PippoGot/FGVCO/Elaborato Scritto/main.tex

\documentclass[twoside, 12pt]{report}

% --- PACCHETTI ---

% unità di misura e matematica
\usepackage{siunitx, amsmath}

% titolo capitoli e sezioni personalizzato
\usepackage{titlesec}

\titleformat{\chapter}
{\normalfont\LARGE\bfseries}{\thechapter.}{10pt}{\LARGE}
\titlespacing*{\chapter}{0pt}{0pt}{20pt}

\titleformat{\section}
{\normalfont\large\bfseries}{\thesection}{10pt}{\large}
\titlespacing*{\section}{0pt}{0pt}{10pt}

% include pdfs
\usepackage{pdfpages}

% grafiche e tabelle
\usepackage{graphicx, calc}

\graphicspath{{images/}}

\usepackage{tikz, pgfplots, pgfplotstable}

\pgfplotsset{compat = newest}
\usepgfplotslibrary{units}

\usepackage{array, csvsimple}

\newcolumntype{C}{>{\centering}m{1.8cm}}
\newcolumntype{L}{>{\centering\arraybackslash}m{1.8cm}}
\newcolumntype{I}{>{\centering}m{2.5cm}}
\newcolumntype{U}{>{\centering\arraybackslash}m{2.5cm}}

\usepackage{float}

% colori personalizzati
\usepackage{colortbl, xcolor}

% normali
\definecolor{myBlue}{RGB}{1, 187, 235}
\definecolor{myRed}{RGB}{255, 43, 43}
\definecolor{myYellow}{RGB}{255, 221, 86}
\definecolor{myBlack}{RGB}{28, 28, 28}
\definecolor{myGrey}{RGB}{134, 134, 134}
% chiari
\definecolor{myLightBlue}{RGB}{177, 239, 255}
\definecolor{myLightRed}{RGB}{255, 177, 177}
\definecolor{myLightYellow}{RGB}{255, 240, 180}
\definecolor{myLightGrey}{RGB}{218, 218, 218}

\pgfplotscreateplotcyclelist{modular}{
        {myBlue},
        {myRed},
        {myBlack},
        {myGrey},
        {myYellow},
      }

\usepackage{subcaption, caption}

% numerazione capitoli in italiano
\usepackage[italian]{babel}

% spaziatura
\usepackage{parskip}

% impaginazione
\usepackage{setspace} % For doublespacing

\doublespacing

\usepackage{geometry}

\geometry{a4paper, top = 2cm, bottom = 2cm, outer = 2cm, inner = 3cm, heightrounded}

% font
\usepackage{times}

% bibliografia
\usepackage{csquotes, biblatex}
\addbibresource{bibliography.bib}

\usepackage{xurl, url} % evita che la bibliografia esca dal margine

\urlstyle{same}
\appto{\bibsetup}{\raggedright}

% salta pagine bianche
\usepackage{afterpage}

\newcommand\emptypage{
    \newpage
    \thispagestyle{empty}
    \mbox{}
    \newpage
}

% interlinea
\linespread{1.5}

% comandi per aggiungere chapter, section e subsection non numerate al toc
\newcommand\unchapter[1]{
    \chapter*{#1}
    \addcontentsline{toc}{chapter}{#1}}

\newcommand\unsection[1]{
    \section*{#1}
    \addcontentsline{toc}{section}{#1}}

\newcommand\unsubsection[1]{
        \subsection*{#1}
        \addcontentsline{toc}{subsection}{#1}}

% --- DOCUMENTO PRINCIPALE ---

% inizio del documento
\begin{document}

% --- FRONTESPIZIO ---
% DA MODIFICARE DATA DI LAUREA !!!
\includepdf{pdfs/frontespizio/frontespizio_tesi.pdf}
\emptypage

% --- INDICE ---

\tableofcontents
\emptypage

% --- CAPITOLI ---

\include{chapters/ch00-introduzione.tex}
\include{chapters/ch01-segnali_principali.tex}
\include{chapters/ch02-vfc.tex}
\include{chapters/ch03-interfaccia_ingresso.tex}
\include{chapters/ch04-selezione_modalità.tex}
\include{chapters/ch05-segnali_secondari.tex}
\include{chapters/ch06-interfaccia_uscita.tex}
%\include{chapters/ch07-protezione_circuito.tex}
\include{chapters/ch08-conclusioni.tex}

% appendice schemi elettrici
\include{chapters/appendix.tex}

% bibliografia
\printbibliography
\addcontentsline{toc}{chapter}{Bibliografia}

% fine del documento
\end{document}
