PippoGot/FGVCO/Elaborato Scritto/chapters/appendix.tex

% schemi elettrici
\appendix
\chapter{Schemi Elettrici delle Schede}\label{circuit_diagrams}

Si riportano gli schemi elettrici disegnati su CAD per il progetto delle schede stampate.

\includepdf[
    width = \textwidth,
    pagecommand = {\thispagestyle{plain}},
    pages = -,
    nup = 1x2,
    offset = 5mm 0mm
]{
    pdfs/schematics/FG-VCO-(complete).pdf
}
