PippoGot/FGVCO/Elaborato Scritto/chapters/ch07-efuse.tex

\chapter{Protezione del Circuito}

\lipsum[2-4]
