PippoGot/FGVCO/Elaborato Scritto/main.pdf

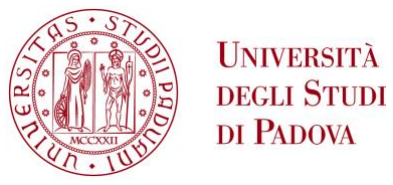
[picture p28: figure]

## UNIVERSITÀ DEGLI STUDI DI PADOVA

DIPARTIMENTO DI INGEGNERIA DELL’INFORMAZIONE CORSO DI LAUREA IN INGEGNERIA ELETTRONICA

## PROGETTO DI UN SINTETIZZATORE MUSICALE CONTROLLATO IN TENSIONE

### Relatore: Prof. Matteo Meneghini

### Laureando: Filippo Gottardo Matricola: 1220991

ANNO ACCADEMICO 2021/2022 | 21 Settembre 2022

DIPARTIMENTO
DI INGEGNERIA
DELL’INFORMAZIONE

# Indice

Introduzione e Specifiche di Progetto | 5
1 Generazione dei Segnali Principali | 8
2 Convertitore Tensione-Frequenza | 16
3 Condizionamento dell’Ingresso | 21
3.2 Somma di piu Ingressi | ` | 28
4 Modalita di Funzionamento | 32 `
5 Generazione dei Segnali Secondari | 33
6 Stadi di Uscita | 38
Considerazioni Finali e Conclusioni | 42
A Schemi Elettrici delle Schede | 43
Bibliografia | 62

# Introduzione e Specifiche di Progetto

In questa tesi viene discussa la progettazione di un sintetizzatore musicale compatibile con lo

standard modulare piu diffuso al giorno d’oggi, ovvero Eurorack [1]. Pi ` | u precisamente si vuole `

realizzare un generatore di segnali che offra la possibilita di essere controllato in tensione (Vol- `

tage Controlled Oscillator, o VCO in breve). In questo modo, applicando dei segnali variabili

nel tempo in ingresso al modulo, si e in grado di variare dinamicamente la frequenza dei segnali `

in uscita.

Il range scelto per tale variazione comprende la fascia di frequenze dello spettro audio, quindi

da poche decine di Hz a circa 7 kHz. Si desidera inoltre la possibilita di convertire a piacere il `

funzionamento del modulo in oscillatore a bassa frequenza (Low Frequency Oscillator, o LFO),

spostando quindi il range di frequenze disponibili da frazioni di Hz a qualche decina di Hz.

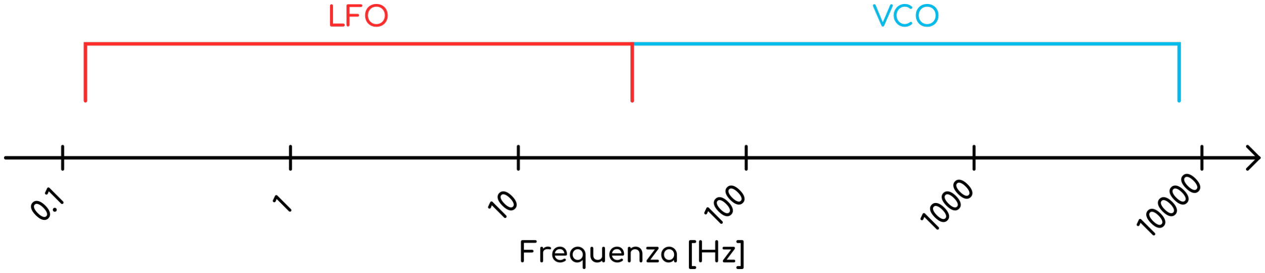
[picture p29: figure]

Figura 1: Range di funzionamento approssimato, in scala logaritmica

In modalita VCO quindi, il modulo produrr ` | a dei segnali che attraverso un adeguato sistema po- `
tranno riprodurre un suono, mentre in modalita LFO il circuito produrr ` | a dei segnali lentamente `

variabili nel tempo, utili per la modulazione e il controllo di diversi parametri in altri moduli

eventualmente presenti nel sistema.

Le forme d’onda desiderate sono quelle base, ovvero:

- Sinusoide;
- Onda Quadra;
- Triangolo;
- Rampa;

- Dente di sega (sebbene nel range VCO non risulti particolarmente differente dalla rampa

in termini di suono, per quanto riguarda il funzionamento LFO la differenza e radicale, `

poiche il segnale viene solitamente utilizzato come modulante); `

inoltre, come verra illustrato pi ` | u avanti, risulta piuttosto semplice anche estrarre un segnale a `

impulso, ancora una volta utile per il controllo di altri moduli o parametri.

Per quanto riguarda le specifiche sui livelli di tensione, si vogliono imporre i seguenti intervalli

di valori:

- Segnali audio (le 5 forme d’onda elencate poco sopra): ±5 V ;
- Segnali logici (impulso): (0 V ÷ +5 V );
- Segnali di controllo (ingresso): (0 V ÷ +8 V ) in modalita` 1 V/Octave, ovvero facendo

in modo che ad un incremento di 1 V in ingresso corrisponda un raddoppio di frequenza

in uscita, cioe un’ottava; `

- Alimentazioni: ±12 V e +5 V ;

come suggerito dallo standard scelto.

Si desidera inoltre aggiungere delle manopole per il controllo del ”volume” dei segnali in in-

gresso e uscita (ad eccezione dell’impulso), e delle manopole per il controllo manuale della

frequenza.

Mettendo assieme tutti questi dettagli possiamo dunque abbozzare una interfaccia utente (ripor-

tata in figura 2), in modo da rendere piu chiaro al lettore il risultato finale voluto. `

Si decide di realizzare l’intero circuito senza l’utilizzo di microcontrollori o sistemi program-

mabili, scelta che viene presa per mettere alla prova il maggior numero di competenze tra quelle

acquisite durante gli anni di studio. Una soluzione piu rapida e semplice consisterebbe infatti `

nell’impiegare un microcontrollore con dei campioni digitali molto densi delle forme d’onda

desiderate.

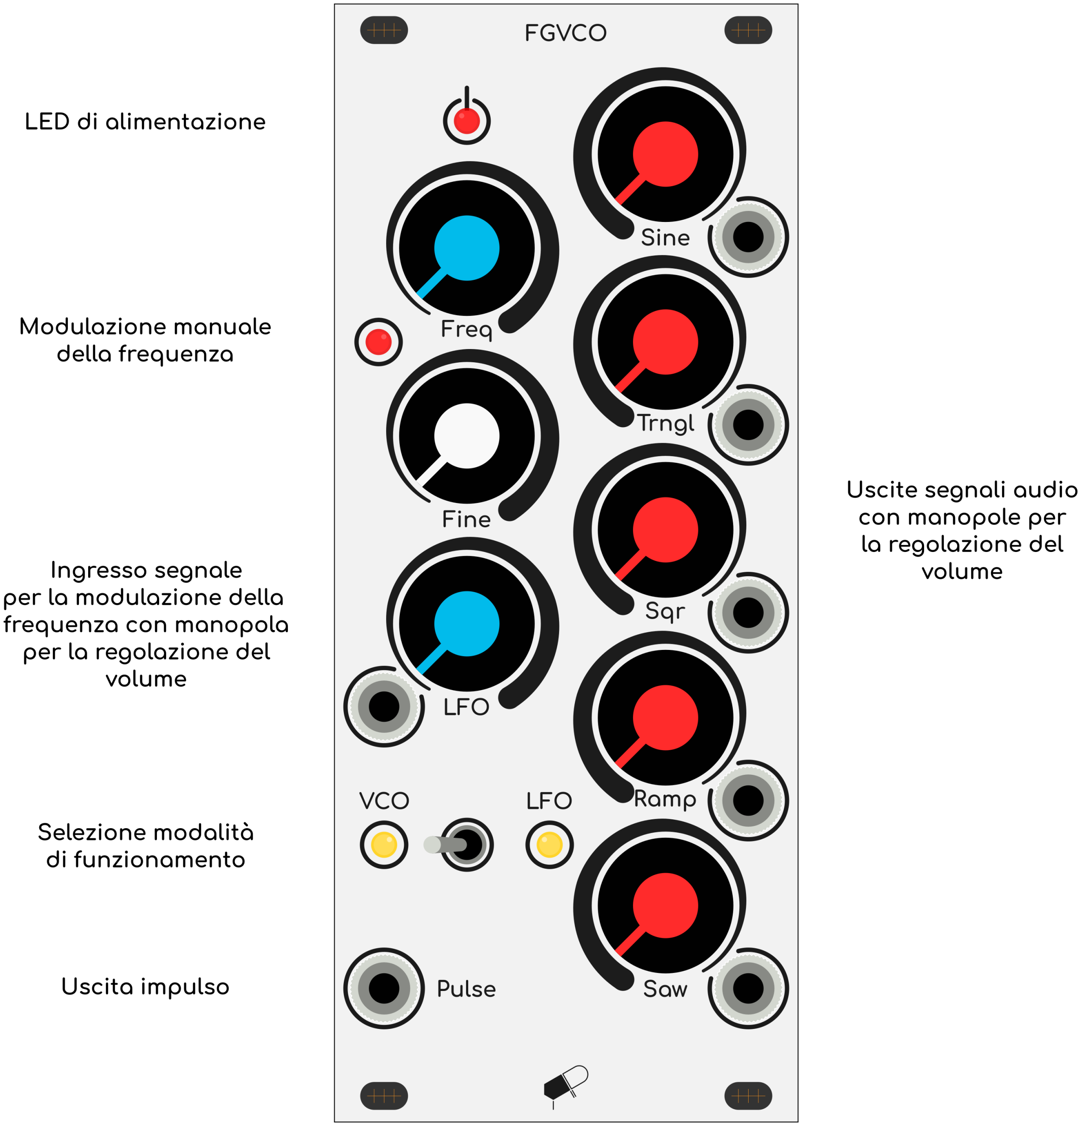
[picture p30: figure]

Figura 2: Pannello frontale del modulo

# 1. Generazione dei Segnali Principali

Per la generazione dei segnali a rampa e a triangolo si decide di procedere in ogni caso per via

digitale, utilizzando dei contatori binari abbinati ad un convertitore digitale-analogico.

### 1.1 Rampa

### Principio di Funzionamento

Per il segnale a rampa si fa uso di un contatore unidirezionale, ovvero un dispositivo in grado di

contare automaticamente da 0 a 2

n
(con n numero di bit) semplicemente fornendo un segnale

di clock adeguatamente dimensionato. Maggiore il numero di bit, maggiore la precisione del

nostro segnale, quindi minore l’intensita del rumore generato. `

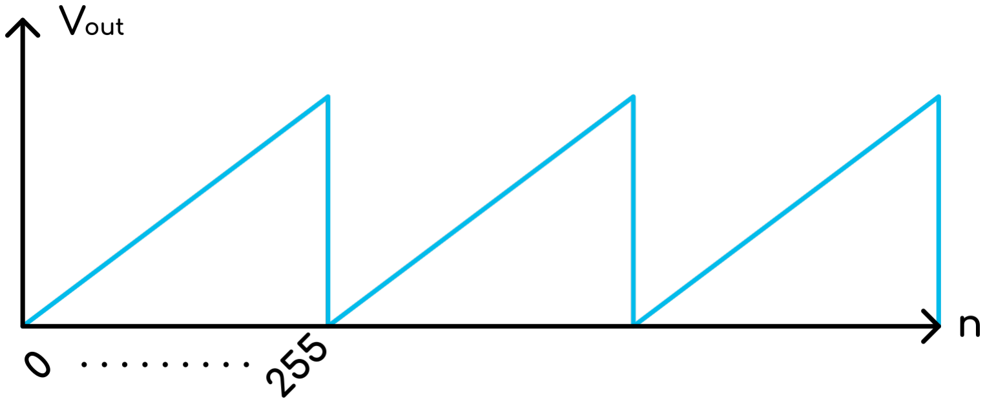
[picture p31: figure]

(a) Rampa ottenuta con un contatore a 2 bit | (b) Rampa ottenuta con un contatore a 8 bit

Figura 1.1: Confronto tra contatori unidirezionali con diverso numero di bit

Tuttavia aumentando il numero di bit del contatore e facile intuire che, a parit ` | a di frequenza `

del segnale in uscita, la frequenza del segnale di clock debba necessariamente aumentare, vale

infatti la seguente relazione:

fsignal =

fclk
2

n

[Hz] | (1.1)

poiche il contatore deve effettuare un conteggio completo durante un periodo del segnale in `

uscita. Questo implica dunque un limite massimo al numero di bit del contatore.

Il numero di bit utilizzati per la nostra applicazione e pari a ` | 8, valore che ci consente di limitare

al MHz la frequenza di clock, contare fino a 255 e dividere l’intervallo di tensione d’uscita in

altrettanti livelli, ottenendo quindi una variazione di

Vstep =

2 · Vref
2

n

=

10
256
≈ 39 mV | (1.2)

per ogni singolo bit (scegliendo Vref = +5 V ).

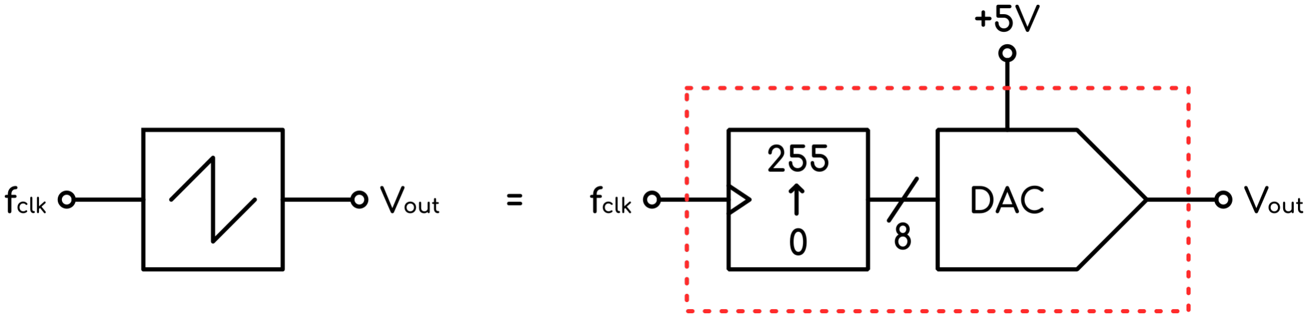
[picture p32: figure]

Figura 1.2: Schema a blocchi del sottosistema per la generazione della rampa

A questo punto possiamo calcolare le specifiche del segnale di clock da generare, andando a

vedere quali sono le frequenze desiderate per i segnali audio:

- Valore minimo (nota A0): fsignal−min = 27.5 Hz → fclk−min ≈ 7 kHz a cui corrispon-
dera un ingresso di ` | 0 V ;
- Valore massimo (nota A8): fsignal−max ≈ 7 kHz → fclk−max ≈ 1.8 MHz a cui
corrispondera un ingresso di ` | +8 V ;

quindi un range di funzionamento esteso lungo 8 ottave.

### Componenti Utilizzati e Schemi Elettrici

I componenti utilizzati per la realizzazione del circuito sono un 74HC590 [2], contatore binario

a 8 bit, e un DAC0800 [3], convertitore digitale-analogico sempre a 8 bit.

Per il circuito DAC si utilizza lo schema a pg.10 del relativo datasheet del componente. Tale

configurazione ci permette di convertire il dato binario in un valore compreso nell’intervallo

±Vref , tuttavia si utilizzano un amplificatore operazionale e dei resistori di valore differente

(rispettivamente TL074 [6] e RL = R¯
L = 3.3 kΩ) per questioni di disponibilita. Si noti che `

anche Vref viene scelta diversa rispetto allo schema nel datasheet (ovvero +5 V ), in modo da

garantire le specifiche di progetto sul segnale in uscita.

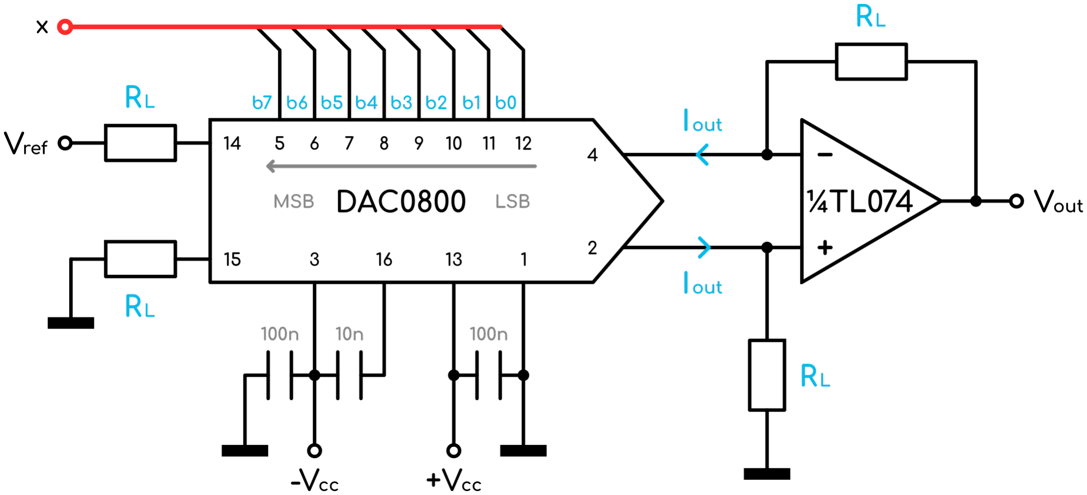
[picture p33: figure]

Figura 1.3: Schema elettrico del DAC (±Vcc = ±12 V )

Il DAC eroga una corrente Iout proporzionale all’ingresso digitale x, che viene poi convertita in

una tensione con un operazionale. Le due grandezze sono legate dalla relazione:

Vout = Vref
2x − 255

256

= 5
2x − 255
256 |
[V ] | (1.3)

Il contatore invece viene collegato nel seguente modo:

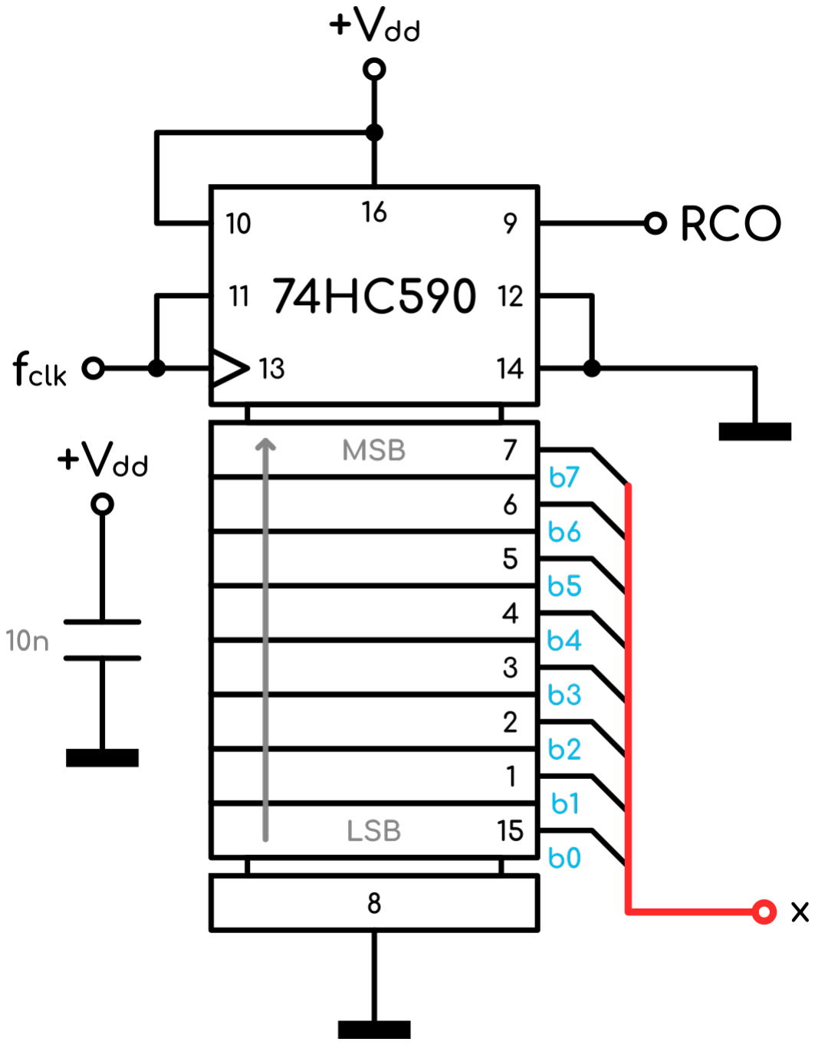
[picture p34: figure]

Figura 1.4: Schema elettrico del contatore per l’onda a rampa (+Vdd = +5 V )

Si noti l’uscita RCO in figura 1.4 dalla quale viene prelevato il segnale per la generazione

dell’impulso, che verra discusso pi ` | u in dettaglio nel capitolo 5. `

Infine, collegando i due blocchi insieme, l’andamento di Vout sara simile a quello rappresentato `

in figura 1.1b, e ad ogni impulso di clock corrispondera un gradino di tensione di circa ` | 40 mV

come calcolato con la formula 1.2.

### Risultati Pratici

Verifichiamo quindi la correttezza del circuito realizzato.

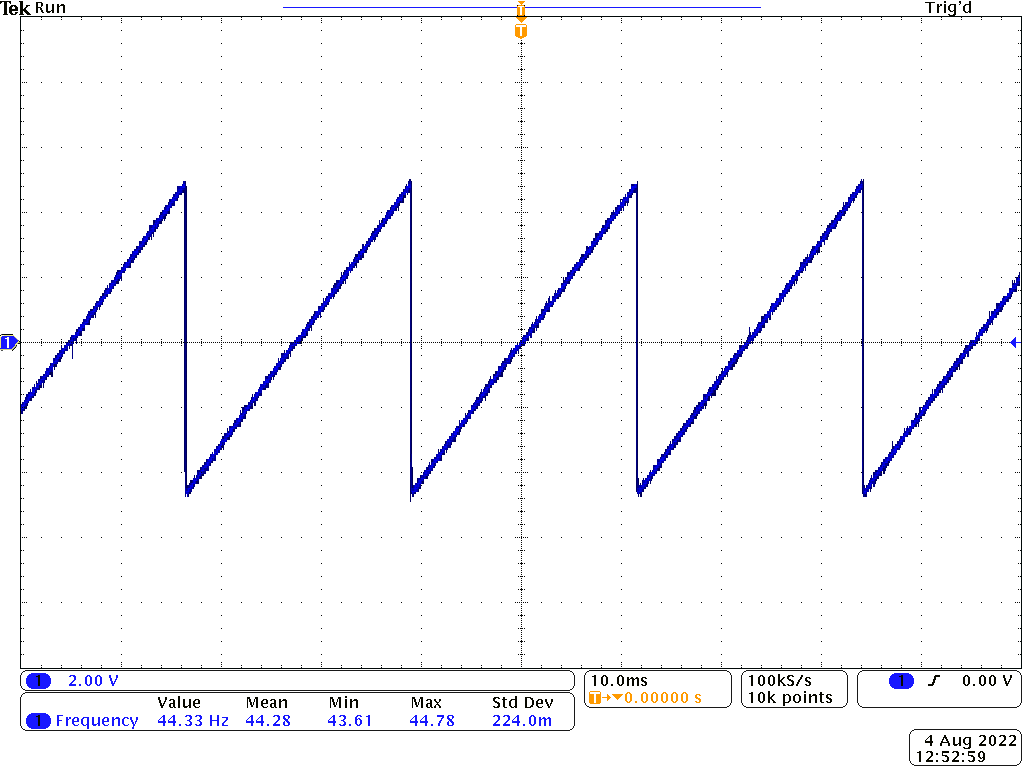
[picture p35: figure]
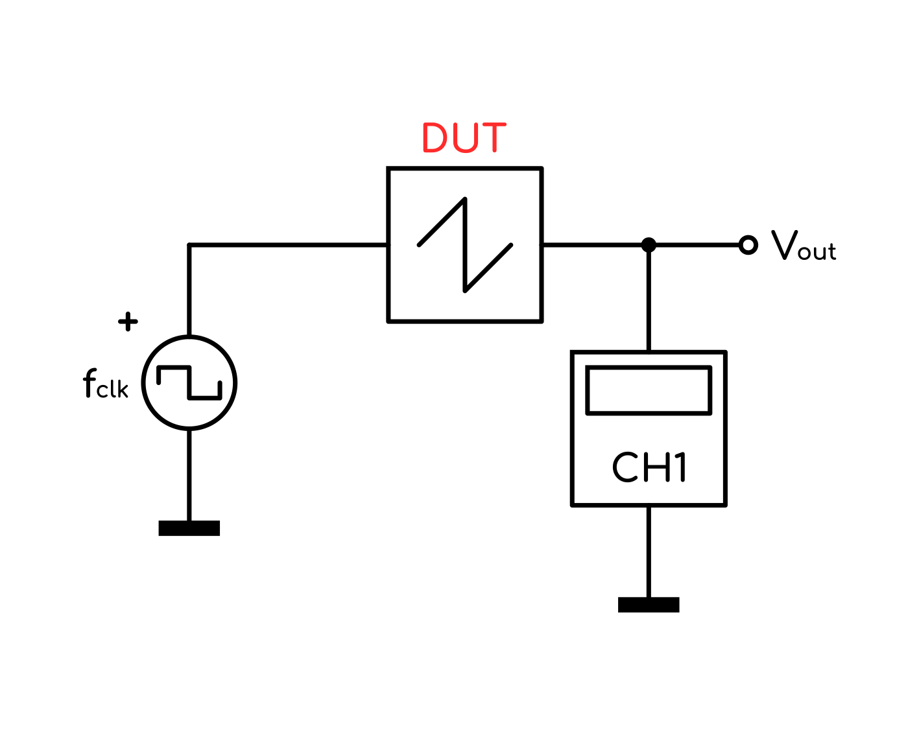
[picture p36: figure]

(a) Setup di misura | (b) Acquisizione del segnale ottenuto

Figura 1.5: Funzionamento del circuito per il segnale a rampa

Si apprezza come l’onda generata abbia esattamente la forma voluta, come descritto nel princi-

pio di funzionamento.

### 1.2 Triangolo

### Principio di Funzionamento

Il ragionamento e del tutto analogo a quello del contatore per la rampa, tuttavia in questo caso il `

contatore utilizzato e bidirezionale (quindi in grado di contare da ` | 0 a 2

n
e viceversa) e necessita

di un segnale che determini la direzione di conteggio (Up o Down).

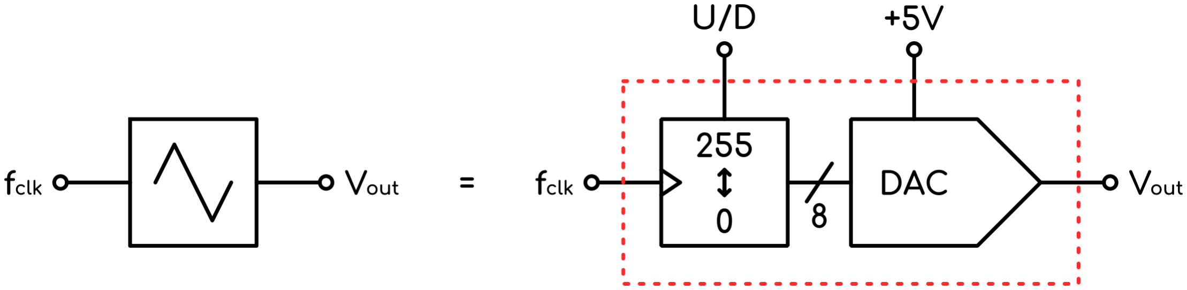
[picture p37: figure]

Figura 1.6: Schema a blocchi del sottosistema per la generazione del triangolo

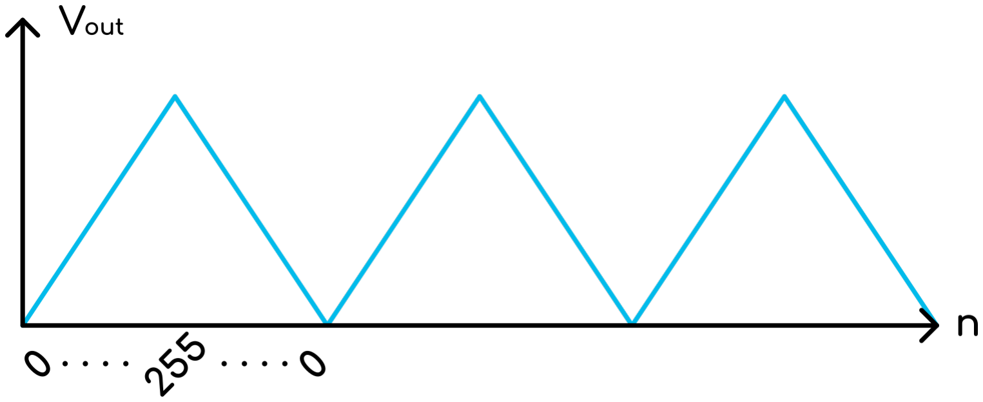
[picture p38: figure]
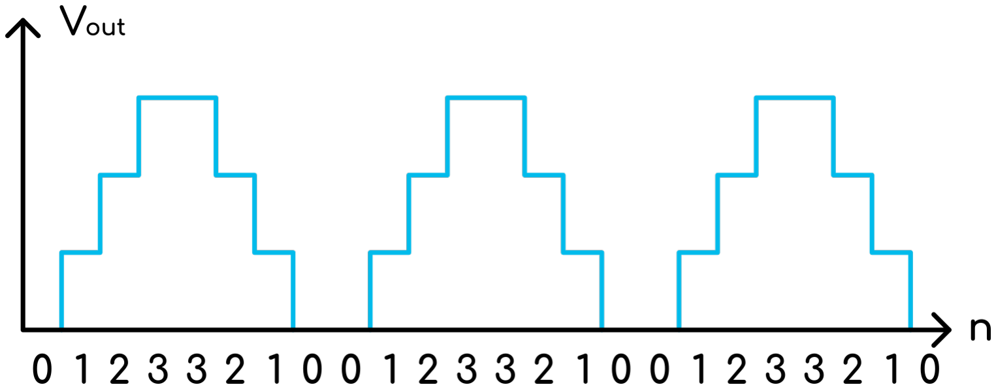
[picture p39: figure]

(a) Triangolo ottenuto con un contatore a 2 bit (b) Triangolo ottenuto con un contatore a 8 bit

Figura 1.7: Confronto tra contatori bidirezionali con diverso numero di bit

La configurazione del DAC rimane quella utilizzata per la rampa e rappresentata in figura 1.3.

In questo caso tuttavia il numero di cicli di clock utilizzati e doppio rispetto a quello per la `

rampa, poiche dovranno essere eseguiti 256 conteggi verso l’alto e 256 conteggi verso il basso `

per ottenere un singolo periodo di onda triangolare. Ne consegue quindi che anche la frequenza

di clock in ingresso a questo sottosistema dovra essere doppia rispetto alla rampa, come risulta `

evidente in figura 1.8.

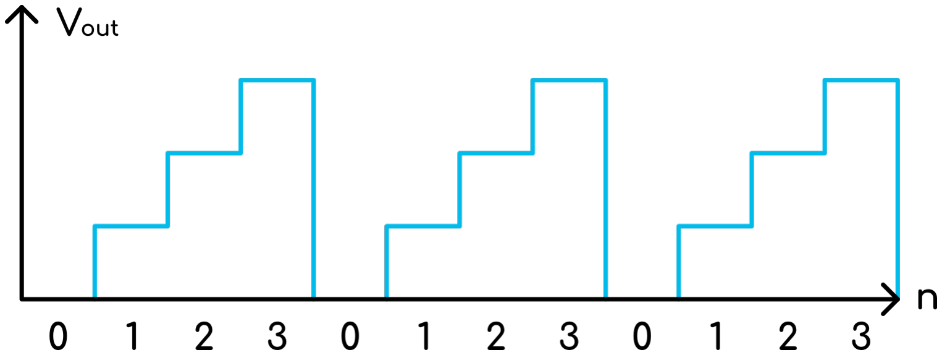
[picture p40: figure]

(a) Rampa ottenuta con un contatore a 2 bit | (b) Triangolo ottenuto con un contatore a 2 bit

Figura 1.8: Confronto del conteggio tra contatori unidirezionali (a) e bidirezionali (b)

### Componenti Utilizzati e Schemi Elettrici

L’unico componente diverso rispetto al circuito per la rampa e il contatore, che come gi ` | a detto `

deve essere bidirezionale. Si utilizzano due 74LS169 [9] in cascata nella seguente configura-

zione:

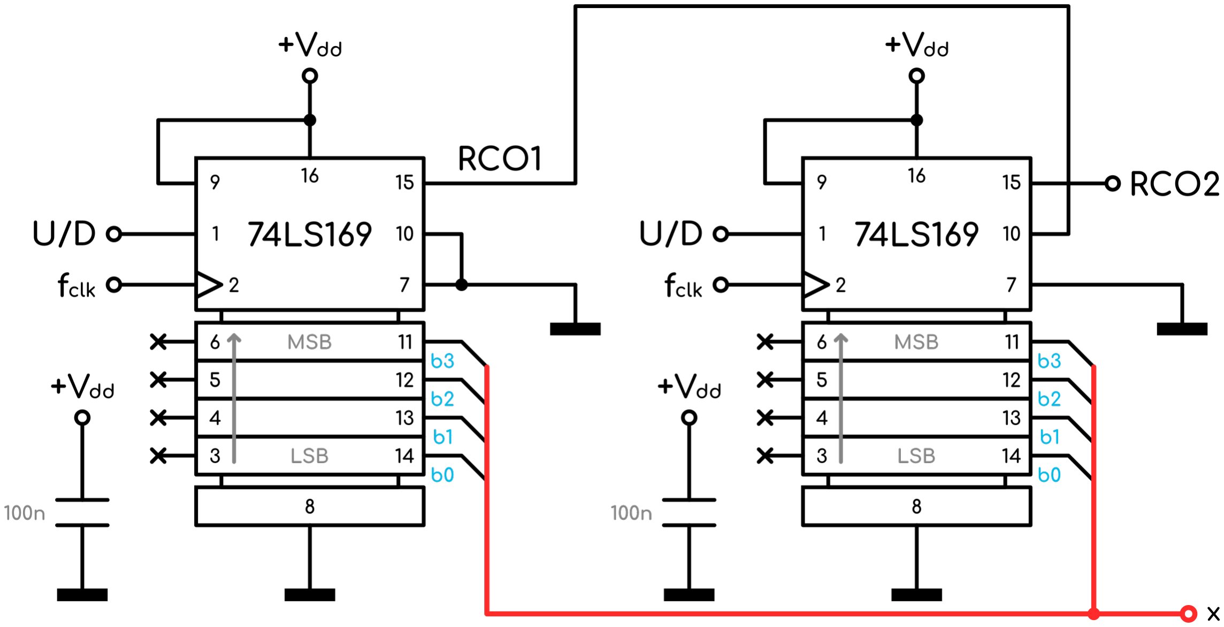
[picture p41: figure]

Figura 1.9: Schema elettrico dei contatori per l’onda triangolare (+Vdd = +5 V )

Il componente utilizzato presenta anche degli ingressi per il preset del numero di partenza (pin

da 3 a 6), che pero nel nostro caso non vengono utilizzati. `

L’uscita denominata RCO2 verra utilizzata per pilotare il verso del conteggio, essa infatti com- `

muta durante il ciclo di clock corrispondente al conteggio precedente all’overflow, ovvero 255

in modalita ”Up” e ` | 0 in modalita ”Down”. `

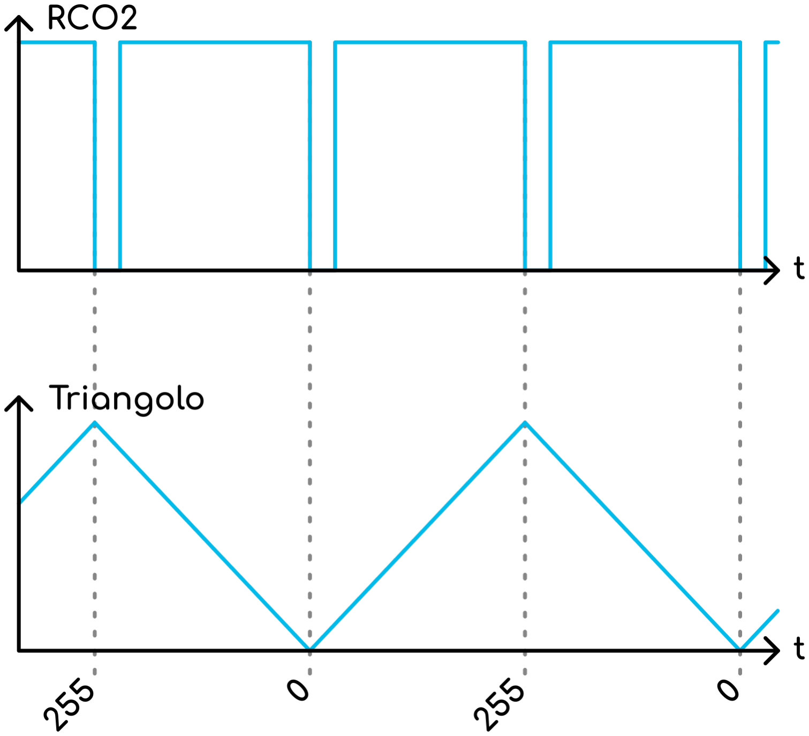
[picture p42: figure]

Figura 1.10: Andamento teorico del segnale RCO2 in funzione del conteggio

### Risultati Pratici

Si verifica ora la correttezza del circuito realizzato.

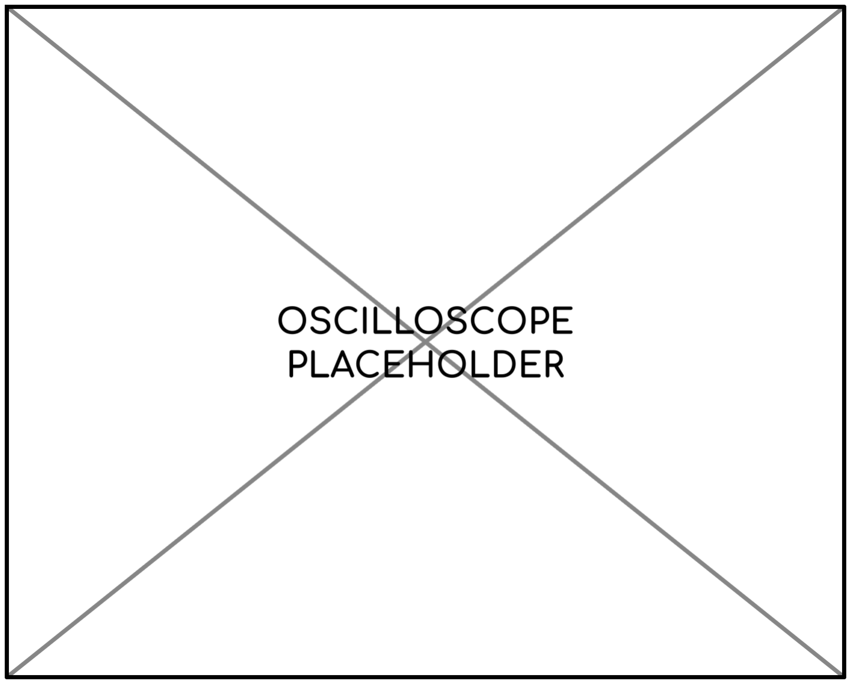
[picture p43: figure]
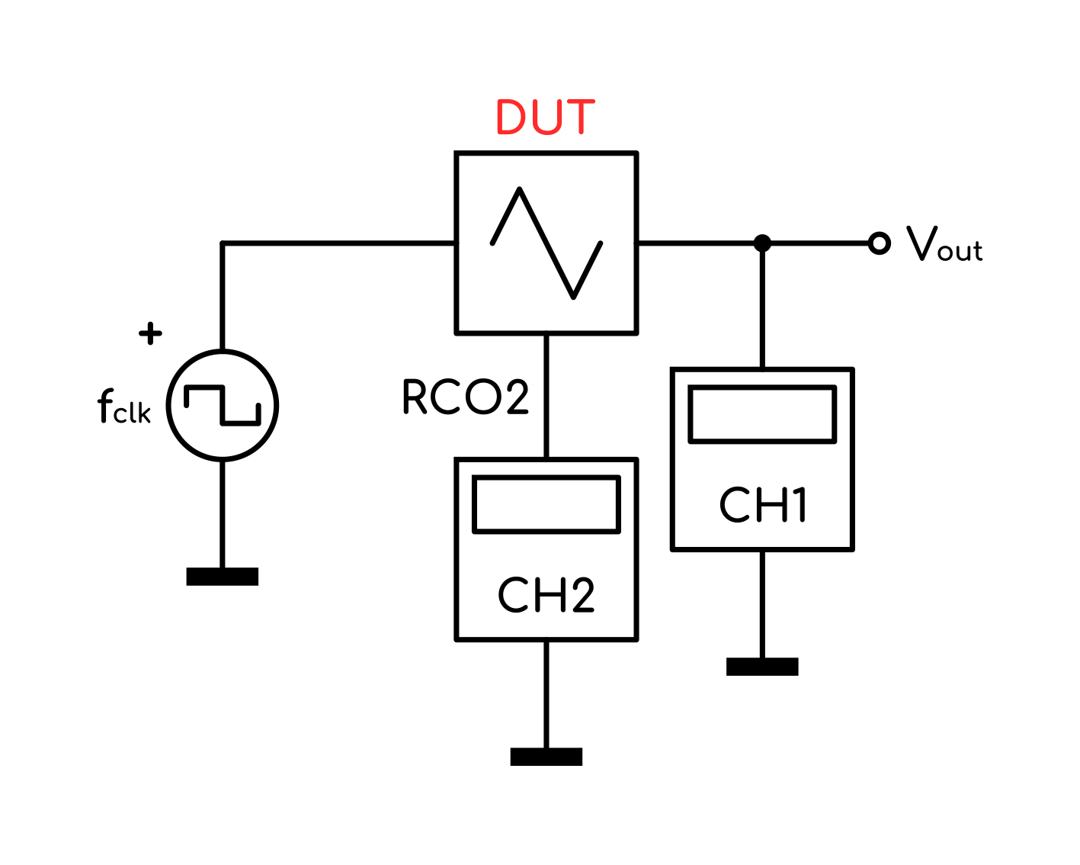
[picture p44: figure]

(a) Setup di misura | (b) Acquisizione dei segnali ottenuti

Figura 1.11: Funzionamento del circuito per il segnale a triangolo

Ancora una volta si apprezza che quanto discusso finora corrisponde al reale comportamento

del circuito.

### 1.3 Adattamento dei Segnali di Clock e Pilotaggio

Si e visto come, per avere la stessa frequenza di segnale d’uscita, il contatore del triangolo deve `

avere una frequenza di clock doppia rispetto a quella del contatore della rampa. Questo proble-

ma si risolve facilmente inserendo prima del contatore unidirezionale un divisore di frequenza,

ottenuto con un semplice toggle flip-flop (TFF).

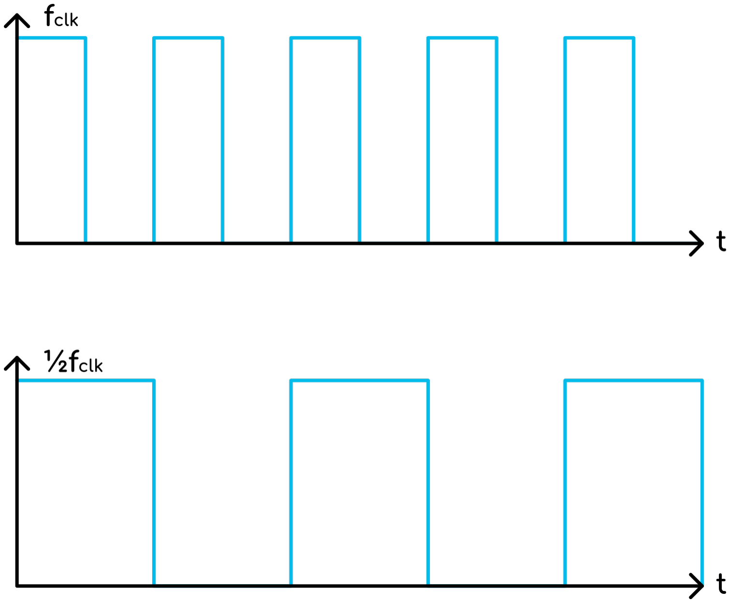
[picture p45: figure]
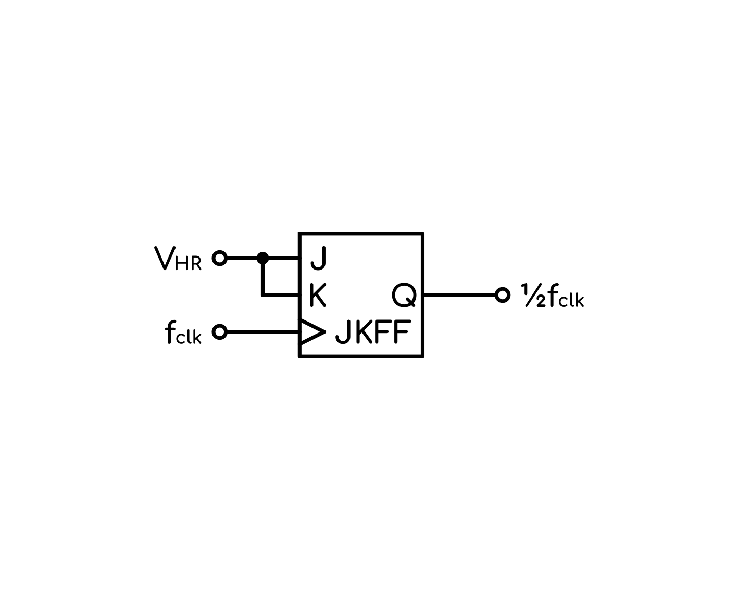
[picture p46: figure]

(a) Schema a blocchi | (b) Andamento dei segnali previsto

Figura 1.12: Divisore di frequenza

Le specifiche sul segnale di clock ci impongono allora di generare un segnale a onda rettangolare

con frequenza variabile nel range (14 kHz ÷ 3.6 MHz), in modo che ½fclk abbia i valori di

frequenza inizialmente calcolati.

Invece, per fare in modo che il contatore del triangolo cambi effettivamente verso di conteggio

e necessario impiegare un altro TFF utilizzando come ingresso ` | RCO2 (poiche attivo a livello `

logico basso) e connesso all’ingresso U/D del contatore.

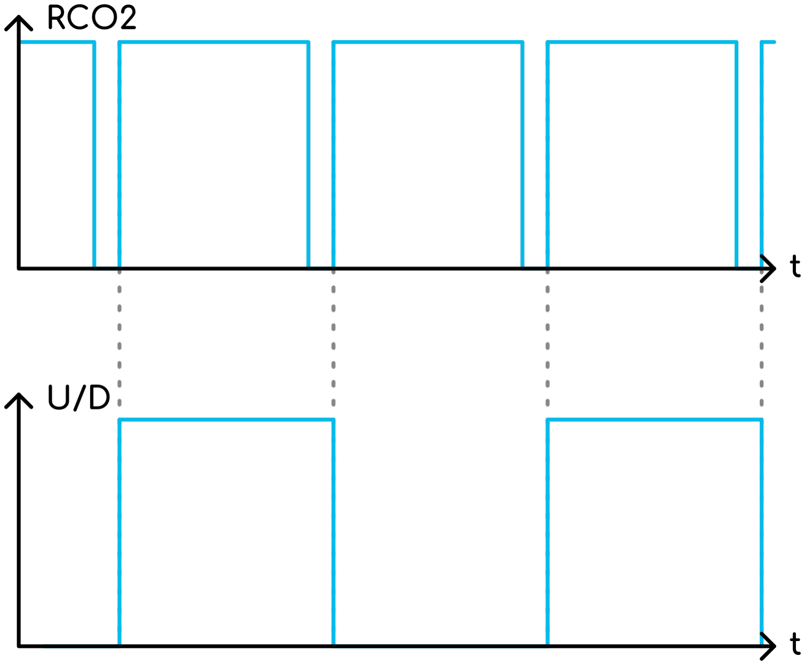
[picture p47: figure]
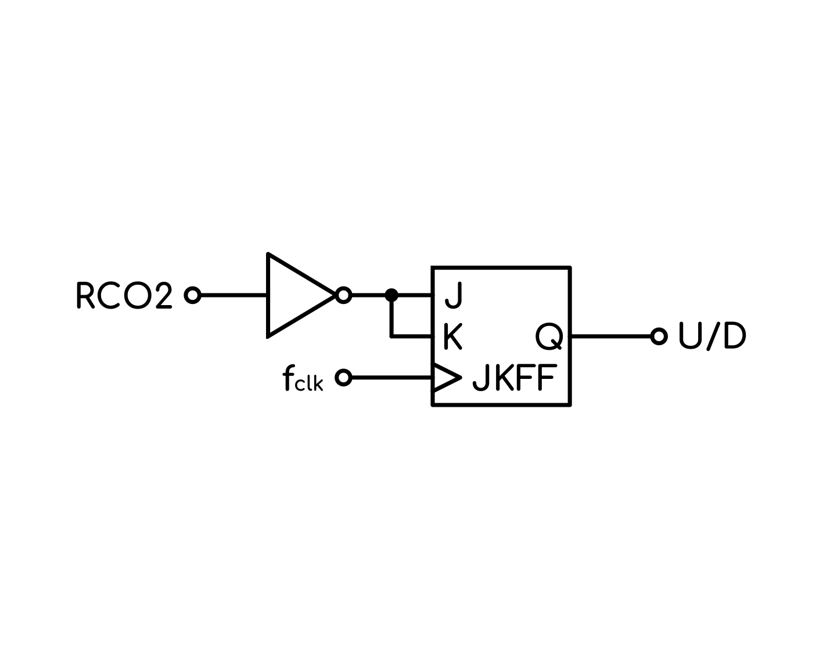
[picture p48: figure]

(a) Schema a blocchi | (b) Andamento dei segnali previsto

Figura 1.13: Pilotaggio del contatore

I componenti utilizzati scopo sono un 74HC73 [5], che fornisce i due flip-flop necessari, e un

2N7000 [13], mosfet a canale N con tensioni di soglia compatibili ai livelli di tensione presenti

nel circuito (+5 V ).

Lo schema elettrico per l’inverter e rappresentato in figura 1.14. `

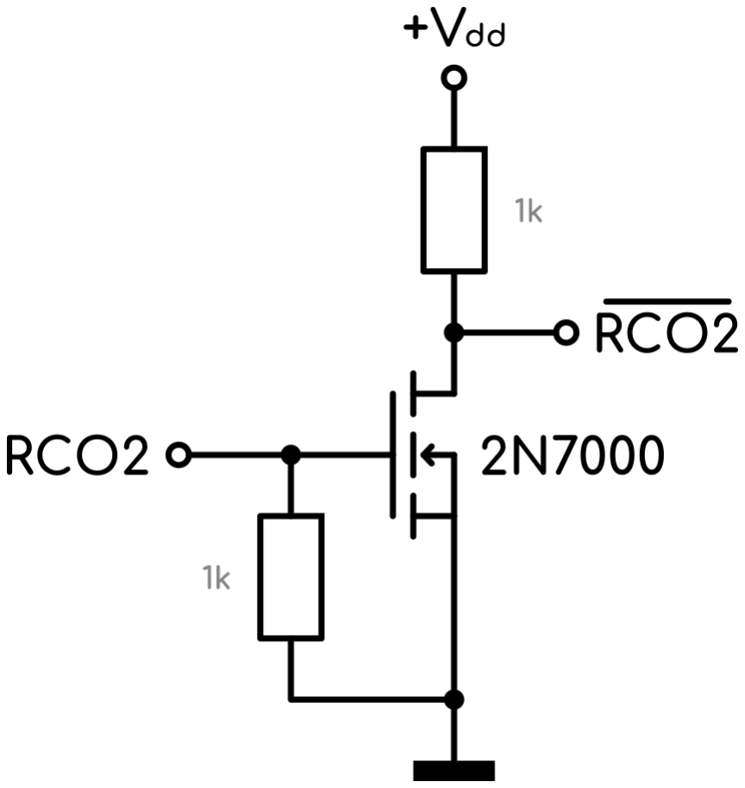
[picture p49: figure]

Figura 1.14: Schema elettrico dell’inverter logico (+Vdd = +5 V )

### Risultati Pratici

Si verifica la correttezza dei circuiti:

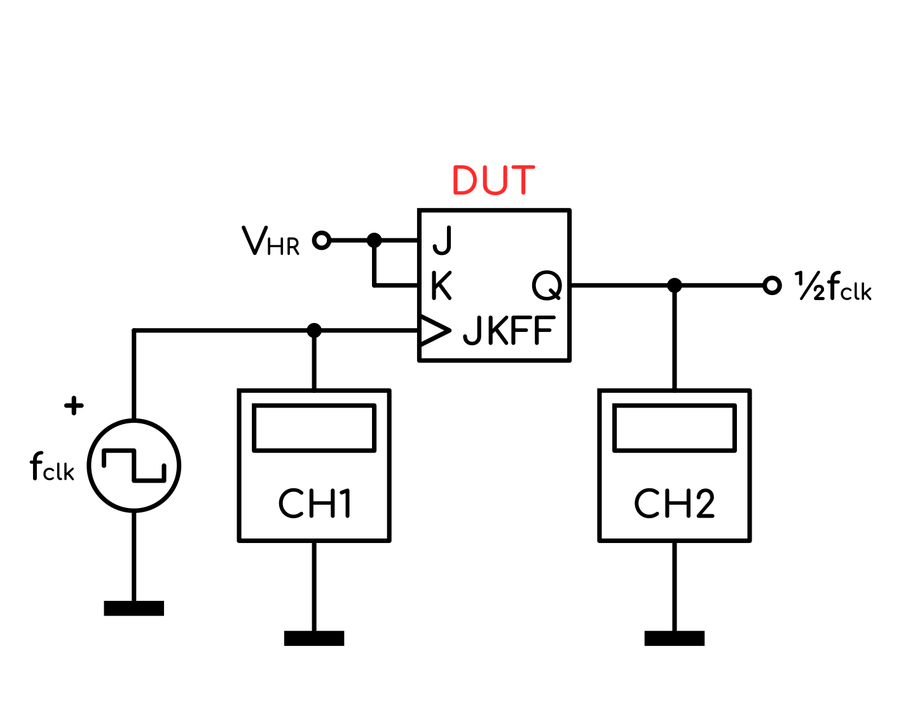
[picture p50: figure]

(a) Setup di misura | (b) Acquisizione dei segnali fclk e ½fclk

Figura 1.15: Funzionamento del circuito divisore di frequenza

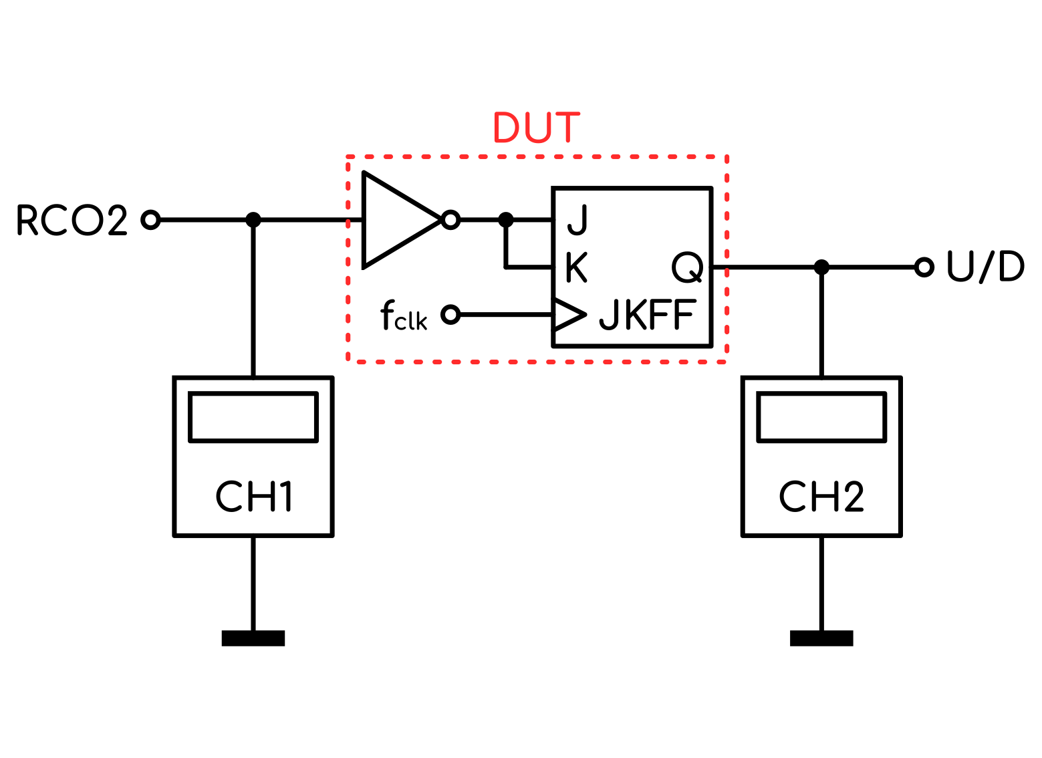
[picture p51: figure]

(a) Setup di misura | (b) Acquisizione dei segnali RCO2 e U/D

Figura 1.16: Funzionamento del circuito di pilotaggio del contatore up-down

I comportamenti coincidono con quanto descritto nelle figure 1.12b e 1.13b.

# 2. Convertitore Tensione-Frequenza

Si vuole ora progettare il circuito per la generazione del segnale fclk, con le specifiche ottenute

dai capitoli precedenti, ovvero:

- Frequenza minima: ≈ 14 kHz;
- Frequenza massima: ≈ 3.6 MHz;
- Livello logico basso: 0 V ;
- Livello logico alto: +5 V ;

### Principio di Funzionamento

Cio di cui abbiamo bisogno ` | e un circuito in grado di convertire una tensione in un segnale `

a onda rettangolare con frequenza proporzionale alla tensione stessa, ovvero un convertitore

tensione-frequenza.

In commercio e possibile trovare diversi chip in grado di svolgere questa funzione semplicemen- `

te aggiungendo una manciata di componenti di contorno, anche se la maggior parte di questi

non arriva a coprire l’intero range di funzionamento di cui abbiamo bisogno (come ad esempio

il noto LM331 [7]). Nel nostro caso si utilizza un VFC110 [4], circuito integrato specializ-

zato che vanta un’ottima linearita e la capacit ` | a di fornire una frequenza massima di ` | 4 MHz

in uscita con una corrispondente tensione in ingresso di +10 V , esattamente cio che la nostra `

applicazione richiede.

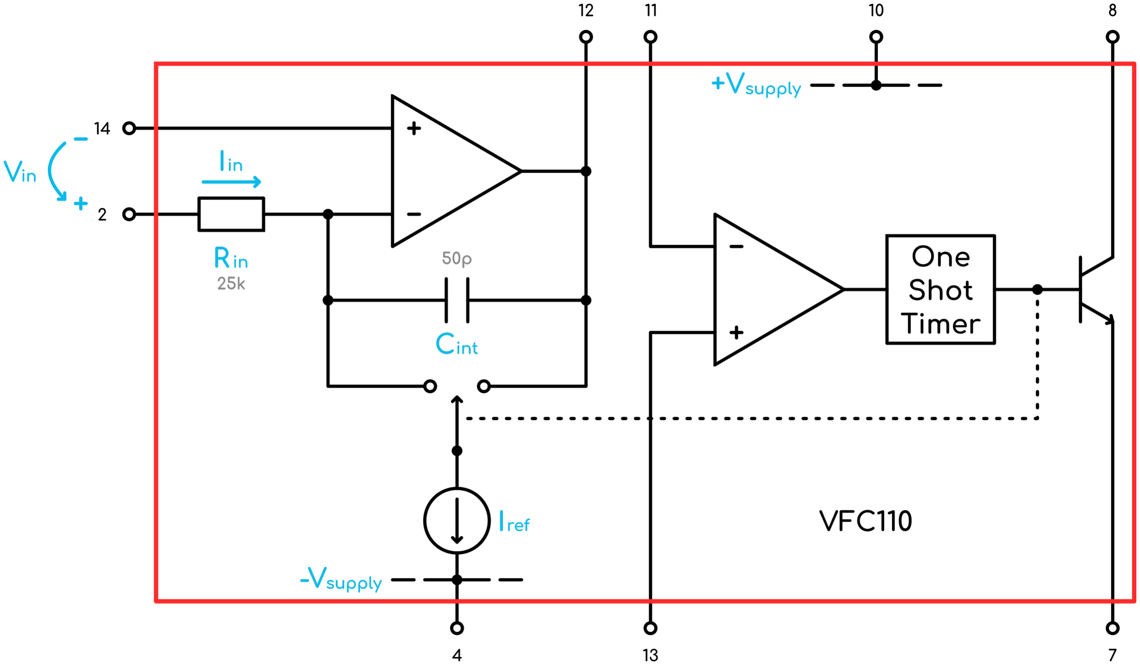
[picture p52: figure]

Figura 2.1: Estratto utile della struttura interna di un VFC110

Il cuore del circuito (figura 2.1) consiste in un operazionale configurato come integratore, con

tensione di uscita proporzionale alla carica immagazzinata nella sua capacita di feedback ` | Cint.

Una tensione in ingresso Vin sviluppa una corrente Iin =

Vin
Rin

che viene forzata in Cint, causando

quindi una rampa decrescente in uscita. Arrivati a 0 V il comparatore scatta, attivando il timer

one-shot. Quindi un generatore di corrente Iref (dal valore di circa 1 mA) viene connesso

all’ingresso dell’integratore per un periodo di durata pari a TOS, causando una rampa crescente

in uscita. Infine il ciclo ricomincia.

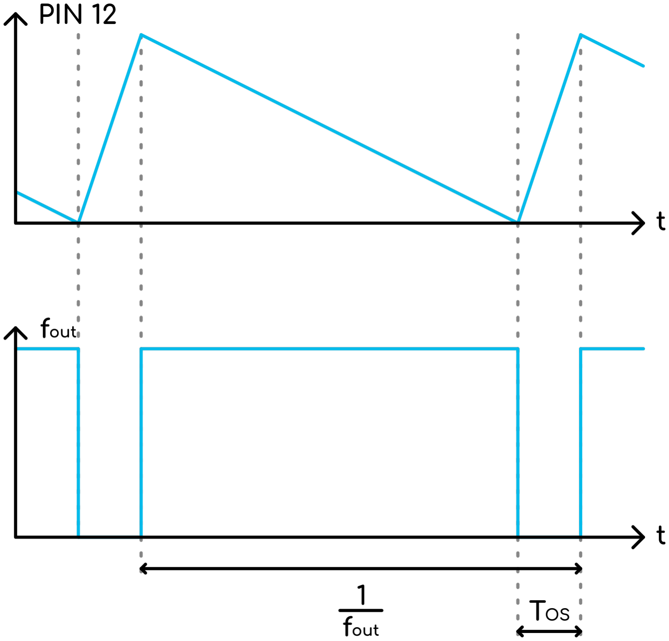
[picture p53: figure]

Figura 2.2: Forme d’onda teoriche del VFC110

Per uno studio piu approfondito sul funzionamento del VFC110 si consiglia la lettura del `

datasheet del componente, dal quale si ricava anche la configurazione del circuito utilizzato

per sfruttare l’intero range offerto (figura 2.3). Si modificano solo i valori di alimentazione,

sostituendoli con quelli dello standard scelto.

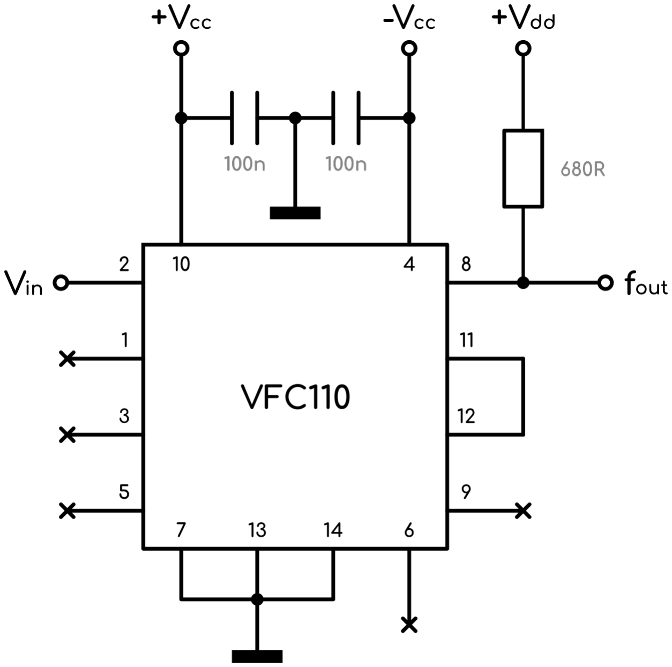
[picture p54: figure]

Figura 2.3: Schema elettrico del circuito utilizzato (±Vcc = ±12 V , +V = +5 V )

Si noti che gli unici componenti aggiunti sono condensatori di filtro e un resistore di pull-up per

l’uscita a collettore aperto.

Si riportano le relazioni tra le grandezze in gioco:

Iin = Iref · δ [A] | → | δ =

Iin

Iref

=

Vin

Rin · Iref

(2.1)

Vin

Rin

= Iref · fout · TOS [A] | → | fout =

Vin

Rin · Iref · TOS

=

δ

TOS

[Hz] | (2.2)

### Risultati Pratici e Misure

Si procede allora alla verifica del corretto funzionamento del circuito. Il setup di misura utiliz-

zato viene riportato in figura 2.4.

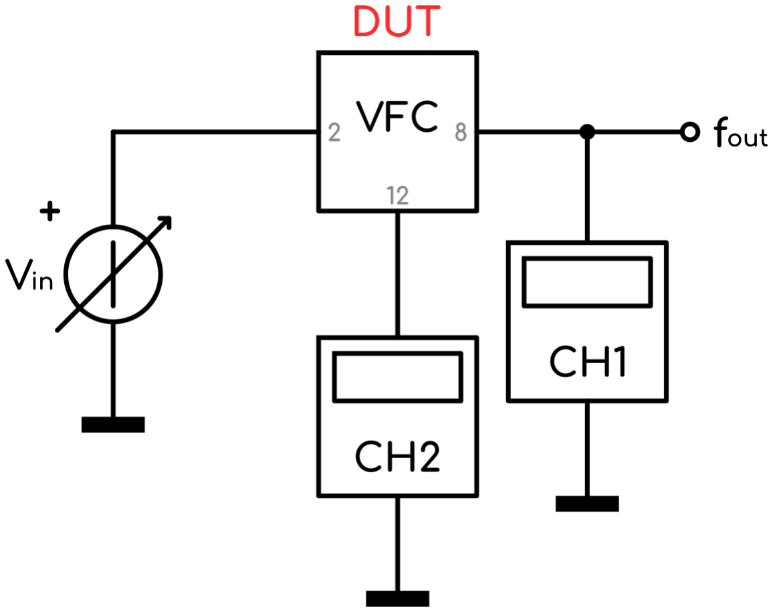
[picture p55: figure]

Figura 2.4: Setup di misura del VFC

Possiamo anzitutto verificare che il comportamento dell’integratore corrisponde a quello de-

scritto nel paragrafo precedente, e si nota che la durata del periodo basso di fout si estende

lungo il tratto di rampa crescente come in figura 2.2, ovvero durante il periodo in cui il timer

risulta attivo.

Possiamo anche notare che la durata di TOS non varia in funzione di Vin o fout, ma rimane

pressoche costante a circa ´ | 100 ns.

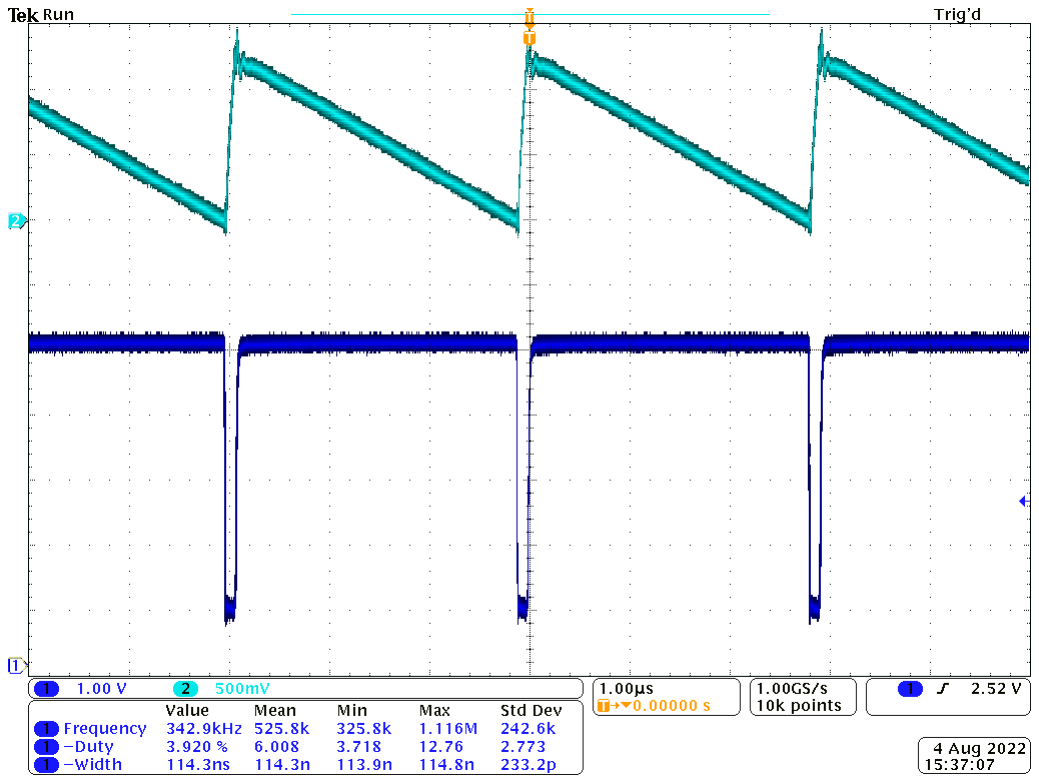
[picture p56: figure]
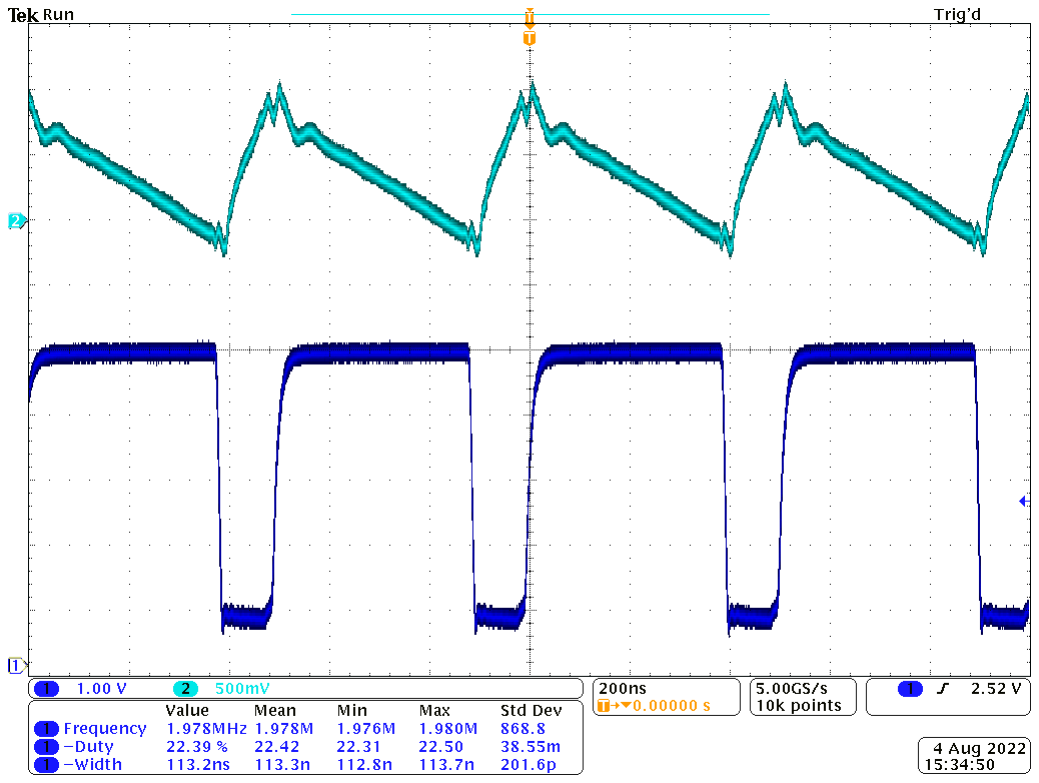
[picture p57: figure]

(a) Vin = 1 V | (b) Vin = 5 V

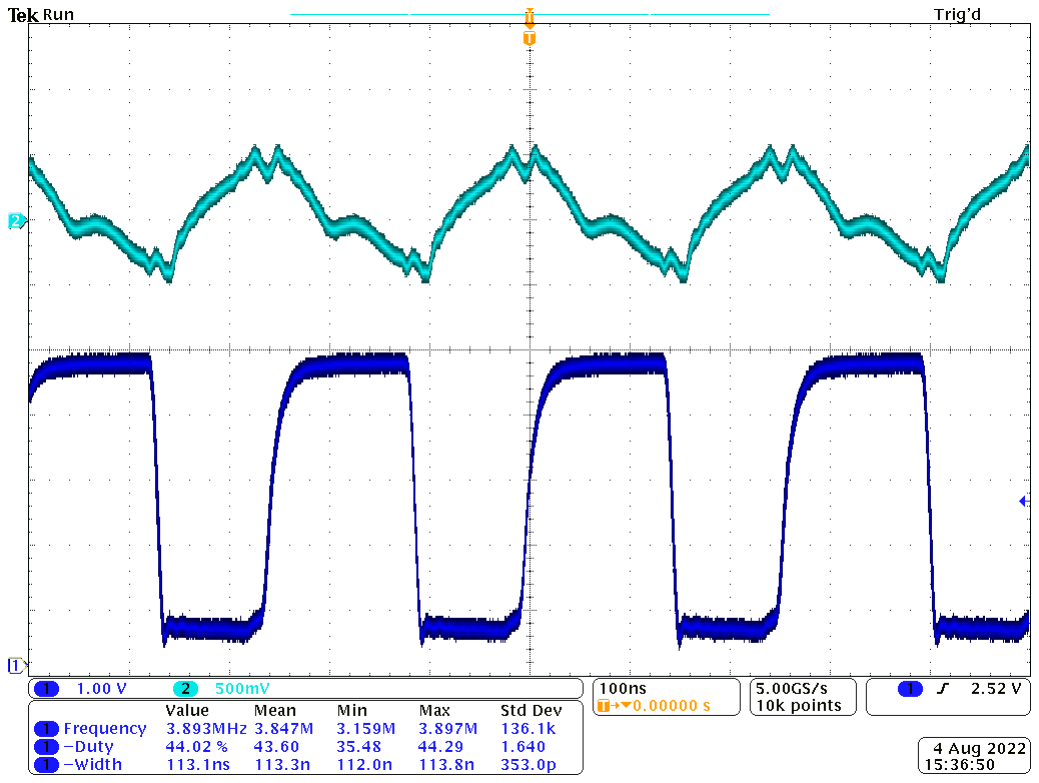
[picture p58: figure]

(c) Vin = 10 V

Figura 2.5: Acquisizioni dei segnali di interesse per diversi valori di Vin

Vengono ora riportati nella tabella 2.1 e a grafico (figura 2.6) i dati raccolti dallo studio del

circuito:

Vin [V ] | δ [%] | fout [kHz]
0 | 0 | 0
1 | 3.90 | 342
2 | 9.20 | 805
3 | 13.60 | 1192
4 | 17.99 | 1580
5 | 22.40 | 1978
6 | 26.83 | 2377
7 | 31.38 | 2776
8 | 35.55 | 3165
9 | 40.12 | 3568
10 | 44.23 | 3883

Tabella 2.1: Valori misurati del blocco VFC

0 | 2 | 4 | 6 | 8 | 10 | 12

0

10

20

30

40

50

Vin [V]

δ [%]

Duty Cycle

Formula 2.1
Valori misurati
0 | 2 | 4 | 6 | 8 | 10 | 12

0

1,000

2,000

3,000

4,000

5,000

Vin [V]

fout [kHz]

Frequenza

Formula 2.2
Valori misurati

Figura 2.6: Grafici delle grandezze riportate in tabella 2.1

Si nota che l’andamento del duty cycle si distacca leggermente dalla teoria, pur avendo comun-

que un comportamento lineare. Questo e dovuto probabilmente a causa di diverse non-idealit ` | a`

del componente, tuttavia il parametro di maggiore interesse in questo caso e` fout, che invece

risulta quasi uguale ai valori calcolati, come evidente in figura 2.6b.

# 3. Condizionamento dell’Ingresso

### 3.1 Convertitore Lineare-Esponenziale

Vogliamo ora analizzare il circuto che soddisfa la specifica sulla modalita` 1 V/Octave dell’in-

gresso, ovvero il circuito in grado di convertire una tensione lineare in una esponenziale.

La soluzione utilizzata e molto diffusa in questo tipo di applicazioni, si pu ` | o infatti trovare in `

molti siti di DIY come ad esempio quello di Rene Schmitz [11], personaggio molto noto tra gli ´

appassionati di sintetizzatori musicali fai-da-te.

### Analisi del Circuito

Per l’applicazione si sfrutta la caratteristica esponenziale intrinseca del transistor bipolare,

ovvero:

Ie ≈ Ic = Ise

Vbe
VT

−1

≈ Ise
Vbe
VT
[A] | (3.1)

Figura 3.1: BJT

dove VT (potenziale termico) e Is (corrente di saturazione) sono variabili in funzione della

temperatura. Nella nostra analisi VT verra considerato di valore costante pari a ` | 26 mV , mentre

si rimuove dall’equazione Is collegando una coppia di transistor (idealmente nello stesso chip,

in modo che siano il piu possibile simili tra loro e termicamente accoppiati) in configurazione `

differenziale:

Figura 3.2: BJT a coppia differenziale in questo modo possiamo scrivere la seguente relazione:

Ic2

Ic1

=

Ise

Vbe2
VT

Ise

Vbe1
VT
| → | Ic2 = Ic1e
Vbe2−Vbe1
VT
= Ic1e
Vb2−Vb1
VT
[A] | (3.2)

dove risulta evidente che la dipendenza da Is viene completamente rimossa.

A questo punto, rinominiamo le grandezze come segue:

Ic2 = Ifreq

Ic2 = Iref

→ | Ifreq = Iref e
Vb2−Vb1
VT
[A] | (3.3)

e aggiungiamo al circuito

- un amplificatore invertente per portare Vin in un range appropriato alla base di Q1 (ope-

razionale di sinistra, figura 3.3)

Vb1 = −Vin · s = −Vin ·

Rf

Rin

·

%Rpot + R
Rpot + R
[V ] | (3.4)
- un anello di controllo per mantenere la corrente di riferimento Iref costante (operazionale

centrale, figura 3.3)

Iref =

VHR − VLR

Rref

[A] | (3.5)
- un convertitore corrente-tensione al collettore di Q2 (operazionale di destra, figura 3.3)
Vexp = Ifreq · Rconv [V ] | (3.6)

ottenendo quindi il seguente circuito con la relativa relazione ingresso/uscita:

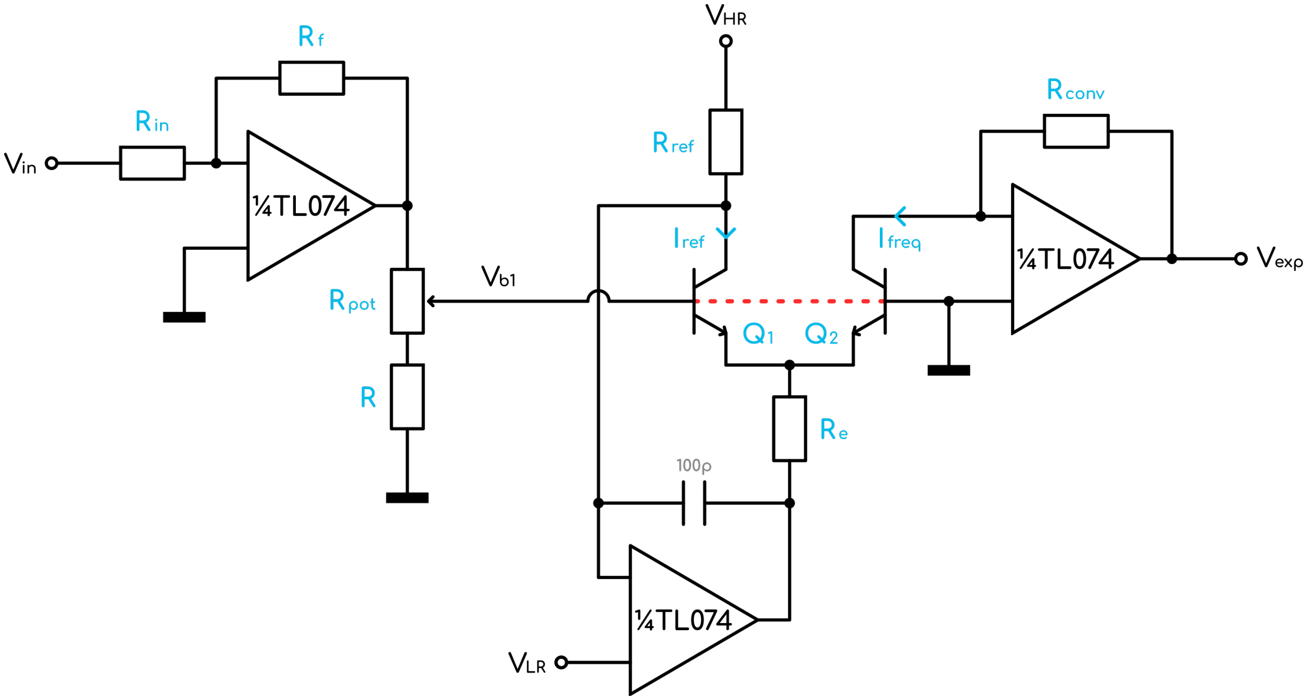
[picture p59: figure]

Figura 3.3: Schema elettrico del convertitore tensione lineare-esponenziale

Vexp = Rconv ·

VHR − VLR

Rref

e

s·Vin
VT
[V ] | (3.7)

### Dimensionamento e Scelta dei Componenti

Passiamo quindi al dimensionamento dei componenti, in modo da imporre al circuito il com-

portamento voluto.

Come prima cosa calcoliamo il valore del guadagno s dell’amplificatore invertente. Si vuole:

Ifreq = Iref e

s·Vin
VT
+∆Vin −−−−→ | 2Ifreq = Iref e
s·(Vin+∆Vin)
VT
(3.8)

qundi un raddoppio della corrente Ifreq per ogni variazione ∆Vin = 1 V . Allora possiamo

riscrivere la relazione nel seguente modo:

2Ifreq

Ifreq

=

Iref e

s·(Vin+∆Vin)
VT

Iref e

s·Vin
VT

→ 2 = e

s·∆Vin
VT

→ ln(2) = s · ∆Vin
VT

→ s =

VT · ln(2)

∆Vin

(3.9)

s =

26 mV · 0.6931
1 V

≈ 0.018 ≈

1
55.5

(3.10)

s =

Rf

Rin

·

%Rpot + R
Rpot + R

=

2 kΩ
100 kΩ

·

440 Ω
490 Ω
≈ 0.018 | (3.11)

quindi:

- Rf = 2 kΩ;
- Rin = 100 kΩ;
- Rpot = 100 Ω;
- R = 390 Ω;

Scegliamo poi Rconv = 3.3 kΩ, per avere come massimo valore di corrente Ifreq = 3 mA

(ovvero Vexp ≈ +10 V in uscita dal convertitore corrente-tensione), in corrispondenza di una

tensione di ingresso Vin = +8 V . Da qui possiamo calcolare il valore di Iref :

Iref = Ifreqe

−

s·Vin
VT
= 0.003e

(− ⁰.018·8

0.026 ) ≈ 11.8 µA | (3.12)

Poi impostando VHR = +12 V e VLR = 0 V calcoliamo Rref :

Rref =

VHR

Iref

=

12
11.8 · 10⁻⁶
≈ 1 MΩ | (3.13)

La scelta di Re sarebbe ora condizionata dalla tensione di saturazione dell’operazionale, poiche`

altrimenti il circuito smetterebbe di comportarsi come desiderato, cambiando il riferimento di

VLR e quindi anche Iref . Avendo collegato la base di Q2 a massa il potenziale agli emettitori

dovra rimanere costante a circa ` | −Vbe per qualsiasi valore di tensione in ingresso, quindi la

tensione in uscita dall’operazionale avra valore `

Vop = −Vbe − Re(Ic1 + Ic2) = −Vbe − Re · Iref
1 + e
sVin
VT
[V ] | (3.14)
che assumera il valore massimo a ` | Vin = +8 V , con una corrente di circa 3 mA in Re. Volendo

imporre una tensione di saturazione di valore −Vsat = −10.5 V calcoliamo il valore di Re.

Re =

Vop + Vbe

−Iref
1 + e
sVin
VT

=

−10.5 + 0.7

−12 · 10⁻⁶

1 + e

(
0.018·8

0.026 )

=

9.8
0.003
≈ 3.3 kΩ | (3.15)
Se pero andiamo a calcolare la caduta di potenziale ai capi di ` | Re corrispondente a Vin = 0 V ,

ovvero:

VRe = 2Re · Iref = 3.3 · 10³

- 24 · 10⁻⁶ ≈ 79.2 mV | (3.16)

notiamo che un valore di resistenza maggiore aumenterebbe la linearita del circuito per bassi `

livelli di Vin, in quanto incrementerebbe la caduta di potenziale sul resistore, risultando quindi

meno influenzata dal rumore. Si modifica allora il circuito cosicche la resistenza di emettitore ´

sia variabile in modo non-lineare, a seconda della corrente richiesta in uscita. Questo e reso `

possibile sostituendo ad Re un parallelo tra due resistori di diverso valore, di cui quello piu`

piccolo collegato in serie ad un diodo, l’elemento che si occupera effettivamente di modificare `

il valore di resistenza.

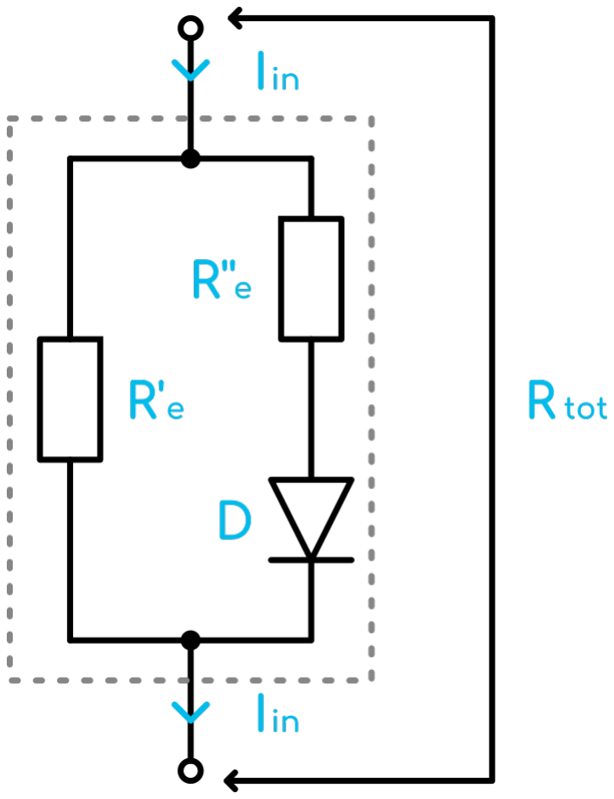
[picture p60: figure]

Figura 3.4: Schema elettrico del resistore di emettitore equivalente

Si scelgono R′

e = 10 kΩ e R′′
e = 1.2 kΩ.

Rtot =

R′
e

con diodo spento, ovvero Iref + Ifreq ≤

Vd
R′
e
R′
e

//R′′
e

con diodo acceso, ovvero Iref + Ifreq >

Vd
R′
e

(3.17)

Per quanto riguarda i componenti, ancora una volta gli amplificatori operazionali utilizzati sono

dei TL074, mentre si sceglie un MPQ3904 [12] per i transistor, chip che ospita 4 unita molto si- `

mili tra loro e termicamente accoppiati, e vista la disponibilita, il diodo viene sostituito con uno `

dei 4 transistor del chip configurato come diodo, quindi collegando base e collettore assieme.

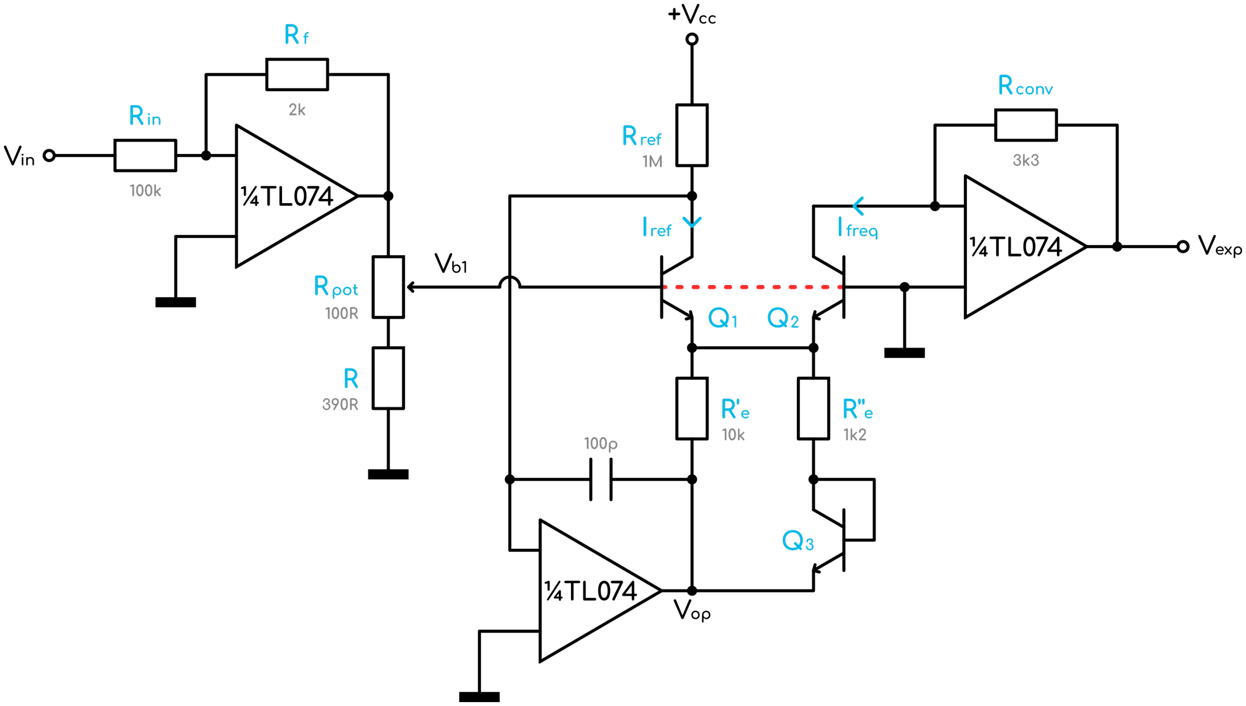
[picture p61: figure]

Figura 3.5: Schema elettrico completo del convertitore tensione lineare-esponenziale (+Vcc = +12 V )

### Risultati Pratici e Misure

Analizziamo ora il comportamento del circuito.

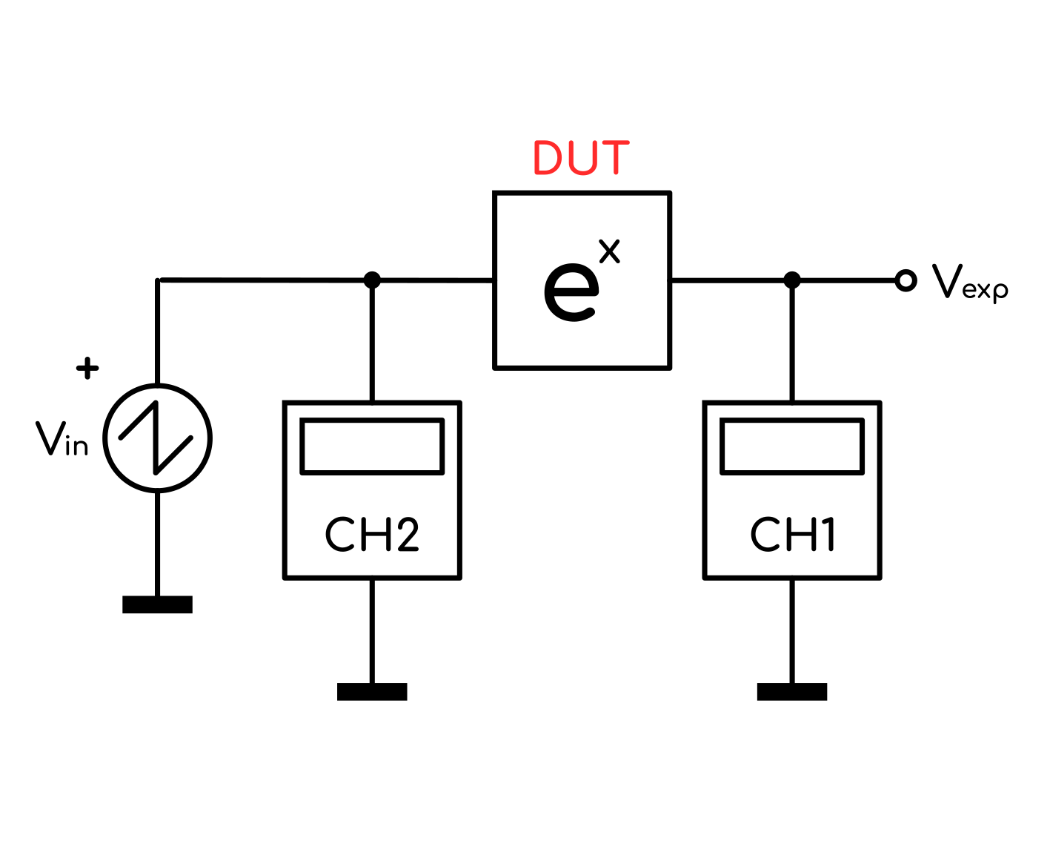
[picture p62: figure]

(a) Setup di misura | (b) Transcaratteristica

Figura 3.6: Misura della transcaratteristica con oscilloscopio


Figura 3.7: Setup di misura

Vin [V ] | Vexp [V ] | 2 Vin [V ]
0 | 0.052 | 0.052
1 | 0.100 | 0.105
2 | 0.203 | 0.209
3 | 0.413 | 0.418
4 | 0.827 | 0.837
5 | 1.678 | 1.674
6 | 3.37 | 3.347
7 | 6.81 | 6.694
7.64 | 10.45 | 10.43
8 | 10.45 | 13.389
9 | 10.45 | 26.778
10 | 10.45 | 53.555

Tabella 3.1: Valori misurati

0 | 2 | 4 | 6 | 8 | 10 | 12 10⁻²

10⁻¹

10⁰

10¹

10²

Vin [V]

Vexp [V]

Transcaratteristica in scala logaritmica

Formula 3.7
Valori attesi
Valori misurati
0 | 2 | 4 | 6 | 8 | 10 | 12

0

5

10

15

Vin [V]

Vexp [V]

Transcaratteristica in scala lineare

Formula 3.7
Valori attesi
Valori misurati

Figura 3.8: Grafici delle misure riportate in tabella 3.1

In azzurro possiamo vedere i valori calcolati tramite la formula 3.7, in rosso invece i valori

ottenuti moltiplicando il dato misurato a 0 V per 2

Vin e infine in nero i valori effettivamente

misurati. Si vede che rispetto a quanto calcolato c’e un lieve discostamento dovuto con ogni `

probabilita alla tolleranza dei valori dei componenti utilizzati, tuttavia le misure risultano quasi `

coincidenti con la curva esponenziale di pendenza 2 (in rosso), quindi possiamo affermare che

il circuito funziona come desiderato.

Il ginocchio presente subito dopo i 10 V e dovuto alla saturazione dell’operazionale nel conver- `

titore corrente-tensione, che con una alimentazione di ±12 V presenta dei valori di saturazione

di circa ±10.5 V .

Si verifica anche che la curva della transcaratteristica in scala lineare coincide con la transcarat-

teristica tracciata con l’oscilloscopio (figura 3.6b).

### 3.2 Somma di piu Ingressi `

Per fare in modo che possa essere utilizzato un segnale in tensione come modulante (ingresso

LFO), si aggiunge un resistore uguale a Rin all’ingresso invertente dell’amplificatore, modifi-

cando quindi la relazione 3.4 nel seguente modo:

Vb1 = −s ·

Xn

0

Vn [V ] | (3.18)

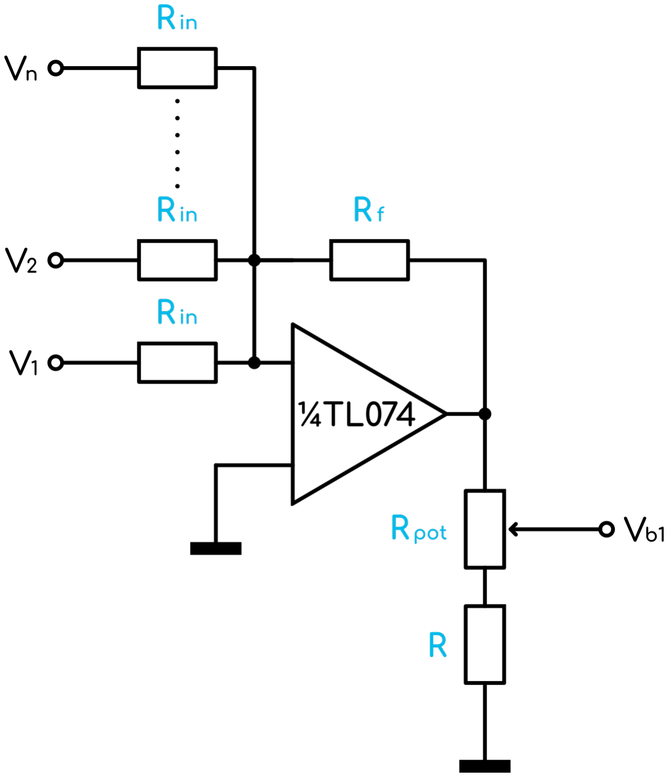
[picture p63: figure]

Figura 3.9: Circuito sommatore invertente

e rendendo quindi l’amplificatore un sommatore invertente. Si noti che non c’e un limite al `

numero di ingressi che e possibile aggiungere. `

Per la modulazione manuale si utilizzano due potenziometri, uno per una regolazione grossolana

e uno per una piu fine, e li si collega ad uno degli ingressi del sommatore nel seguente modo: `

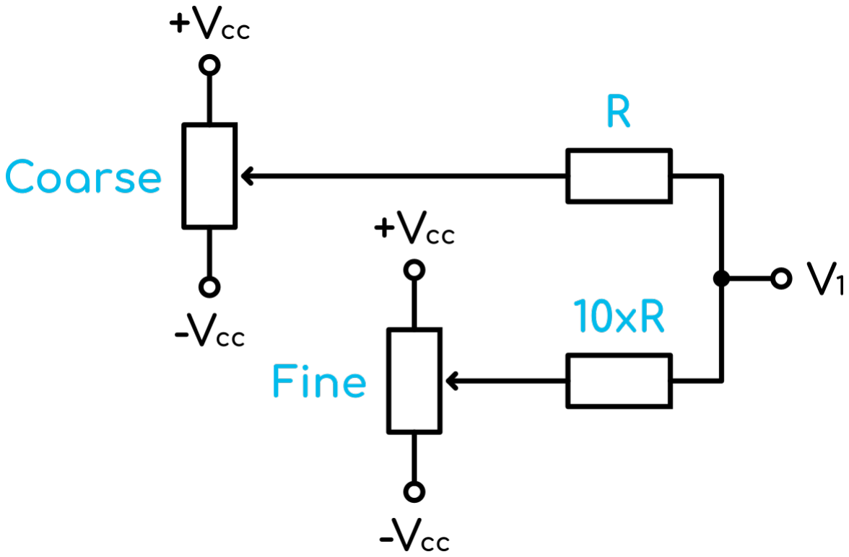
[picture p64: figure]

Figura 3.10: Circuito per la regolazione manuale della frequenza (±Vcc = ±12 V )

questo circuito permette di sommare (o sottrarre) una tensione compresa nel range di alimenta-

zione, inoltre la manopola ”Fine” consente di regolare la tensione in modo piu preciso attorno `

al punto selezionato con ”Coarse”.

Infine, il segnale modulante d’ingresso viene portato ad un altro degli ingressi del sommatore,

attraverso un potenziometro per la regolazione del volume.

Figura 3.11: Circuito di ingresso del segnale modulante

### 3.3 Raddrizzatore

Come visto dalla formula 3.7, la tensione in ingresso Vin deve essere di valore positivo per

polarizzare correttamente il transistor, e volendo inserire nel circuito un nodo sommatore per

avere la possibilita di utilizzare un segnale in tensione come modulante, dobbiamo assicurarci `

che Vb1 non diventi mai positiva (il segno viene invertito dall’amplificatore). Si aggiunge quindi

un blocco raddrizzatore, realizzato con un diodo e un operazionale, che compensera per la `

caduta di tensione sul diodo. Lo schema utilizzato e il seguente: `

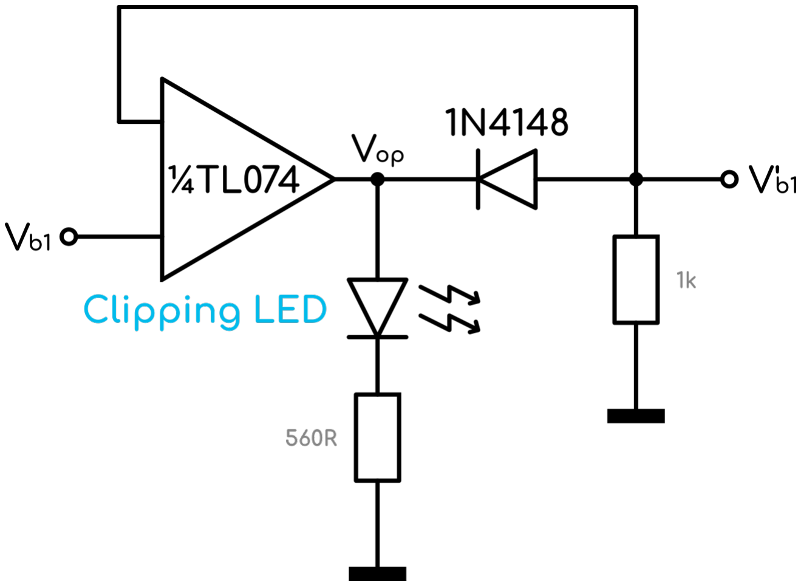
[picture p65: figure]

Figura 3.12: Circuito raddrizzatore

Il resistore collegato a V

′
b1

e necessario per il ricircolo della corrente di polarizzazione del diodo, `

che altrimenti non si accenderebbe mai. Viene inoltre aggiunto un LED per visualizzare quando

il raddrizzatore e in funzione, in modo da permettere all’utente di correggere eventuali errori `

nel segnale modulante in ingresso.

Quindi in uscita si avra la stessa tensione in ingresso se negativa, mentre un valore molto `

prossimo a 0 se positiva.

Vout =

Vin | con Vin ≤ 0
0 | con Vin > 0

(3.19)

Vop =

Vin + Vd | con Vin ≤ 0 ⇒ LED spento
+Vsat | con Vin > 0 ⇒ LED acceso

(3.20)

Il diodo utilizzato per lo scopo e un 1N4148 [14], un comunissimo diodo per piccoli segnali, `

mentre l’operazionale e sempre un TL074. `

### Risultati Pratici e Misure

Verificando il circuito appena discusso vediamo che si comporta esattamente come desiderato,

a meno della tensione di saturazione dell’operazionale, cosa certamente trascurabile in quanto

permette comunque l’accensione del LED.

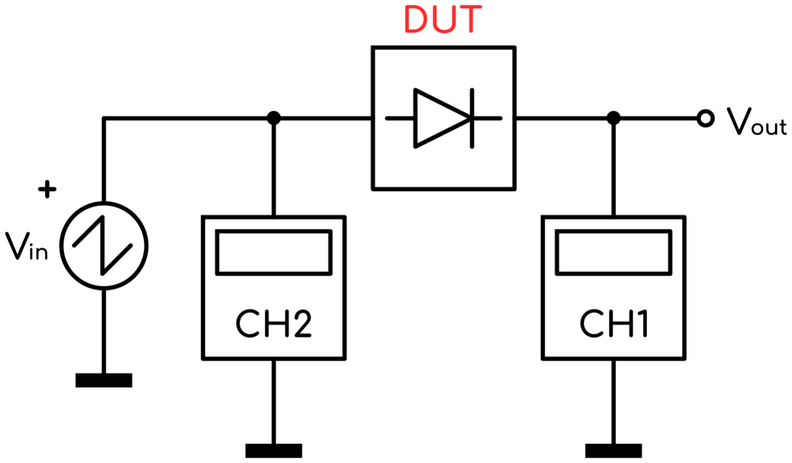
[picture p66: figure]

(a) Setup di misura | (b) Transcaratteristica

Figura 3.13: Misura della transcaratteristica con oscilloscopio

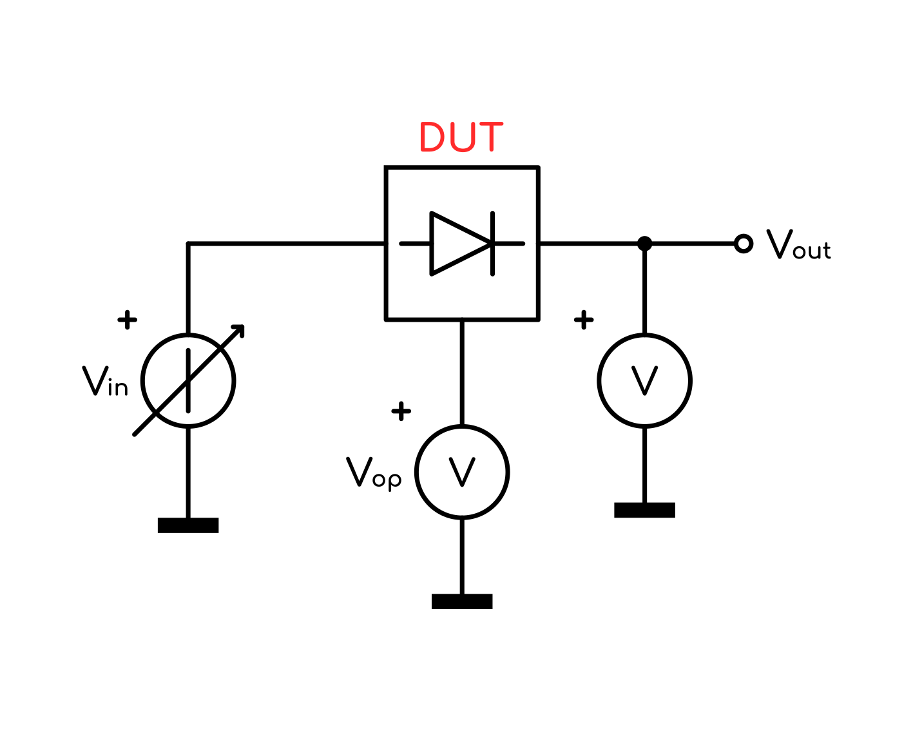
[picture p67: figure]

Figura 3.14: Setup di misura

Vin [V ] | Vout [V ] | Vop [V ]
-6 | -5.9 | -6.676
-5 | -5.08 | -5.767
-4 | -4.007 | -4.753
-3 | -3.007 | -3.735
-2 | -2.006 | -2.71
-1 | -1.005 | -1.671
-0.9 | -0.905 | -1.566
-0.8 | -0.804 | -1.46
-0.7 | -0.704 | -1.353
-0.6 | -0.604 | -1.245
-0.5 | -0.504 | -1.135
-0.4 | -0.404 | -1.023
-0.3 | -0.304 | -0.909
-0.2 | -0.204 | -0.789
-0.1 | -0.103 | -0.654
0 | 0.00742 | 8.64
0.1 | 0.00742 | 8.64
0.2 | 0.00742 | 8.64
0.3 | 0.00742 | 8.64
0.4 | 0.00742 | 8.64
0.5 | 0.00742 | 8.64
0.6 | 0.00742 | 8.64
0.7 | 0.00742 | 8.64
0.8 | 0.00742 | 8.64
0.9 | 0.00742 | 8.64
1 | 0.00742 | 8.64
2 | 0.00742 | 8.64
3 | 0.00742 | 8.64
4 | 0.00742 | 8.64
5 | 0.00742 | 8.64
6 | 0.00742 | 8.64

Tabella 3.2: Tabella dei dati raccolti

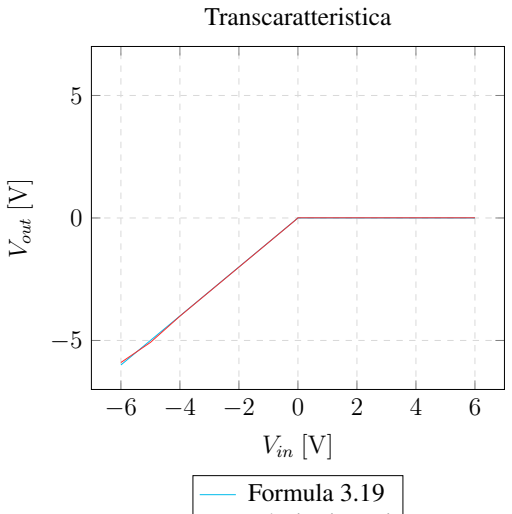
[picture p68: figure]
Vin [V]; Vout [V]; Transcaratteristica; Formula 3.19

Valori misurati

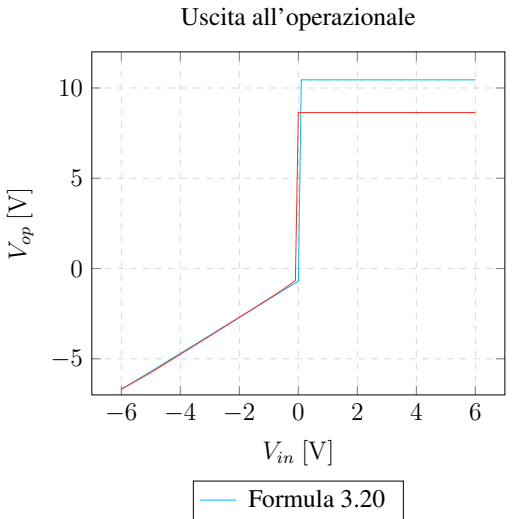
[picture p69: figure]
Vin [V]; Vop [V]; Uscita all’operazionale; Formula 3.20

Valori misurati

# 4. Modalita di Funzionamento `

Per quanto riguarda la selezione della modalita di funzionamento, ` | e facile intuire che basta `

dividere fclk ulteriormente per avere un range di frequenze diverso, come gia visto nel capitolo `

1. Quindi aggiungiamo un blocco divisore di frequenza prima che il segnale arrivi ai contatori

e facciamo in modo che la scelta della frequenza di fout sia determinata da un segnale logico.

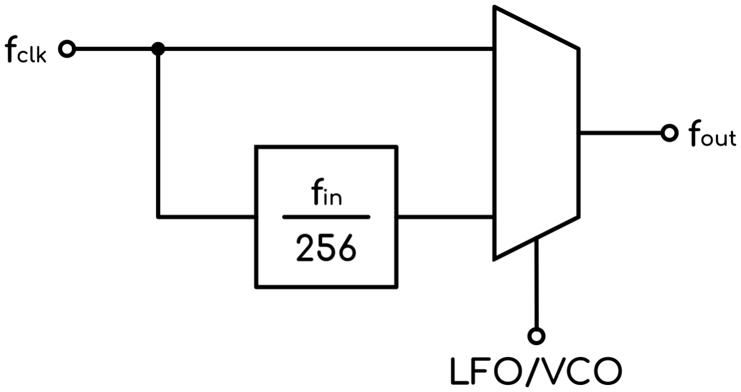
[picture p70: figure]

Figura 4.1: Schema a blocchi del sottosistema per la selezione della modalita`

Lo schema a blocchi sopra riportato si traduce nel seguente circuito, in cui fclk viene divisa per

256, traslando il range di funzionamento nell’intervallo (≈ 0.11 Hz ÷ 27.5 Hz).

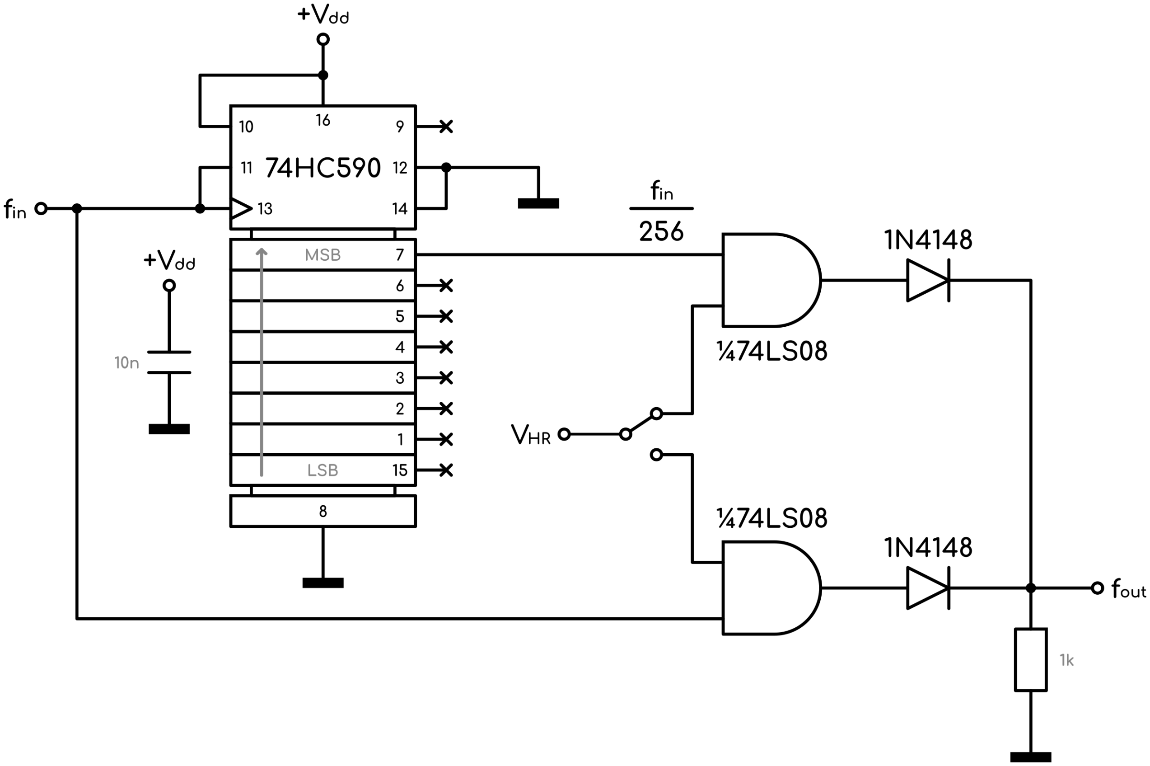
[picture p71: figure]

Figura 4.2: Circuito per la selezione della modalita ( ` +Vdd = VHR = +5 V )

L’unico componente nuovo e un circuito integrato che ospita 4 porte logiche AND, il 74LS08 `

[8], utilizzate per il multiplexing del segnale di clock.

Si aggiungono anche dei LED per la visualizzazione dello stato e delle resistenze di pull-down

all’ingresso abilitante delle porte logiche (non rappresentati nello schema in figura 4.2).

# 5. Generazione dei Segnali Secondari

Ora si passa a estrarre i segnali mancanti da quelli principali generati al capitolo 1.

### 5.1 Dente di Sega

Il piu facile da generare ` | e sicuramente il dente di sega in quanto tutto quello che serve ` | e un `

semplice amplificatore invertente con guadagno pari a uno.

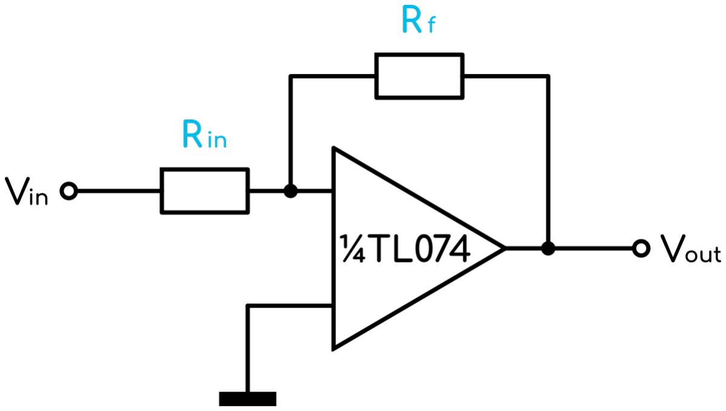
[picture p72: figure]

Figura 5.1: Schema dell’amplificatore invertente

Come sempre l’operazionale utilizzato e un TL074. `

Dalla relazione dell’amplificatore invertente vediamo che per avere un guadagno unitario si

deve porre la resistenza di feedback uguale a quella di ingresso, Rin = Rf .

Vout = −Vin

Rin
Rf
= −Vin [V ] | (5.1)

Questo e quanto ottenuto in uscita: `

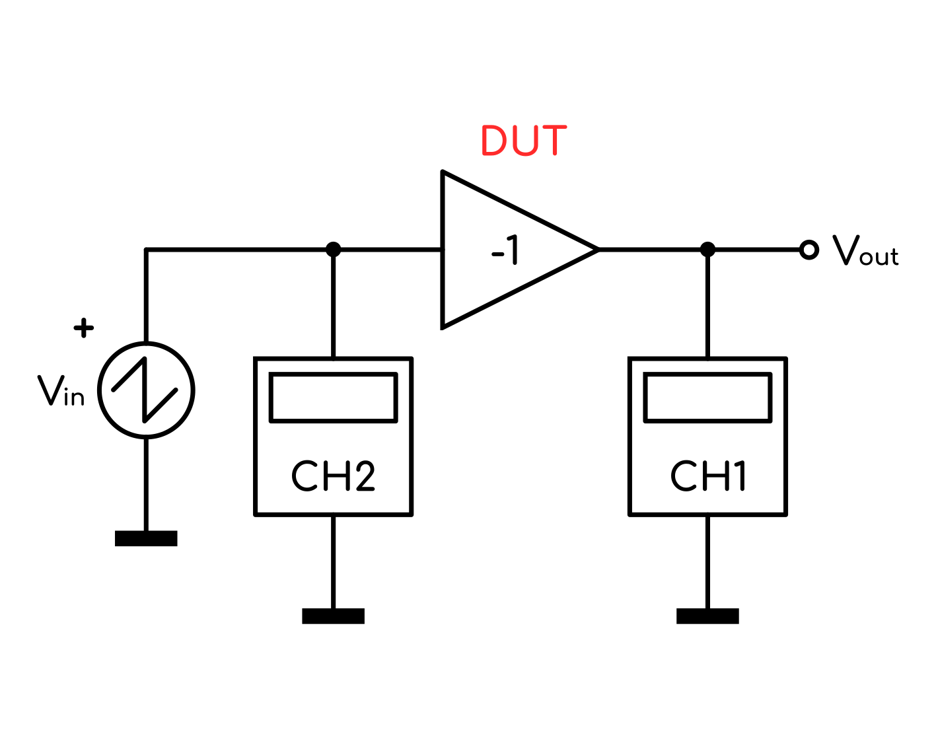
[picture p73: figure]

(a) Setup di misura | (b) Acquisizione dell’onda ottenuta

Figura 5.2: Misura del segnale a dente di sega

### 5.2 Onda Quadra

Anche l’onda quadra risulta piuttosto semplice da generare, in quanto e necessario solo aggiun- `

gere un offset e un guadagno al segnale utilizzato per il pilotaggio del contatore bidirezionale,

ovvero U/D. Tale segnale infatti ha gia forma e frequenza desiderate, ` | e per ` | o compresa solo tra `

0 V e +5 V , e si deve estendere fino a −5 V . Si utilizza quindi un altro amplificatore invertente

con riferimento diverso da massa, lo schema e il seguente: `

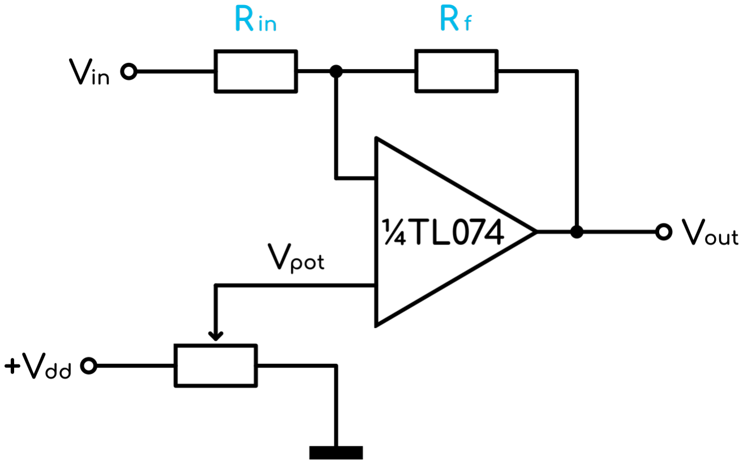
[picture p74: figure]

Figura 5.3: Schema dell’amplificatore invertente con offset (+Vdd = +5 V )

in cui si utilizzano due trimmer per la regolazione precisa di guadagno e offset.

La relazione ingresso/uscita e:`

Vout = Vpot
1 +

Rf

Rin
− Vin

Rf

Rin

[V ] | (5.2)

dove si vede chiaramente che −

Rf

Rin

e il guadagno e ` | Vpot
1 + Rf

Rin
l’offset.

La forma d’onda osservata in uscita e quindi la seguente: `

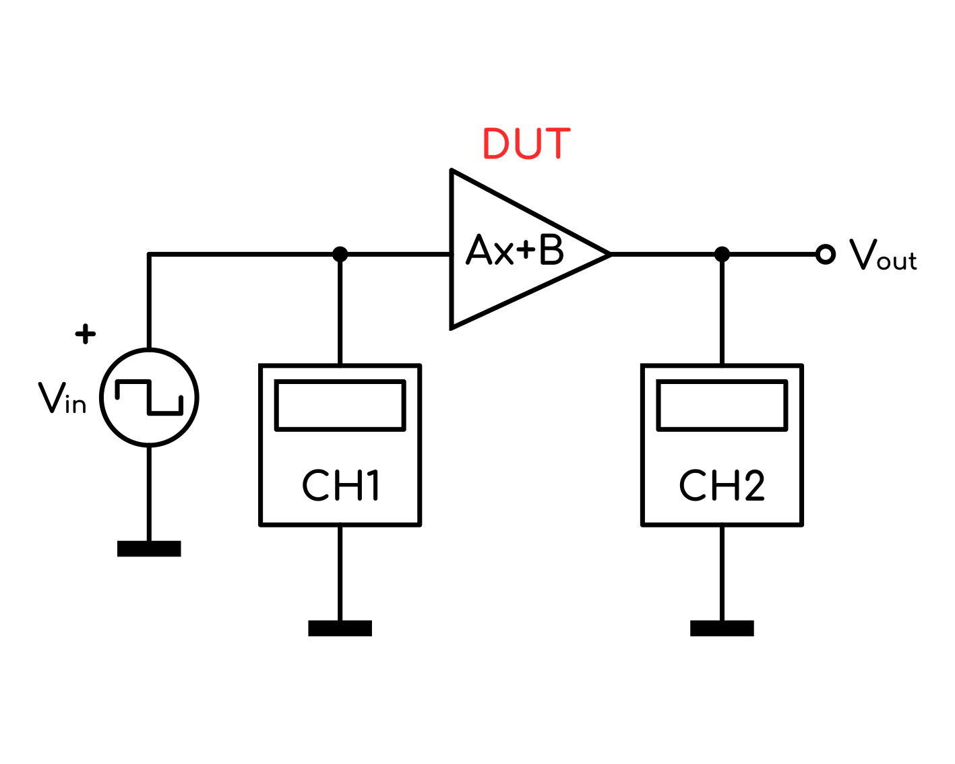
[picture p75: figure]

(a) Setup di misura | (b) Acquisizione dell’onda ottenuta

Figura 5.4: Misura del segnale a onda quadra ottenuto

### 5.3 Impulso

Per quanto riguarda l’impulso invece, facciamo uso del segnale RCO ricavato al capitolo 1,

figura 1.4. Tale segnale viene portato in ingresso ad un circuito monostabile realizzato con un

celebre NE555 [10] che si occupera di aumentare la durata dell’impulso per valori di frequenza `

piu elevati. Lo schema utilizzato, ` | e riportato in figura 5.5 e viene preso da pg.10 del datasheet. `

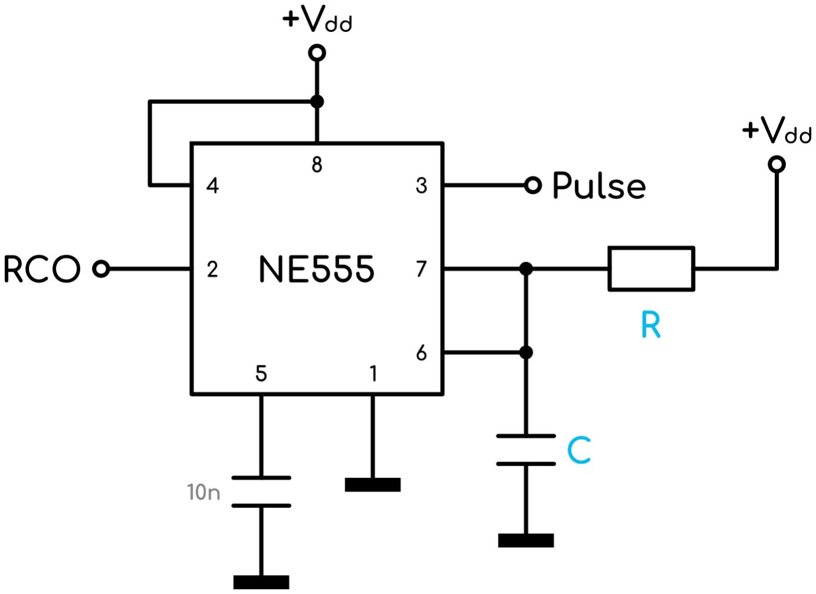
[picture p76: figure]

Figura 5.5: Schema circuito monostabile (+Vdd = +5 V )

La relazione sul periodo dell’impulso in uscita (anch’essa ricavata dal datasheet) e la seguente: `

tw = 1.1RC [s] | (5.3)

Si scelgono R = 10 kΩ e C = 100 pF per ottenere un periodo di impulso di circa 1.1 µs.

Si osservano quindi le forme d’onda cos`ı ottenute:

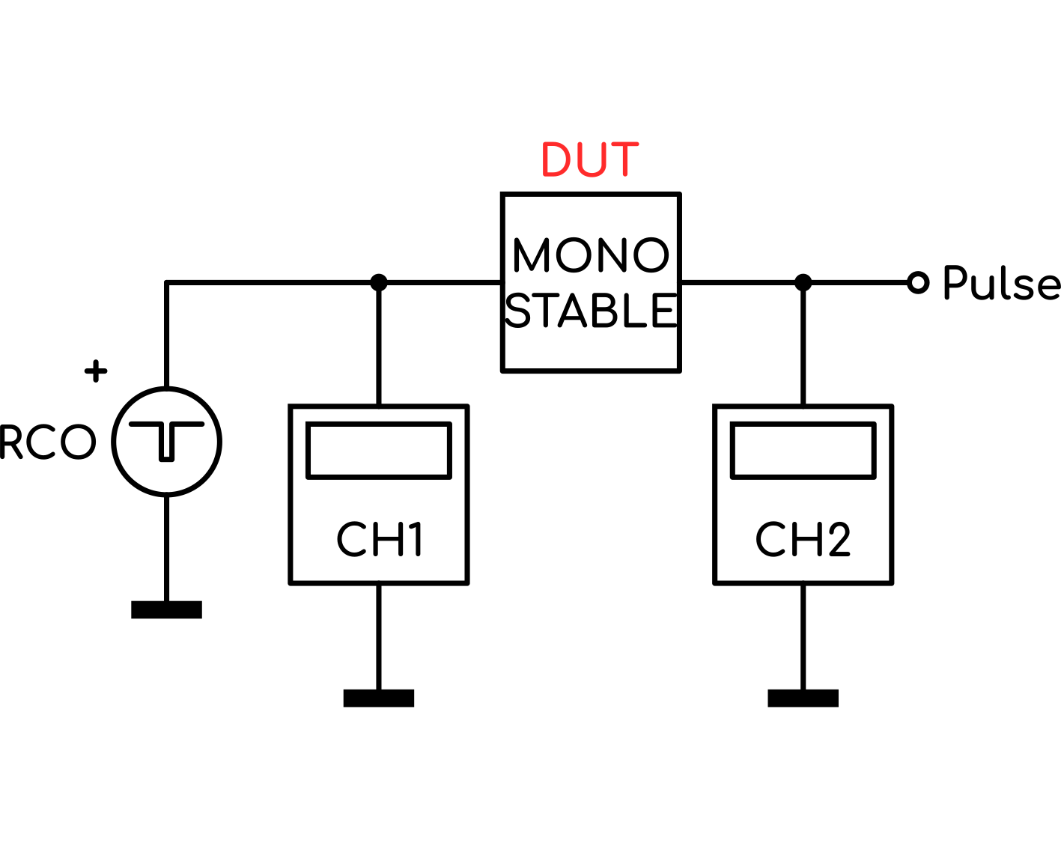
[picture p77: figure]

Figura 5.6: Setup di misura del circuito monostabile

(a) Vin = +2 V | (b) Vin = +8 V

Figura 5.7: Acquisizioni dei segnali RCO e P ulse per diversi valori di Vin

### 5.4 Sinusoide

Infine, l’onda piu complicata da generare, ma pi ` | u semplice per caratteristiche ` | e la sinusoide. `

Un modo piuttosto semplice per generarla sarebbe filtrare al massimo una qualsiasi delle onde

gia generate, e lasciare solo l’armonica fondamentale. Tuttavia questo metodo risulta scomodo `

se la frequenza del segnale varia in un ampio spettro, come appunto nel nostro caso, perche la `

frequenza di taglio del filtro dovrebbe seguire di pari passo quella dell’oscillatore.

La soluzione utilizzata quindi e un circuito con guadagno variabile in base al livello di tensione `

fornito in ingresso, realizzato con un operazionale e dei diodi, sia normali che di tipo zener,

i quali si occupano di modificare la resistenza di feedback e quindi il valore di guadagno del-

l’amplificatore. A questo circuito viene poi fornito in ingresso il triangolo, l’onda piu simile

alla sinusoide tra quelle generate, e in uscita si ottiene un segnale abbastanza approssimato di

una sinusoide.

Per ricavare la relazione ingresso uscita. . .

Poiche in questo passaggio la tensione massima ottenuta ` | e limitata al valore di breakdown dei `

diodi zener nell’anello di feedback, quindi 3.3 V nel nostro caso, e anche necessario uno stadio `

amplificatore in cascata per riportare l’onda ai livelli di tensione specificati dallo standard.

Osserviamo quindi l’onda e verifichiamo quanto risulta buona come approssimazione:

(a) Vin = +2 V | (b) Vin = +8 V
(c) Vin = +2 V | (d) Vin = +8 V

Figura 5.8: Sinusoide ottenuta per diversi valori di Vin nel dominio del tempo e della frequenza

E la transcaratteristica tracciata tramite oscilloscopio risulta abbastanza simile a quella teorica

in figura.

Figura 5.9: Transcaratteristica tracciata con l’oscilloscopio

# 6. Stadi di Uscita

Per quanto rigurarda gli stadi di uscita, si collega in serie un filtro passa-basso attivo, che avra`

anche lo scopo di isolare l’assorbimento di corrente dai circuiti che generano i segnali.

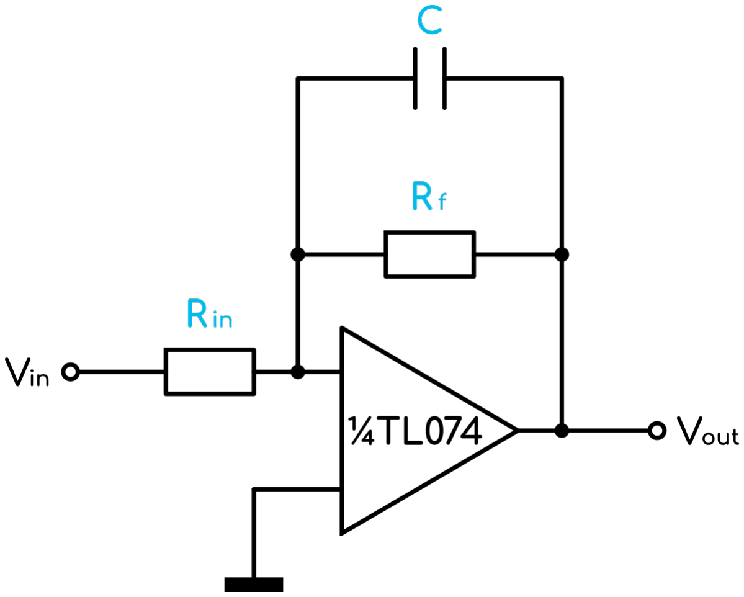
[picture p78: figure]

Figura 6.1: Circuito del filtro attivo utilizzato

sfruttando questa soluzione circuitale infatti, tutta la corrente prelevata dal circuito in uscita

verra fornita dagli amplificatori operazionali. Le relazioni del circuito sono le seguenti: `

Vout = −Vin

Rf

Rin

·

1
1 + jωRfC
[V ] | (6.1)

fcut =

1
2πRfC
[Hz] | (6.2)

AdB = 20log10

Rf

Rin

·

1
1 + jωRfC
[dB] | (6.3)

oppure, dai valori misurati:

AdB = 20log10
Vrms out

Vrms in
[dB] | (6.4)

La frequenza di taglio viene presa attorno ai 50 kHz per conservare tutto lo spettro audio e

rimuovere invece disturbi in alta frequenza dovuti ad esempio ai segnali di clock. Scegliendo

Rf = 100 kΩ quindi, il valore del condensatore va preso di circa 30 pF, mentre Rin deve avere

valore pari a Rf , in questo modo si ha guadagno unitario e

fcut =

1
2π · 100 · 10³
- 30 · 10⁻12
≈ 53 kHz | (6.5)

Misurando il valore del guadagno con il setup di misura riportato in figura 6.2, vediamo che il

comportamento del circuito teorico viene rispettato.


Figura 6.2: Setup di misura

fin [kHz] | Vrmsin [V ] | Vrmsout [V ] | AdB [dB]
0.125 | 1.410 | 1.410 | 0.000
0.250 | 1.410 | 1.410 | 0.000
0.500 | 1.410 | 1.410 | 0.000
1 | 1.410 | 1.410 | 0.000
2 | 1.410 | 1.390 | -0.124
4 | 1.410 | 1.390 | -0.124
8 | 1.410 | 1.390 | -0.124
16 | 1.410 | 1.260 | -0.977
32 | 1.410 | 0.962 | -3.321
64 | 1.410 | 0.589 | -7.582
128 | 1.410 | 0.314 | -13.046
256 | 1.410 | 0.164 | -18.688
512 | 1.410 | 0.095 | -23.430
1000 | 1.410 | 0.057 | -27.867
2000 | 1.410 | 0.054 | -28.337

Tabella 6.1: Misure del guadagno del filtro attivo

10⁻¹ | 10⁰ | 10¹ | 10² | 10³

−40

−30

−20

−10

0

fin [kHz]

AdB [dB]

Diagramma di bode del filtro

Formula 6.3
Formula 6.4 (con i valori misurati)
(a) fin = 10 kHz | (b) fin = 100 kHz

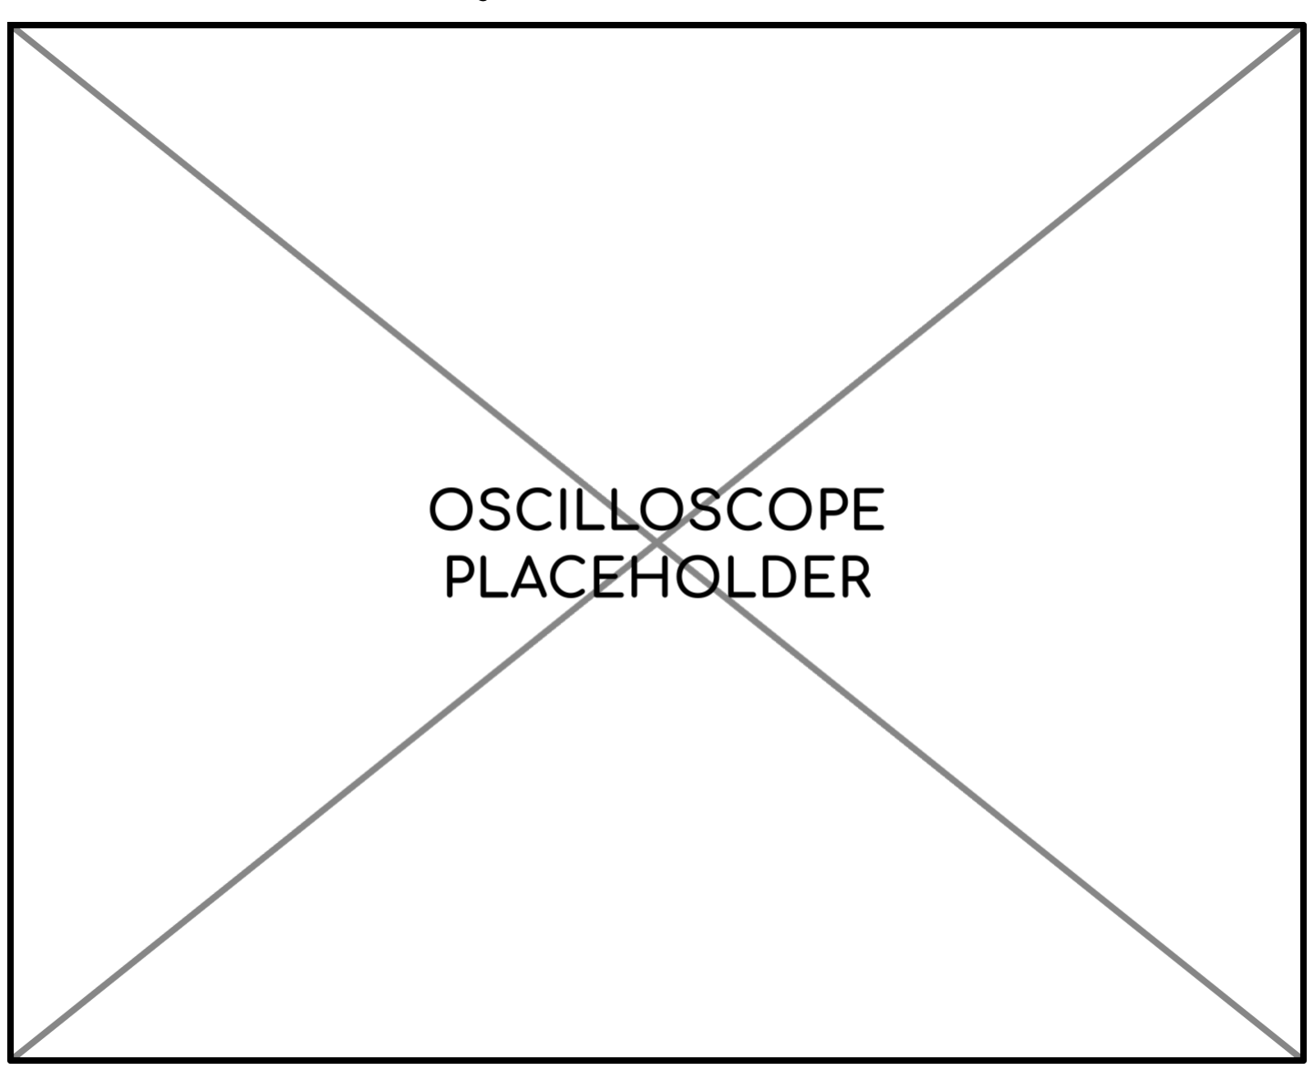
[picture p79: figure]
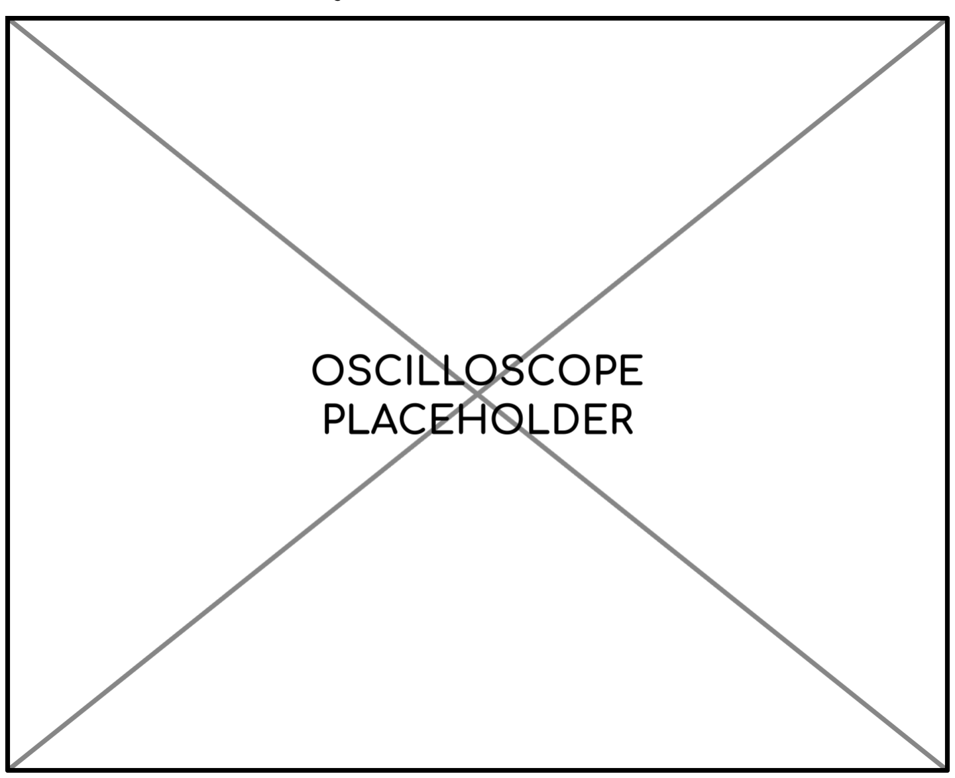
[picture p80: figure]

(c) fin = 500 kHz | (d) fin = 1 MHz

Figura 6.3: Acquisizioni dei segnali in ingresso e uscita al filtro per diversi valori di fin

In serie ai filtri per le onde a rampa e dente di sega viene anche collegato un amplificatore

invertente con guadagno unitario, con schema uguale a quello rappresentato in figura 5.1 per

riportare le onde alla loro forma originale, in quanto non sono simmetriche.

Infine, in serie a tutte le uscite degli ultimi operazionali prima del connettore, si collegano delle

resistenze di protezione, dal valore di circa 1 kΩ per limitare la corrente in uscita in caso di

eventuali cortocircuiti, che potrebbero provocare danni agli amplificatori operazionali.

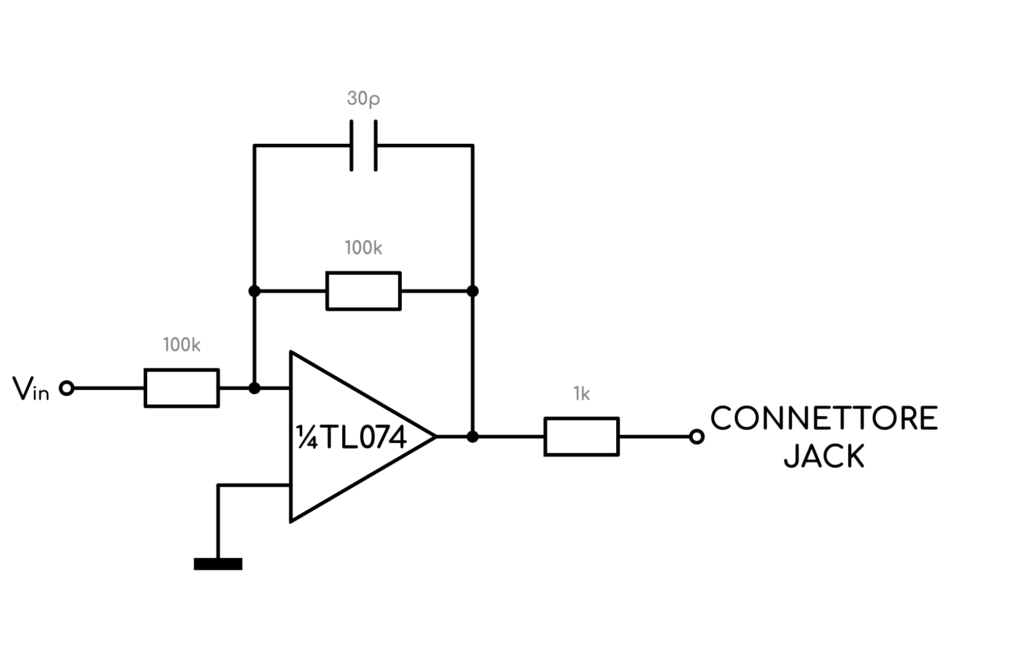
[picture p81: figure]

(a) Circuito utilizzato per triangolo, sinusoide e onda quadra

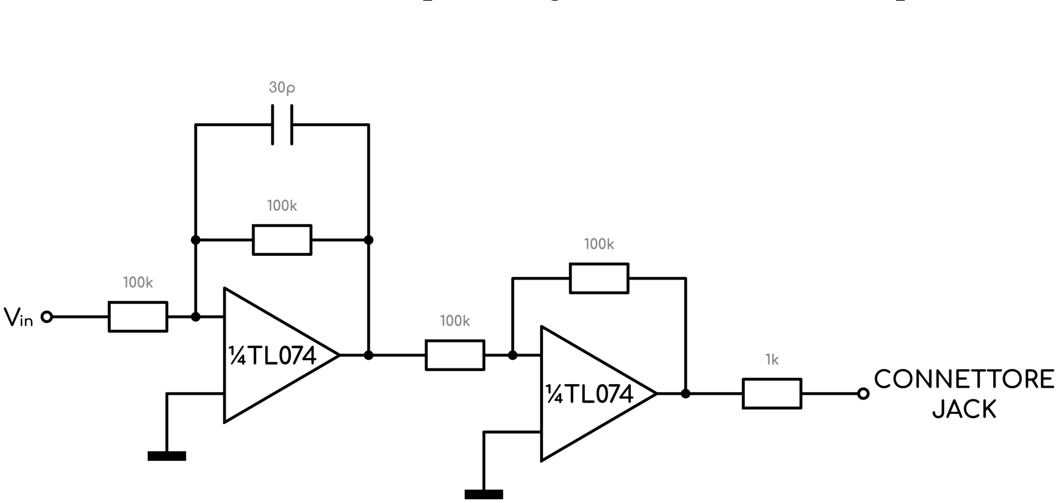
[picture p82: figure]

(b) Circuito utilizzato per rampa e dente di sega

Figura 6.4: Stadi d’uscita completi

# Considerazioni Finali e Conclusioni

TODO

# A. Schemi Elettrici delle Schede

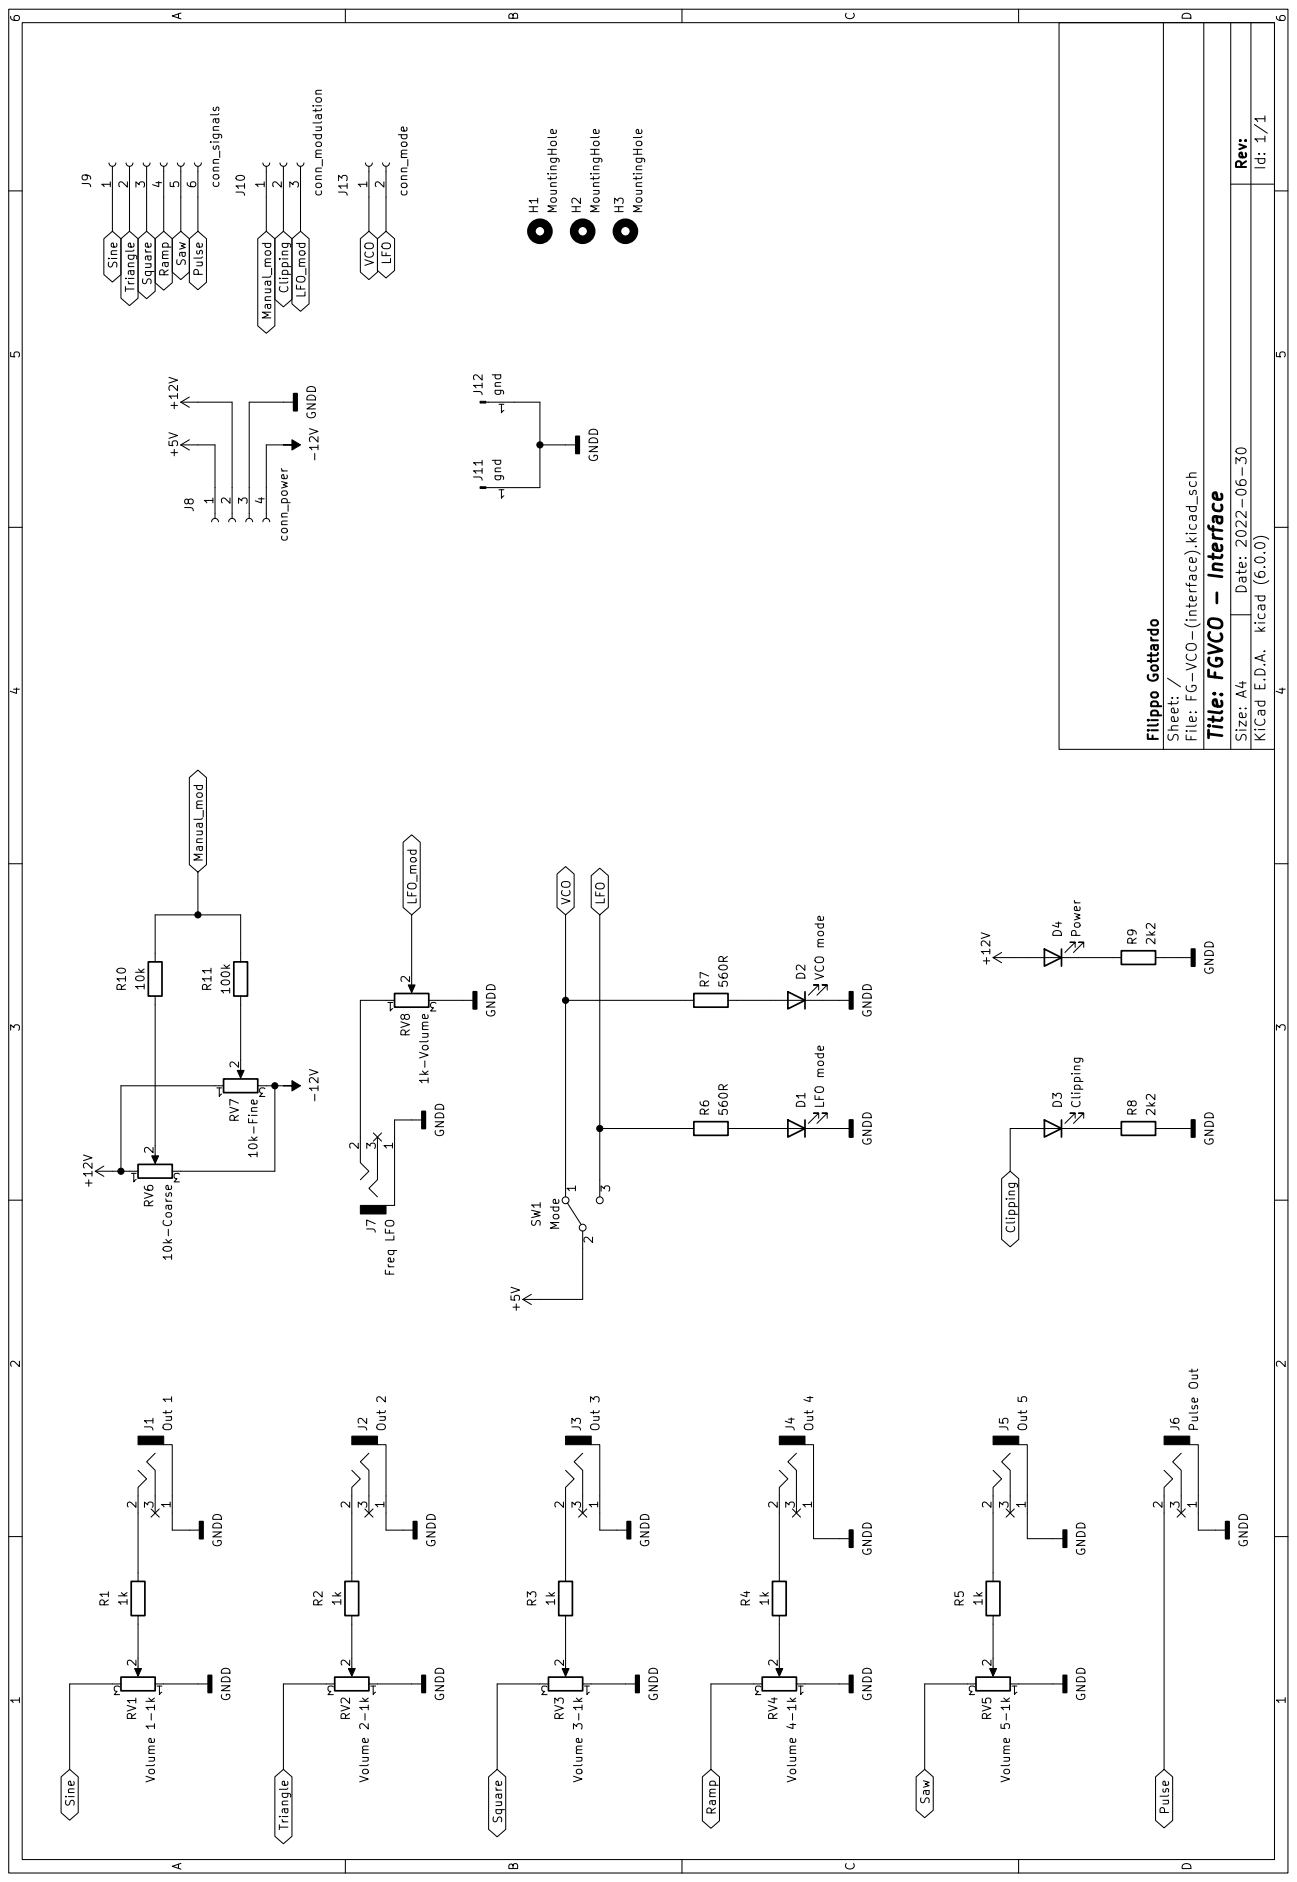
[picture p83: page 44]
6conn_signals GNDD; 2J13 conn_mode GNDD 1; 1 J2Out 2; 1 J1Out 1; 4J8 conn_power +12V; 1 J4Out 4; 1 J5Out 5 +5V R51k GNDD R21k; 1 J6Pulse Out GNDD; 1 J3Out 3; 3 SW1 Mode +5V

D Date: 2022-06-30 KiCad E.D.A. kicad (6.0.0) Rev: Size: A4 Id: 1/1 Filippo Gottardo Sheet: / File: FG-VCO-(interface).kicad_sch Title: FGVCO - Interface R7560R H1MountingHole H3MountingHole J9

3J10 conn_modulation GNDD GNDD D1LFO mode 1

1 J7 Freq LFO R10 R11 100k 10k GNDD -12V

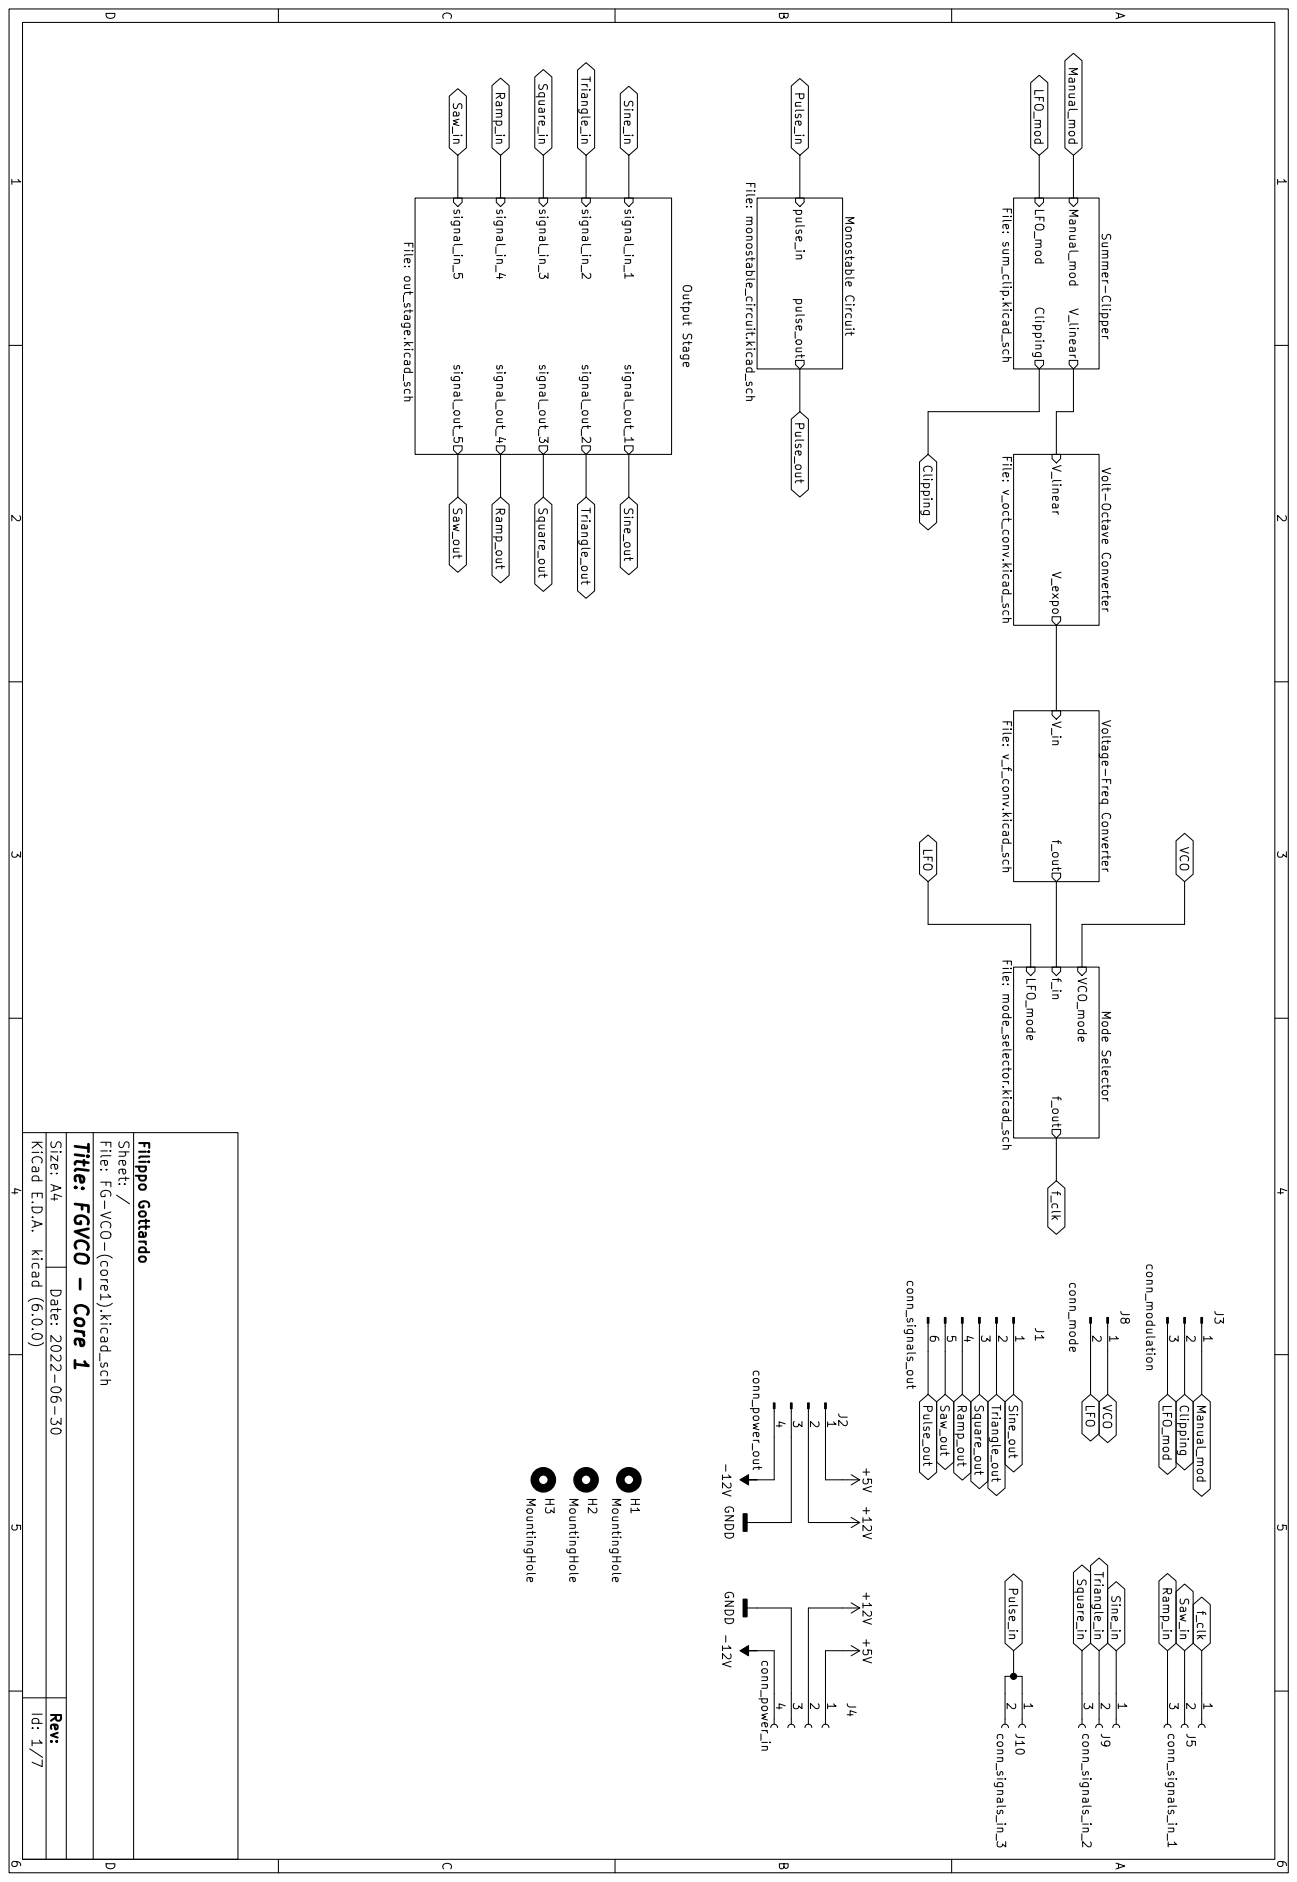
[picture p84: page 45]
1 J9conn_signals_in_2; 1 conn_signals_in_3 J10 -12V GNDD; 1J1 conn_signals_out 2 1 J8 conn_mode3; 1 J3 conn_modulation +5V; 1J4 conn_power_in +12V; 1J2 conn_power_out +5V +12V

1 J5conn_signals_in_1 -12V GNDD MountingHole H2MountingHole H1 Square_out Pulse_out Square_out Triangle_out LFO Pulse_out Clipping Saw_in Ramp_in f_clk LFO VCO Saw_out Ramp_out Sine_out Saw_in f_clk Ramp_in Pulse_in LFO_mod Manual_mod LFO_mod Clipping Sine_in Square_in Triangle_in VCO Manual_mod Triangle_out Saw_out Ramp_out Square_in Triangle_in Sine_in Pulse_in Sine_out

A Date: 2022-06-30 KiCad E.D.A. kicad (6.0.0) Rev: Size: A4 Id: 1/7 Title: FGVCO - Core 1 File: FG-VCO-(core1).kicad_sch Sheet: / Filippo Gottardo LFO_mode VCO_mode f_out f_in Mode Selector File: mode_selector.kicad_sch pulse_out pulse_in Monostable Circuit File: monostable_circuit.kicad_sch V_linear LFO_mod Manual_mod Clipping Summer-Clipper File: sum_clip.kicad_sch f_out V_in File: v_f_conv.kicad_sch Voltage-Freq Converter signal_in_3 signal_out_5 signal_out_4 signal_out_3 signal_in_2 signal_in_1 signal_out_2 signal_out_1 signal_in_5 signal_in_4 Output Stage File: out_stage.kicad_sch V_expo V_linear Volt-Octave Converter File: v_oct_conv.kicad_sch MountingHole H3

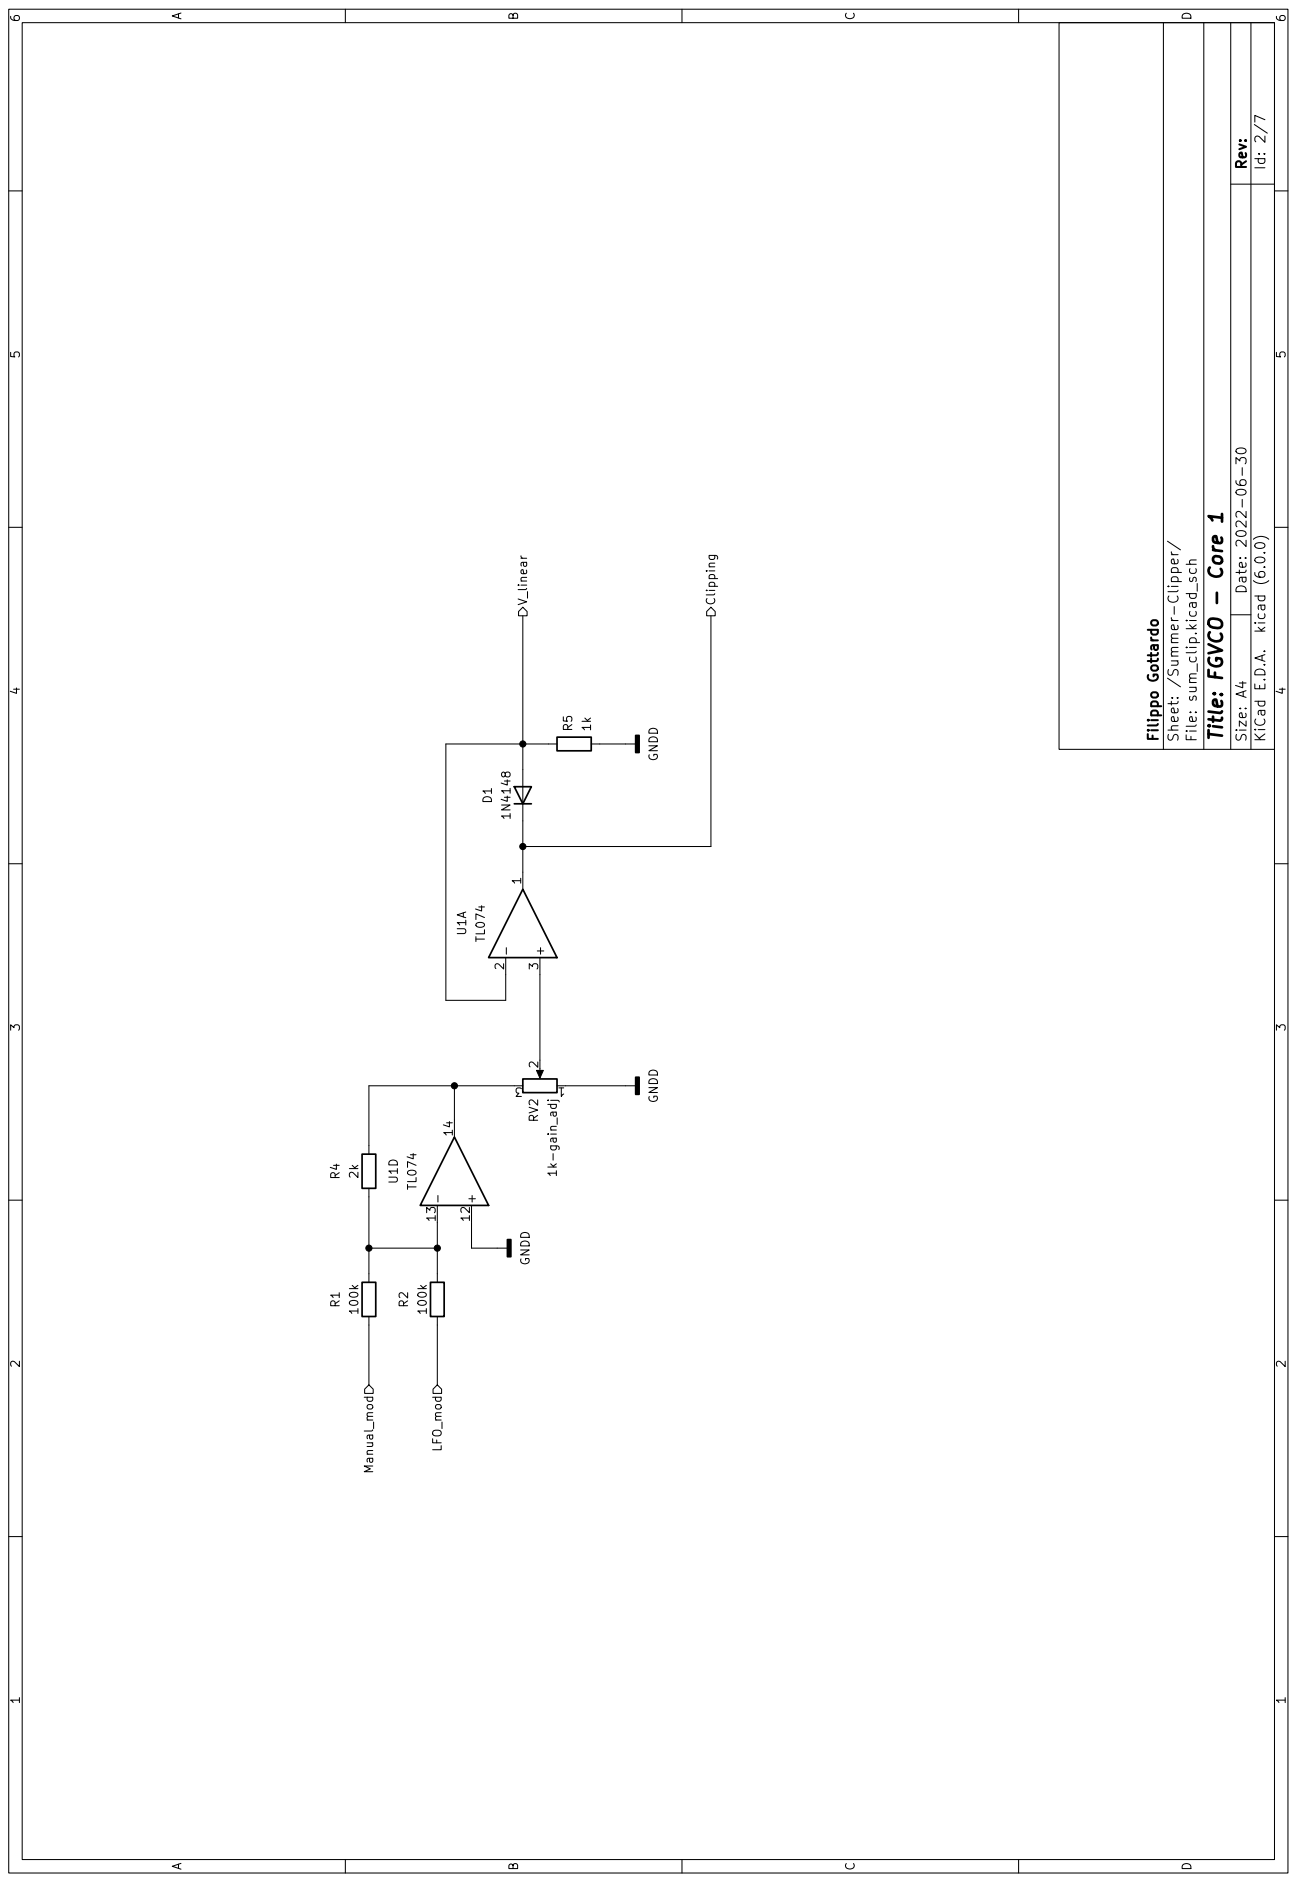
[picture p85: page 46]
3 U1A TL074 D1 1N4148 GNDD R5 1k GNDD

D Date: 2022-06-30 KiCad E.D.A. kicad (6.0.0) Rev: Size: A4 Id: 2/7 Filippo Gottardo Sheet: /Summer-Clipper/ File: sum_clip.kicad_sch Title: FGVCO - Core 1

# 14 Q1D MPQ3904 V_linear V_expo

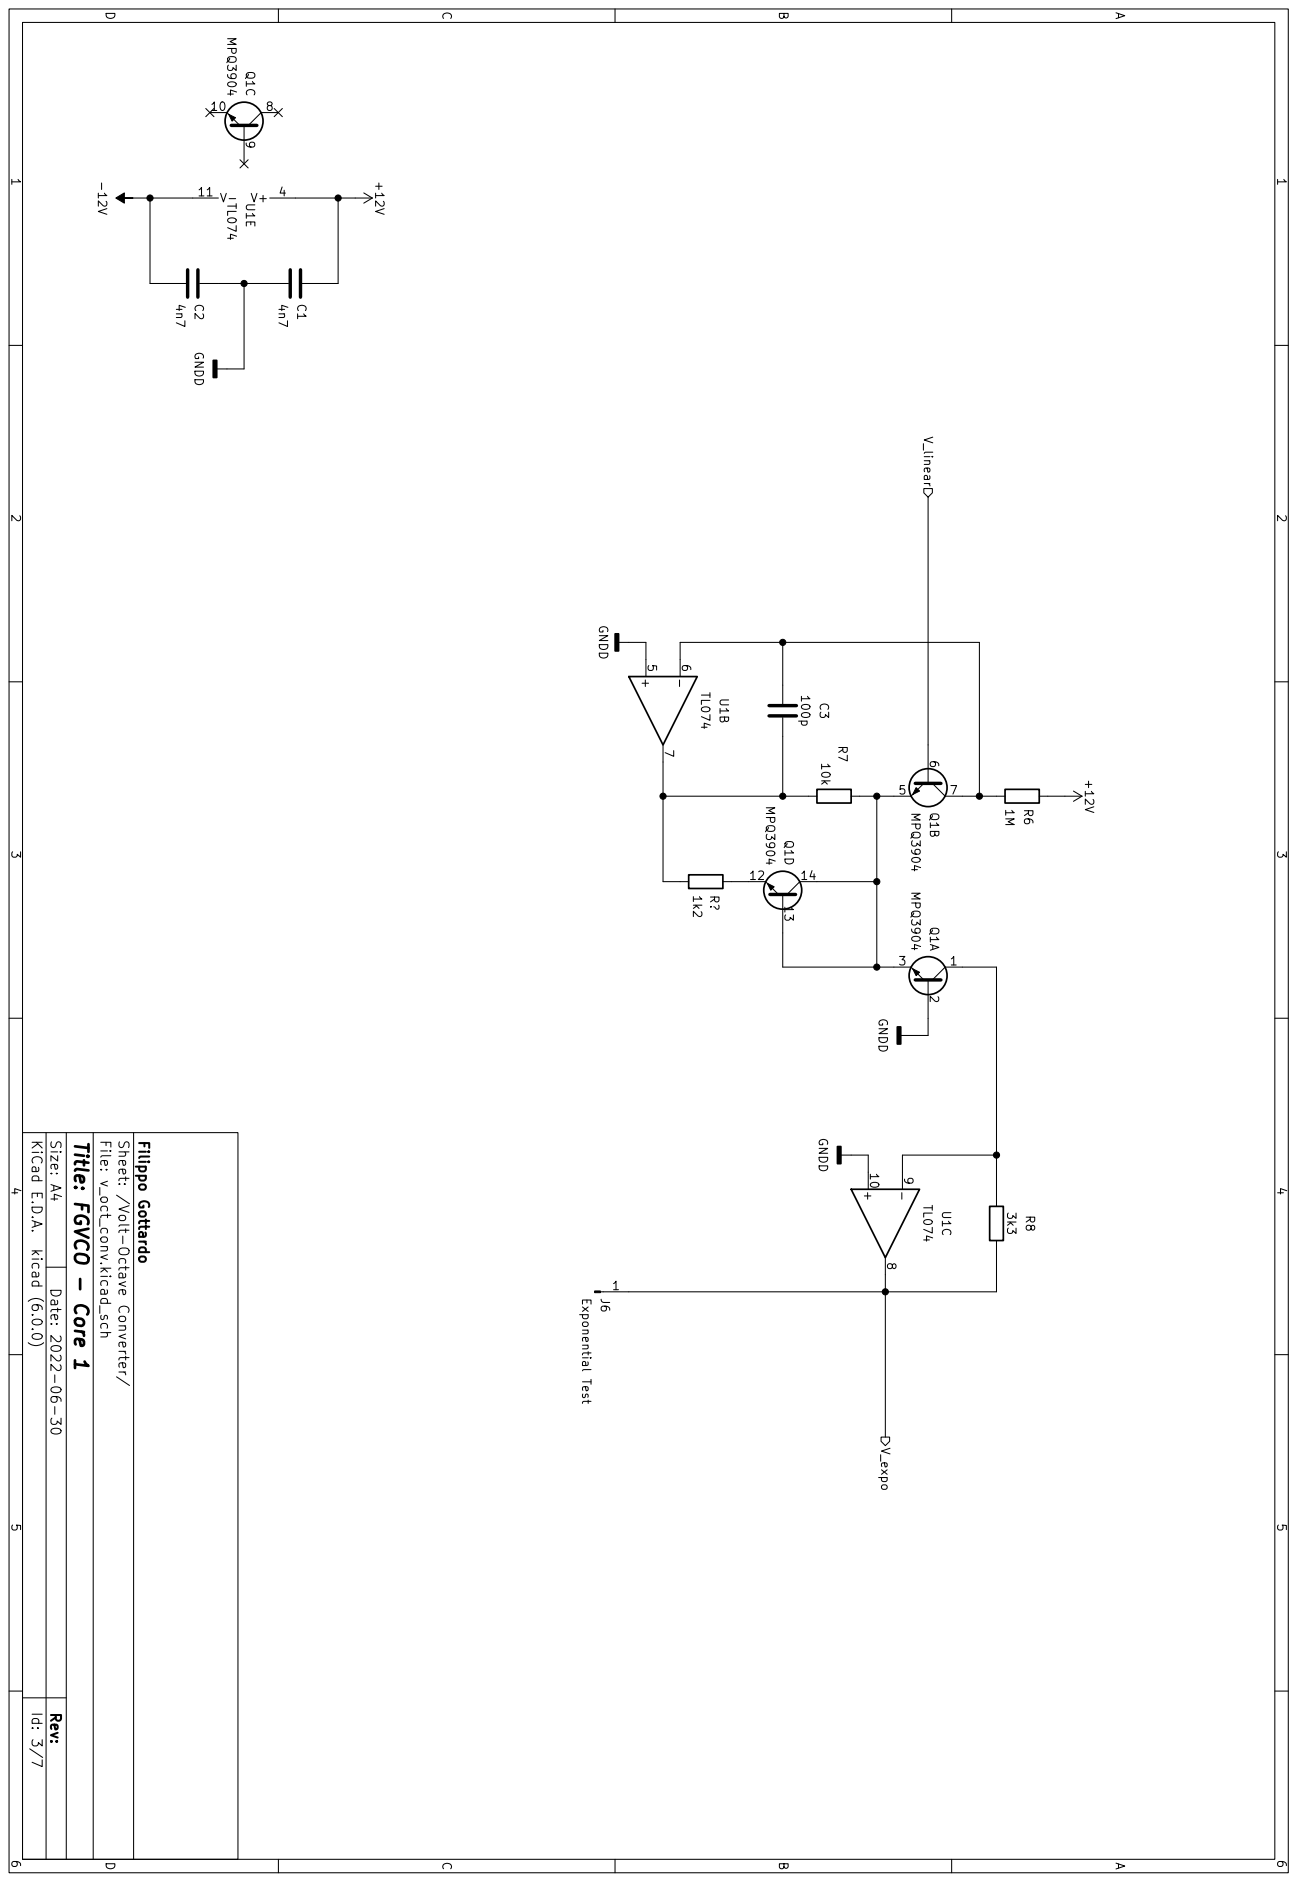
[picture p86: page 47]

A Date: 2022-06-30 KiCad E.D.A. kicad (6.0.0) Rev: Size: A4 Id: 3/7 Title: FGVCO - Core 1 File: v_oct_conv.kicad_sch Sheet: /Volt-Octave Converter/ Filippo Gottardo

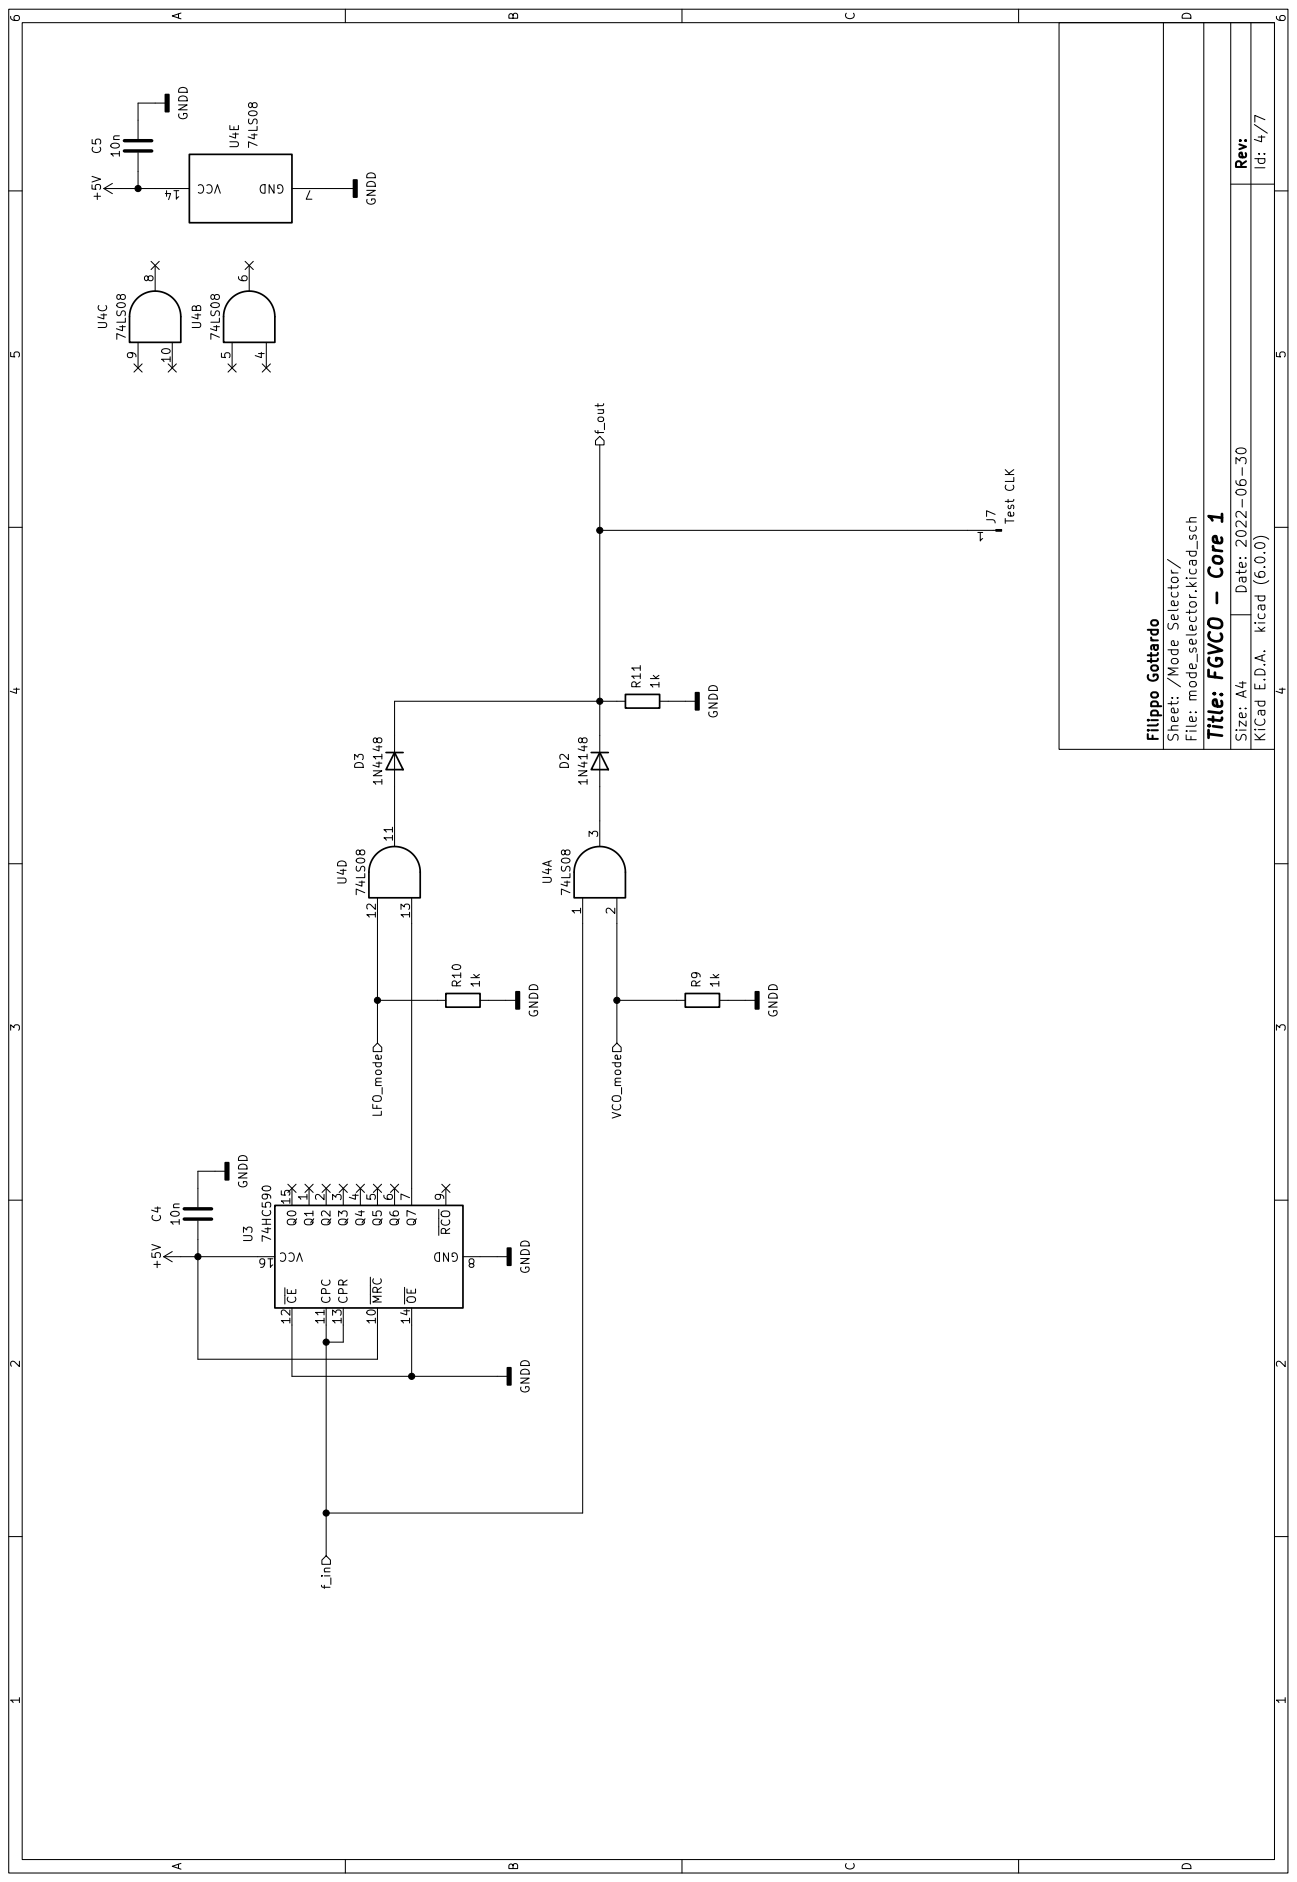
[picture p87: page 48]

D Date: 2022-06-30 KiCad E.D.A. kicad (6.0.0) Rev: Size: A4 Id: 4/7 Filippo Gottardo Sheet: /Mode Selector/ File: mode_selector.kicad_sch Title: FGVCO - Core 1

7 GND 8 ~{RCO} 9 U374HC590 +5V GNDD +5V C4 10n R9 1k GNDD GNDD f_in f_out LFO_mode VCO_mode

1 ~{MRC} 10 CPC 11 ~{CE} 12 CPR 13 ~{OE} 14 Q0 15 VCC 16 Q2

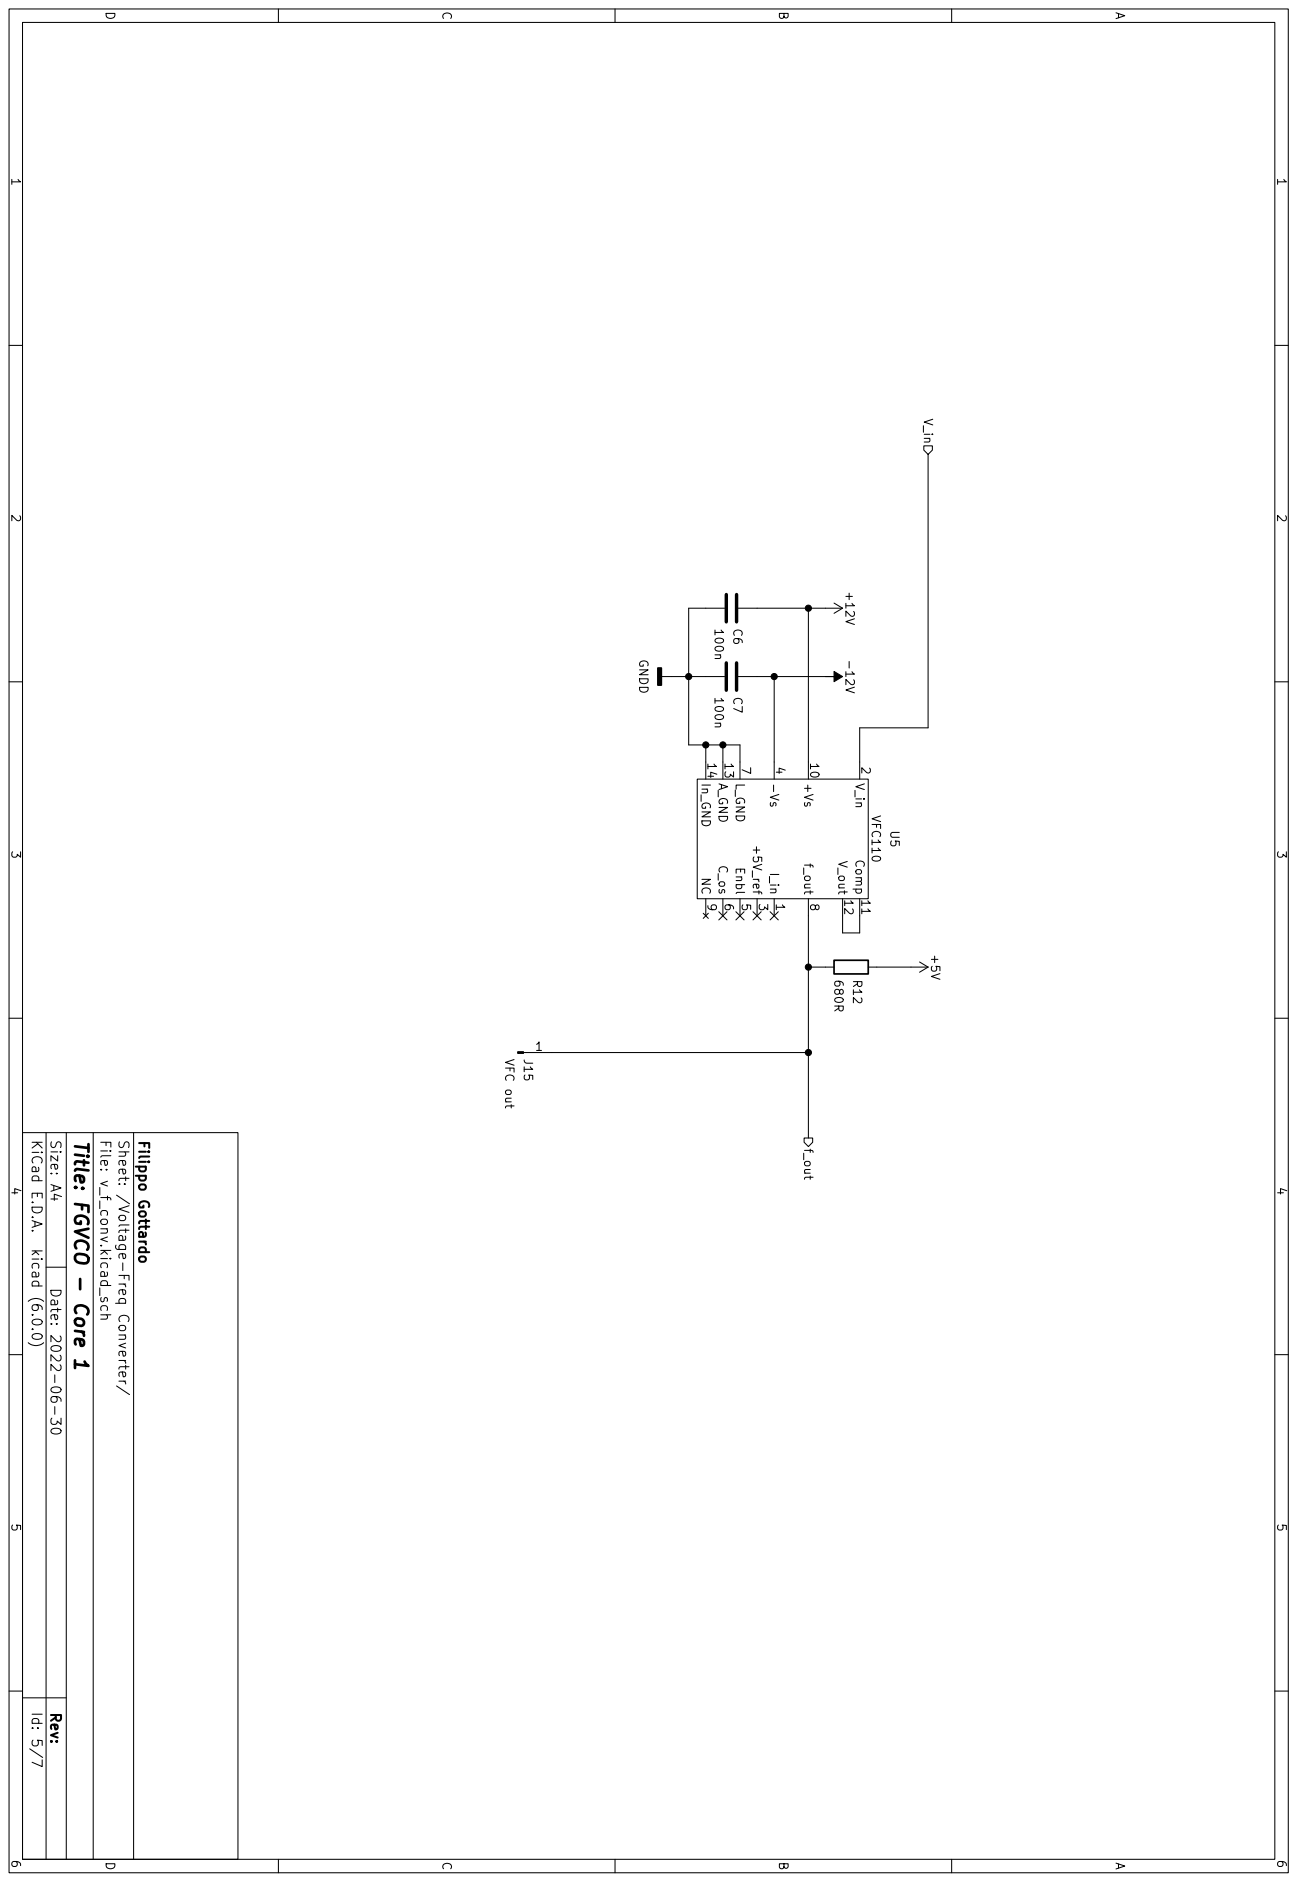
[picture p88: page 49]
1 +Vs 10 Comp 11 V_out 12 A_GND 13 In_GND 14 V_in 2 +5V_ref 3 -Vs 4 Enbl 5 C_os 6 L_GND; 7 f_out 8 NC; 9 U5 VFC110 +5V; 1 VFC out; V_in f_out

A Date: 2022-06-30 KiCad E.D.A. kicad (6.0.0) Rev: Size: A4 Id: 5/7 Title: FGVCO - Core 1 File: v_f_conv.kicad_sch Sheet: /Voltage-Freq Converter/ Filippo Gottardo GNDD -12V 100n C7 +12V 100n C6 I_in

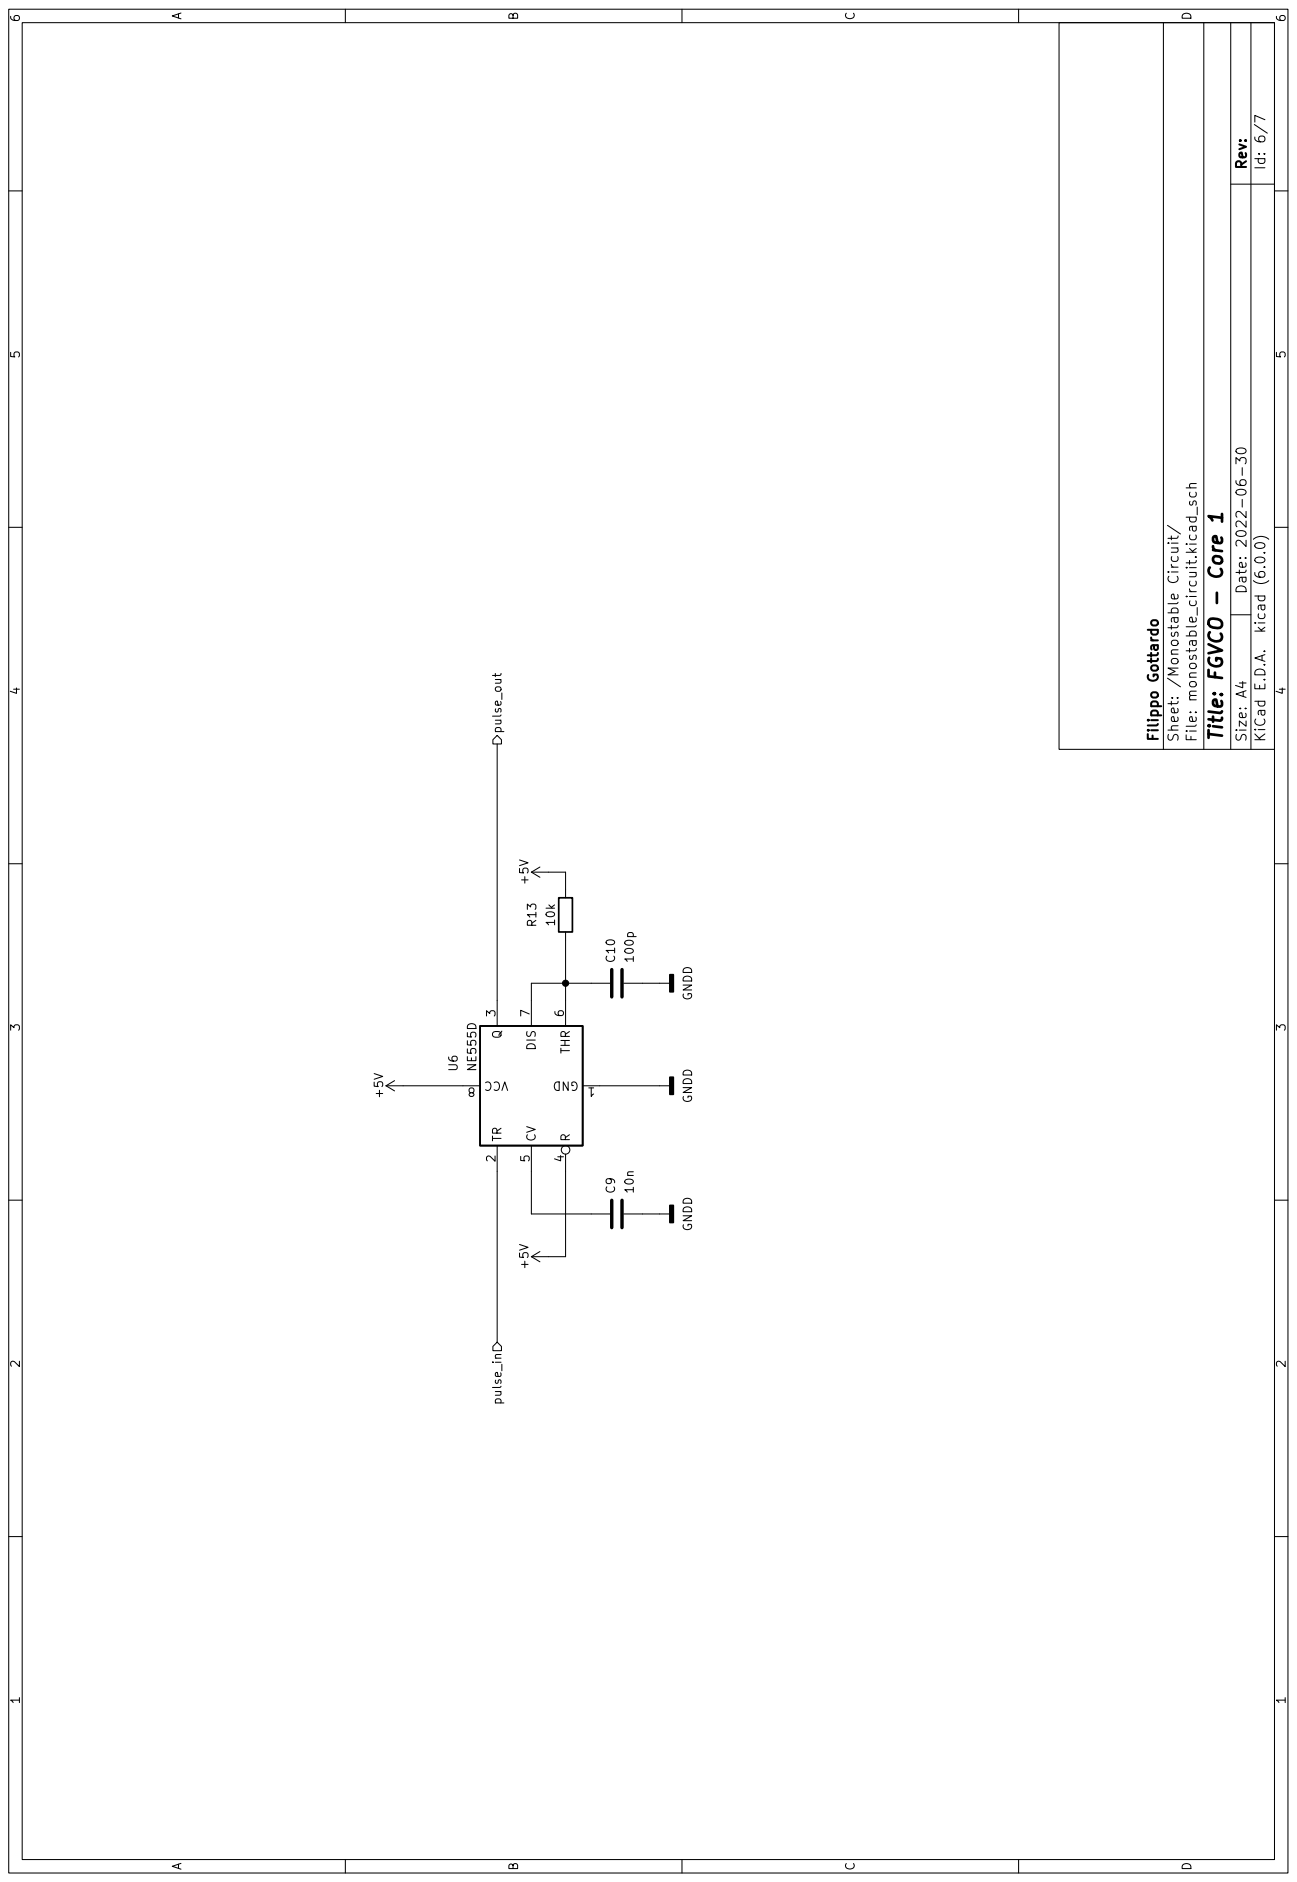
[picture p89: page 50]
5 THR; 6 DIS; 7 U6NE555D +5V +5V pulse_in pulse_out

D Date: 2022-06-30 KiCad E.D.A. kicad (6.0.0) Rev: Size: A4 Id: 6/7 Filippo Gottardo Sheet: /Monostable Circuit/ File: monostable_circuit.kicad_sch Title: FGVCO - Core 1 C10 100p GNDD C910n GNDD GNDD R13 10k +5V GND 1 VCC 8 TR

V- 11 | V+ 4 TL074 U7E | signal_in_5 | signal_in_1 signal_out_5 | signal_out_1 signal_out_4 | signal_in_4 signal_in_3 | signal_in_2 signal_out_3 | signal_out_2

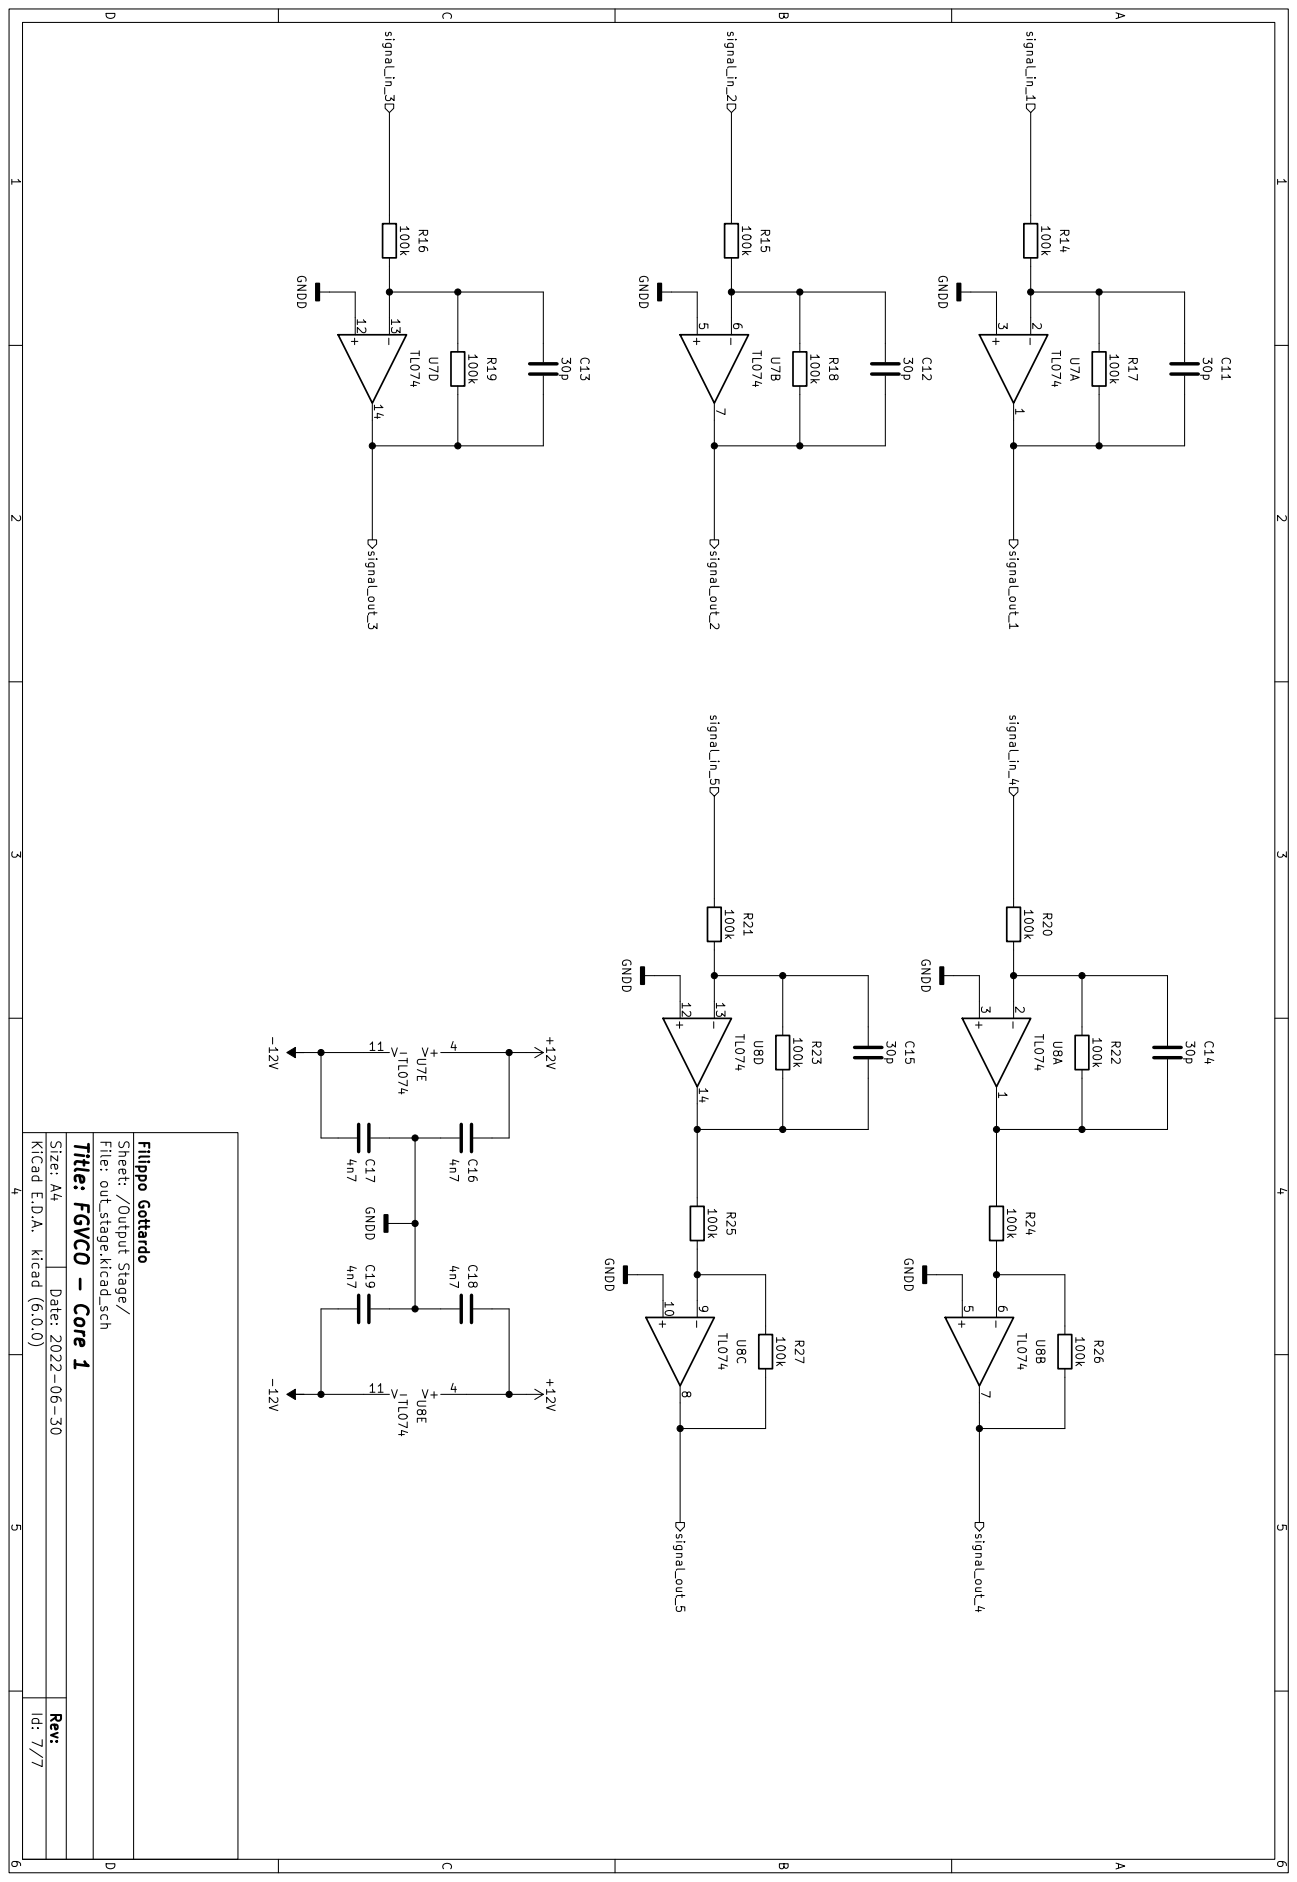
[picture p90: page 51]

3 U8A TL074 GNDD 100k R17 4n7 C17 100k R25 GNDD 4n7 C18 GNDD GNDD

A Date: 2022-06-30 KiCad E.D.A. kicad (6.0.0) Rev: Size: A4 Id: 7/7 Title: FGVCO - Core 1 File: out_stage.kicad_sch Sheet: /Output Stage/ Filippo Gottardo 30p C12 30p C15 100k R26 +

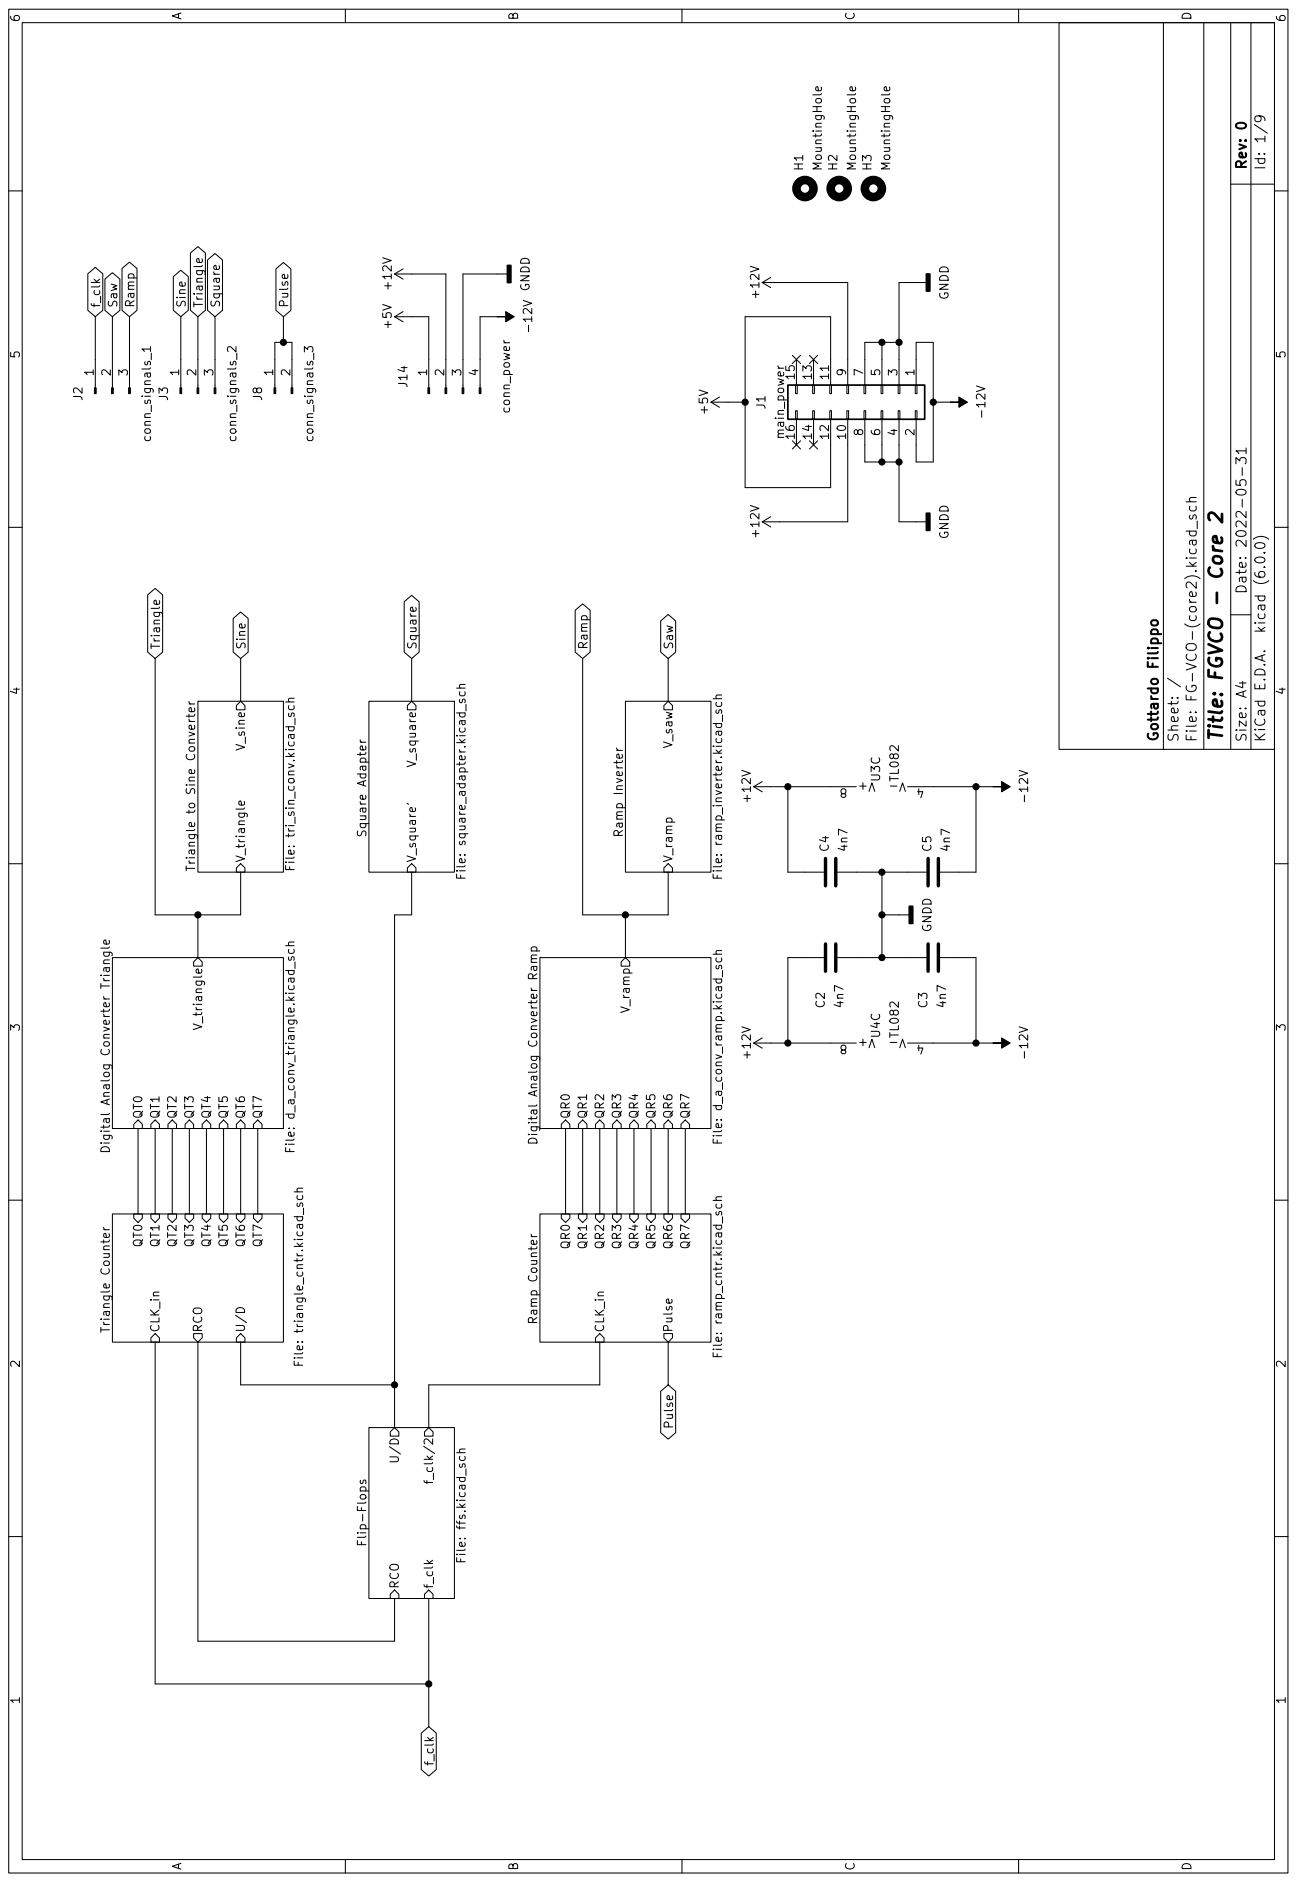
[picture p91: page 52]
2 J8 conn_signals_3 1; 3 J2 conn_signals_1 GNDD -12V C54n7 GNDD C34n7; 9 J1 main_power +12V GNDD; 4 J14 conn_power V- 4 V+ 8 U3C TL082

D Date: 2022-05-31 KiCad E.D.A. kicad (6.0.0) Rev: 0 Size: A4 Id: 1/9 Gottardo Filippo Sheet: / File: FG-VCO-(core2).kicad_sch Title: FGVCO - Core 2 CLK_in RCO U/D QT0 QT1 QT2 QT3 QT4 QT5 QT6 QT7 Triangle Counter File: triangle_cntr.kicad_sch V_triangle QT0 QT1 QT2 QT3 QT4 QT5 QT6 QT7 Digital Analog Converter Triangle File: d_a_conv_triangle.kicad_sch f_clk/2 RCO U/D f_clk Flip-Flops File: ffs.kicad_sch CLK_in QR0 QR1 QR2 QR3 QR4 QR5 QR6 QR7 Pulse Ramp Counter File: ramp_cntr.kicad_sch V_triangle V_sine Triangle to Sine Converter File: tri_sin_conv.kicad_sch V_ramp QR0 QR1 QR2 QR3 QR4 QR5 QR6 QR7 Digital Analog Converter Ramp File: d_a_conv_ramp.kicad_sch V_square V_square' Square Adapter File: square_adapter.kicad_sch V_ramp V_saw Ramp Inverter File: ramp_inverter.kicad_sch +12V H2MountingHole H3MountingHole -12V H1MountingHole C44n7 +12V +5V +12V -12V

3 J3 conn_signals_2 +12V +5V Triangle Sine Ramp f_clk Pulse Saw f_clk Saw Ramp Triangle Square Pulse Square Sine

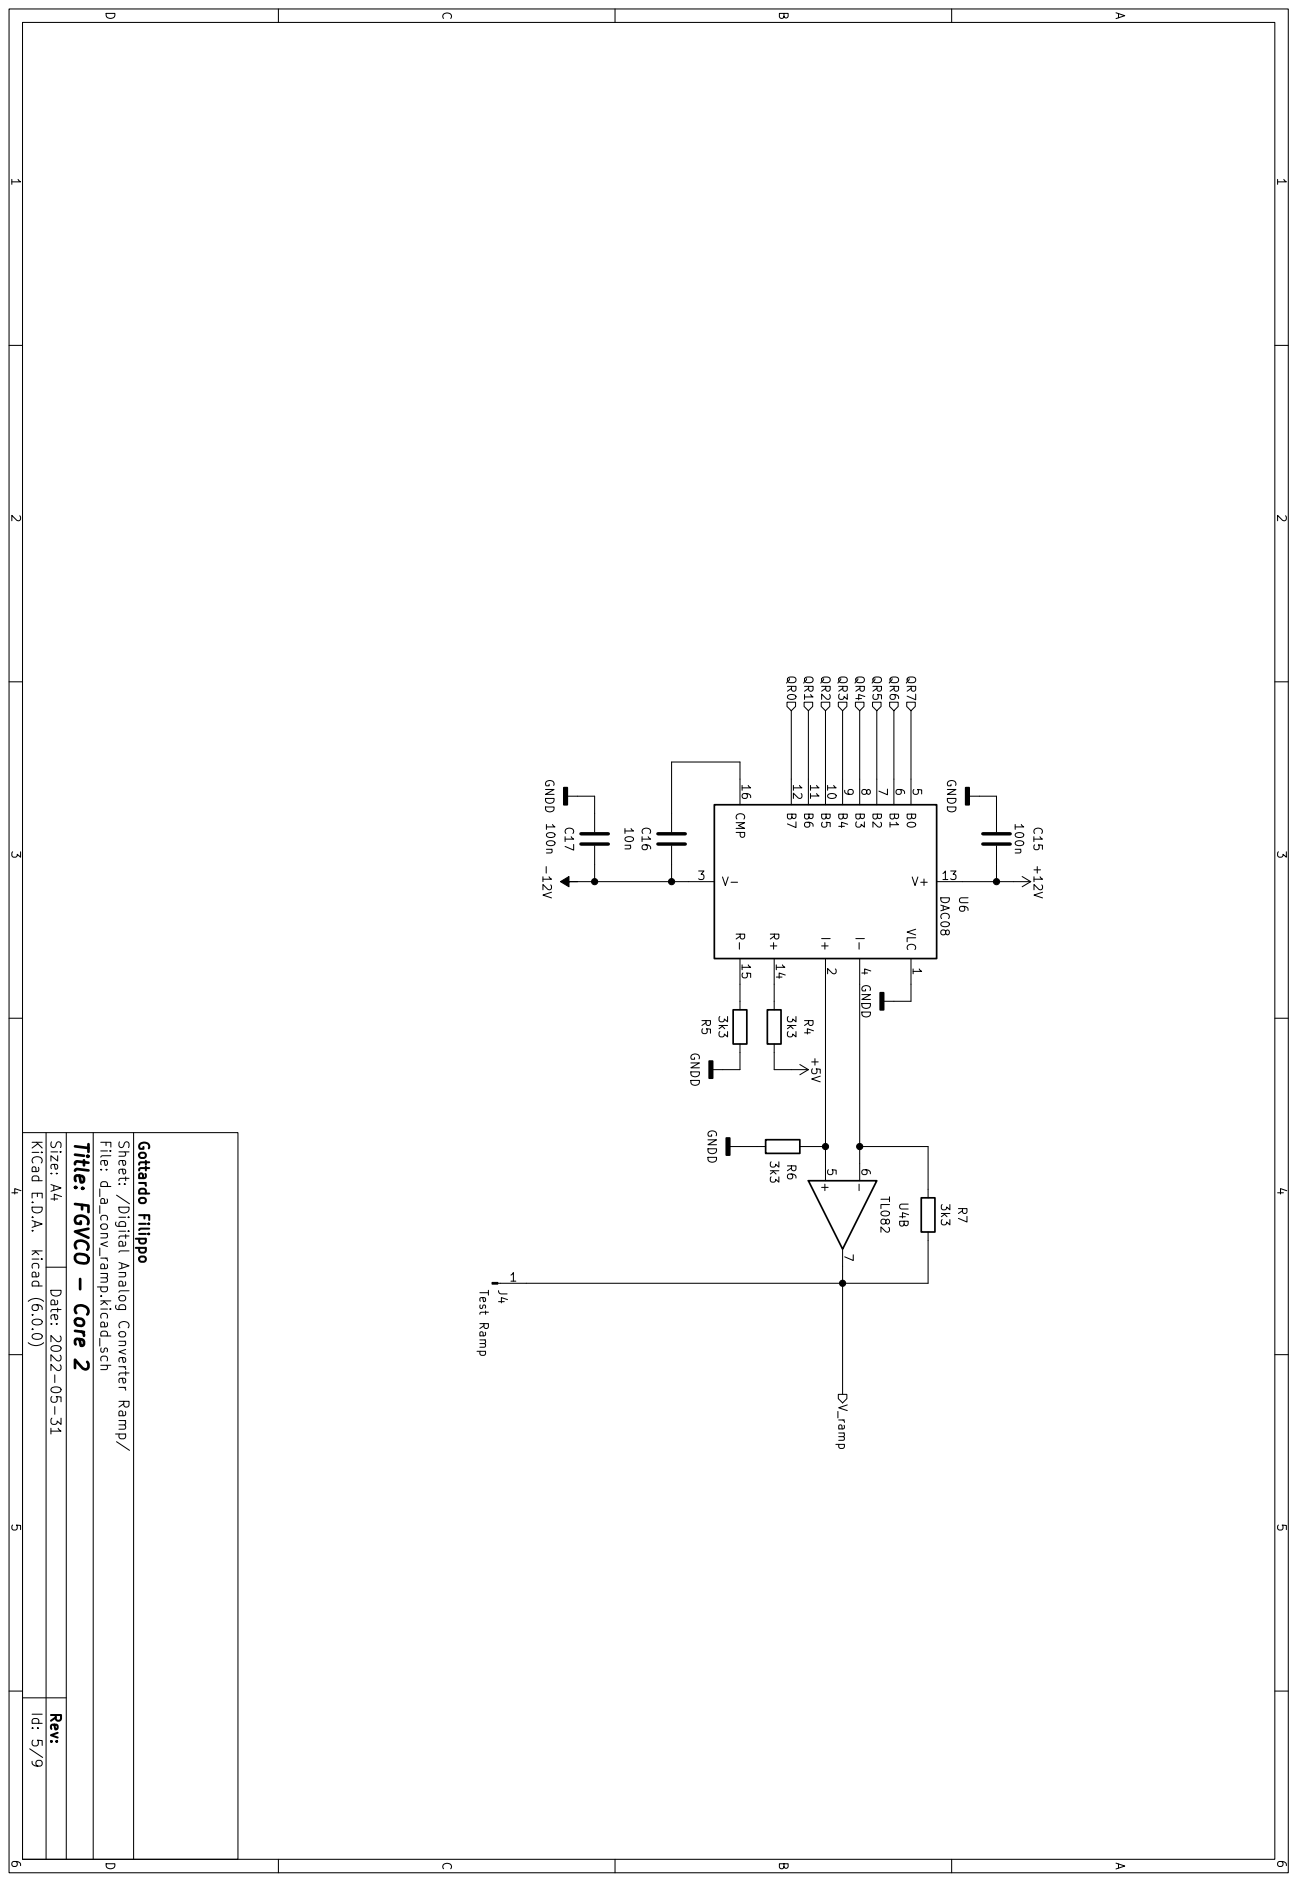
[picture p92: page 53]

A Date: 2022-05-31 KiCad E.D.A. kicad (6.0.0) Rev: Size: A4 Id: 5/9 Title: FGVCO - Core 2 File: d_a_conv_ramp.kicad_sch Sheet: /Digital Analog Converter Ramp/ Gottardo Filippo GNDD R5 3k3 3k3 R6 GNDD

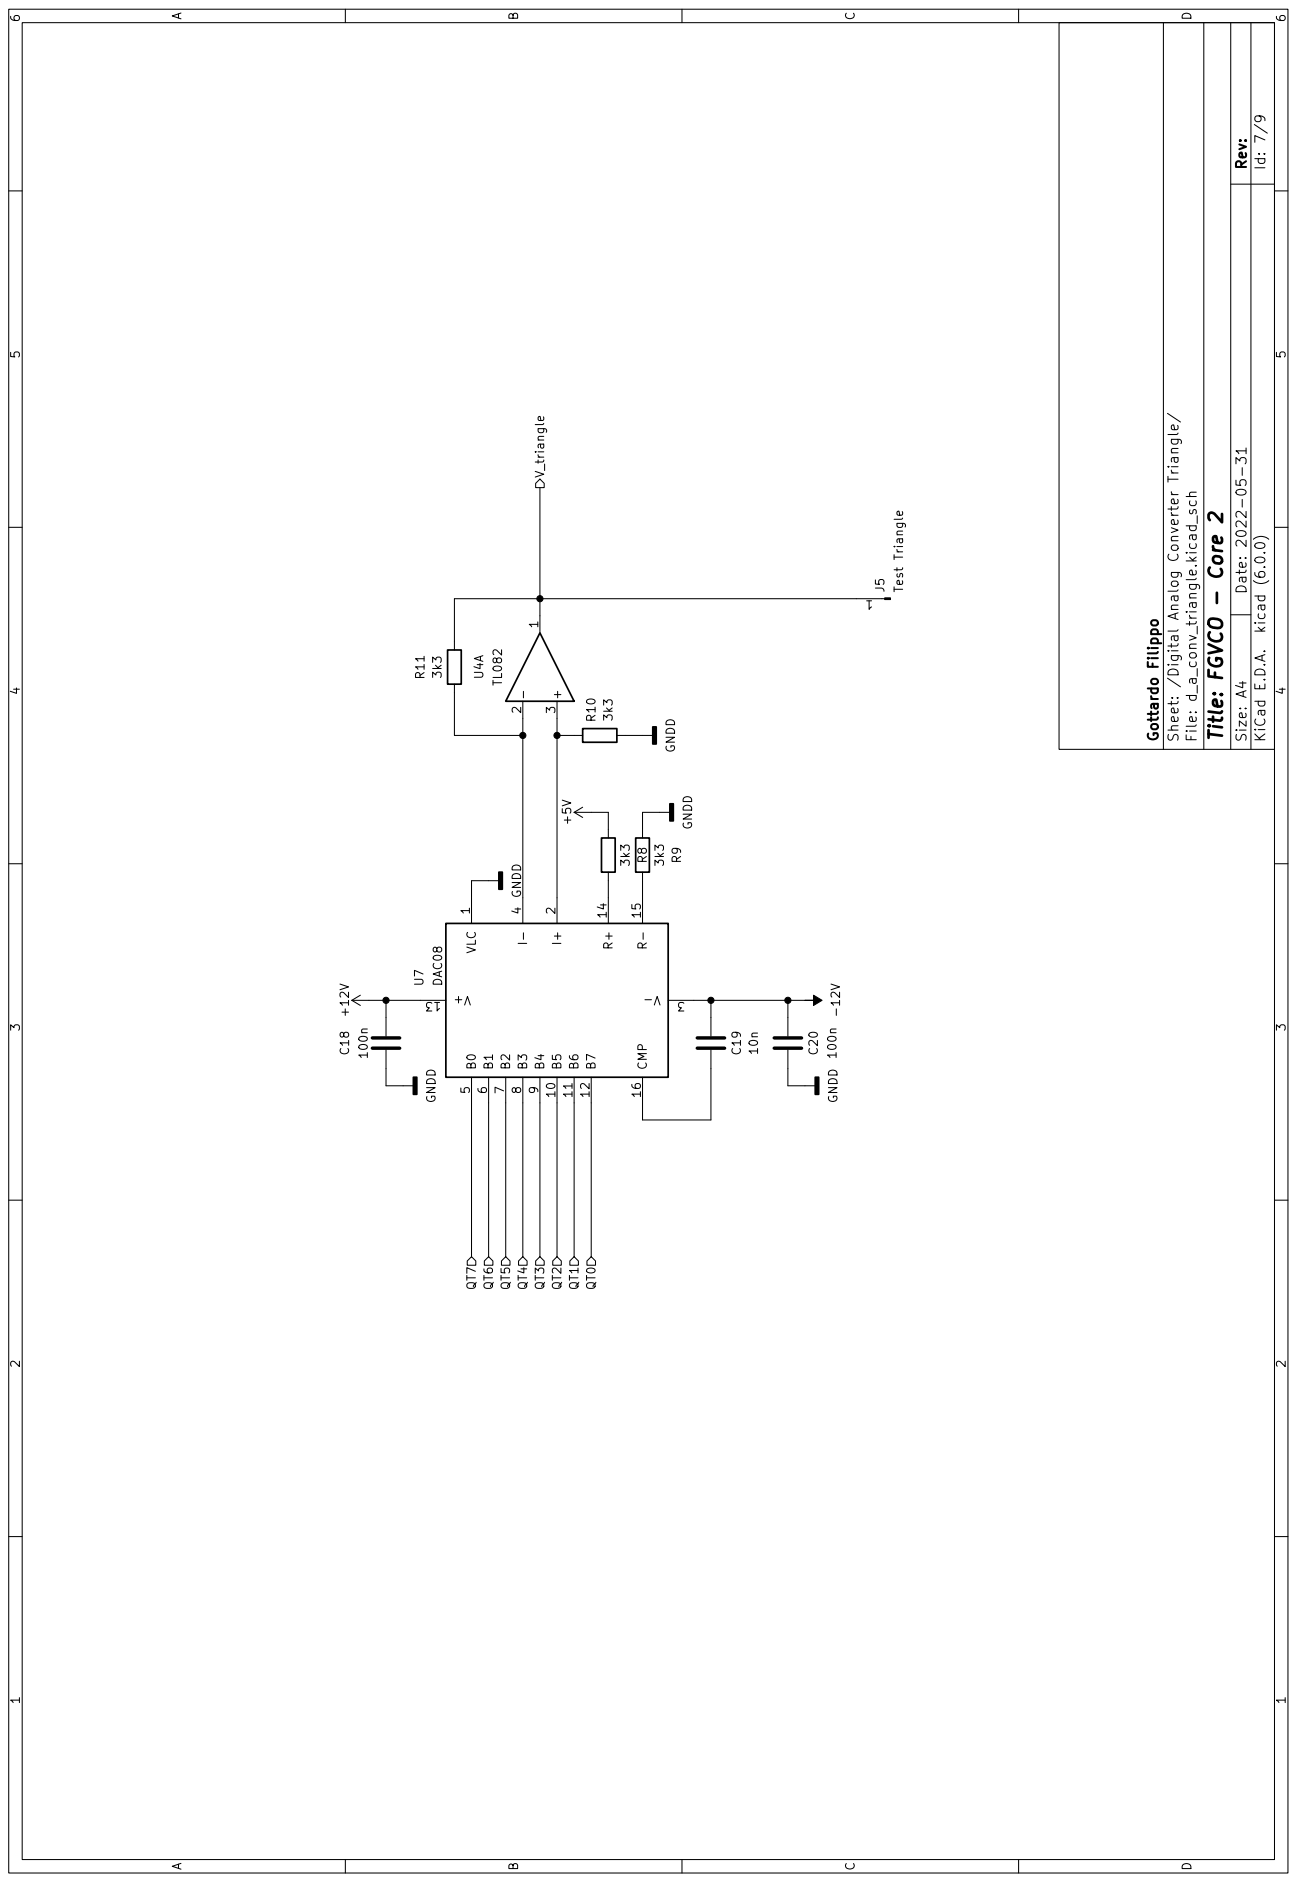
[picture p93: page 54]

D Date: 2022-05-31 KiCad E.D.A. kicad (6.0.0) Rev: Size: A4 Id: 7/9 Gottardo Filippo Sheet: /Digital Analog Converter Triangle/ File: d_a_conv_triangle.kicad_sch Title: FGVCO - Core 2 GNDD

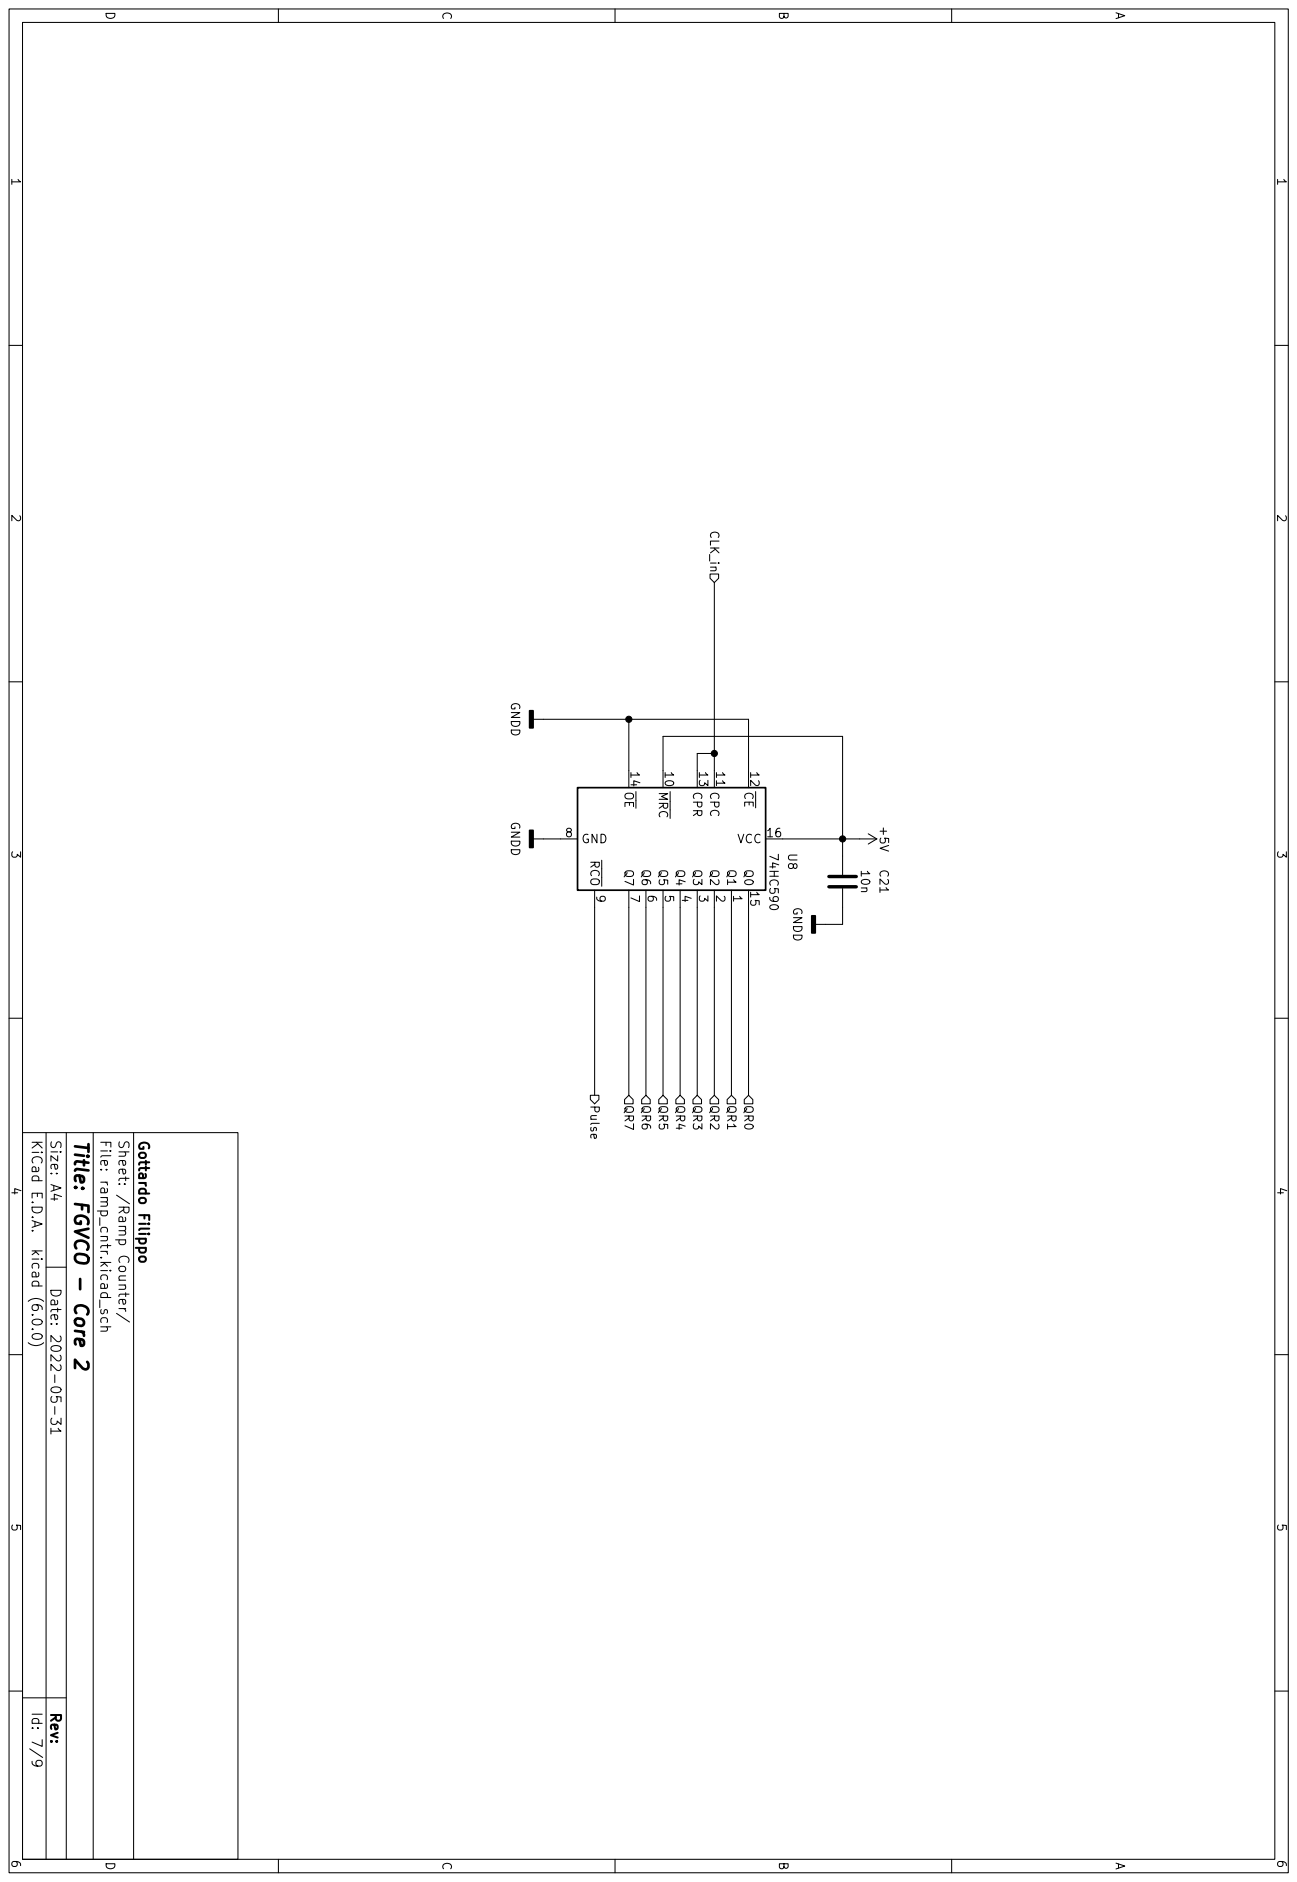
[picture p94: page 55]

7 GND 8 ~{RCO} 9 74HC590 U8 GNDD +5V 10n C21 QR5 CLK_in Pulse QR7 QR6 QR4 QR3 QR2 QR1 QR0

1 ~{MRC} 10 CPC 11 ~{CE} 12 CPR 13 ~{OE} 14 Q0 15 VCC 16 Q2

A Date: 2022-05-31 KiCad E.D.A. kicad (6.0.0) Rev: Size: A4 Id: 7/9 Title: FGVCO - Core 2 File: ramp_cntr.kicad_sch Sheet: /Ramp Counter/ Gottardo Filippo GNDD GNDD Q1

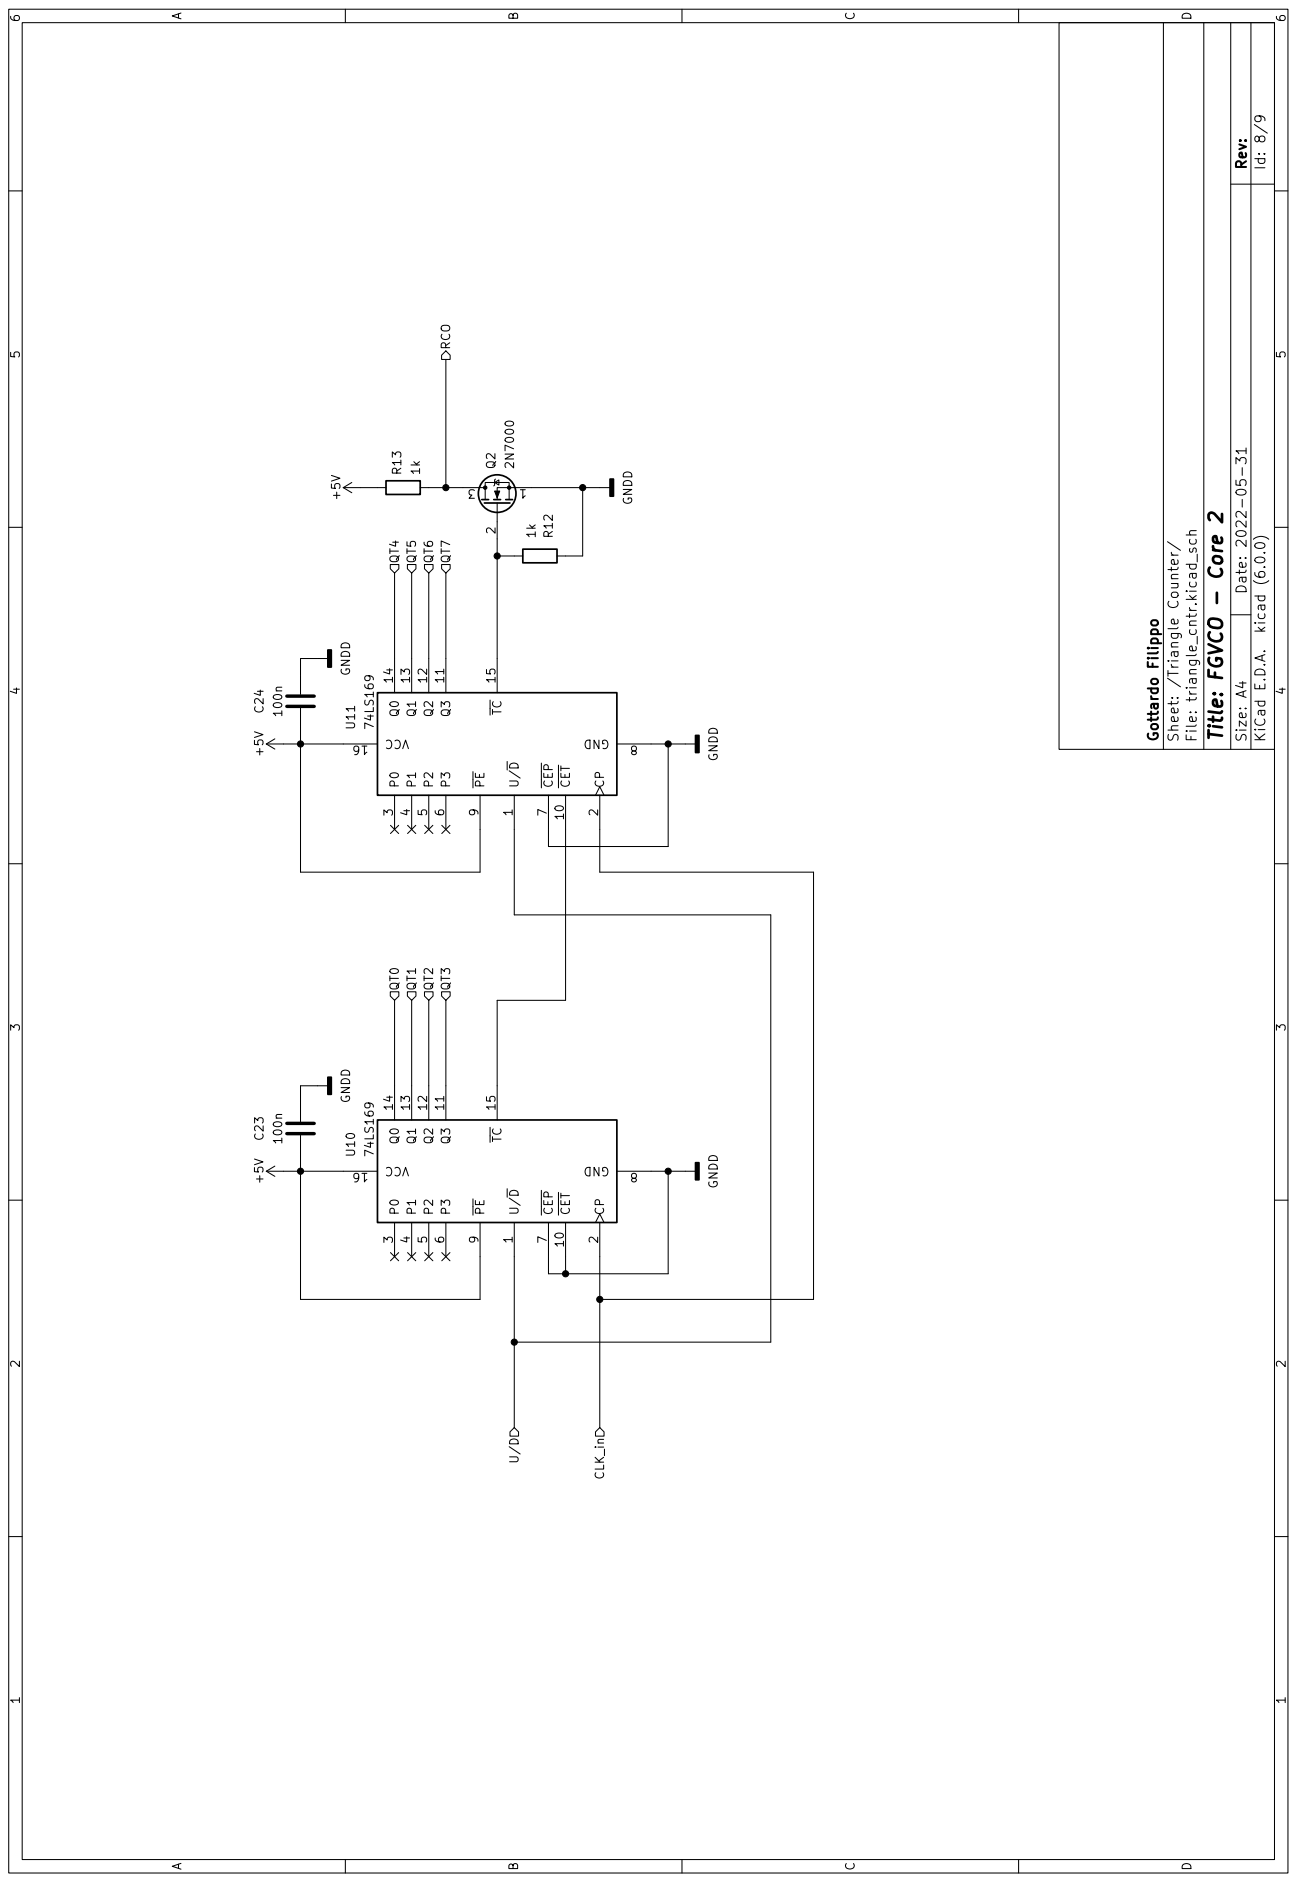
[picture p95: page 56]

D Date: 2022-05-31 KiCad E.D.A. kicad (6.0.0) Rev: Size: A4 Id: 8/9 Gottardo Filippo Sheet: /Triangle Counter/ File: triangle_cntr.kicad_sch Title: FGVCO - Core 2 U/~{D} 1 ~{CET} 10 Q3 11 Q2 12 Q1 13 Q0 14 ~{TC} 15 VCC 16 CP

6 ~{CEP} 7 GND 8 ~{PE} 9 U11 74LS169 +5V GNDD QT0 QT3 RCO QT4 QT5 QT6 QT7 QT1 QT2 U/D CLK_in

6 ~{CEP} 7 GND 8 ~{PE} 9 U10 74LS169 GNDD 1kR12

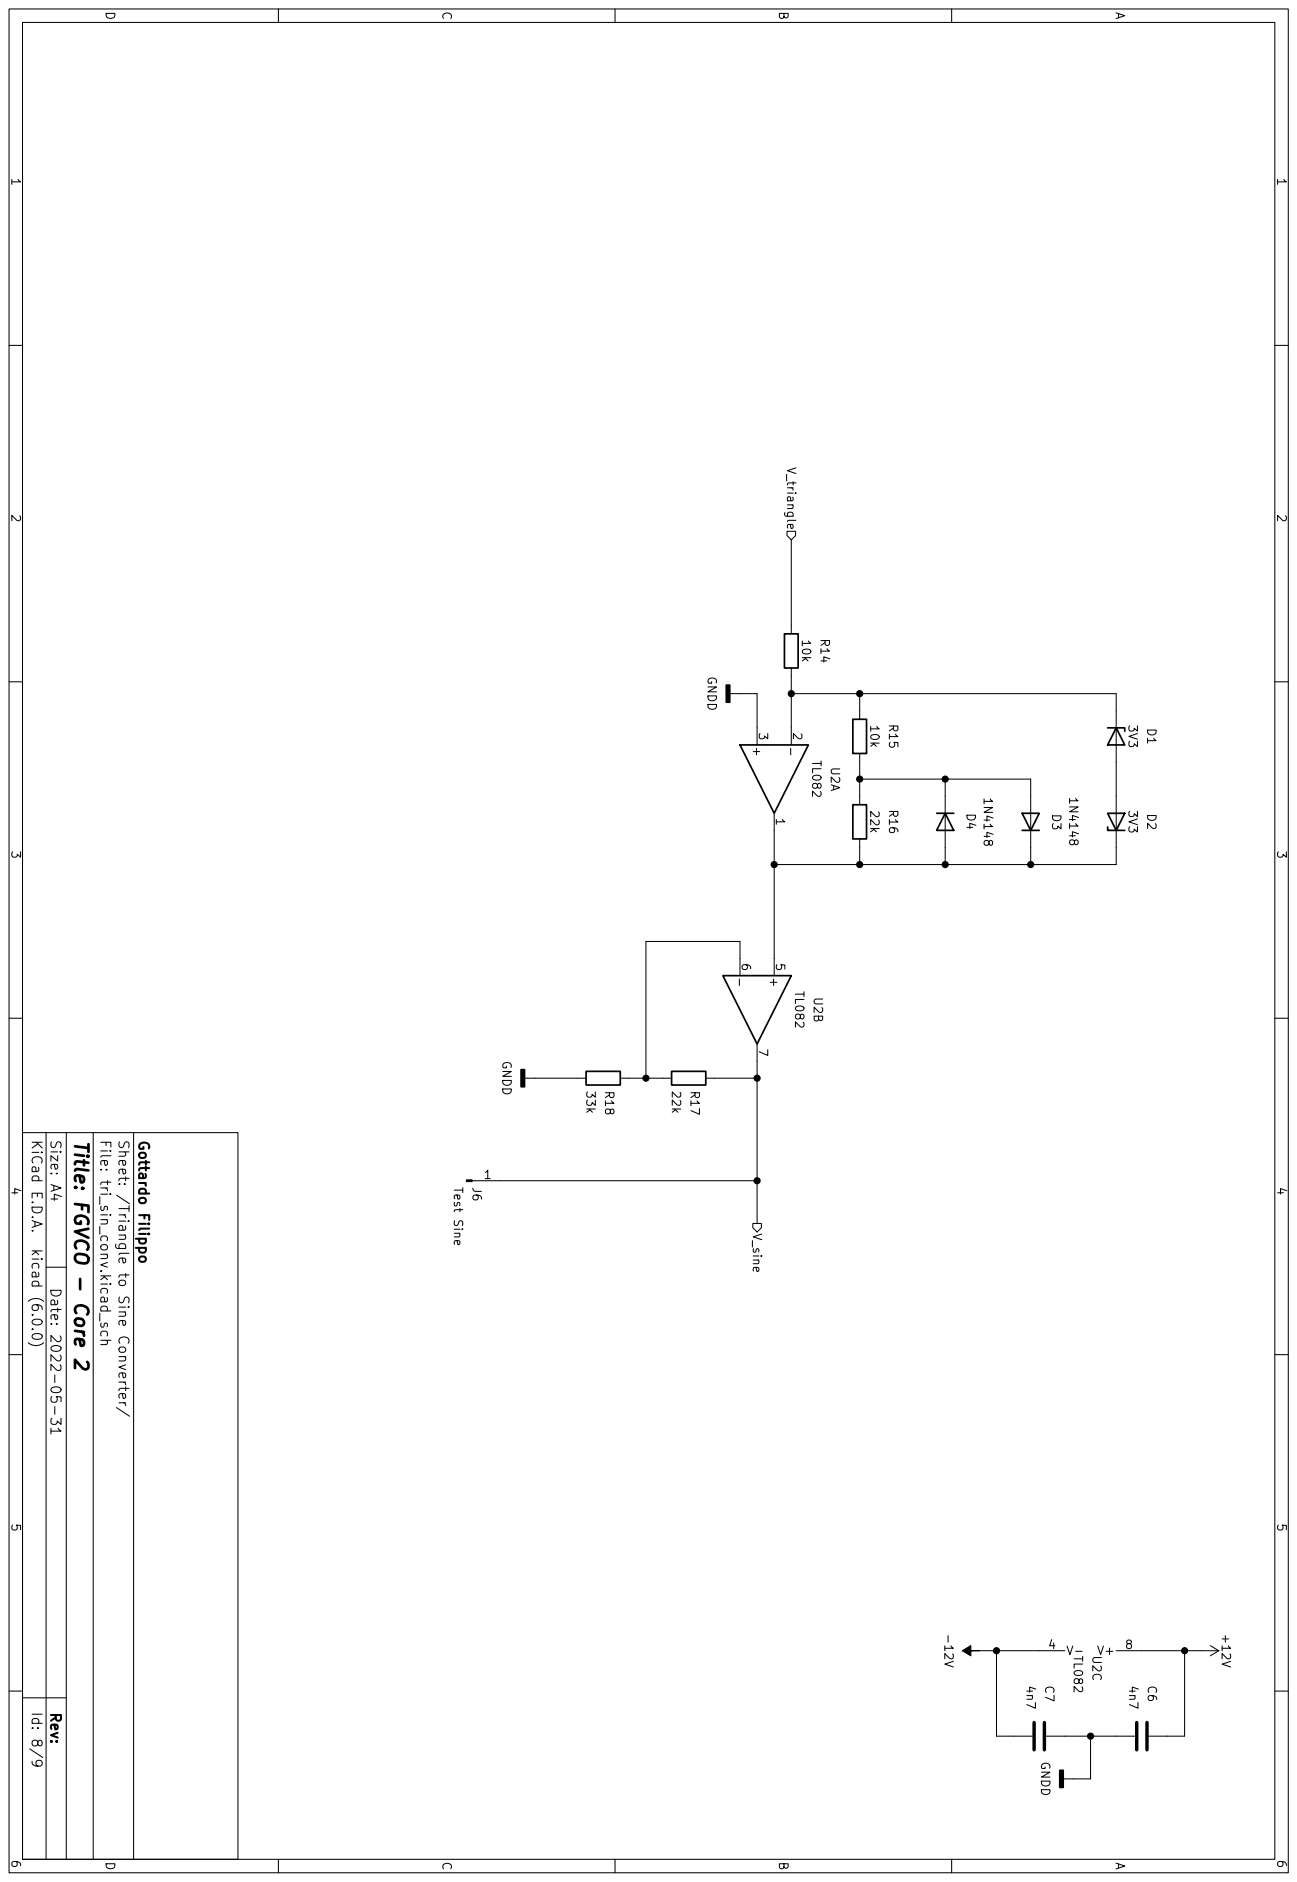
[picture p96: page 57]

A Date: 2022-05-31 KiCad E.D.A. kicad (6.0.0) Rev: Size: A4 Id: 8/9 Title: FGVCO - Core 2 File: tri_sin_conv.kicad_sch Sheet: /Triangle to Sine Converter/ Gottardo Filippo 4n7 C7 3V3 D2 4n7 C6 V- 4 V+ 8 TL082 U2C -12V 10k R14

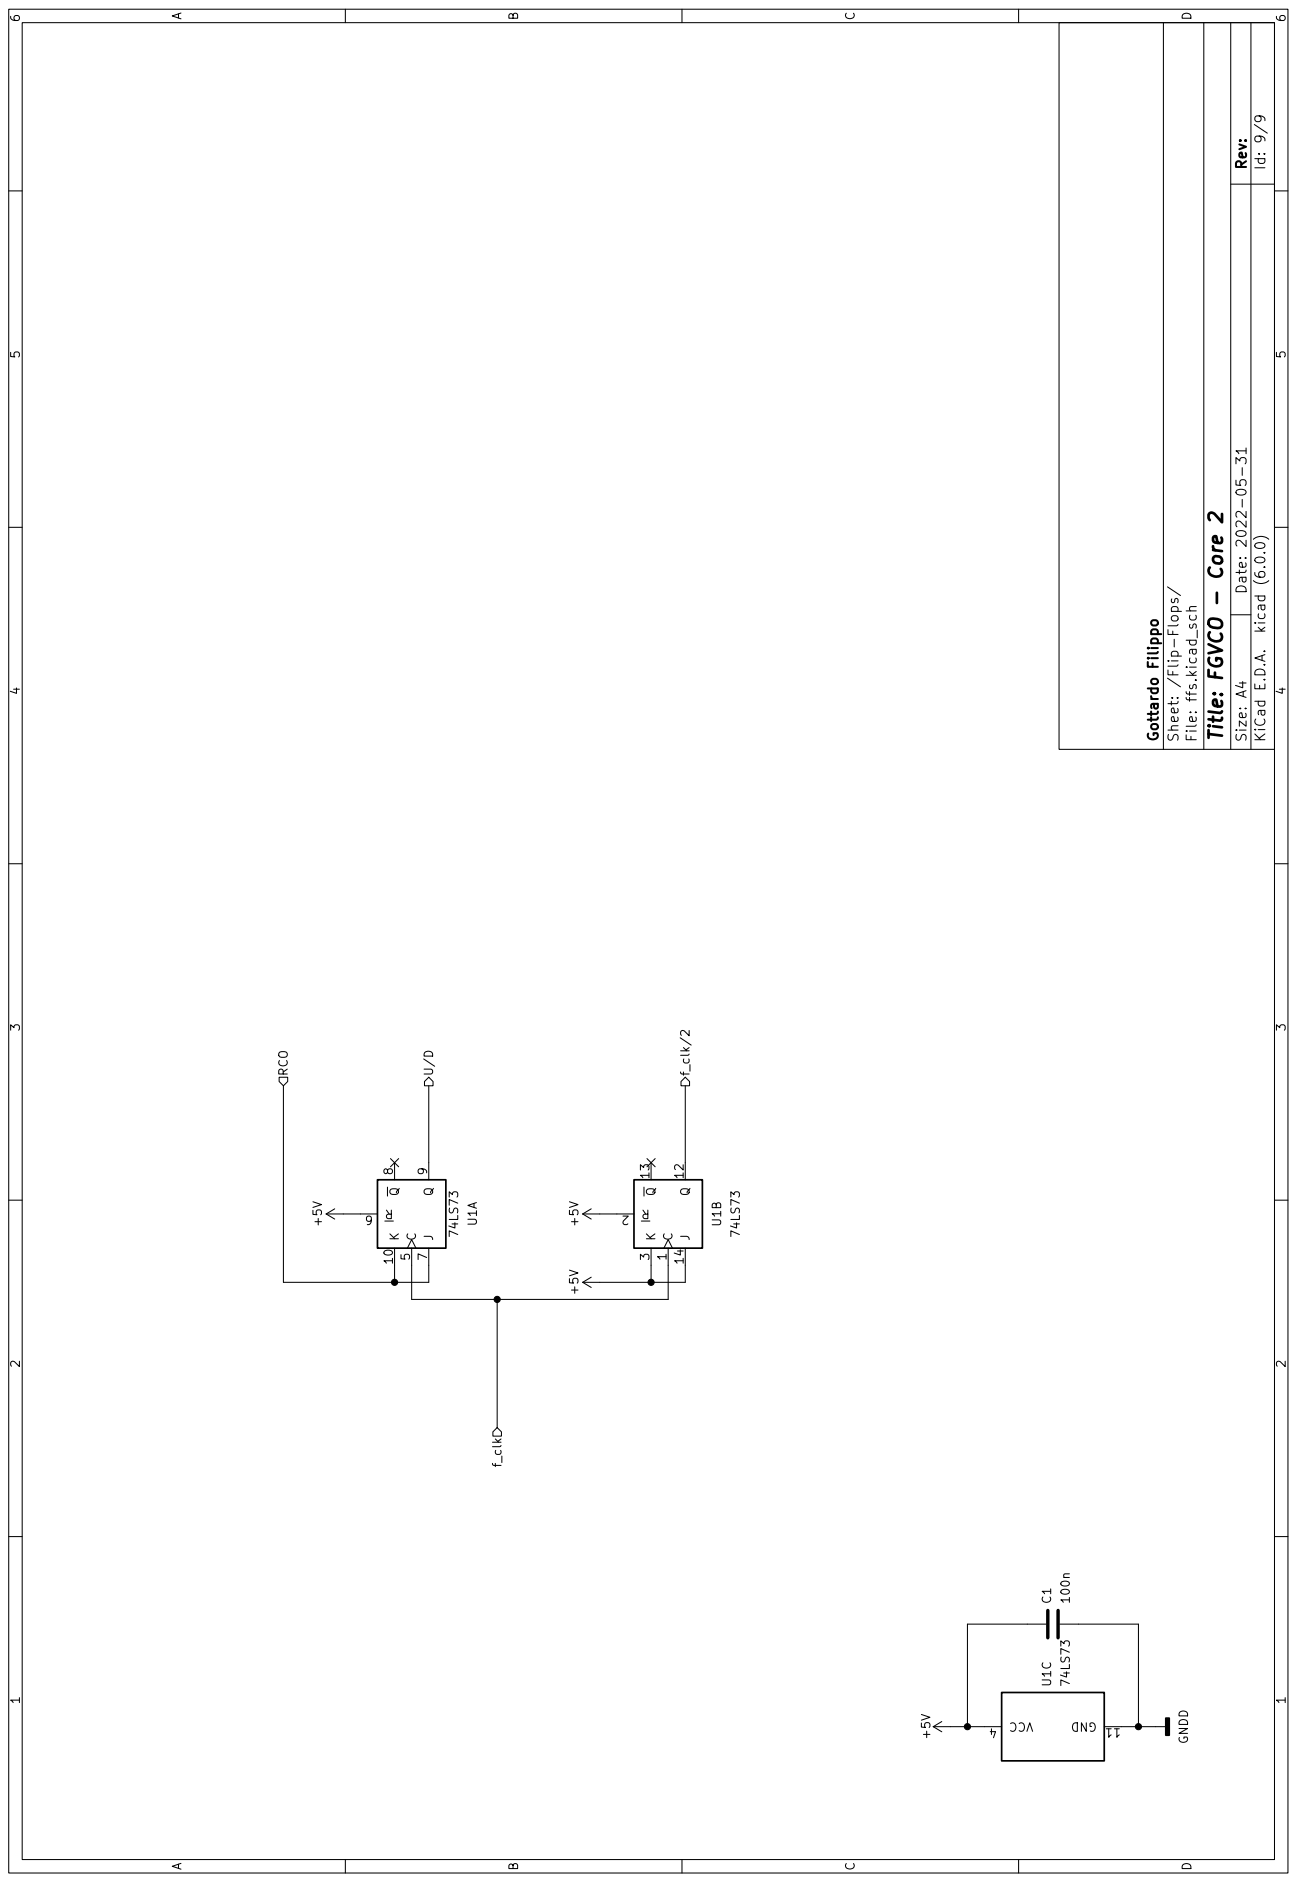
[picture p97: page 58]

D Date: 2022-05-31 KiCad E.D.A. kicad (6.0.0) Rev: Size: A4 Id: 9/9 Gottardo Filippo Sheet: /Flip-Flops/ File: ffs.kicad_sch Title: FGVCO - Core 2 +5V +5V GNDD

9 U1A 74LS73 GND 11 VCC 4 U1C 74LS73 +5V C1100n +5V U/D f_clk/2 f_clk RCO

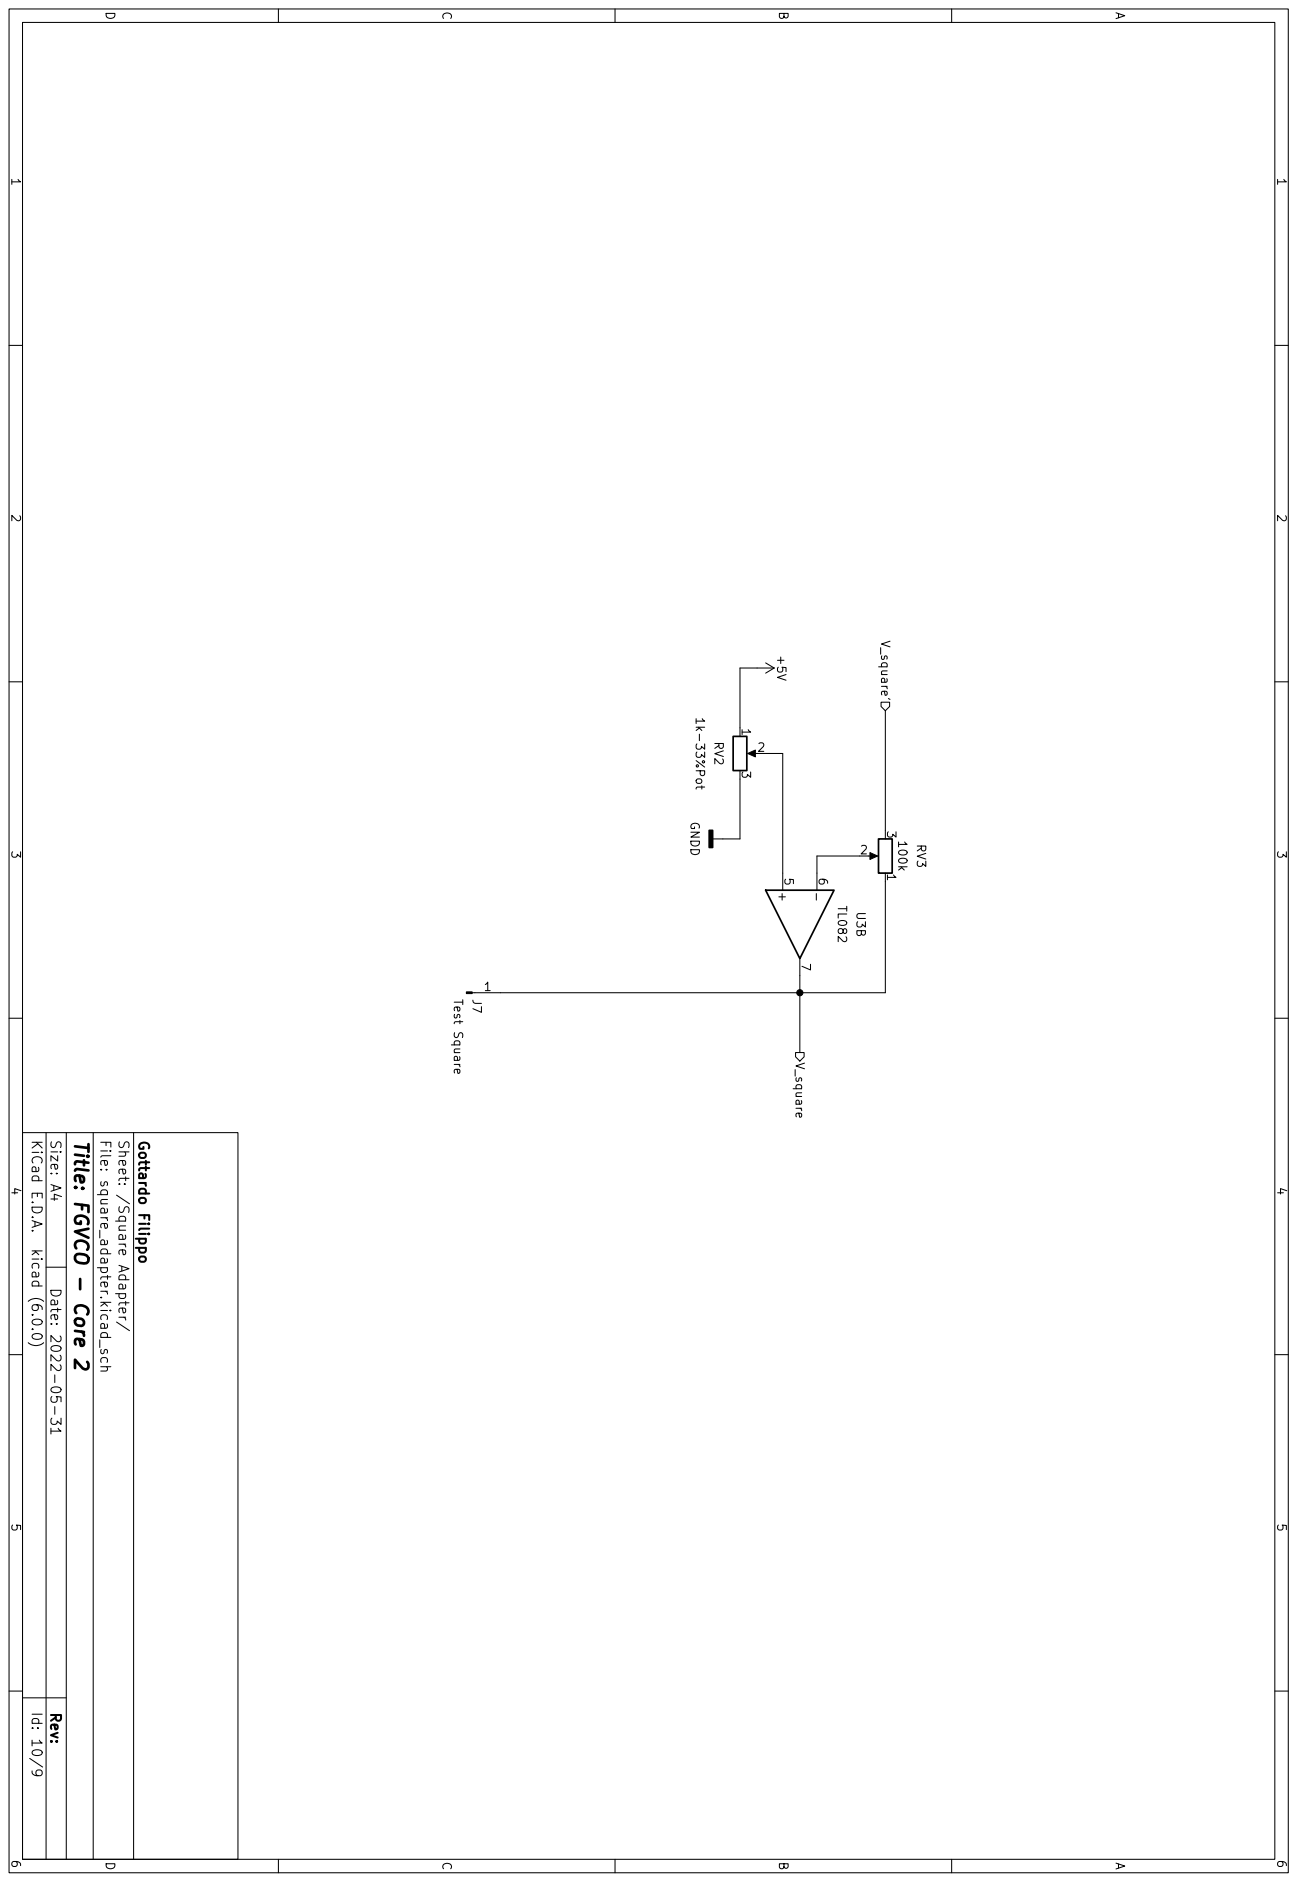
[picture p98: page 59]
3 RV2 1k-33%Pot GNDD; 1 Test Square J7; +5V V_square; V_square'

A Date: 2022-05-31 KiCad E.D.A. kicad (6.0.0) Rev: Size: A4 Id: 10/9 Title: FGVCO - Core 2 File: square_adapter.kicad_sch Sheet: /Square Adapter/ Gottardo Filippo

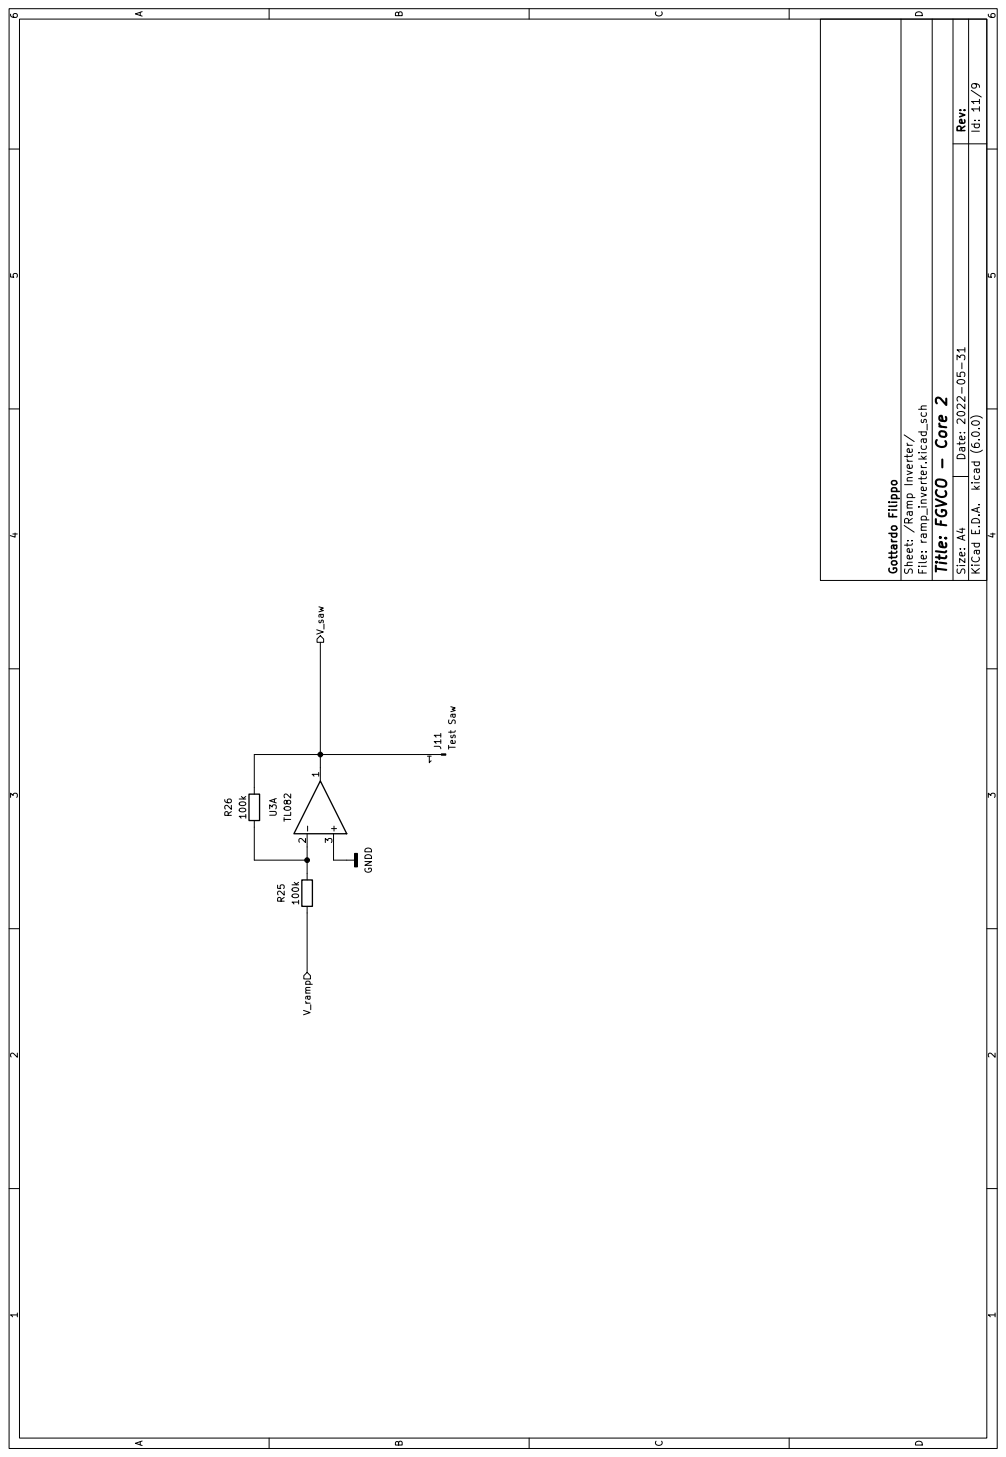
[picture p99: page 60]
3 U3A TL082 R25 100k V_saw V_ramp

D Date: 2022-05-31 KiCad E.D.A. kicad (6.0.0) Rev: Size: A4 Id: 11/9 Gottardo Filippo Sheet: /Ramp Inverter/ File: ramp_inverter.kicad_sch Title: FGVCO - Core 2

# Bibliografia

[1] Doepfer. Technical Details A-100. Ultimo accesso: 10 agosto 2022. URL:

https://doepfer.de/a100 man/a100t e.htm.

[2] Texas Instruments. 8-Bit Binary Counter With 3-State Output Registers. SN54HC590A,

SN74HC590A. Rev. F. 15 Sep 2003. URL:

https://www.ti.com/lit/ds/symlink/sn74hc590a.pdf?ts=1660052021803&ref url=https

%253A%252F%252Fwww.ti.com%252Fproduct%252FSN74HC590A%253FDCM%2

53Dyes%2526utm source%253Dsupplyframe%2526utm medium%253DSEP%2526ut

m campaign%253Dnot alldatasheet%2526dclid%253DCjkKEQjwi8iXBhCH4qTo0e

HB5a4BEiQAcEheL4orR2IcXezk9QUTg0VBEO06AO8X78kbvVsHNjYh-K7w wcB.

[3] Texas Instruments. 8-Bit Digital-to-Analog Converters. DAC0800/DAC0802. Rev. C. 19

Feb 2013. URL: https://www.ti.com/lit/ds/symlink/dac0800.pdf?ts=1660056823024&re

f url=https%253A%252F%252Fwww.google.com%252F.

[4] Texas Instruments. High Frequency Voltage-to-Frequency Converter. VFC110. Rev. A.

25 Apr 2007. URL: https://www.ti.com/lit/ds/symlink/vfc110.pdf?ts=1660083698490&r

ef url=https%253A%252F%252Fwww.ti.com%252Fproduct%252FVFC110%253Fkey

Match%253DVFC110.

[5] Texas Instruments. High Speed CMOS Logic Dual Negative-Edge-Triggered J-K

Flip-Flops with Reset. CDx4HC73, CD74HCT73. 31 Jan 2022. URL:

https://www.ti.com/lit/ds/symlink/cd74hc73.pdf?ts=1660083349727&ref url=https%25

3A%252F%252Fwww.ti.com%252Fproduct%252FCD74HC73%253FkeyMatch%253

DCD74HC73%2526tisearch%253Dsearch-everything%2526usecase%253DGPN.

[6] Texas Instruments. Low-Noise FET-Input Operational Amplifiers. TL07xx. Rev. T. 13

Dec 2021. URL:

https://www.ti.com/lit/ds/symlink/tl074a.pdf?ts=1660083674764&ref url=https%253

A%252F%252Fwww.ti.com%252Fproduct%252FTL074A%253FkeyMatch%253D%2

526tisearch%253Dsearch-everything%2526usecase%253Dpartmatches.

[7] Texas Instruments. Precision voltage-to-frequency converter with 1-Hz to 100-kHz full

scale frequency. LMx31x. Rev. C. 29 Sep 2015. URL: https://www.ti.com/lit/ds/symlink

/lm331.pdf?ts=1660083454622&ref url=https%253A%252F%252Fwww.ti.com%252

Fproduct%252FLM331%253FkeyMatch%253DLM331.

[8] Texas Instruments. QUADRUPLE 2-INPUT POSITIVE-AND GATES. SN5408,

SN54LS08, SN54S08, SN7408, SN74LS08, SN74S08. 1Mar 1988. URL:

https://www.ti.com/lit/ds/symlink/sn74ls08.pdf?ts=1661379490726&ref url=https%25

3A%252F%252Fwww.ti.com%252Fproduct%252FSN74LS08%253Futm source%253

Dgoogle%2526utm medium%253Dcpc%2526utm campaign%253Dti-null-null-xref-c

pc-pf-google-wwe%2526utm content%253Dxref%2526ds k%253D%257B dssearchte

rm%257D%2526DCM%253Dyes%2526gclid%253DCjwKCAjwmJeYBhAwEiwAXlg

0Aa 9D-sACXc-gpl01iURjVXQdWT2ZSrZghJtczUhFIQMyQ-B2xQ6IRoCQXoQAv

D BwE%2526gclsrc%253Daw.ds.

[9] Texas Instruments. Synchronous 4-Bit Up/Down Binary Counters. SN54LS169B,

SN54S169, SN74LS169B, SN74S169. 1Mar 1988. URL: https://www.ti.com/lit/ds/syml

ink/sn74ls169b.pdf?ts=1660083375741&ref url=https%253A%252F%252Fwww.ti.co

m%252Fproduct%252FSN74LS169B%253FkeyMatch%253DSN74LS169B%2526tise

arch%253Dsearch-everything%2526usecase%253DGPN.

[10] Texas Instruments. xx555 Precision Timers. NA555, NE555, SA555, SE555. Rev. I. 15

Sep 2014. URL: https://www.ti.com/lit/ds/symlink/ne555.pdf?ts=1661442775145&ref u

rl=https%253A%252F%252Fwww.ti.com%252Fproduct%252FNE555.

[11] Schmitz Rene.´ Voltage controlled oscillators. Ultimo accesso: 10 agosto 2022. March

1999. URL: https://www.schmitzbits.de/vco2.html.

[12] Central Semiconductor. SILICON NPN QUAD TRANSISTOR. MPQ3904. Rev. 2. 25

September 2018. URL: https://my.centralsemi.com/datasheets/MPQ3904.PDF.

[13] ON Semiconductor. N-Channel Enhancement Mode Field Effect Transistor 60V,

200mA, 5 ohm. 2N7000, 2N7002, NDS7002A. Rev. 7. July 2022. URL:

https://www.onsemi.com/pdf/datasheet/nds7002a-d.pdf.

[14] NXP Semiconductors. High-speed diodes. 1N4148; 1N4448. 2004 Aug 10. URL:

https://assets.nexperia.com/documents/data-sheet/1N4148 1N4448.pdf.
