PippoGot/FGVCO/Elaborato Scritto/chapters/ch05-segnali_secondari.tex

\chapter{Generazione dei Segnali Secondari}\label{segnali_secondari}

%--------------------------------------------------------------------------------------------

Ora passiamo alla progettazione dei circuiti per la generazione dei segnali mancanti, sfruttando
quelli principali generati al capitolo \ref{segnali_principali}.

%--------------------------------------------------------------------------------------------

\section{Dente di Sega}

%--------------------------------------------------------------------------------------------

Il più semplice da generare è sicuramente il dente di sega in quanto tutto quello che serve è un
normale amplificatore invertente con guadagno pari a uno.

\begin{figure}[H]
    \centering
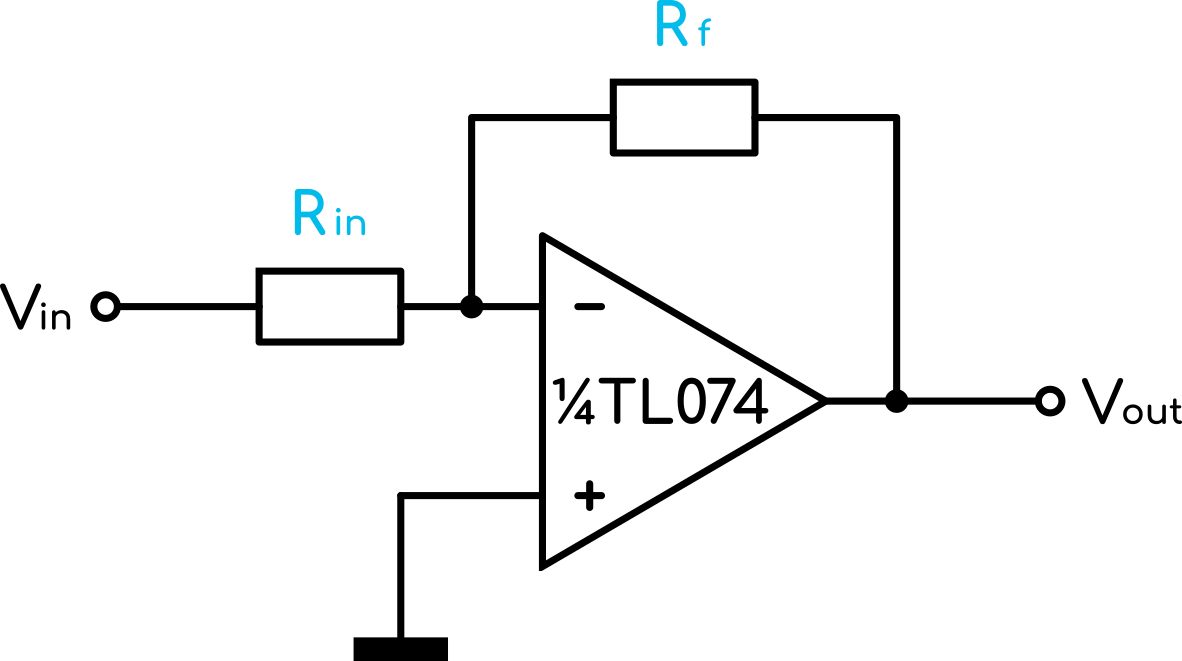
[picture p126: Elaborato Scritto/images/circuits/inverting_amp_circuit.png]
    
    \caption{Schema dell'amplificatore invertente}
    \label{inverting_amp_circuit}
\end{figure}

Come sempre l'operazionale utilizzato è un TL074.

Dalla relazione dell'amplificatore invertente vediamo che per avere un guadagno unitario si
deve porre la resistenza di feedback uguale a quella di ingresso, $R_{in}=R_f$.

\begin{equation}
    V_{out}=-V_{in}\frac{R_{in}}{R_f}=-V_{in}\ [V]
\end{equation}

Questo è quanto ottenuto in uscita:

\begin{figure}[H]
    \centering

    \begin{subfigure}{.5\textwidth}
        \centering
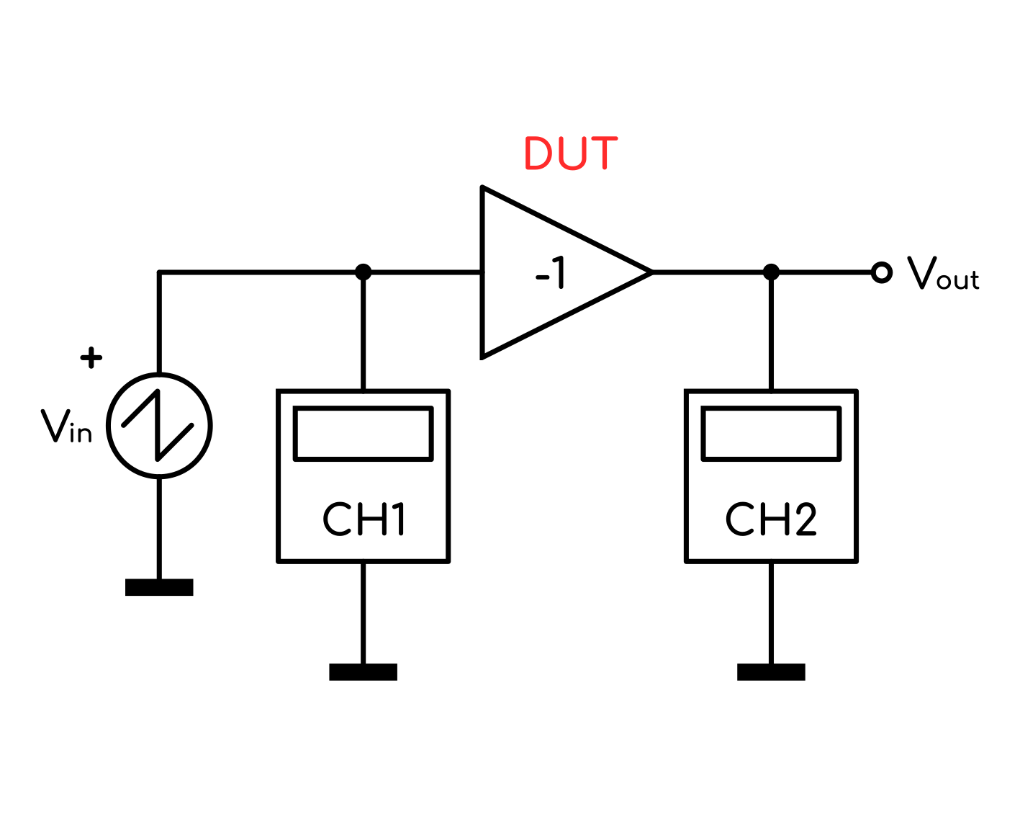
[picture p127: Elaborato Scritto/images/block_diagrams/mis_saw.png]
        
        \caption{Setup di misura}
        \label{mis_saw}
    \end{subfigure}%
    \begin{subfigure}{.5\textwidth}
        \centering
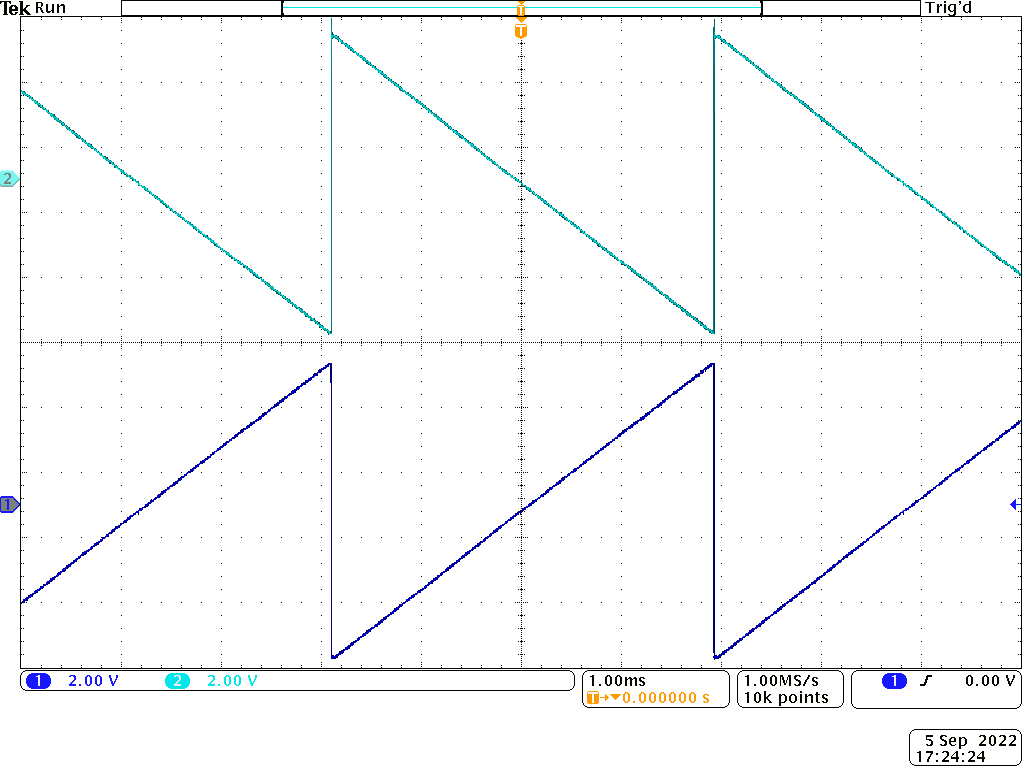
[picture p128: Elaborato Scritto/images/acquisitions/saw_wave.png]
        
        \caption{Acquisizione dell'onda ottenuta}
        \label{acq_saw}
    \end{subfigure}

    \caption{Misura del segnale a dente di sega}
\end{figure}

%--------------------------------------------------------------------------------------------

\section{Onda Quadra}

%--------------------------------------------------------------------------------------------

Anche l'onda quadra risulta piuttosto semplice da generare, in quanto è necessario solo
aggiungere un offset e un guadagno al segnale utilizzato per il pilotaggio del contatore
bidirezionale, ovvero $U/D$. Tale segnale infatti ha già forma e frequenza desiderate,
l'onda è però compresa solo tra $0\ V$ e $+5\ V$, e si deve invece estendere fino a $-5\ V$.
Si utilizza allora un altro amplificatore invertente con uno schema leggermente diverso dai
precedenti:

\begin{figure}[H]
    \centering
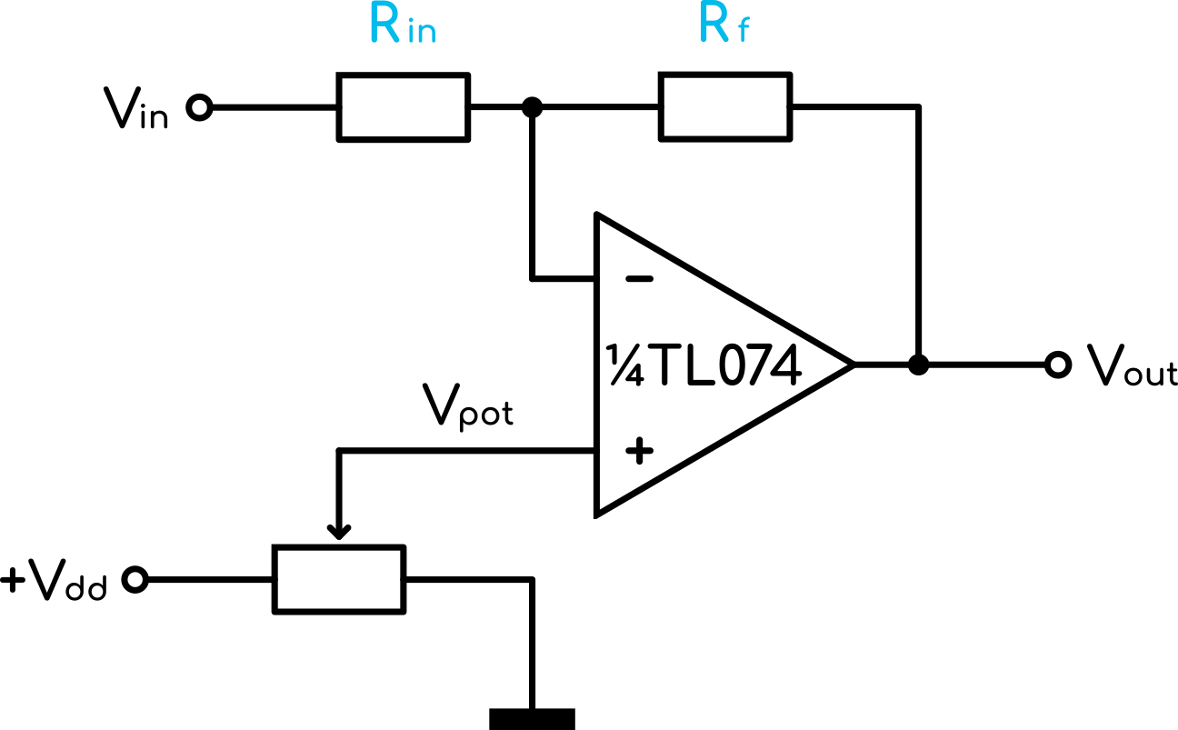
[picture p129: Elaborato Scritto/images/circuits/inverting_amp_offset_circuit.png]
    
    \caption{Schema dell'amplificatore invertente con offset ($+V_{dd}=+5\ V$)}
    \label{inverting_amp_offset_circuit}
\end{figure}

in cui si utilizzano due trimmer per la regolazione precisa di guadagno e offset.

La relazione ingresso/uscita è:

\begin{equation}
    V_{out}=V_{pot}\left(1+\frac{R_f}{R_{in}}\right)-V_{in}\frac{R_f}{R_{in}}\ [V]
\end{equation}

dove si vede chiaramente che $-\frac{R_f}{R_{in}}$ è il guadagno e $V_{pot}\left(1+\frac{R_f}{R_{in}}\right)$
l'offset.

La forma d'onda osservata in uscita è dunque la seguente:

\begin{figure}[H]
    \centering

    \begin{subfigure}{.5\textwidth}
        \centering
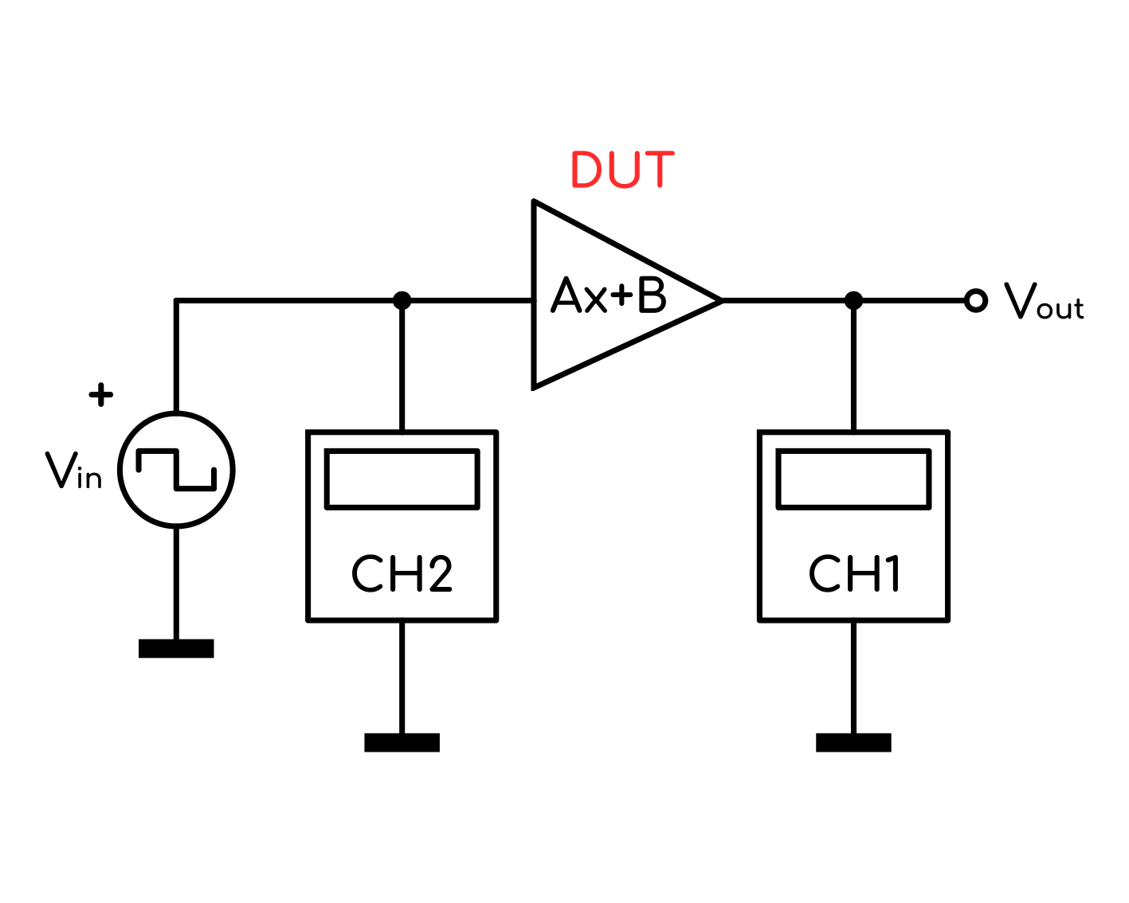
[picture p130: Elaborato Scritto/images/block_diagrams/mis_square.png]
        
        \caption{Setup di misura}
        \label{mis_square}
    \end{subfigure}%
    \begin{subfigure}{.5\textwidth}
        \centering
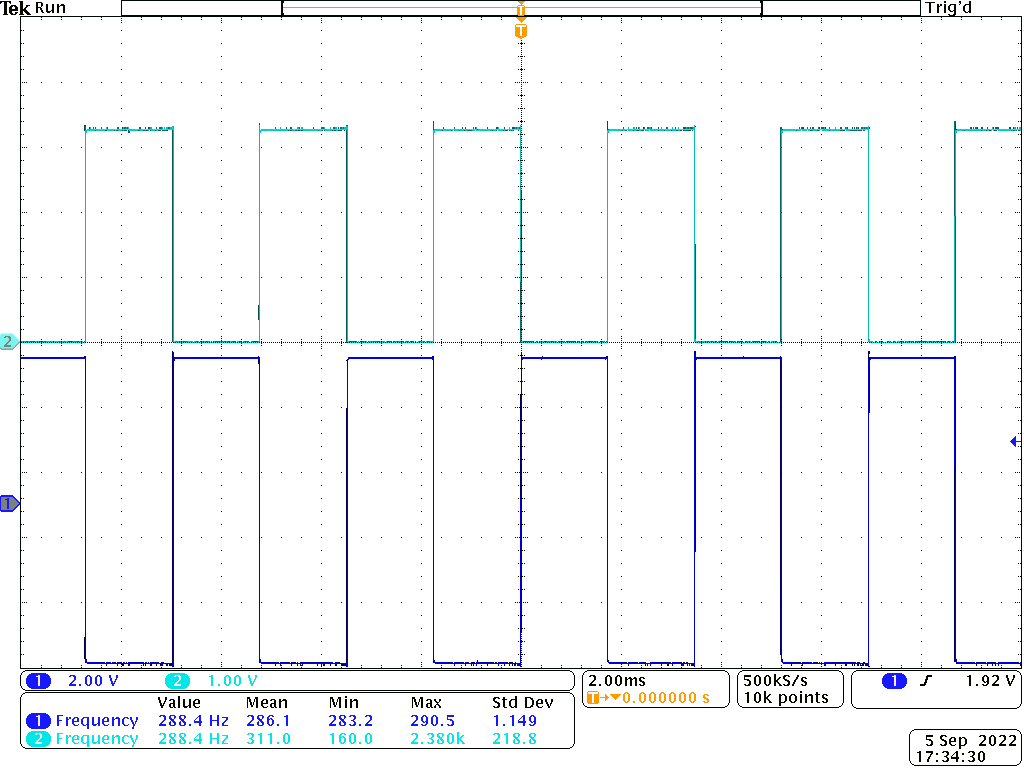
[picture p131: Elaborato Scritto/images/acquisitions/square_wave.png]
        
        \caption{Acquisizione dell'onda ottenuta}
        \label{acq_square}
    \end{subfigure}

    \caption{Misura del segnale a onda quadra ottenuto}
\end{figure}

%--------------------------------------------------------------------------------------------

\section{Impulso}

%--------------------------------------------------------------------------------------------

Per quanto riguarda l'impulso invece, facciamo uso del segnale $RCO$ ricavato al capitolo
\ref{segnali_principali}, figura \ref{ramp_counter_circuit}. Tale segnale viene portato in
ingresso ad un circuito monostabile realizzato con il celebre NE555 \cite{ne555} che si
occuperà di invertire la logica dell'impulso. Lo schema utilizzato, è riportato in figura
\ref{monostable_circuit} e viene preso da pg.10 del relativo datasheet.

\begin{figure}[H]
    \centering
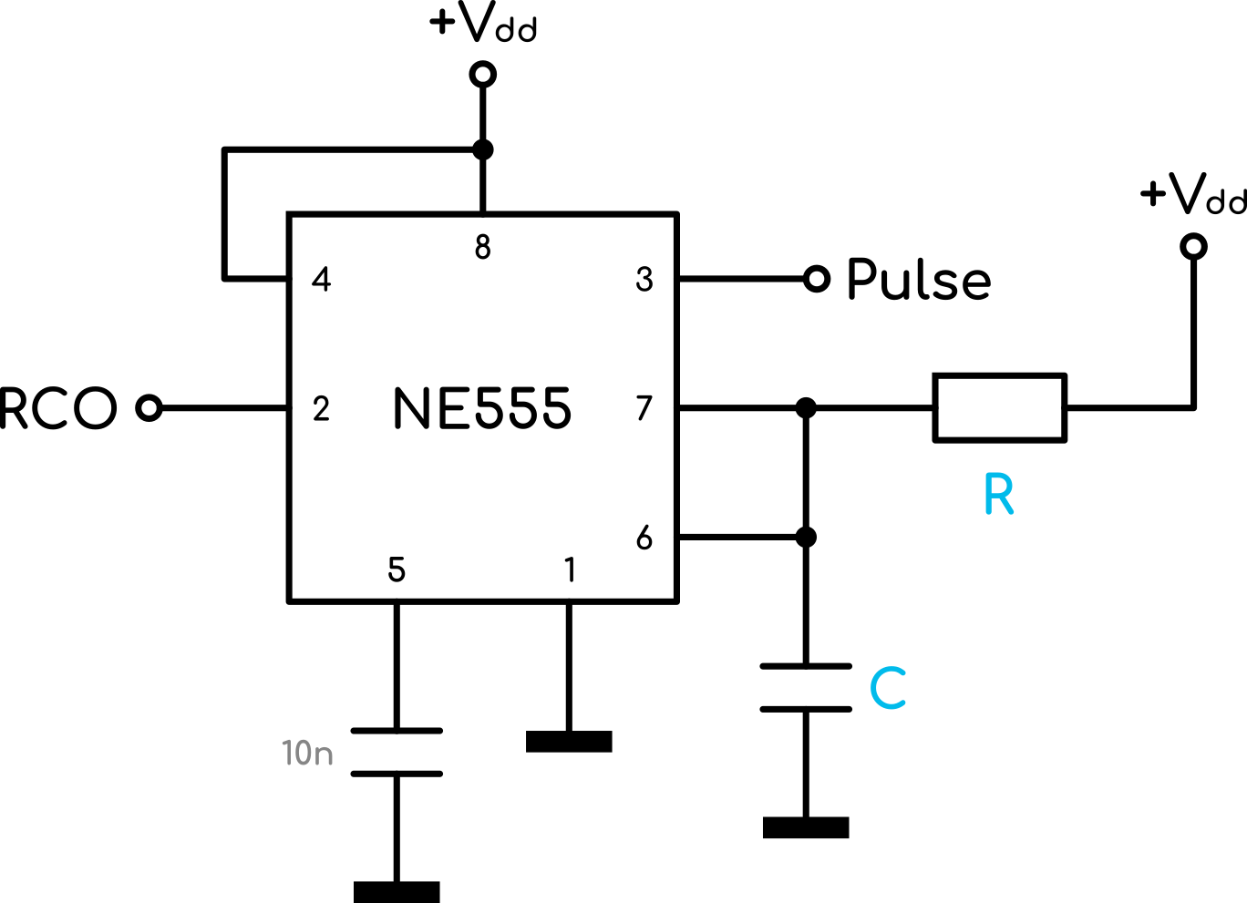
[picture p132: Elaborato Scritto/images/circuits/monostable_circuit.png]
    
    \caption{Schema circuito monostabile ($+V_{dd}=+5\ V$)}
    \label{monostable_circuit}
\end{figure}

Si scelgono $R=10\ k\Omega$ e $C=100\ pF$ e si osservano quindi le forme d'onda così ottenute:

\begin{figure}[H]
    \centering
    
    \caption{Setup di misura del circuito monostabile}
    \label{mis_monostable}
\end{figure}

\begin{figure}[H]
    \centering

    \begin{subfigure}{.5\textwidth}
        \centering
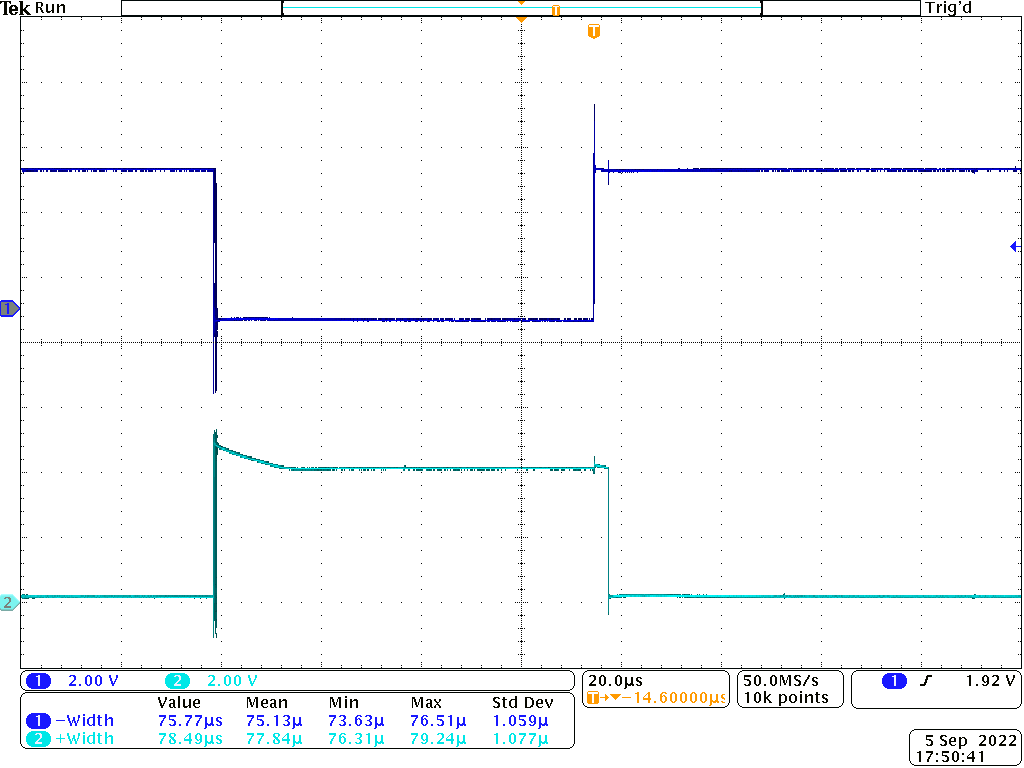
[picture p133: Elaborato Scritto/images/acquisitions/pulse_2V.png]
        
        \caption{$V_{in}=+2\ V$}
        \label{acq_monostable_2V}
    \end{subfigure}%
    \begin{subfigure}{.5\textwidth}
        \centering
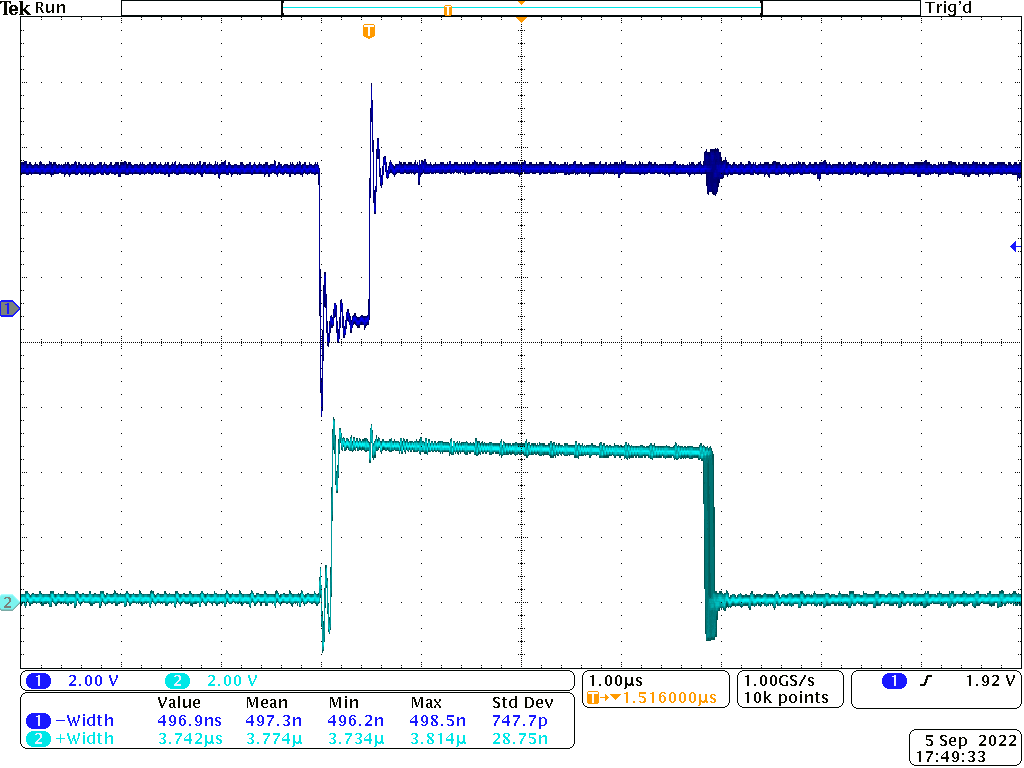
[picture p134: Elaborato Scritto/images/acquisitions/pulse_8V.png]
        
        \caption{$V_{in}=+8\ V$}
        \label{acq_monostable_8V}
    \end{subfigure}

    \caption{Acquisizioni dei segnali $RCO$ e $Pulse$ per diversi valori di $V_{in}$}
    \label{mis_pulse}
\end{figure}

%--------------------------------------------------------------------------------------------

\section{Sinusoide}

%--------------------------------------------------------------------------------------------

Infine, l'onda più complicata da generare, ma più semplice dal punto di vista musicale è la
sinusoide. Un metodo piuttosto rapido per generarla consisterebbe nel filtrare al massimo una
qualsiasi delle onde già generate, e lasciare solo l'armonica fondamentale. Tuttavia questo
metodo risulta scomodo se la frequenza del segnale varia in un ampio intervallo di valori,
proprio come nel nostro caso, perchè per ottenere un risultato ottimale la frequenza di taglio
del filtro dovrebbe seguire di pari passo quella dell'oscillatore .

La soluzione utilizzata quindi è un circuito con guadagno variabile in base al livello di
tensione del segnale fornito in ingresso, che si occuperà di convertire un'onda triangolare
nella sinusoide voluta. Viene realizzato con un operazionale e dei diodi, sia normali che di
tipo zener, i quali si occupano di modificare la resistenza di feedback e quindi il valore di
guadagno dell'amplificatore, nei diversi intervalli di tensione.

\begin{figure}[H]
    \centering
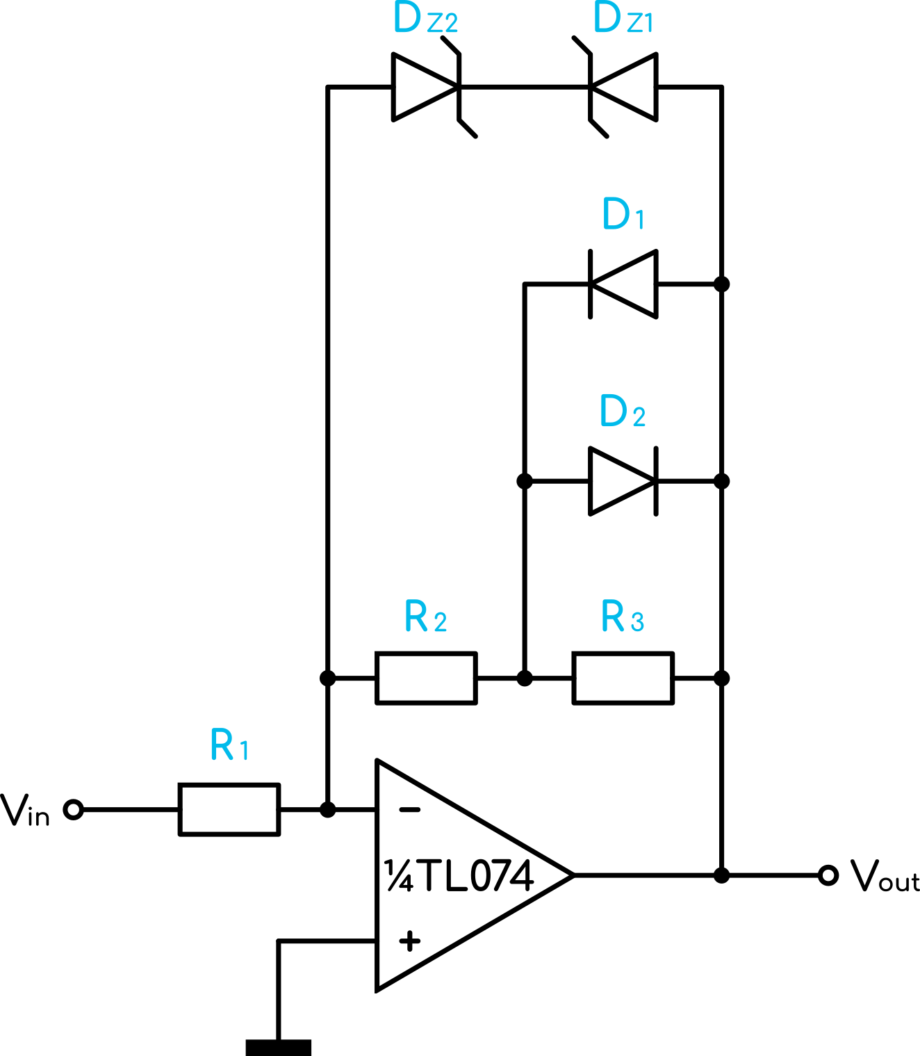
[picture p135: Elaborato Scritto/images/circuits/sin_circuit.png]
    
    \caption{Convertitore triangolo-seno}
    \label{sin_circuit}
\end{figure}

Per ricavare la relazione ingresso uscita cominciamo con l'osservare che il circuito è
simmetrico rispetto agli $0\ V$, e quindi possiamo limitare l'analisi ai soli valori positivi
di $V_{in}$ ed estendere poi i risultati al semipiano negativo. Procediamo quindi per casi:

\begin{itemize}
    \item Diodi OFF:

          Tutti i diodi sono interdetti e il circuito equivalente è quello di un amplificatore invertente
          la cui relazione ingresso/uscita è ricavata facilmente.

          \begin{minipage}{0.45\textwidth}
              \centering
              \begin{figure}[H]
                  \centering
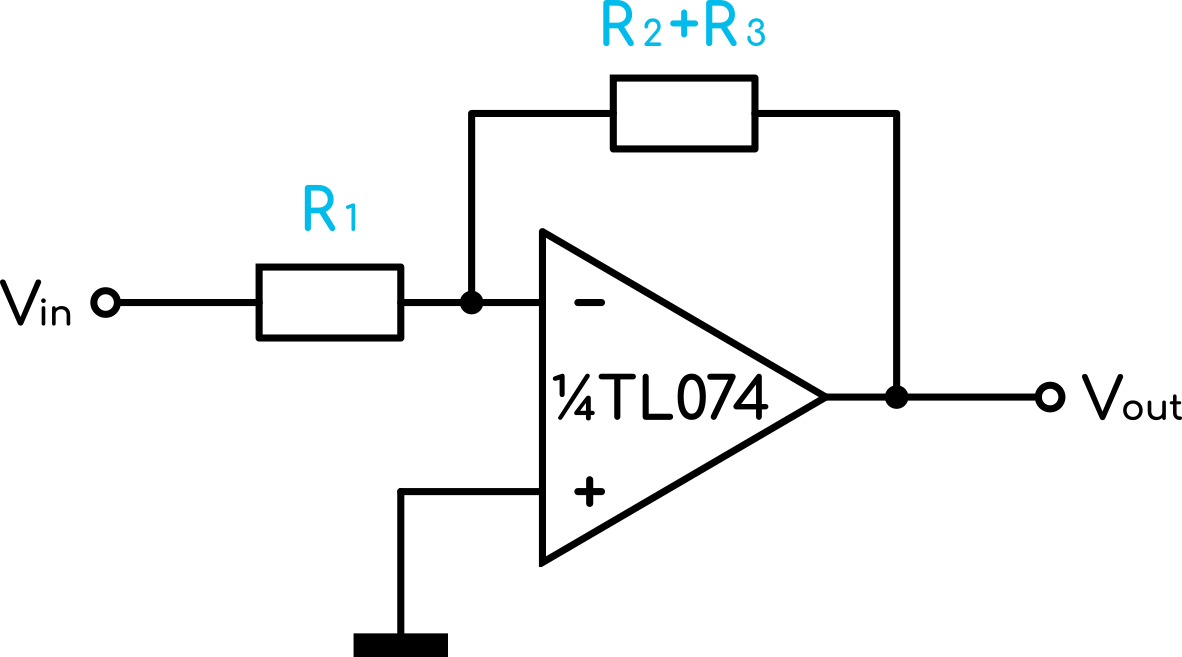
[picture p136: Elaborato Scritto/images/circuits/sin_case1_circuit.png]
                  
                  \caption{Circuito equivalente}
                  \label{sin_case1_circuit}
              \end{figure}
          \end{minipage}
          \begin{minipage}{0.45\textwidth}
              \centering
              \begin{equation}
                  V_{out}=-V_{in}\frac{R_2+R_3}{R_1}\ [V]
              \end{equation}
          \end{minipage}

          Questo vale nelle seguenti condizioni:

          \begin{equation}
              \left\{
              \begin{array}{ll}
                  V_{D2}\leq V_{\gamma}        & \rightarrow V_{in}\leq V_{\gamma}\frac{R_1}{R_3}=V_{TH1}          \\
                  V_{out}\geq-(V_{\gamma}+V_Z) & \rightarrow V_{in}\leq(V_{\gamma}+V_Z)\frac{R_1}{R_2+R_3}=V_{TH2}
              \end{array}
              \right.
          \end{equation}

    \item $D_2$ ON:

          Solo $D_2$ è attivo e modifica il guadagno del circuito.

          \begin{minipage}{0.45\textwidth}
              \centering
              \begin{figure}[H]
                  \centering
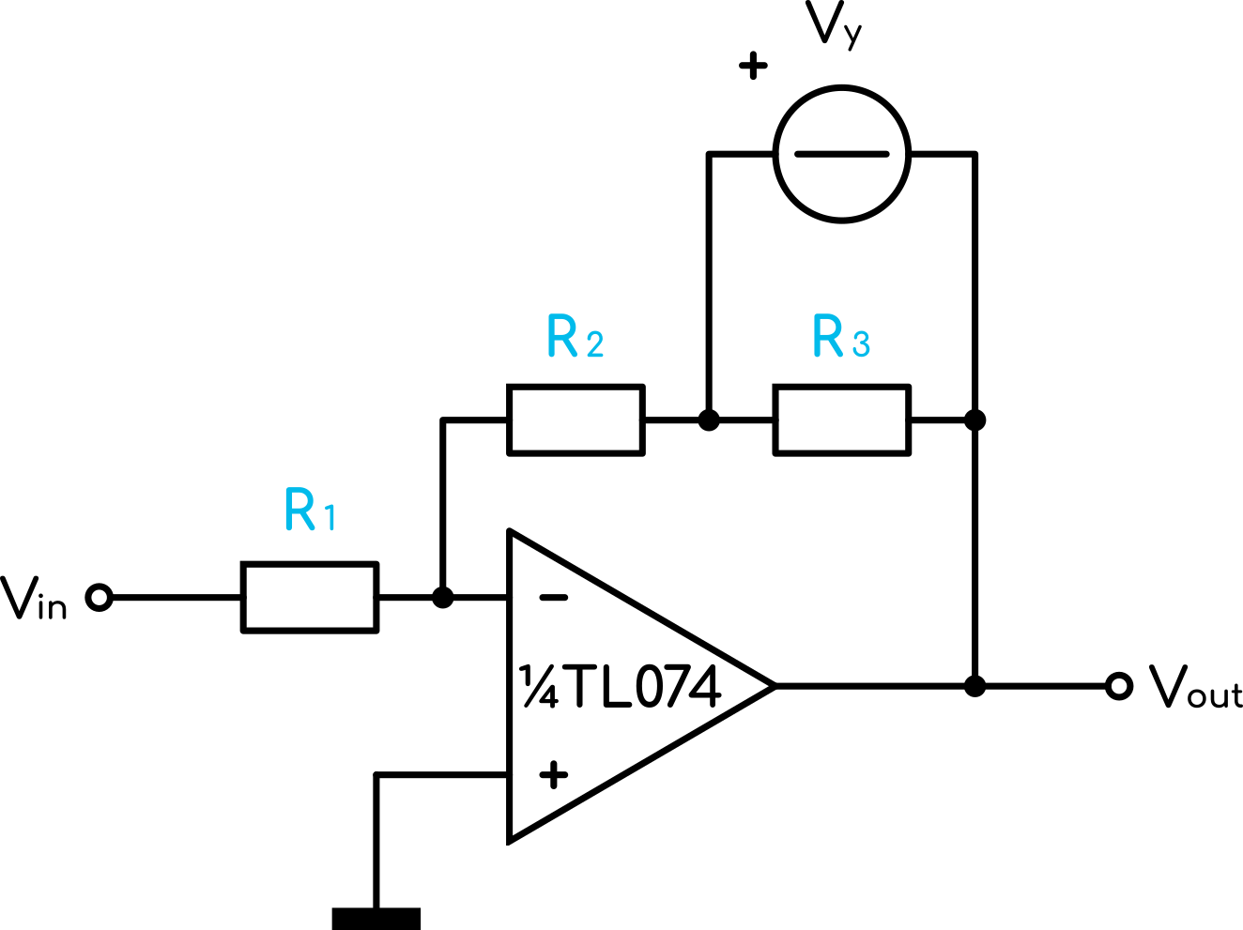
[picture p137: Elaborato Scritto/images/circuits/sin_case2_circuit.png]
                  
                  \caption{Circuito equivalente}
                  \label{sin_case2_circuit}
              \end{figure}
          \end{minipage}
          \begin{minipage}{0.45\textwidth}
              \centering
              \begin{equation}
                  V_{out}=-V_{in}\frac{R_2}{R_1}-V_\gamma\ [V]
              \end{equation}
          \end{minipage}

          che ha valore per le seguenti condizioni:

          \begin{equation}
              \left\{
              \begin{array}{ll}
                  I_{D2}> 0                    & \rightarrow V_{in}>V_{TH1}                        \\
                  V_{out}\geq-(V_{\gamma}+V_Z) & \rightarrow V_{in}\leq V_Z\frac{R_1}{R_2}=V_{TH3}
              \end{array}
              \right.
          \end{equation}

    \item $D_{Z1}$ in scarica, $D_2$ e $D_{Z2}$ ON:

          L'uscita è completamente determinata dalle cadute di tensione sui diodi.

          \begin{minipage}{0.45\textwidth}
              \centering
              \begin{figure}[H]
                  \centering
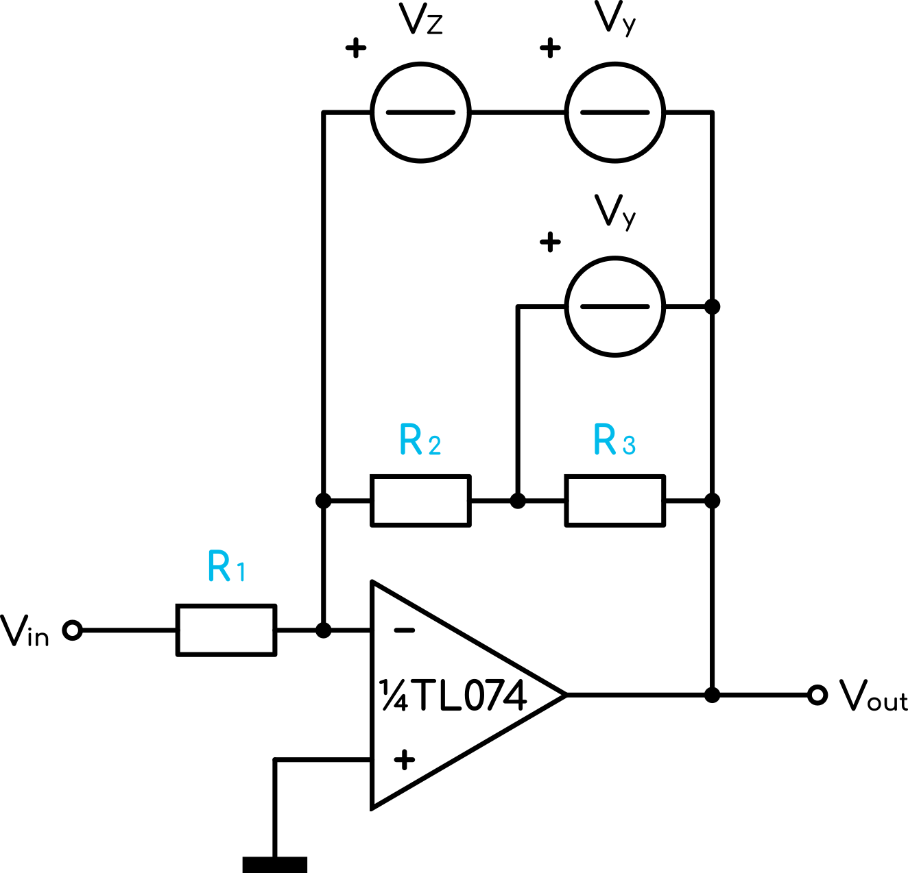
[picture p138: Elaborato Scritto/images/circuits/sin_case3_circuit.png]
                  
                  \caption{Circuito equivalente}
                  \label{sin_case3_circuit}
              \end{figure}
          \end{minipage}
          \begin{minipage}{0.45\textwidth}
              \centering
              \begin{equation}
                  V_{out}=-(V_{\gamma}+V_Z)\ [V]
              \end{equation}
          \end{minipage}

          Ci troviamo quindi nelle seguenti condizioni:

          \begin{equation}
              \left\{
              \begin{array}{ll}
                  I_{D2}> 0  & \rightarrow V_Z>V_\gamma\frac{R_2}{R_3} \\
                  I_{DZ2}> 0 & \rightarrow V_{in}>V_{TH3}
              \end{array}
              \right.
          \end{equation}

\end{itemize}

Il circuito è tratto dal libro del Professor Simone Buso \cite{buso}.

Si utilizzano dei diodi zener con tensione di scarica pari a $3.3\ V$, poichè il segnale in
ingresso è limitato a $+5\ V$, e procediamo con la scelta dei resistori e il calcolo delle
soglie:

\begin{itemize}
    \item Per il primo caso impostiamo guadagno pressochè unitario, quindi otteniamo il vincolo
          $R_1\approx R_2+R_3$. Possiamo scegliere $R_1=33\ k\Omega$, $R_2=22\ k\Omega$ e $R_3=12\ k\Omega$.
          Questo ci permette di definire i valori di soglia del primo intervallo $V_{TH1}\approx1.93\ V$
          e $V_{TH2}\approx3.88\ V$. L'intervallo di funzionamento nella prima configurazione è quindi
          $|V_{in}|\leq V_{TH1}$ poichè $V_{TH2}>V_{TH1}$.

    \item Nel secondo caso invece, il valore di soglia vale $V_{TH3}=4.95\ V$, quindi l'intervallo di
          funzionamento è $V_{TH1}<|V_{in}|\leq V_{TH3}$, mentre il valore del guadagno risulta
          $\frac{R_2}{R_1}\approx0.67$.

    \item Nell'ultimo caso infine, essendo l'uscita completamente determinata dalle cadute di tensione
          sui diodi, l'intervallo di funzionamento in questa configurazione è $|V_{in}|>V_{TH3}$, e
          l'uscita viene tagliata a $\approx4\ V$.

\end{itemize}

\begin{figure}[H]
    \centering
    \begin{tikzpicture}
        \centering
        \begin{axis}[
                title = Transcaratteristica teorica,
                no marks,
                domain = -6:6,
                samples = 100,
                xmin = -6.5, xmax = 6.5,
                ymin = -6.5, ymax = 6.5,
                grid = major,
                grid style = {dashed, gray!30},
                xlabel = $V_{in}$,
                ylabel = $V_{out}$,
                x unit = \si{\V}, y unit = \si{\V},
                legend style = {at = {(0.5, -0.25)}, anchor = north},
                cycle list name = modular,
            ]

            \addplot[
                domain = -1.925:1.925,
                samples = 20,
                color = myBlue,
            ]{-34*x/33};

            \addplot[
                domain = 1.925:4.95,
                samples = 20,
                color = myBlue,
            ]{-22*x/33-0.7};

            \addplot[
                domain = -4.95:-1.925,
                samples = 20,
                color = myBlue,
            ]{-22*x/33+0.7};

            \addplot[
                domain = 4.95:6,
                samples = 20,
                color = myBlue,
            ]{-4};

            \addplot[
                domain = -6:-4.95,
                samples = 20,
                color = myBlue,
            ]{4};
        \end{axis}
    \end{tikzpicture}
\end{figure}

A causa del taglio di tensione dei diodi è anche necessario aggiungere in cascata uno stadio
amplificatore per riportare l'onda ai livelli di tensione specificati dallo standard.

\begin{figure}[H]
    \centering
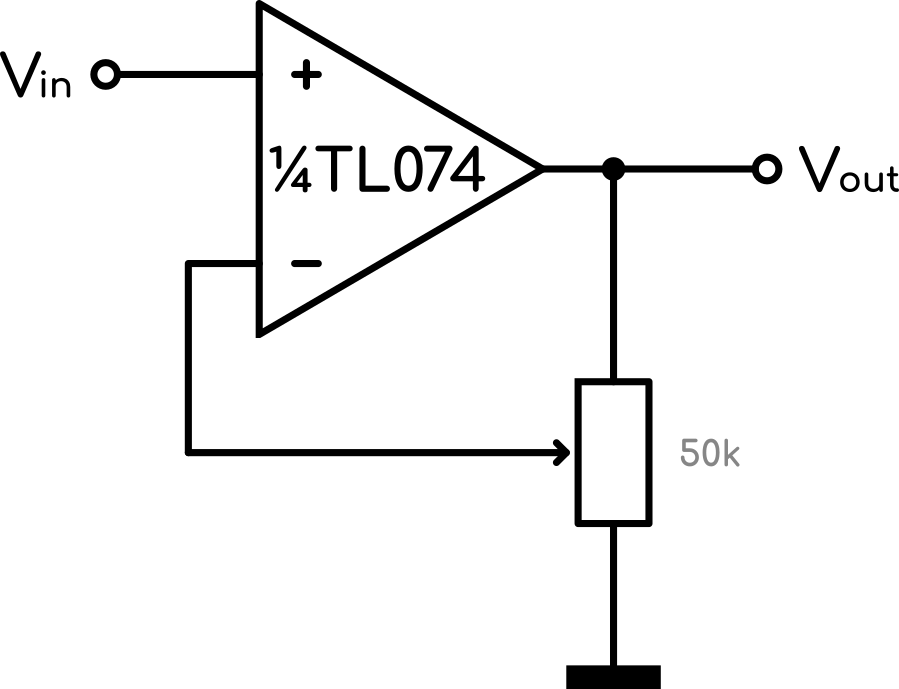
[picture p139: Elaborato Scritto/images/circuits/noninverting_amp_circuit.png]
    
    \caption{Amplificatore non-invertente}
    \label{noninverting_amp_circuit}
\end{figure}

Osserviamo quindi l'onda ottenuta e verifichiamo quanto risulta buona come approssimazione:

\begin{figure}[H]
    \centering
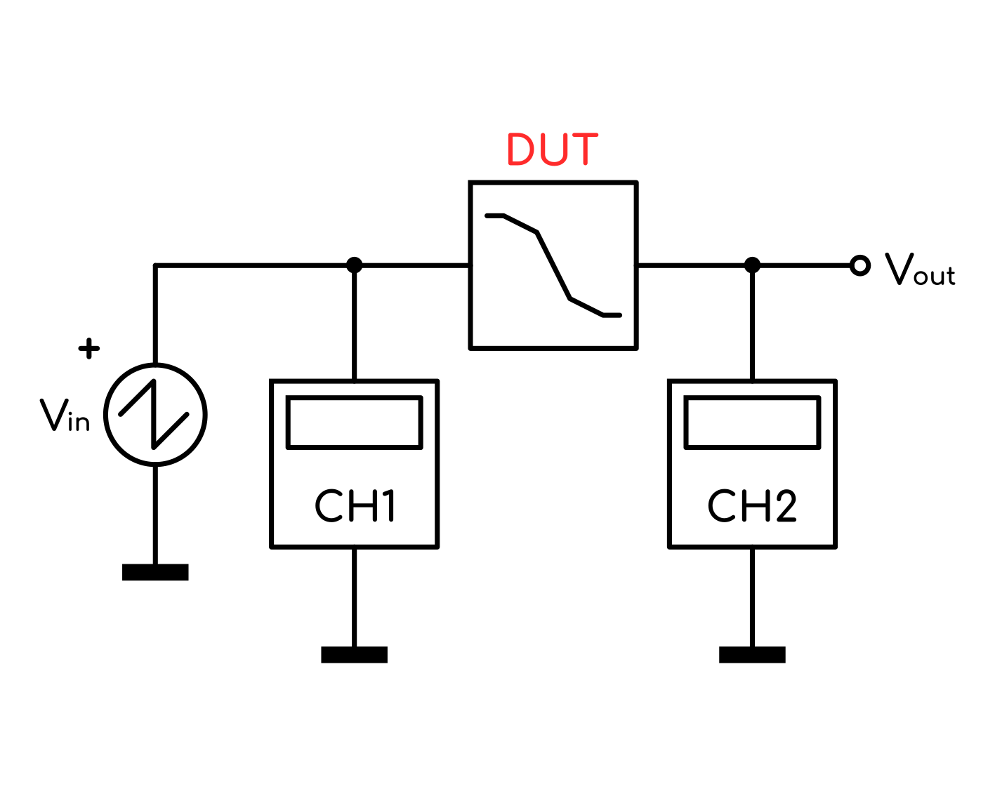
[picture p140: Elaborato Scritto/images/block_diagrams/mis_sin_oscilloscope.png]
    
    \caption{Setup di misura}
    \label{mis_sin_oscilloscope}
\end{figure}

\begin{figure}[H]
    \centering

    \begin{subfigure}{.5\textwidth}
        \centering
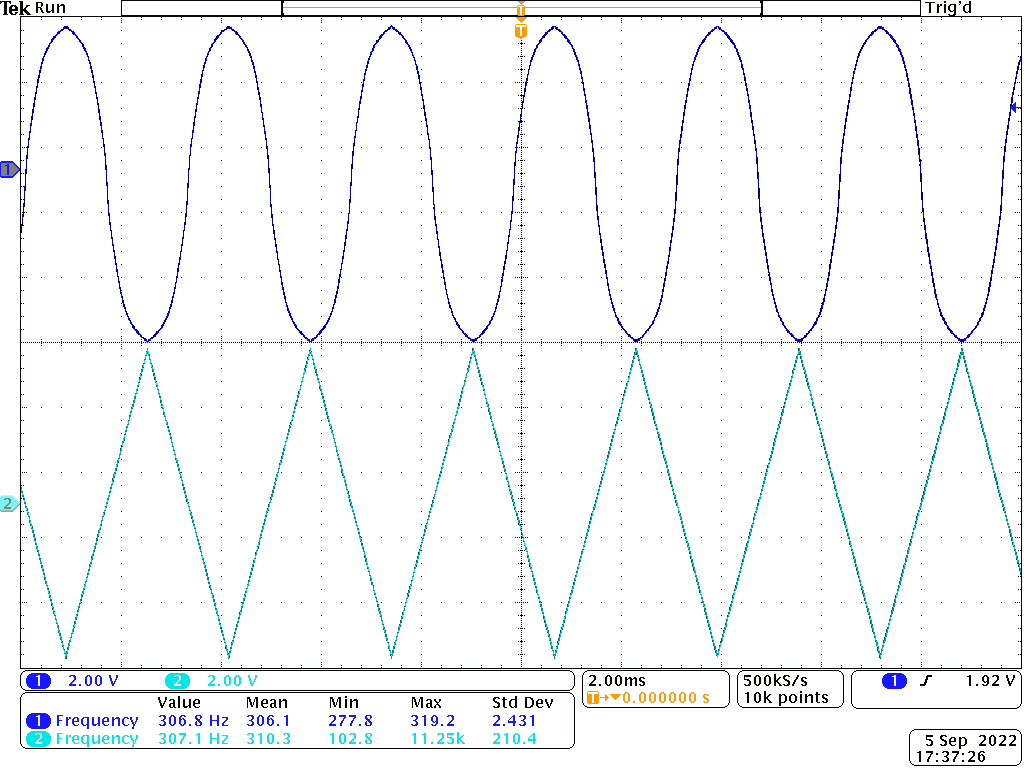
[picture p141: Elaborato Scritto/images/acquisitions/sine_wave_2V.png]
        
        \caption{$V_{in}=+2\ V$}
        \label{acq_sine_2V}
    \end{subfigure}%
    \begin{subfigure}{.5\textwidth}
        \centering
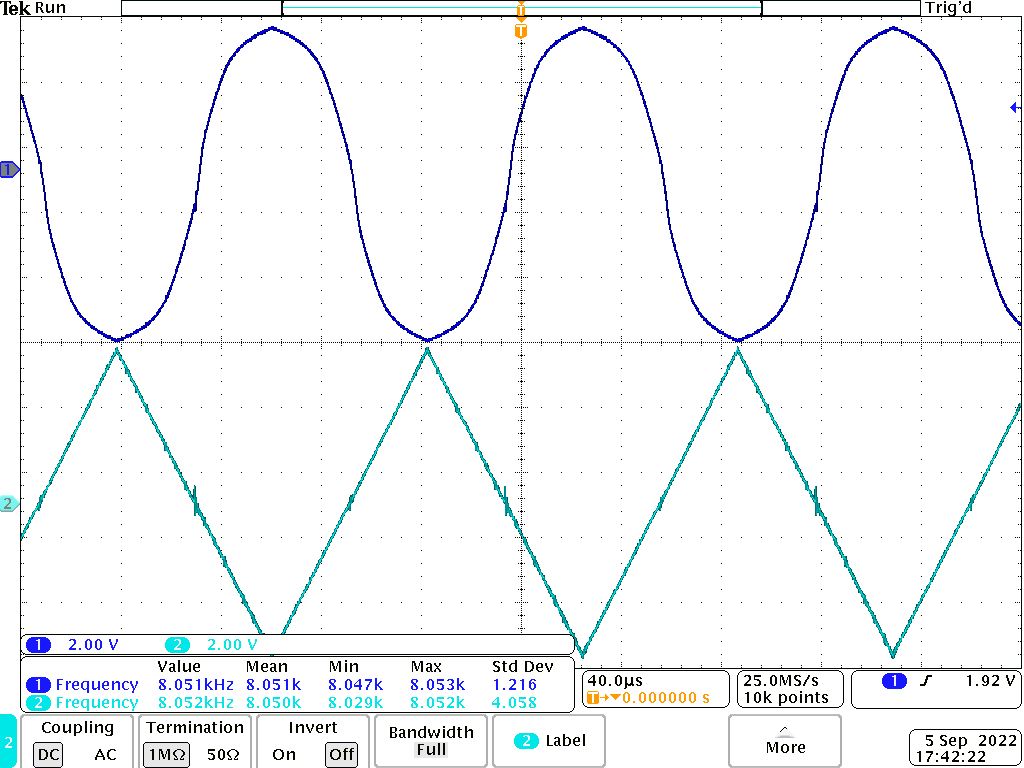
[picture p142: Elaborato Scritto/images/acquisitions/sine_wave_8V.png]
        
        \caption{$V_{in}=+8\ V$}
        \label{acq_sine_8V}
    \end{subfigure}
    \begin{subfigure}{.5\textwidth}
        \centering
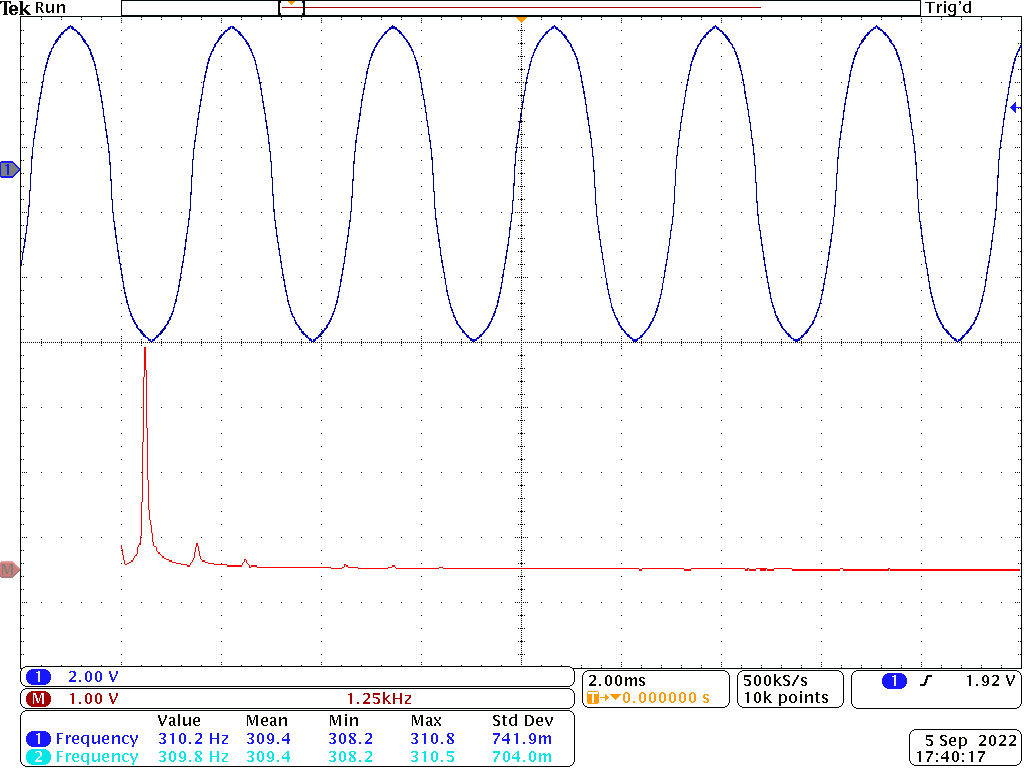
[picture p143: Elaborato Scritto/images/acquisitions/sine_spectrum_2V.png]
        
        \caption{$V_{in}=+2\ V$}
        \label{acq_fourier_2V}
    \end{subfigure}%
    \begin{subfigure}{.5\textwidth}
        \centering
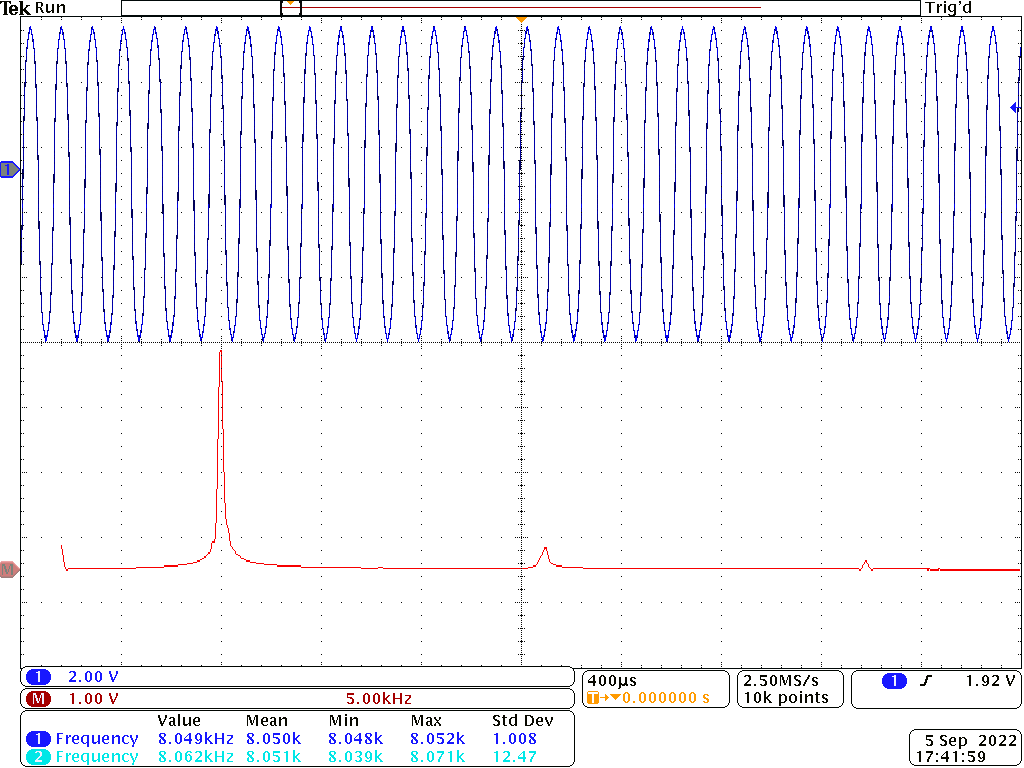
[picture p144: Elaborato Scritto/images/acquisitions/sine_spectrum_8V.png]
        
        \caption{$V_{in}=+8\ V$}
        \label{acq_fourier_8V}
    \end{subfigure}

    \caption{Sinusoide ottenuta per diversi valori di $V_{in}$ nel dominio del tempo e
        della frequenza}
    \label{acq_sine}
\end{figure}

Dall'analisi in frequenza vediamo che le armoniche del rumore sono pressochè ininfluenti e
quindi l'onda ottenuta risulta effettivamente un'ottima approssimazione di una sinusoide.
Al variare della frequenza poi, la bontà dell'onda non cambia, come invece sarebbe successo
se avessimo impiegato un filtro.

\begin{figure}[H]
    \centering
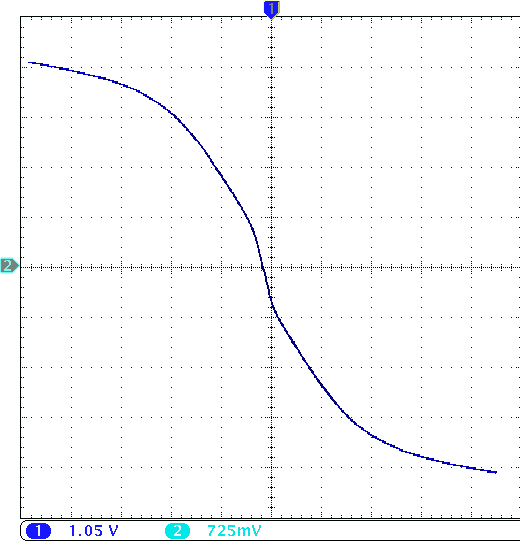
[picture p145: Elaborato Scritto/images/acquisitions/trans_sine_cut.png]
    
    \caption{Transcaratteristica tracciata con l'oscilloscopio}
    \label{acq_sine_oscilloscope}
\end{figure}

Infine, la transcaratteristica tracciata tramite oscilloscopio risulta abbastanza simile a
quella teorica in figura, anche se più smussata a causa del comportamento reale dei diodi.

%--------------------------------------------------------------------------------------------
