PippoGot/FGVCO/Elaborato Scritto/chapters/ch00-introduzione.tex

\unchapter{Introduzione e Specifiche di Progetto}\label{introduzione}

%--------------------------------------------------------------------------------------------

In questa tesi viene discussa la progettazione di un sintetizzatore musicale compatibile con
lo standard modulare più diffuso al giorno d'oggi, ovvero Eurorack \cite{eurorack}. Più
precisamente si vuole realizzare un generatore di segnali che offra la possibilità di essere
controllato in tensione (Voltage Controlled Oscillator, o VCO in breve). In questo modo,
applicando dei segnali variabili nel tempo in ingresso al modulo, si è in grado di variare
dinamicamente la frequenza dei segnali in uscita.

Il range scelto per tale variazione comprende la fascia di frequenze dello spettro audio,
quindi da poche decine di $Hz$ a circa $7\ kHz$. Si desidera inoltre la possibilità di
convertire a piacere il funzionamento del modulo in oscillatore a bassa frequenza (Low Frequency
Oscillator, o LFO), spostando quindi il range di frequenze disponibili da frazioni di
$Hz$ a qualche decina di $Hz$.
\medskip

\begin{figure}[H]
    \centering
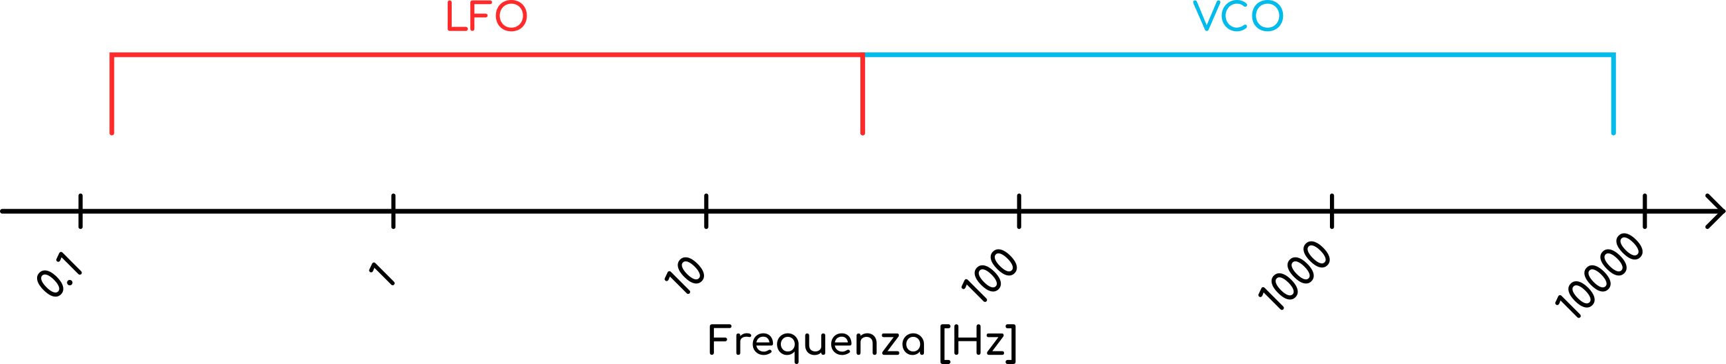
[picture p155: Elaborato Scritto/images/graphs/functioning_range.png]
    
    \caption{Range di funzionamento approssimato, in scala logaritmica}
    \label{functioning_range}
\end{figure}

In modalità VCO quindi, il modulo produrrà dei segnali che attraverso un adeguato sistema
potranno riprodurre un suono, mentre in modalità LFO il circuito produrrà dei segnali
lentamente variabili nel tempo, utili per la modulazione e il controllo di diversi
parametri in altri moduli eventualmente presenti nel sistema.

Le forme d'onda desiderate sono quelle base, ovvero:

\begin{itemize}
    \item Sinusoide;
    \item Onda Quadra;
    \item Triangolo;
    \item Rampa;
    \item Dente di sega (sebbene nel range VCO non risulti particolarmente differente dalla
          rampa in termini di suono, per quanto riguarda il funzionamento LFO la differenza
          è radicale, poichè il segnale viene solitamente utilizzato come modulante);
\end{itemize}

inoltre, come verrà illustrato più avanti, risulta piuttosto semplice anche estrarre un
segnale a impulso, ancora una volta utile per il controllo di altri moduli o parametri.

Per quanto riguarda le specifiche sui livelli di tensione, si vogliono imporre i seguenti
intervalli di valori:

\begin{itemize}
    \item Segnali audio (le 5 forme d'onda elencate poco sopra): $\pm5\ V$;
    \item Segnali logici (impulso): $(0\ V\div+5\ V)$;
    \item Segnali di controllo (ingresso): $(0\ V\div+8\ V)$ in modalità $1\ V/Octave$, ovvero
          facendo in modo che ad un incremento di $1\ V$ in ingresso corrisponda un raddoppio
          di frequenza in uscita, cioè un'ottava;
    \item Alimentazioni: $\pm12\ V$ e $+5\ V$;
\end{itemize}

come suggerito dallo standard scelto.

Si desidera inoltre aggiungere delle manopole per il controllo del "volume" dei segnali
in ingresso e uscita (ad eccezione dell'impulso), e delle manopole per il controllo
manuale della frequenza.

Mettendo assieme tutti questi dettagli possiamo dunque abbozzare una interfaccia utente
(riportata in figura \ref{panel_explained}), in modo da rendere più chiaro al lettore il
risultato finale voluto.

\begin{figure}[ht]
    \centering
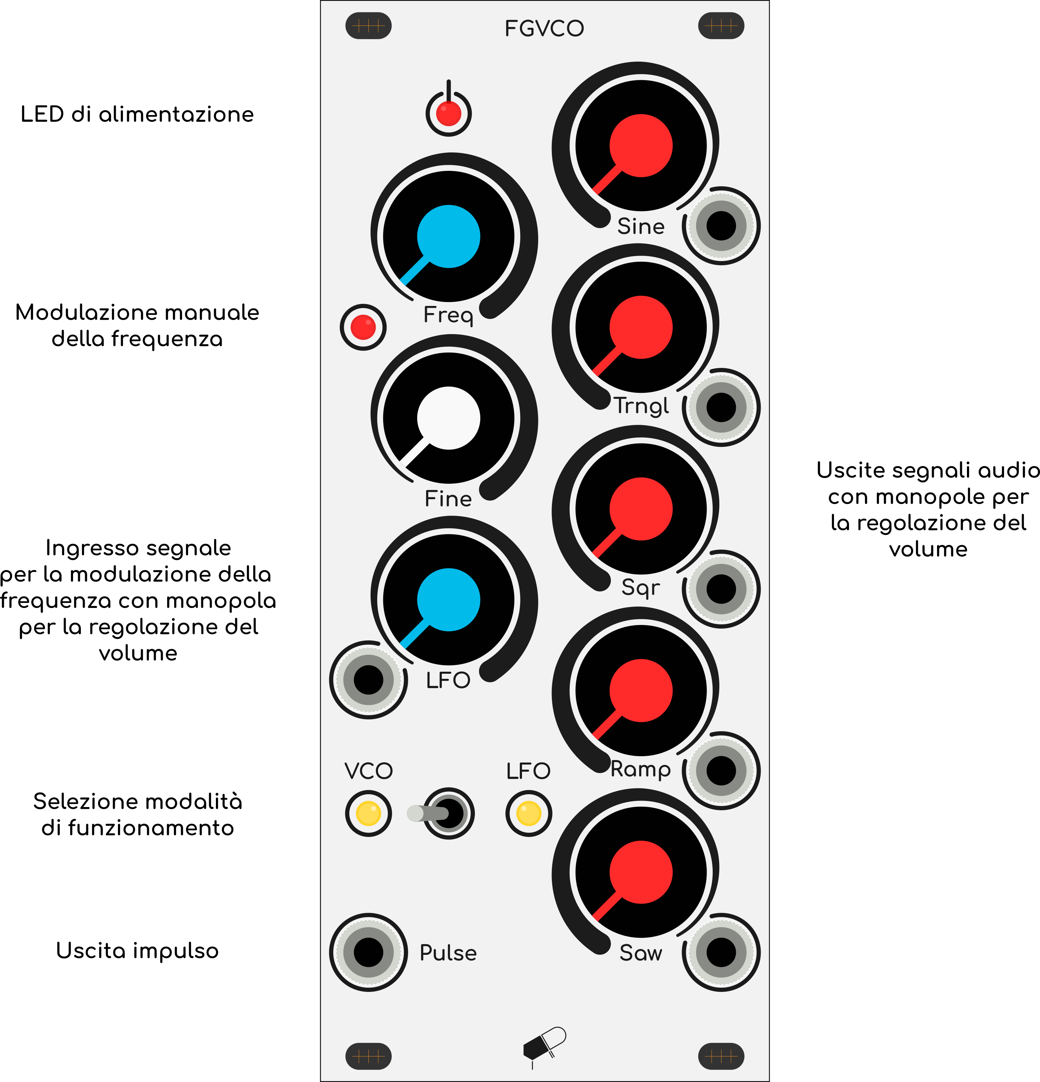
[picture p156: Elaborato Scritto/images/misc/panel_explained.png]
    
    \caption{Pannello frontale del modulo}
    \label{panel_explained}
\end{figure}

Si decide di realizzare l'intero circuito senza l'utilizzo di microcontrollori o sistemi
programmabili, scelta che viene presa per mettere alla prova il maggior numero di competenze
tra quelle acquisite durante gli anni di studio. Una soluzione più rapida e semplice
consisterebbe infatti nell'impiegare un microcontrollore con dei campioni digitali molto
densi delle forme d'onda desiderate.

%--------------------------------------------------------------------------------------------
