PippoGot/FGVCO/Elaborato Scritto/images/acquisitions/trans_clipper.png

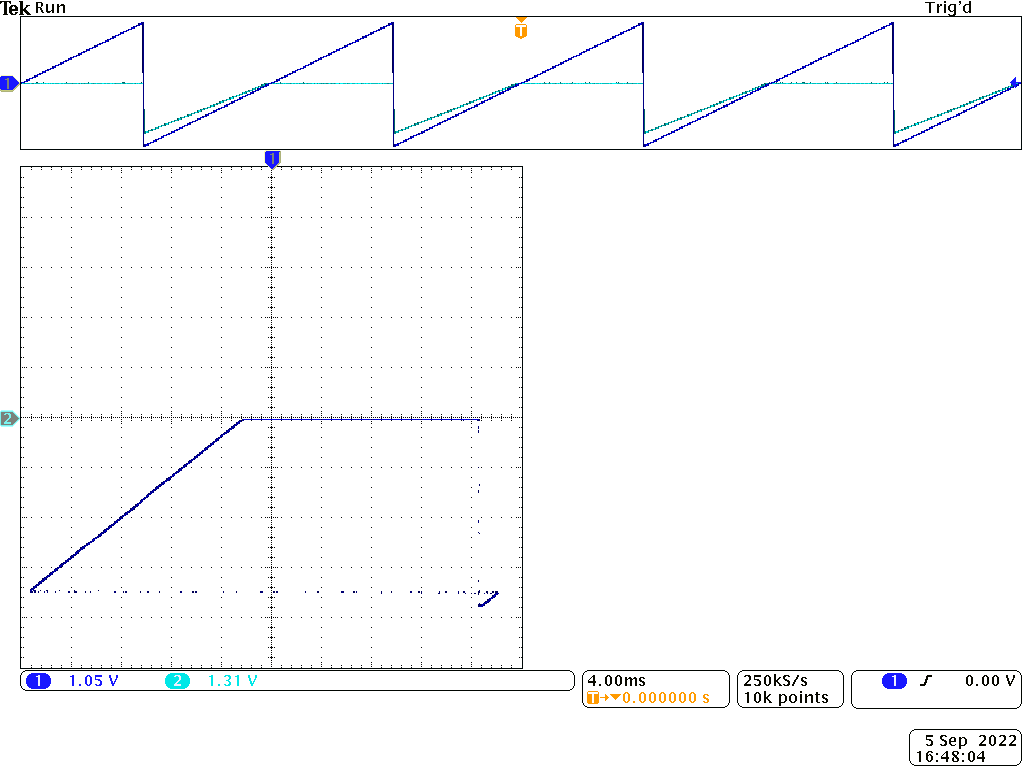
Elaborato Scritto/images/acquisitions/trans_clipper.png
