PippoGot/FGVCO/Elaborato Scritto/images/acquisitions/trans_expo.png

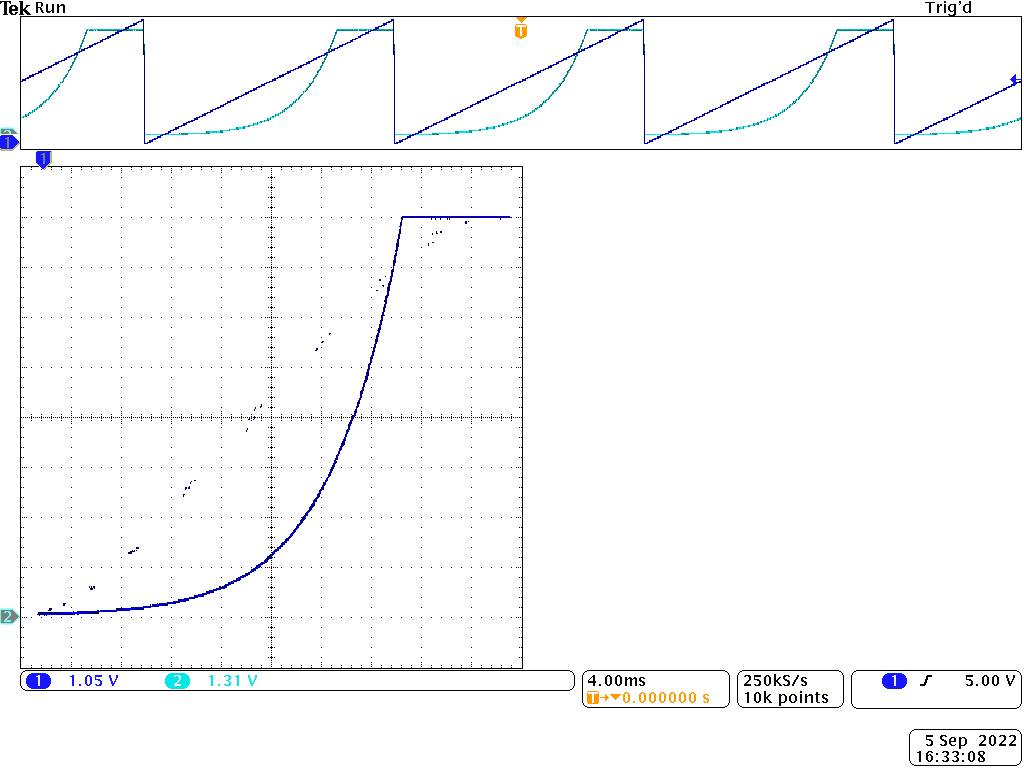
Elaborato Scritto/images/acquisitions/trans_expo.png
