PippoGot/FGVCO/Elaborato Scritto/images/acquisitions/trans_sine.png

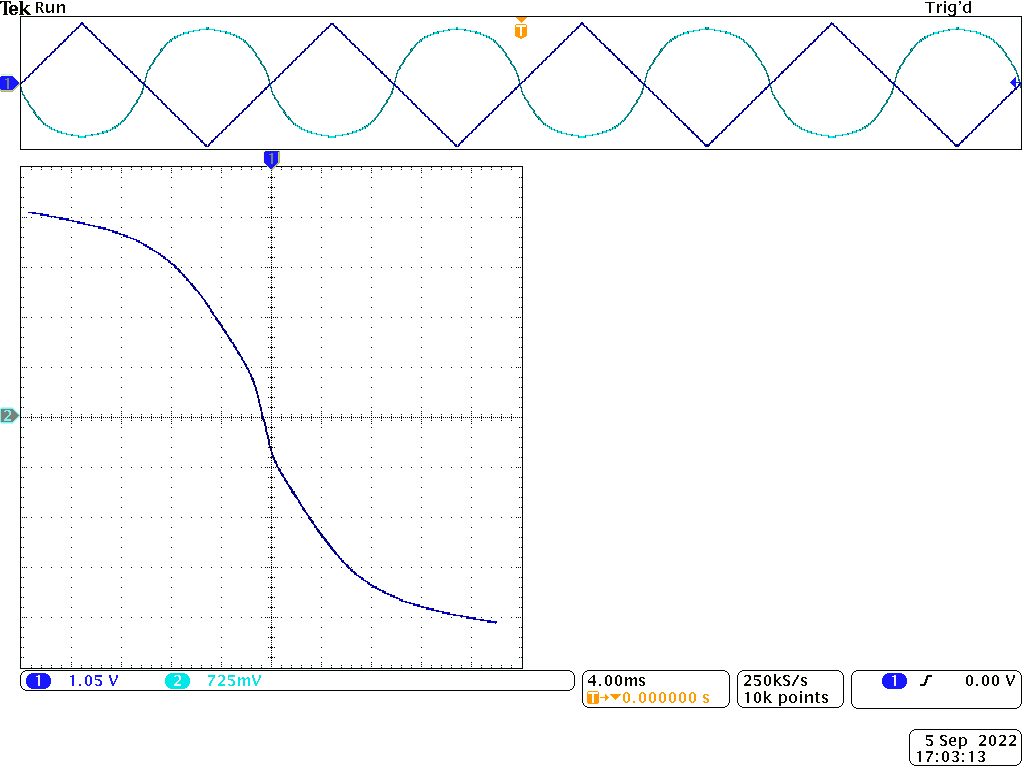
Elaborato Scritto/images/acquisitions/trans_sine.png
