PippoGot/FGVCO/Elaborato Scritto/images/circuits/expo_converter_diode_circuit.png

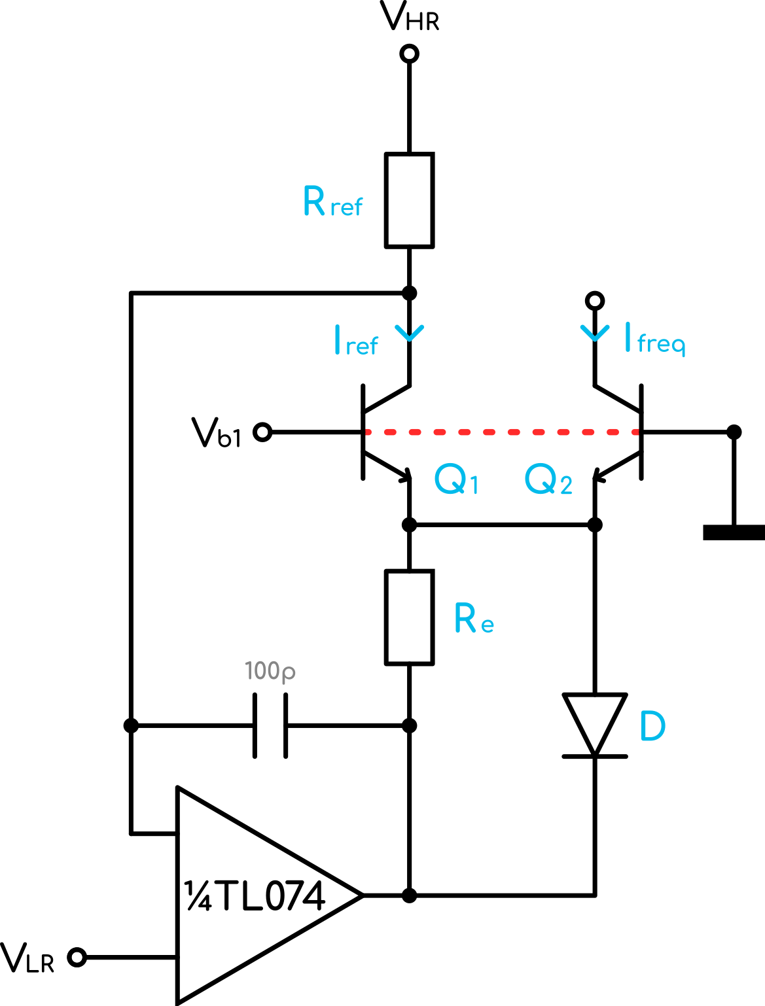
Elaborato Scritto/images/circuits/expo_converter_diode_circuit.png
