PippoGot/FGVCO/Elaborato Scritto/images/circuits/modified_differential_pair_circuit.png

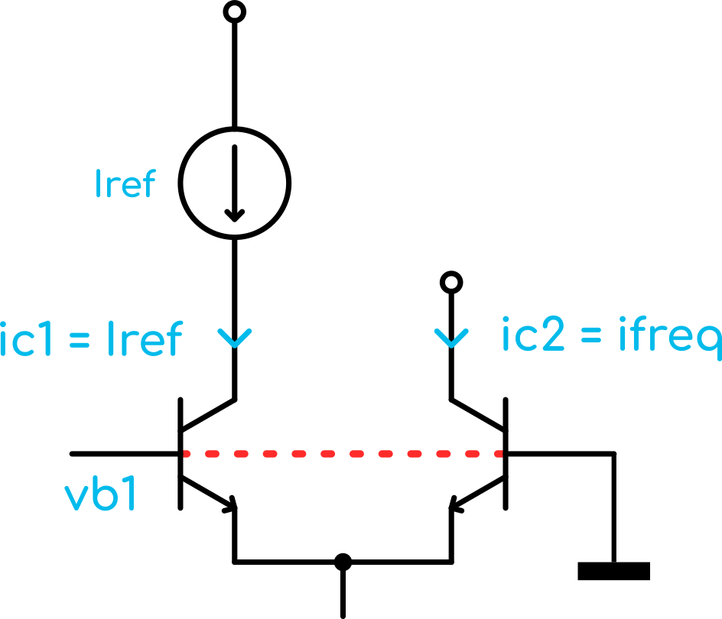
Elaborato Scritto/images/circuits/modified_differential_pair_circuit.png
