PippoGot/FGVCO/FG-VCO-(panel)/panel silkscreen.png

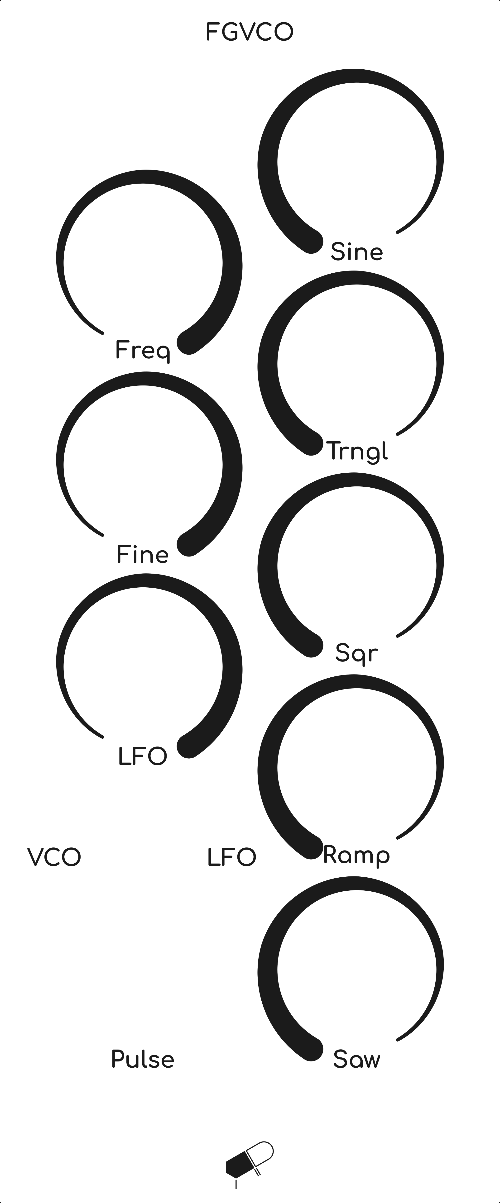
FG-VCO-(panel)/panel silkscreen.png
