PippoGot/FGVCO/Elaborato Scritto/pdfs/schematics/FG-VCO-(complete).pdf

# 10k-Fine D2VCO mode 100k R10

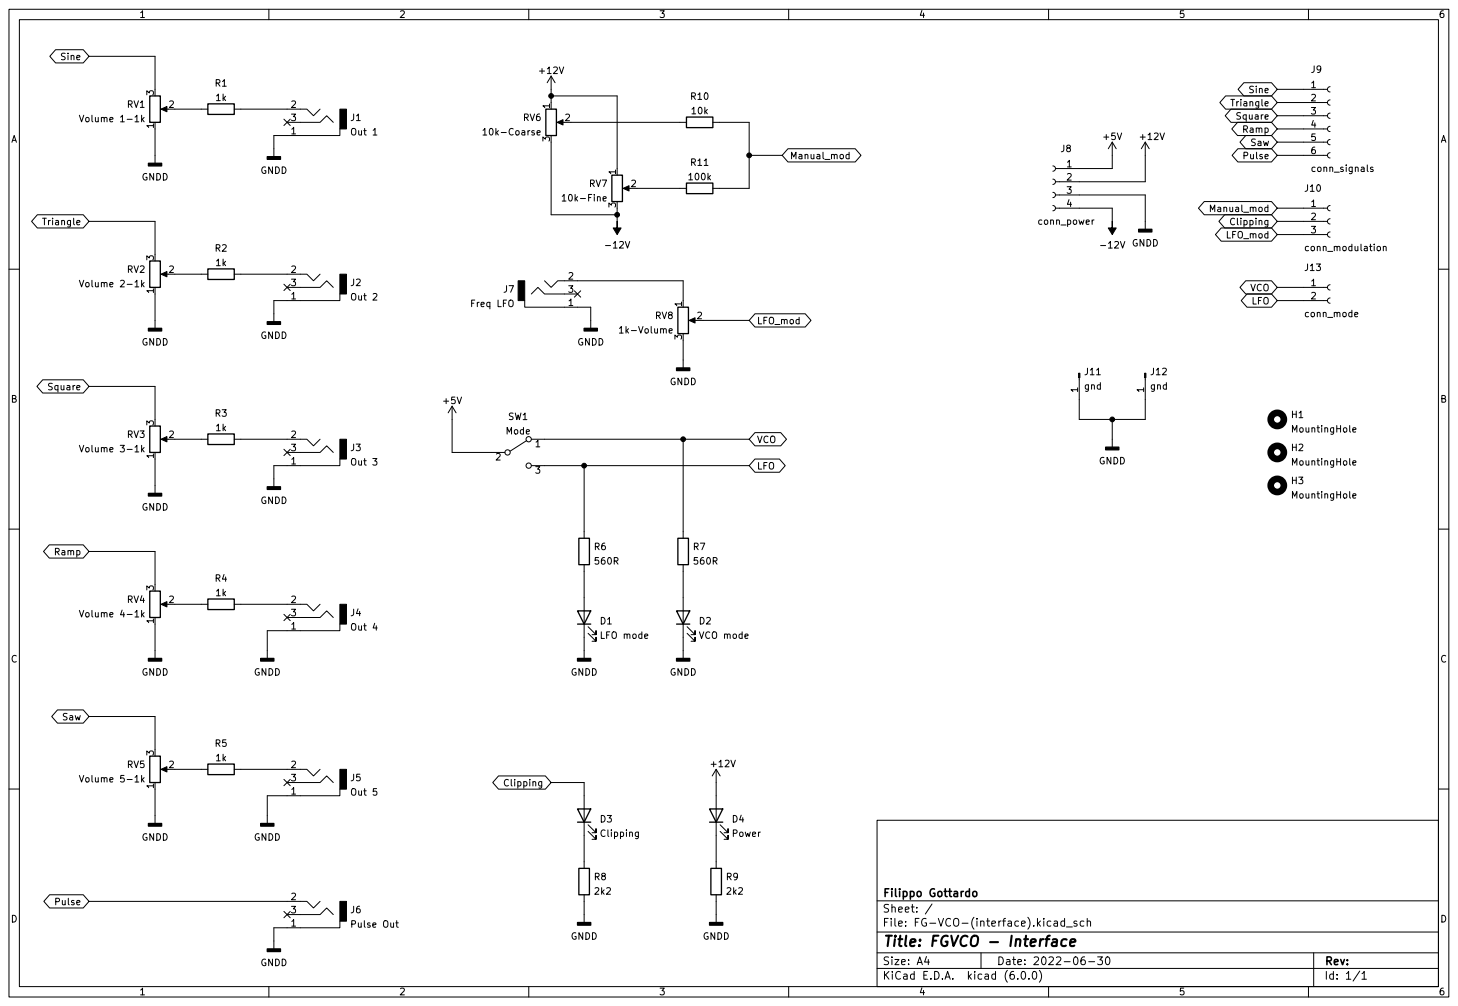
[picture p165: page 1]

File: FG-VCO-(interface).kicad_sch Sheet: / Filippo Gottardo R7

Id: 1/1 Title: FGVCO - Interface

# conn_signals_out 1

# Square_out Pulse_out Triangle_out LFO

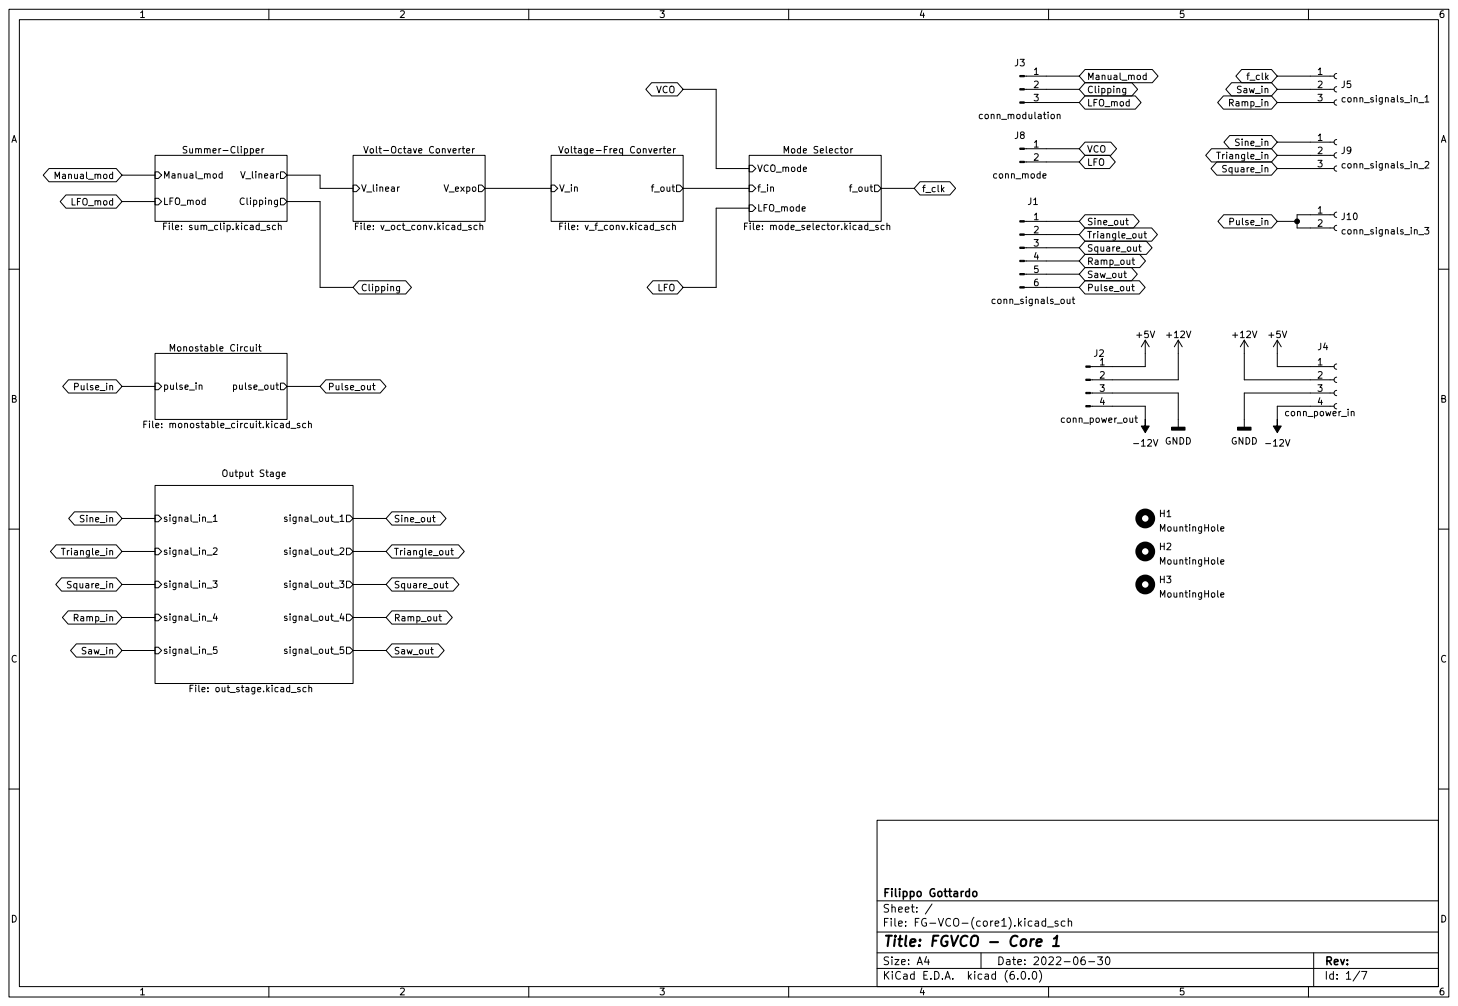
[picture p166: page 2]

File: FG-VCO-(core1).kicad_sch Sheet: / Filippo Gottardo

Id: 1/7 Title: FGVCO - Core 1

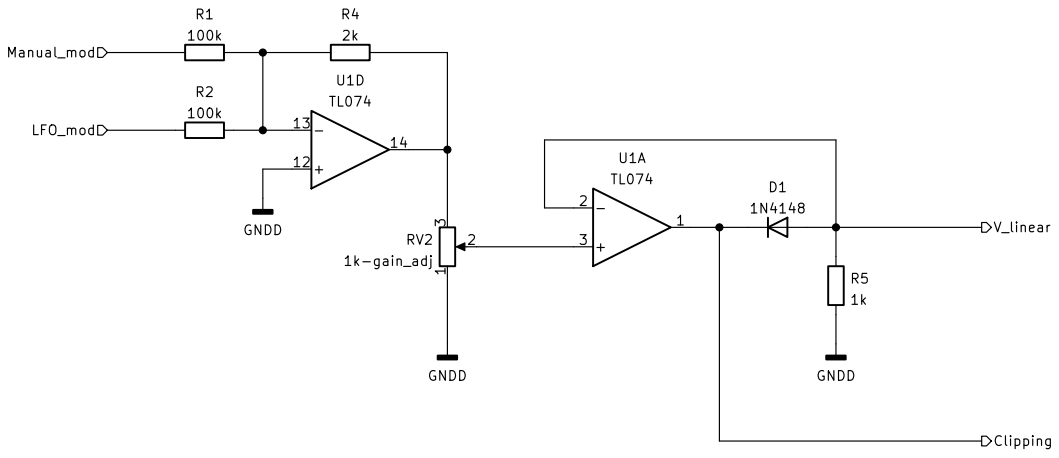
[picture p167: page 3]
D Date: 2022-06-30 KiCad E.D.A. kicad (6.0.0) Size: A4; Rev:; 1k D1 1N4148 GNDD; GNDD; 1k-gain_adj; Clipping V_linear Manual_mod; LFO_mod

Filippo Gottardo GNDD

Sheet: /Summer-Clipper/
File: sum_clip.kicad_sch
Id: 2/7 Title: FGVCO - Core 1

# 13 ¹⁴ Q1D MPQ3904 +12VR6

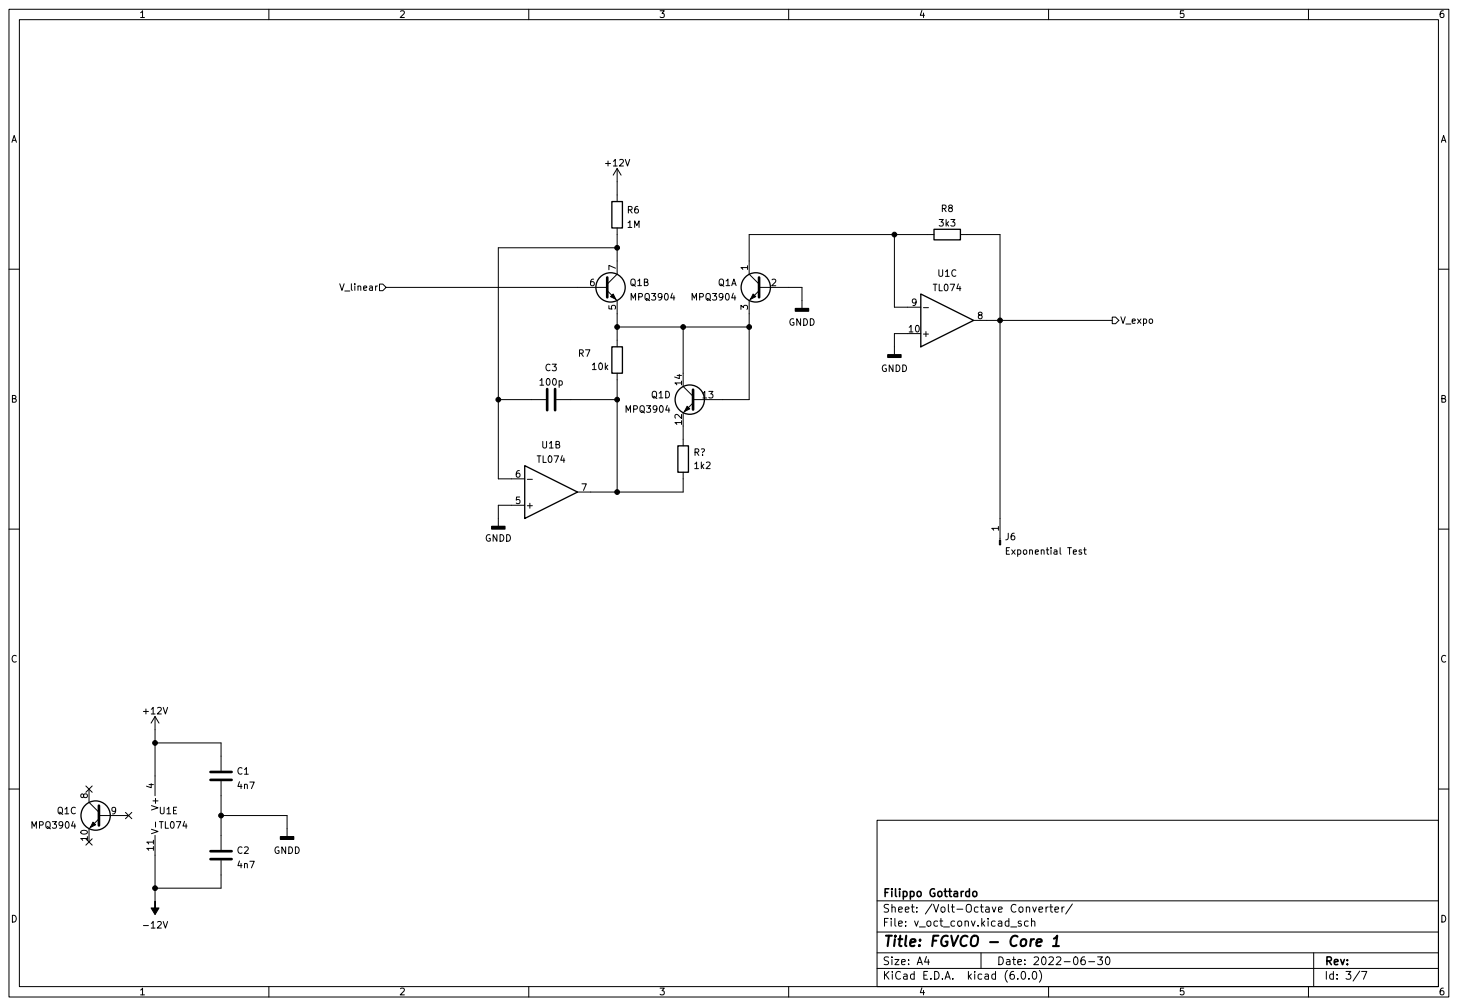
[picture p168: page 4]

File: v_oct_conv.kicad_sch Sheet: /Volt-Octave Converter/ Filippo Gottardo V⁻ 11 V⁺

Id: 3/7 Title: FGVCO - Core 1

10n R9

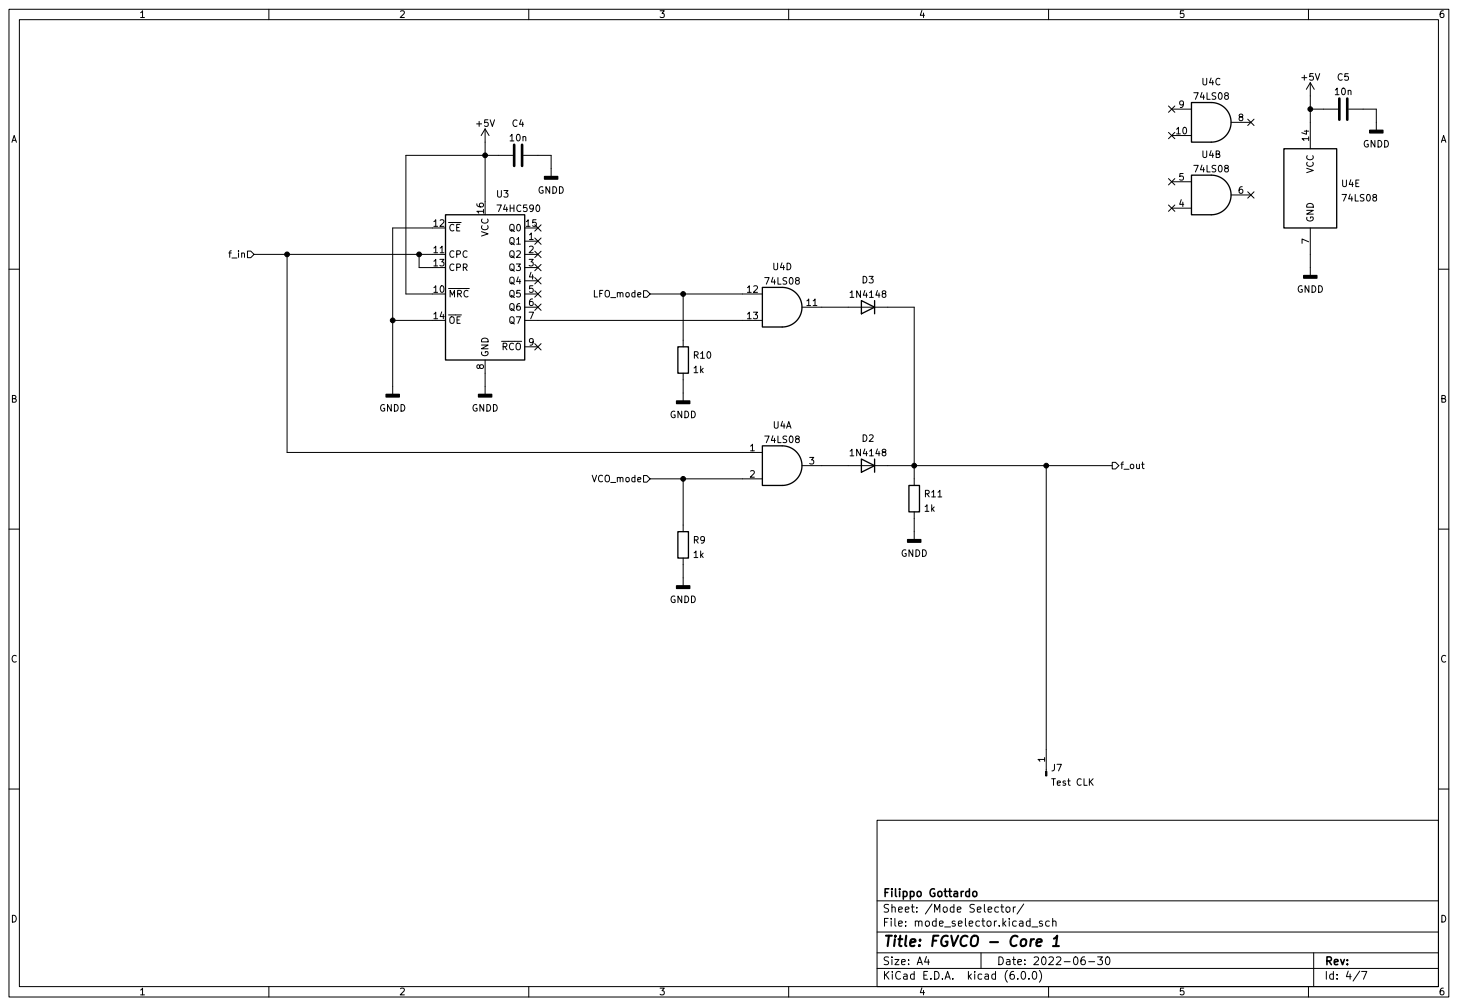
[picture p169: page 5]

File: mode_selector.kicad_sch Sheet: /Mode Selector/ Filippo Gottardo

Id: 4/7 Title: FGVCO - Core 1

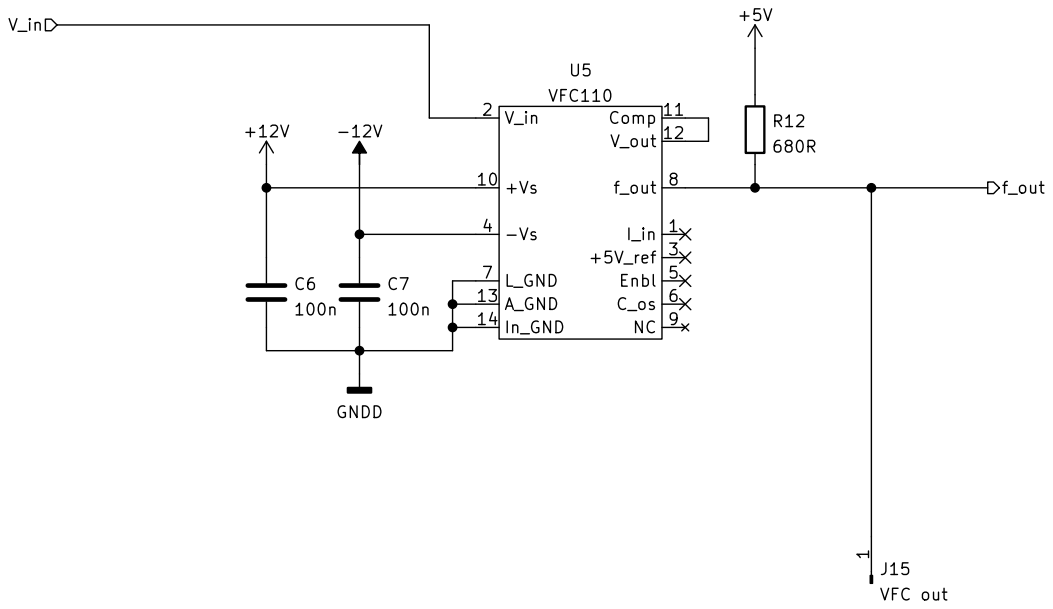
[picture p170: page 6]
D Date: 2022-06-30 KiCad E.D.A. kicad (6.0.0) Size: A4; Rev:; Comp 11 V_out 12 A_GND 13; In_GND 14 V_in 2; +5V_ref 3; Enbl 5 C_os 6; L_GND 7; f_out 8 NC 9 U5 VFC110; J15 VFC out R12 680R; f_out

Filippo Gottardo GNDD

Sheet: /Voltage-Freq Converter/
File: v_f_conv.kicad_sch
Id: 5/7 Title: FGVCO - Core 1

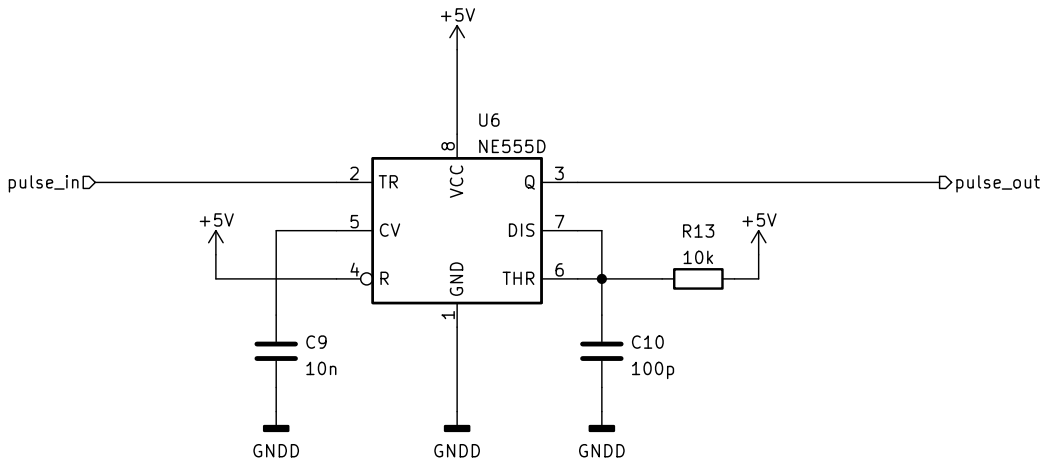
[picture p171: page 7]
D Date: 2022-06-30 KiCad E.D.A. kicad (6.0.0) Size: A4; Rev:; 10n GNDD; GNDD; GND; 1 VCC; THR 6 DIS 7 U6NE555D; pulse_in; pulse_out

File: monostable_circuit.kicad_sch Sheet: /Monostable Circuit/ Filippo Gottardo C10
100p GNDD

Id: 6/7 Title: FGVCO - Core 1

# TL074 GNDD

100k +12V +

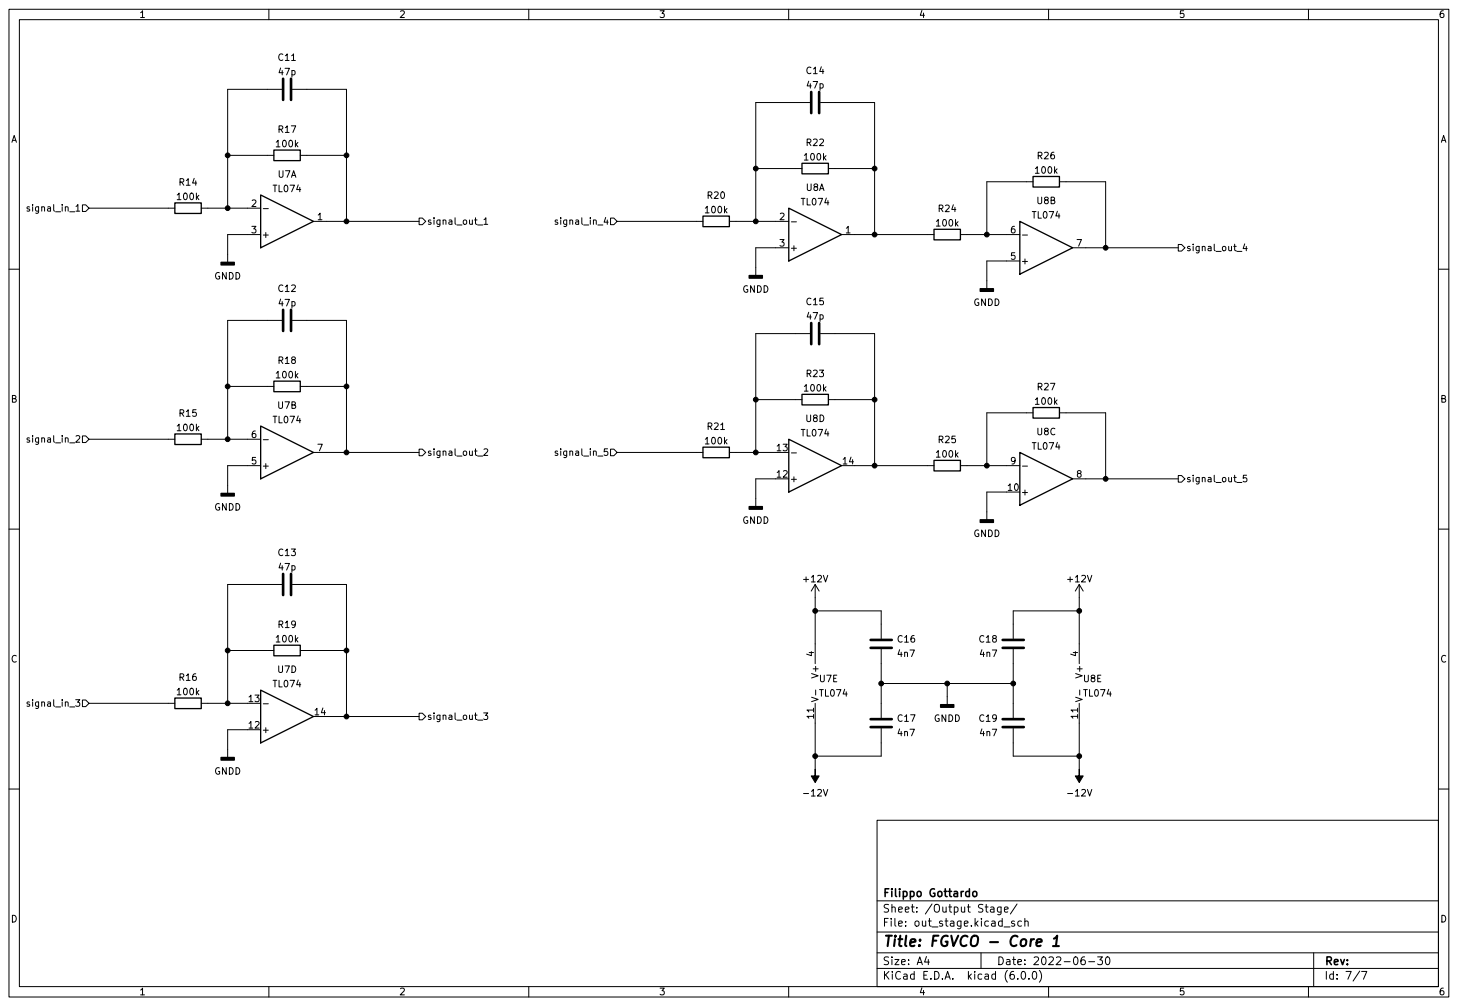
[picture p172: page 8]

Filippo Gottardo
Sheet: /Output Stage/
File: out_stage.kicad_sch
Id: 7/7 Title: FGVCO - Core 1

# CLK_in U/D

# conn_signals_1 GNDD

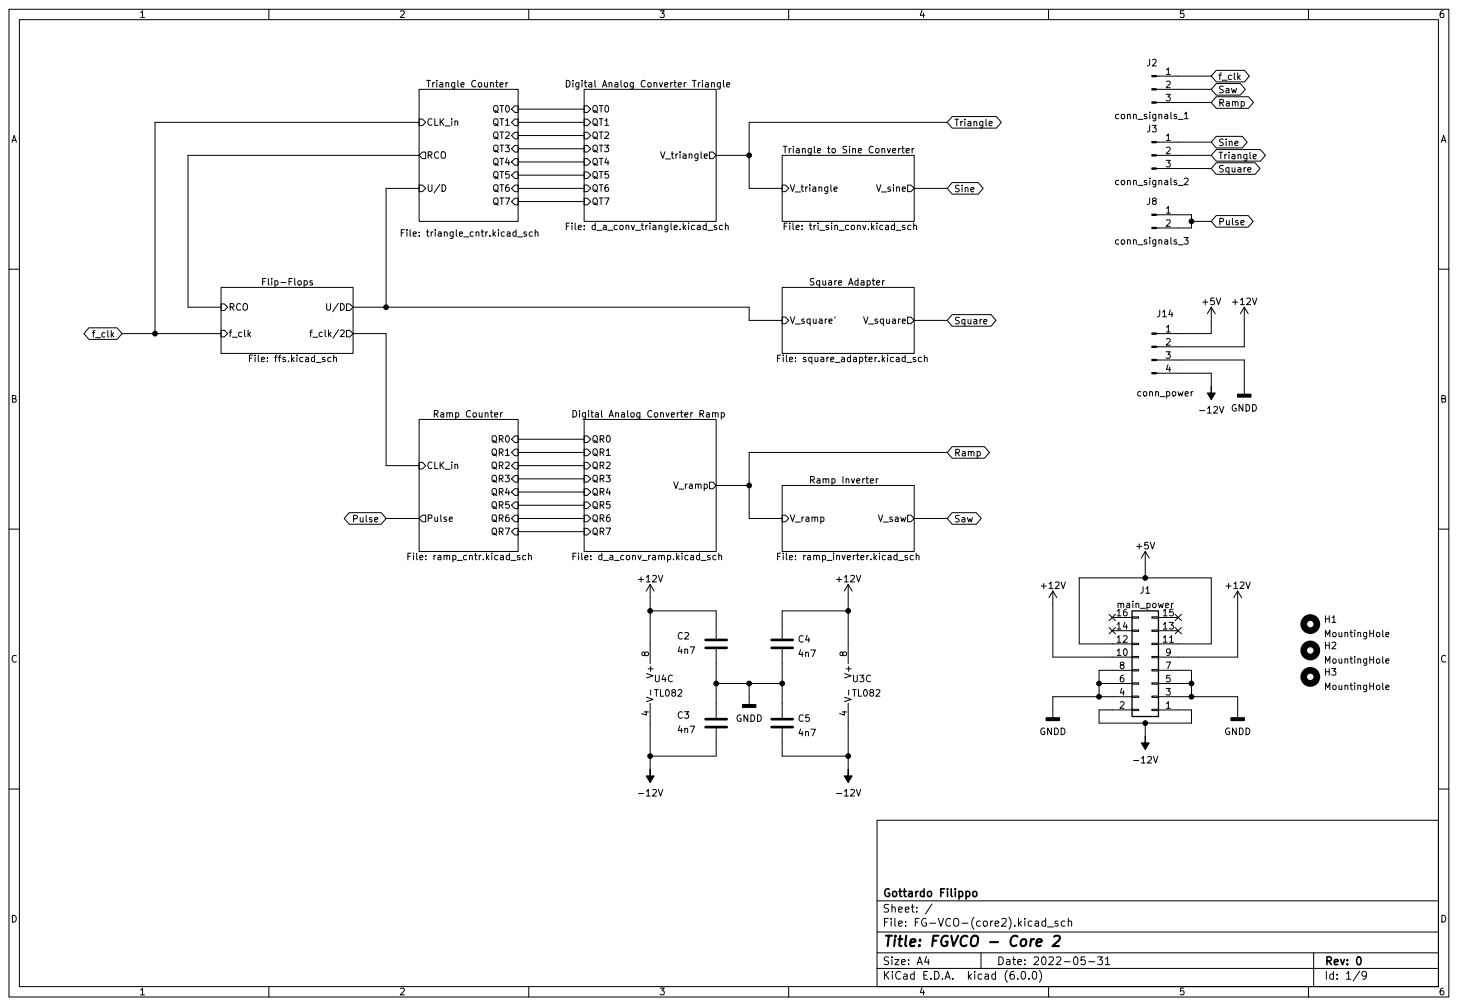
[picture p173: page 9]

V_triangle QT7 QT5 QT4 QT6 QT2 QT1 QT0 QT3 Digital Analog Converter Triangle

File: FG-VCO-(core2).kicad_sch Sheet: / Gottardo Filippo

Id: 1/9 Title: FGVCO - Core 2

# 100n +12V GNDD -12V C17

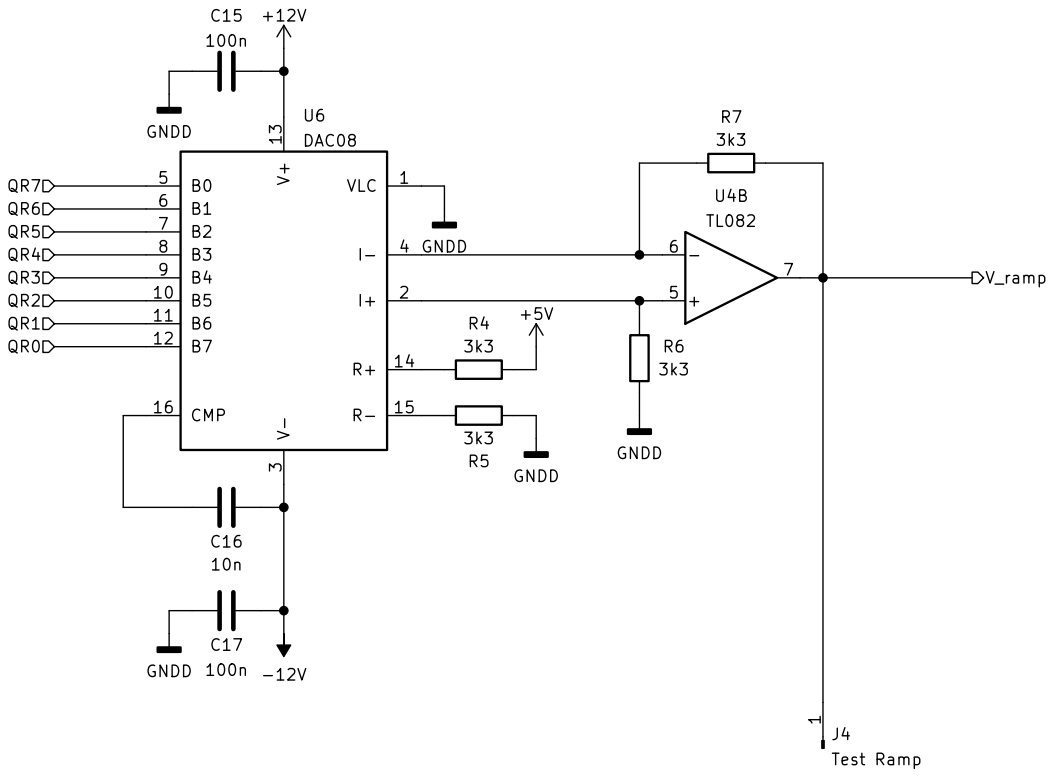
[picture p174: page 10]

Sheet: /Digital Analog Converter Ramp/
File: d_a_conv_ramp.kicad_sch
Id: 5/9 Title: FGVCO - Core 2

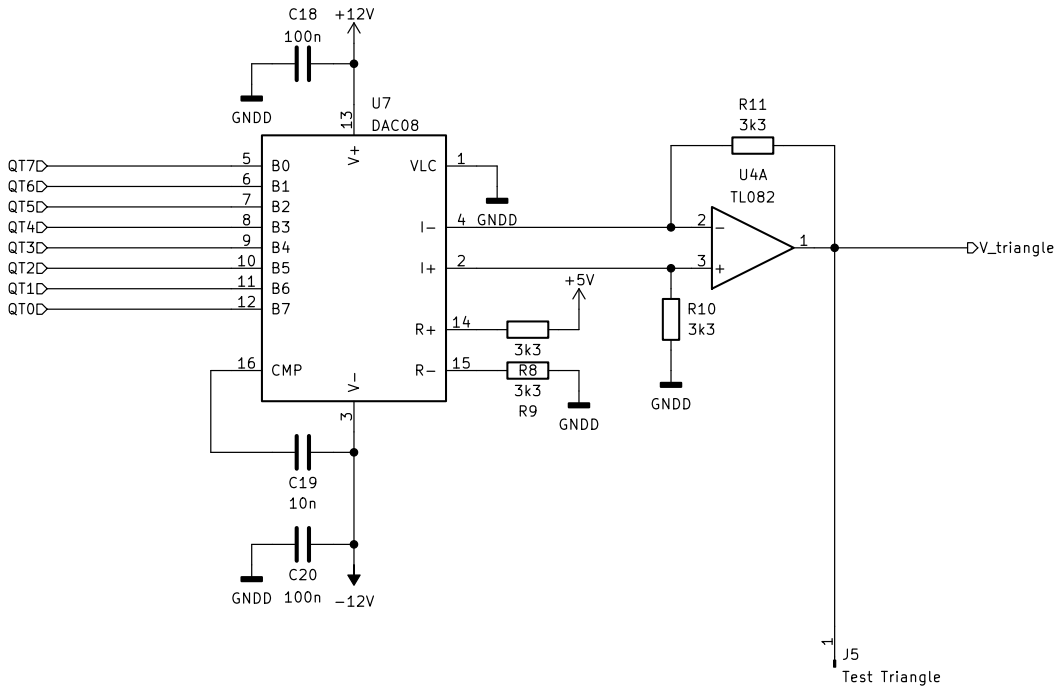
[picture p175: page 11]

Sheet: /Digital Analog Converter Triangle/
File: d_a_conv_triangle.kicad_sch
Id: 7/9 Title: FGVCO - Core 2

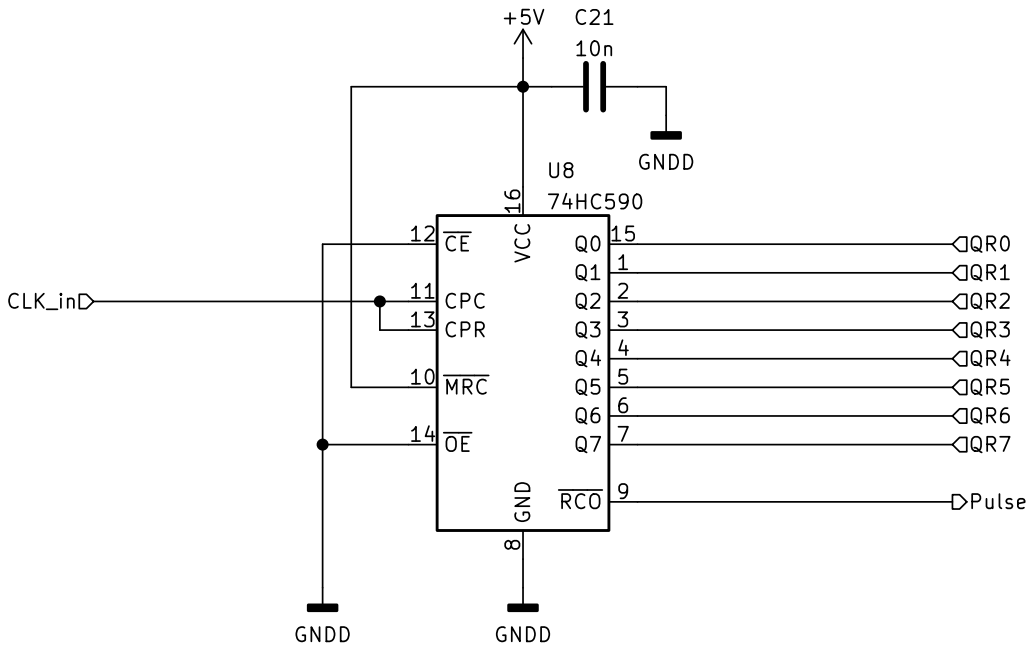
[picture p176: page 12]

Gottardo Filippo
Sheet: /Ramp Counter/
File: ramp_cntr.kicad_sch
Id: 7/9 Title: FGVCO - Core 2

# 100n GNDD

# 100n GNDD

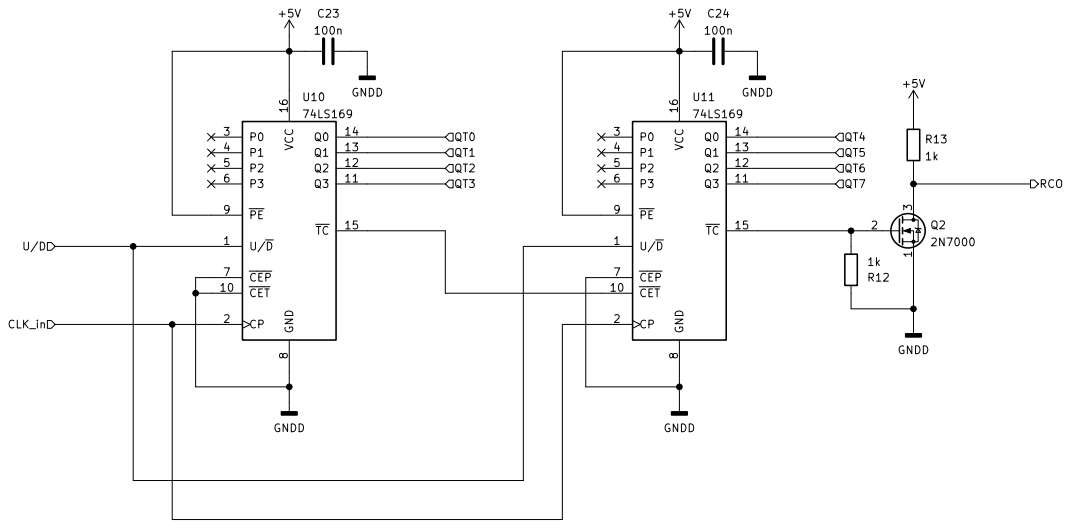
[picture p177: page 13]

Gottardo Filippo
Sheet: /Triangle Counter/
File: triangle_cntr.kicad_sch
Id: 8/9 Title: FGVCO - Core 2

3V3 R14

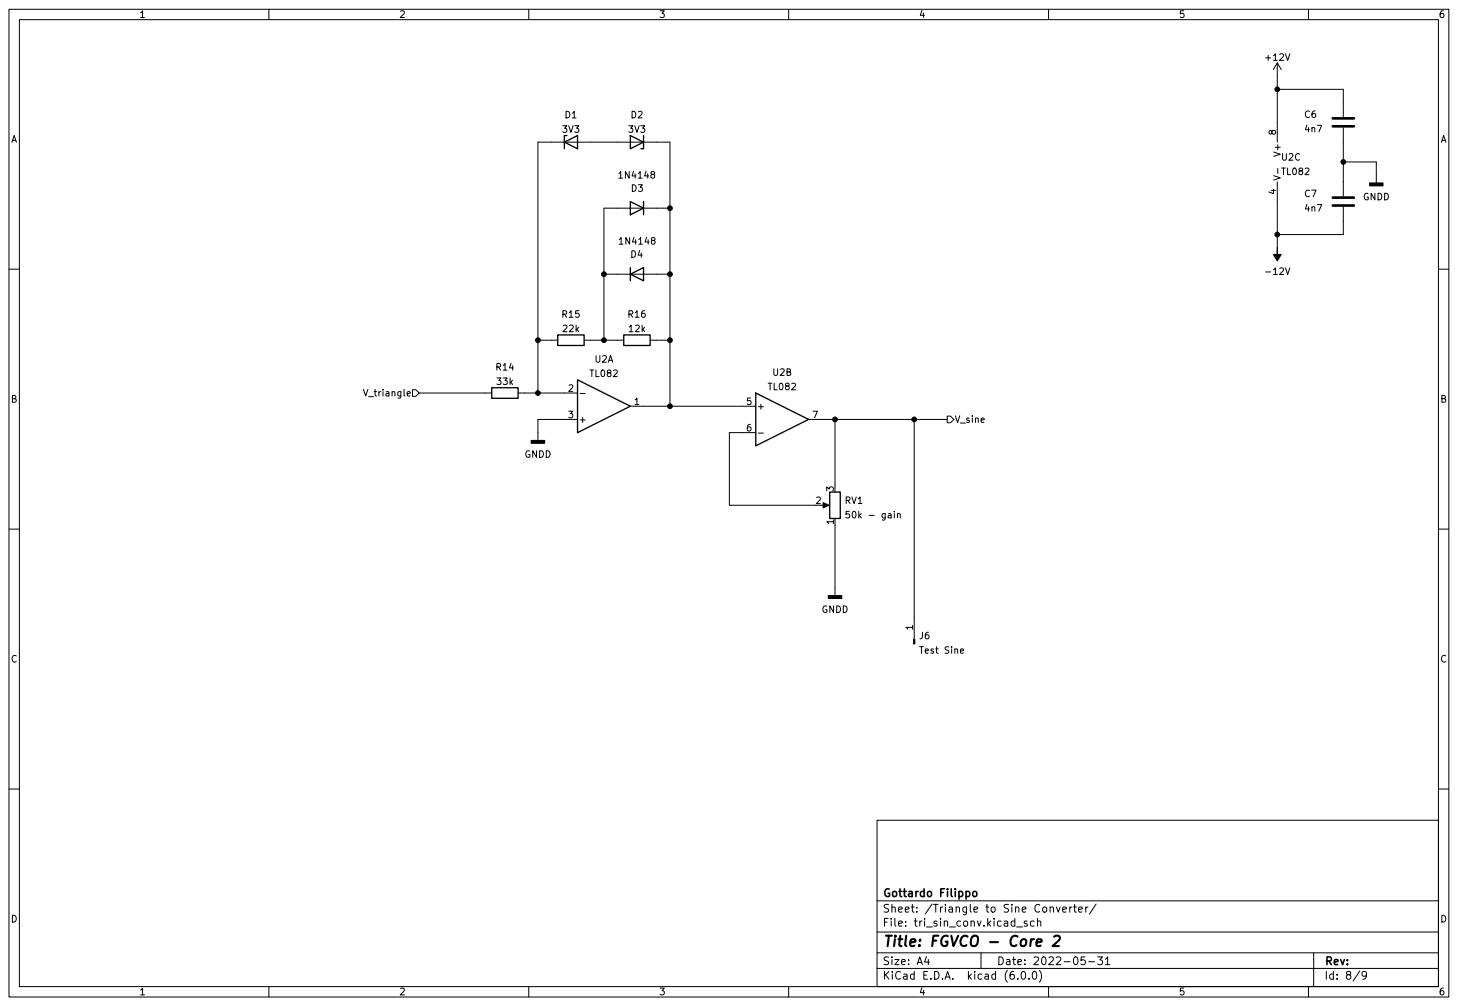
[picture p178: page 14]

Gottardo Filippo
Sheet: /Triangle to Sine Converter/
File: tri_sin_conv.kicad_sch
Id: 8/9 Title: FGVCO - Core 2

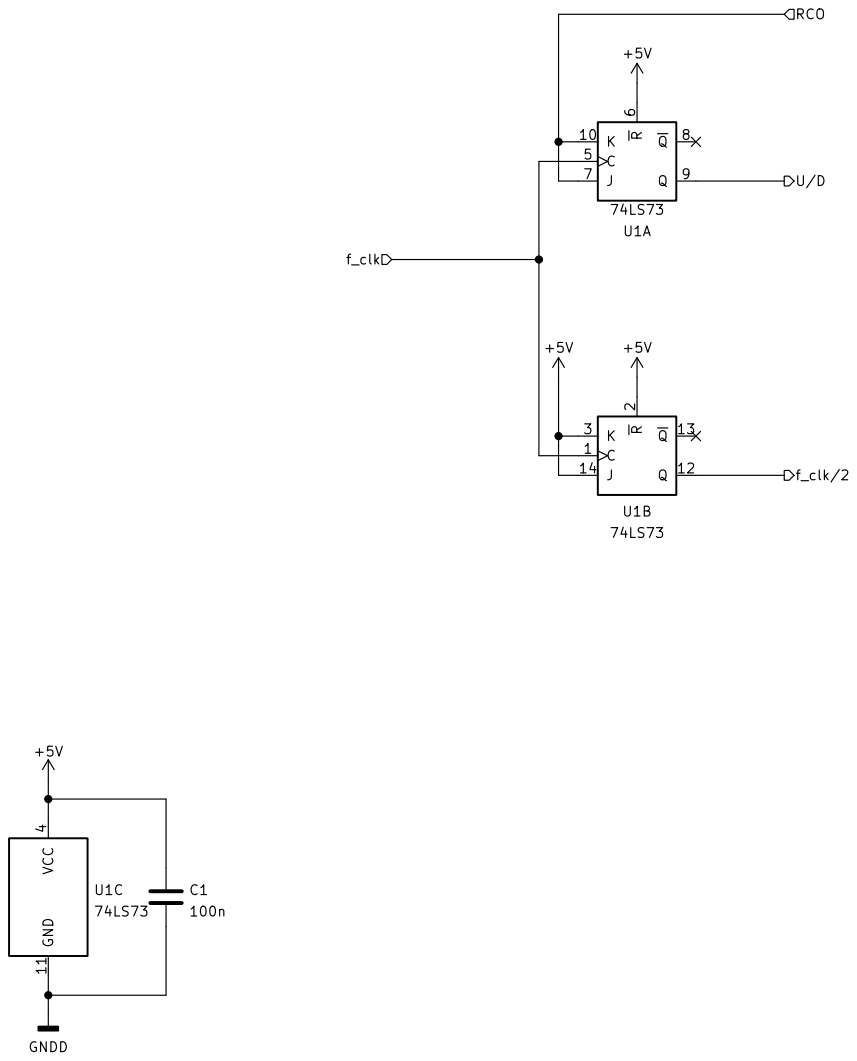
[picture p179: page 15]
D Date: 2022-05-31 KiCad E.D.A. kicad (6.0.0) Size: A4; Rev:; +5V GNDD; 74LS73 GND 11 VCC; f_clk/2; f_clk; RCO

Gottardo Filippo
Sheet: /Flip-Flops/
File: ffs.kicad_sch
Id: 9/9 Title: FGVCO - Core 2

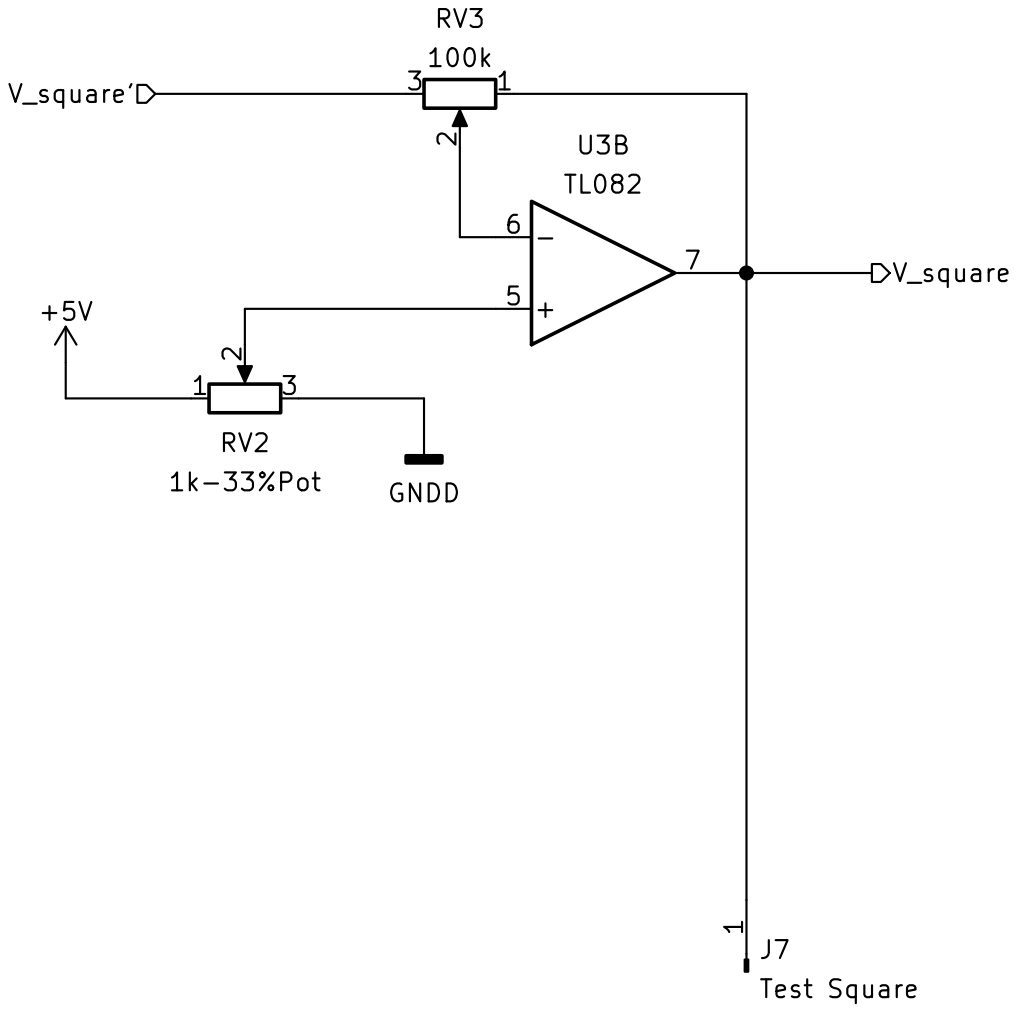
[picture p180: page 16]
D Date: 2022-05-31 KiCad E.D.A. kicad (6.0.0) Size: A4; Rev:; 1k-33%Pot; GNDD; J7Test Square +5V; V_square; V_square'

Gottardo Filippo
Sheet: /Square Adapter/
File: square_adapter.kicad_sch
Id: 10/9 Title: FGVCO - Core 2

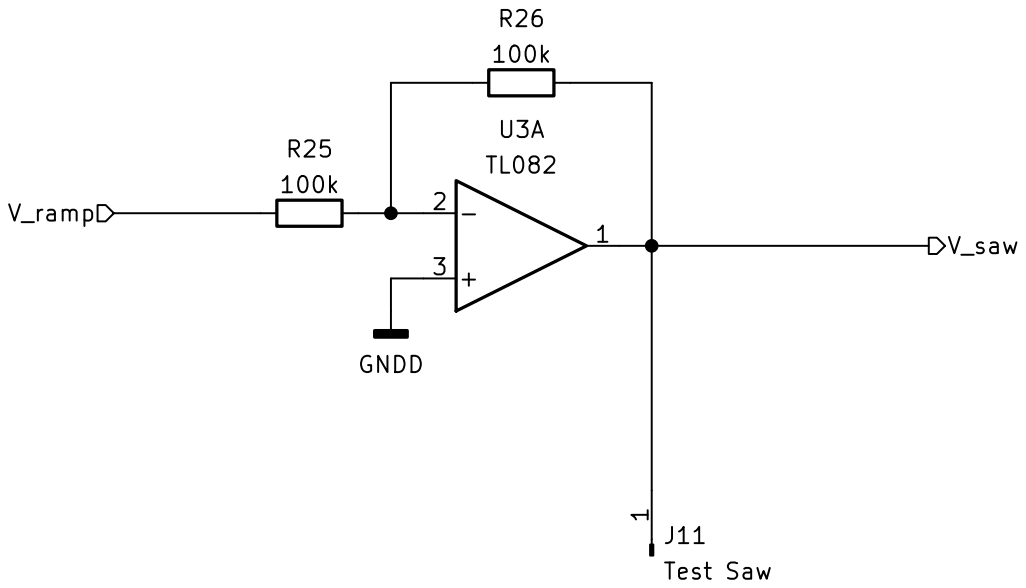
[picture p181: page 17]
D Date: 2022-05-31 KiCad E.D.A. kicad (6.0.0) Size: A4; Rev:; V_saw; V_ramp

J11 Test Saw GNDD

Gottardo Filippo
Sheet: /Ramp Inverter/
File: ramp_inverter.kicad_sch
Id: 11/9 Title: FGVCO - Core 2
