PippoGot/FGVCO/Elaborato Scritto/pdfs/schematics/FG-VCO-(core1).pdf

File: FG-VCO-(core1).kicad_sch Sheet: / Filippo Gottardo

Id: 1/7 Title: FGVCO - Core 1


Sheet: /Summer-Clipper/
File: sum_clip.kicad_sch
Id: 2/7 Title: FGVCO - Core 1


File: v_oct_conv.kicad_sch Sheet: /Volt-Octave Converter/ Filippo Gottardo V- 11 V+

Id: 3/7 Title: FGVCO - Core 1


File: mode_selector.kicad_sch Sheet: /Mode Selector/ Filippo Gottardo

Id: 4/7 Title: FGVCO - Core 1


Sheet: /Voltage-Freq Converter/
File: v_f_conv.kicad_sch
Id: 5/7 Title: FGVCO - Core 1


File: monostable_circuit.kicad_sch Sheet: /Monostable Circuit/ Filippo Gottardo C10
100p GNDD

Id: 6/7 Title: FGVCO - Core 1


Filippo Gottardo
Sheet: /Output Stage/
File: out_stage.kicad_sch
Id: 7/7 Title: FGVCO - Core 1
