PippoGot/FGVCO/Elaborato Scritto/pdfs/schematics/FG-VCO-(core2).pdf

V_triangle QT7 QT5 QT4 QT6 QT2 QT1 QT0 QT3 Digital Analog Converter Triangle

File: FG-VCO-(core2).kicad_sch Sheet: / Gottardo Filippo

Id: 1/9 Title: FGVCO - Core 2


Sheet: /Digital Analog Converter Ramp/
File: d_a_conv_ramp.kicad_sch
Id: 5/9 Title: FGVCO - Core 2


Sheet: /Digital Analog Converter Triangle/
File: d_a_conv_triangle.kicad_sch
Id: 7/9 Title: FGVCO - Core 2


Gottardo Filippo
Sheet: /Ramp Counter/
File: ramp_cntr.kicad_sch
Id: 7/9 Title: FGVCO - Core 2


Gottardo Filippo
Sheet: /Triangle Counter/
File: triangle_cntr.kicad_sch
Id: 8/9 Title: FGVCO - Core 2

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


Gottardo Filippo
Sheet: /Flip-Flops/
File: ffs.kicad_sch
Id: 9/9 Title: FGVCO - Core 2


Gottardo Filippo
Sheet: /Square Adapter/
File: square_adapter.kicad_sch
Id: 10/9 Title: FGVCO - Core 2


Gottardo Filippo
Sheet: /Ramp Inverter/
File: ramp_inverter.kicad_sch
Id: 11/9 Title: FGVCO - Core 2
