PippoGot/FGVCO/Elaborato Scritto/pdfs/schematics/FG-VCO-(complete) turned.pdf

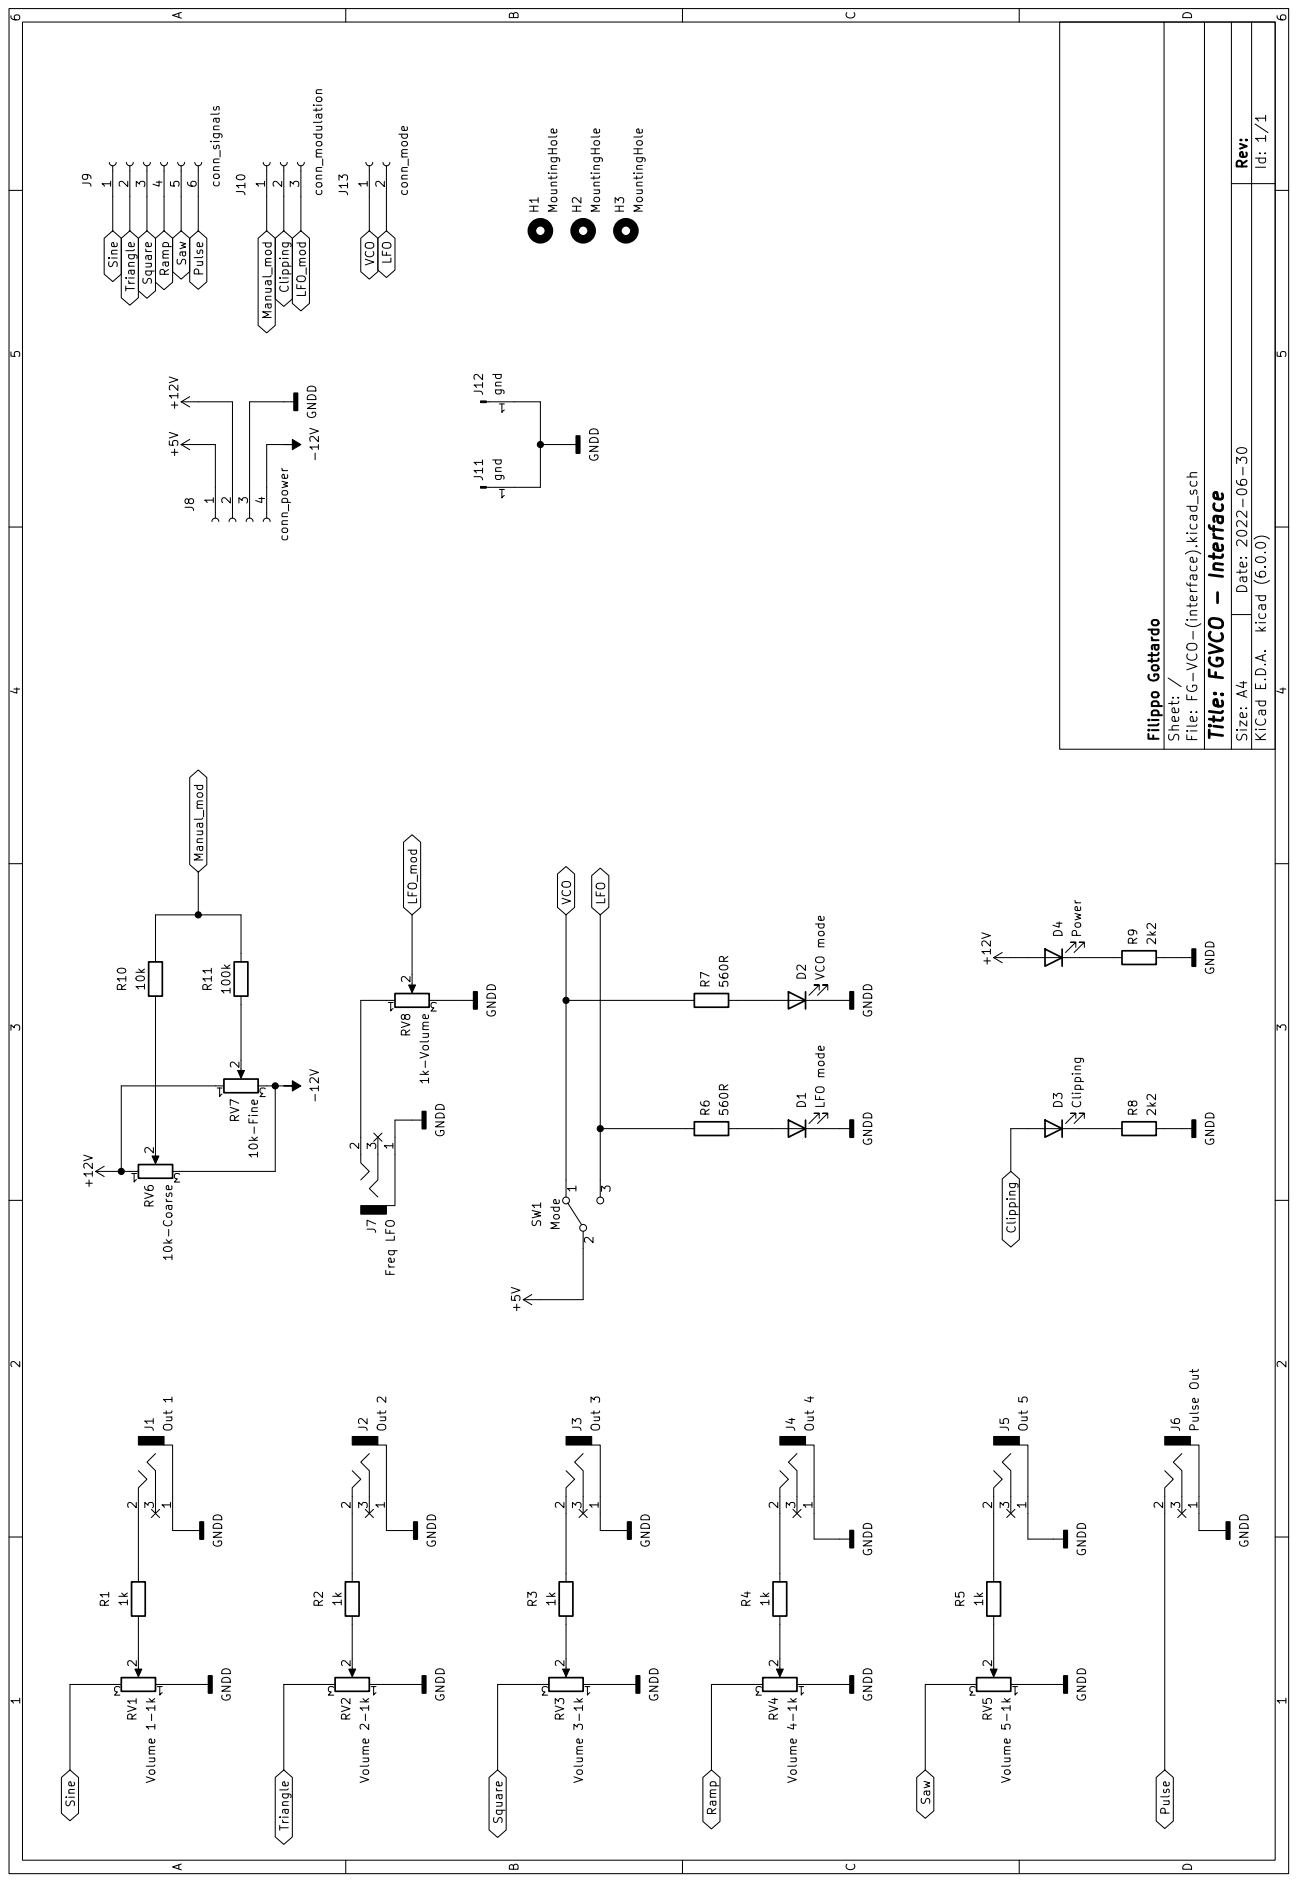
[picture p182: page 1]

D Date: 2022-06-30 KiCad E.D.A. kicad (6.0.0) Rev: Size: A4

Id: 1/1 Filippo Gottardo Sheet: / File: FG-VCO-(interface).kicad_sch

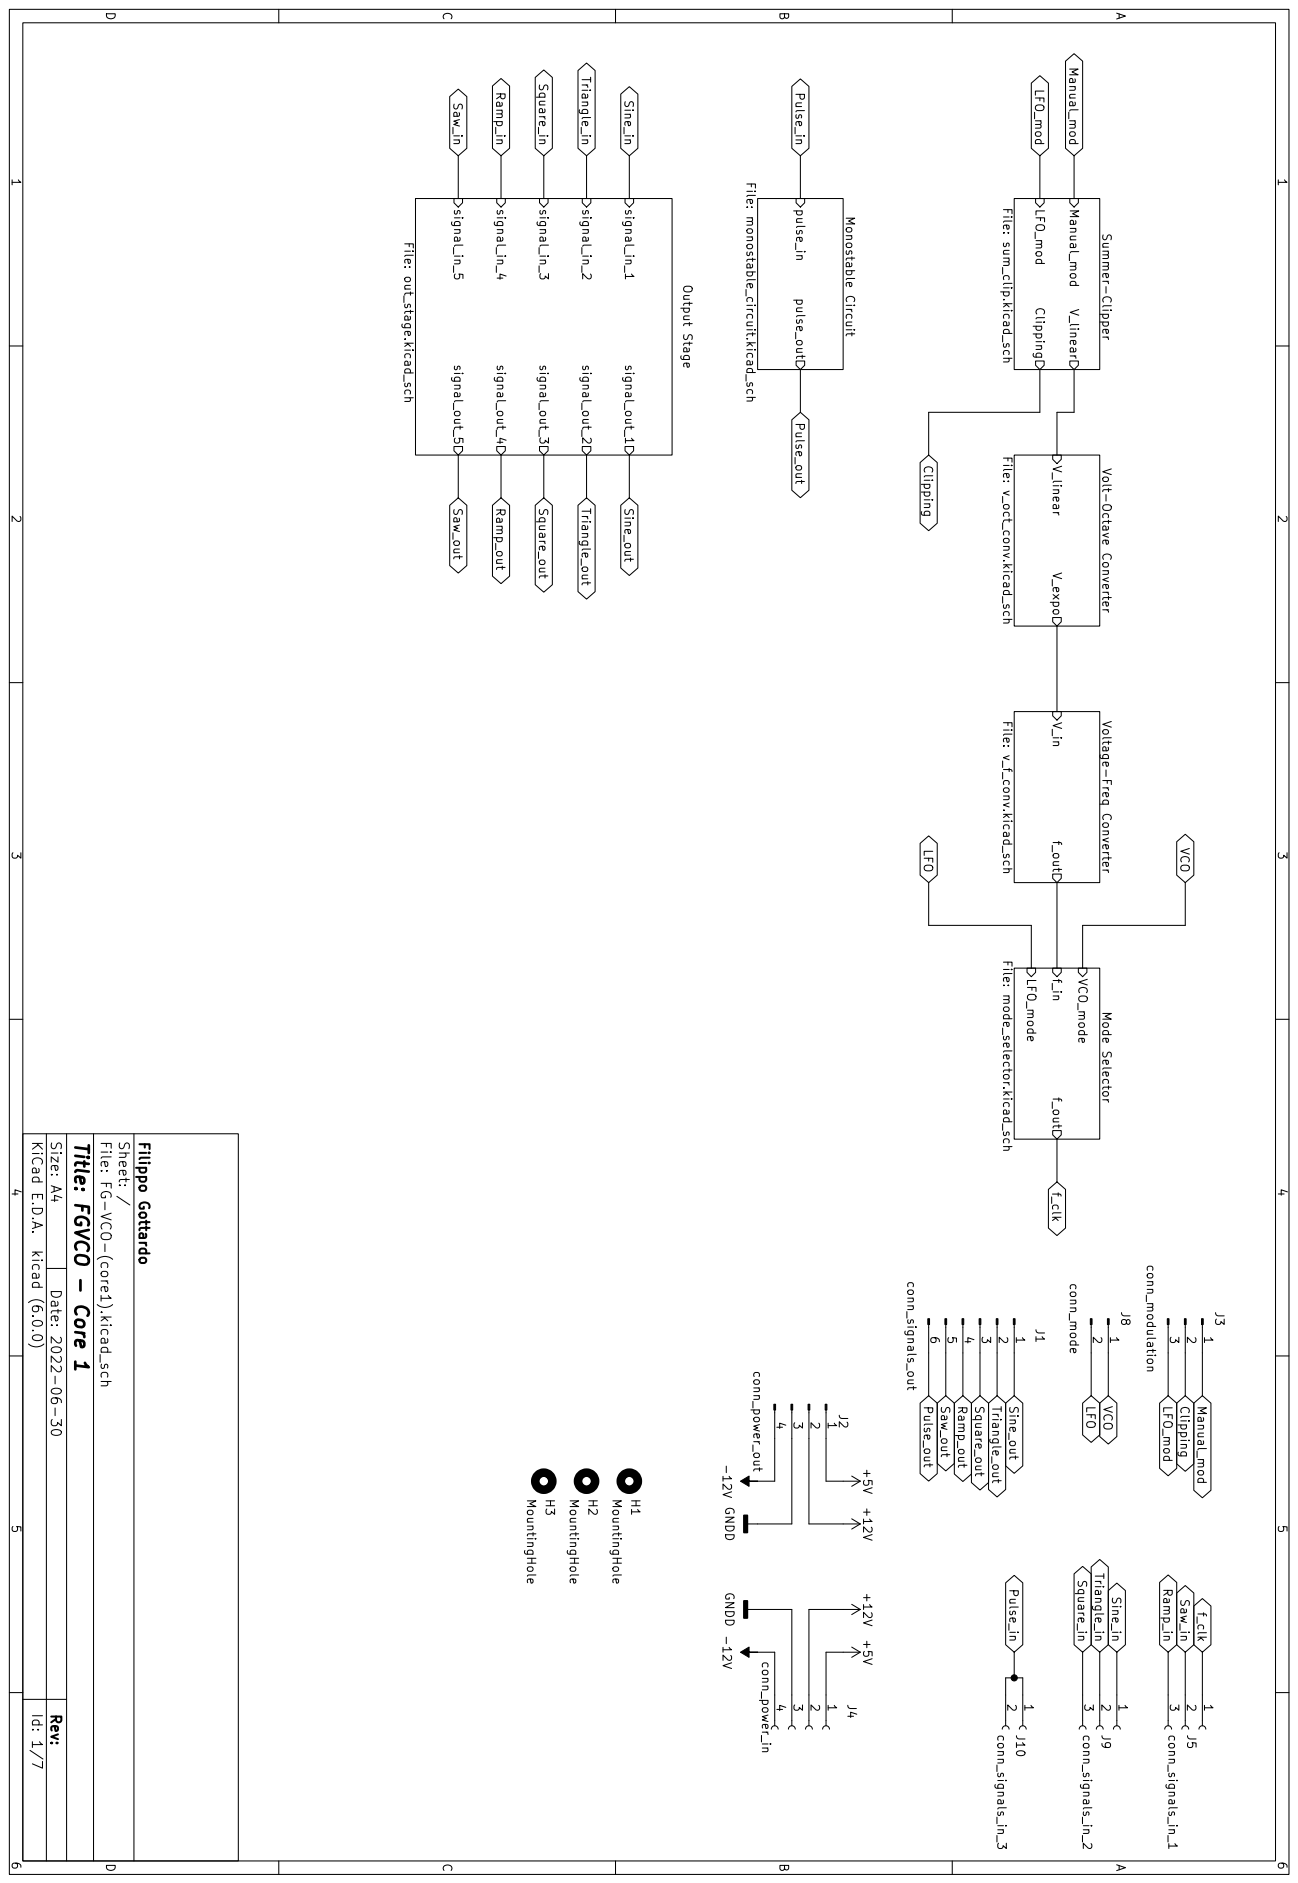
[picture p183: page 2]

pulse_out pulse_in Monostable Circuit File: monostable_circuit.kicad_sch V_linear LFO_mod Manual_mod Clipping

V_expo V_linear Volt-Octave Converter File: v_oct_conv.kicad_sch MountingHole H3

f_out V_in File: v_f_conv.kicad_sch Voltage-Freq Converter

Date: 2022-06-30 KiCad E.D.A. kicad (6.0.0) Rev: Size: A4

Id: 1/7 Title: FGVCO - Core 1

File: FG-VCO-(core1).kicad_sch Sheet: / Filippo Gottardo

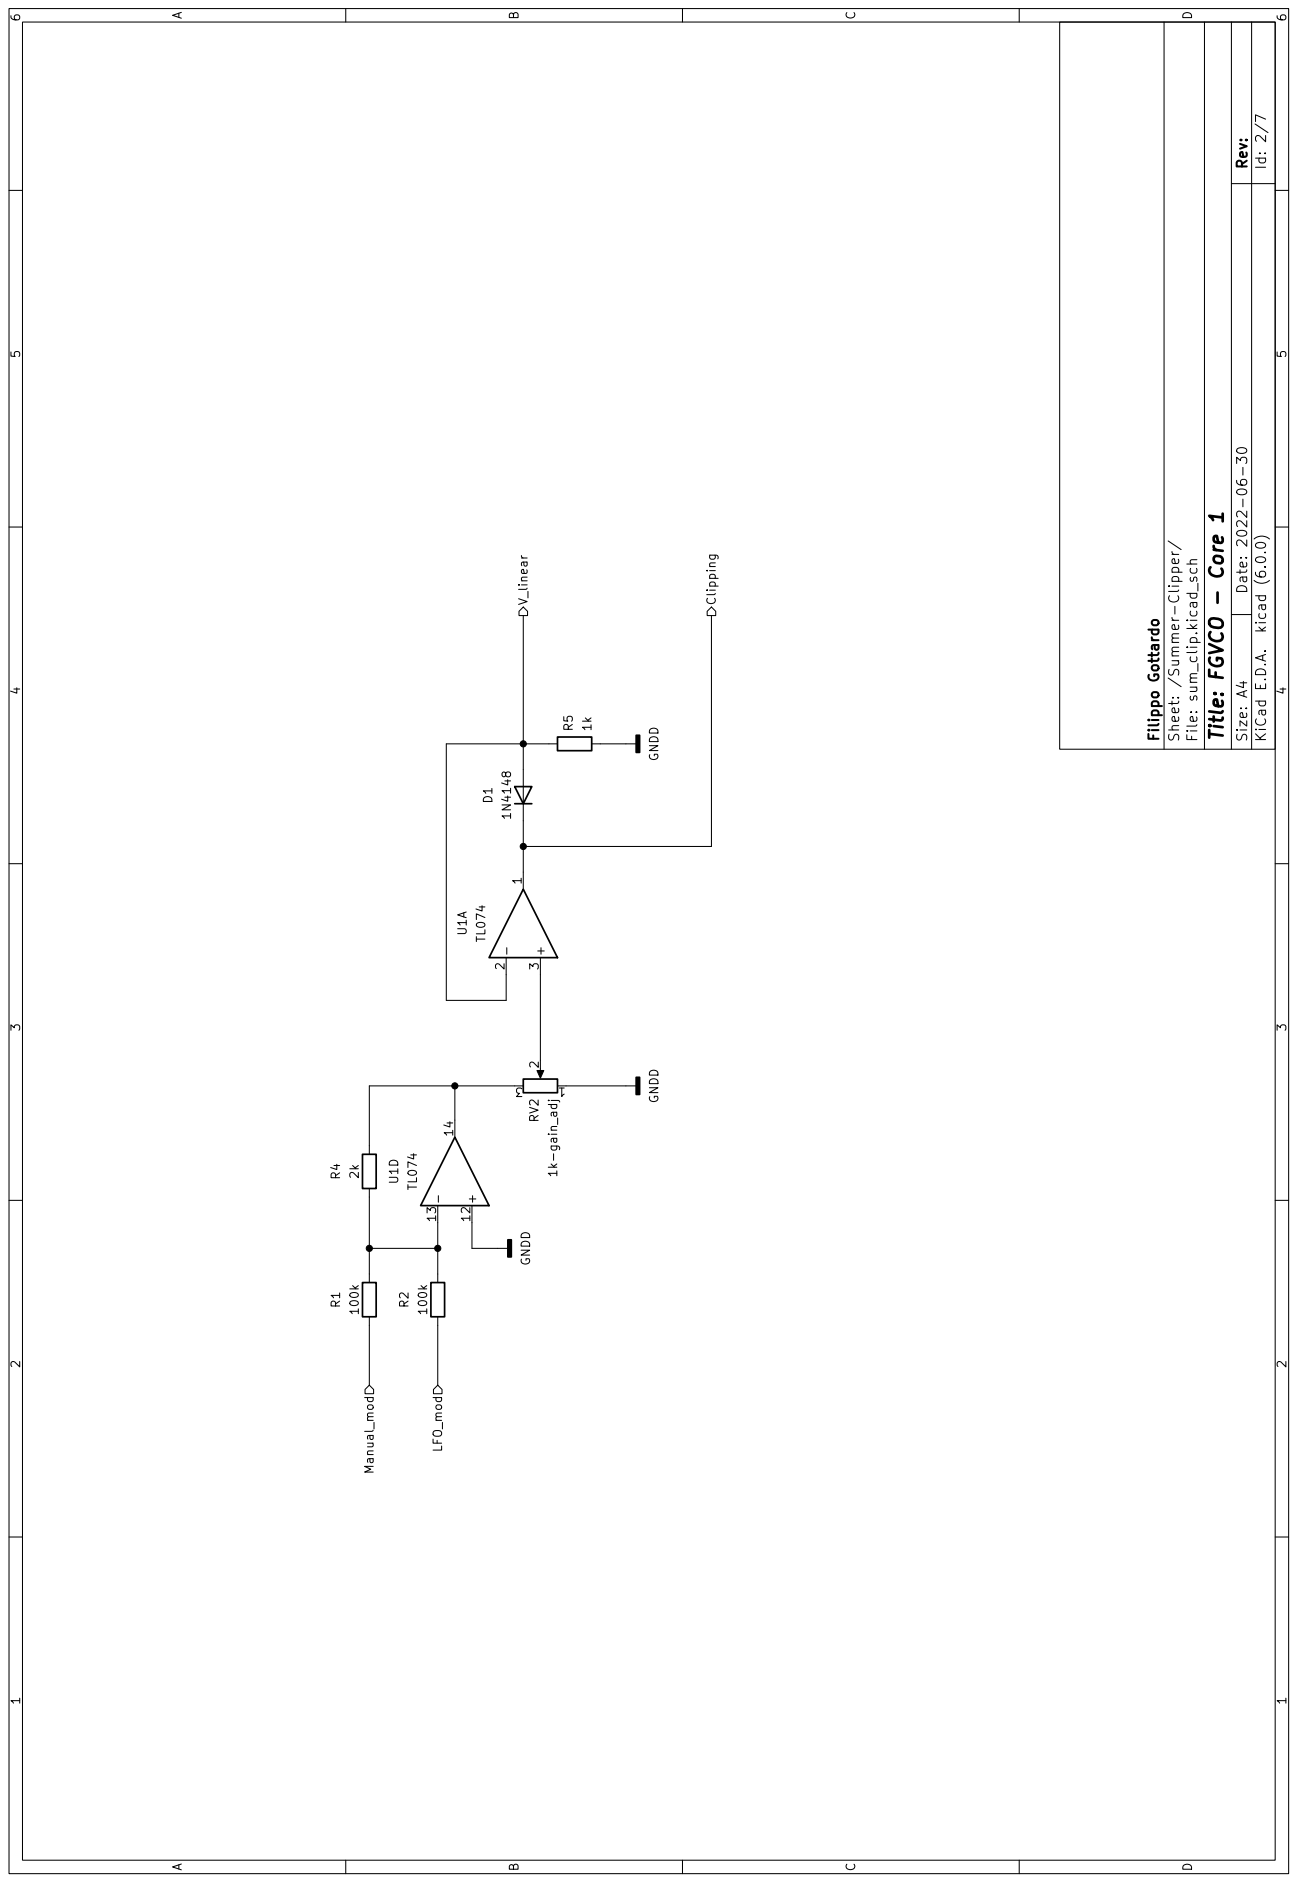
[picture p184: page 3]
File: sum_clip.kicad_sch; 1N4148 GNDD; 1k GNDD; 2 1k-gain_adj GNDD; 100k V_linear Clipping; LFO_mod Manual_mod

D Date: 2022-06-30 KiCad E.D.A. kicad (6.0.0) Rev: Size: A4

Id: 2/7 Filippo Gottardo

Title: FGVCO - Core 1

Sheet: /Summer-Clipper/

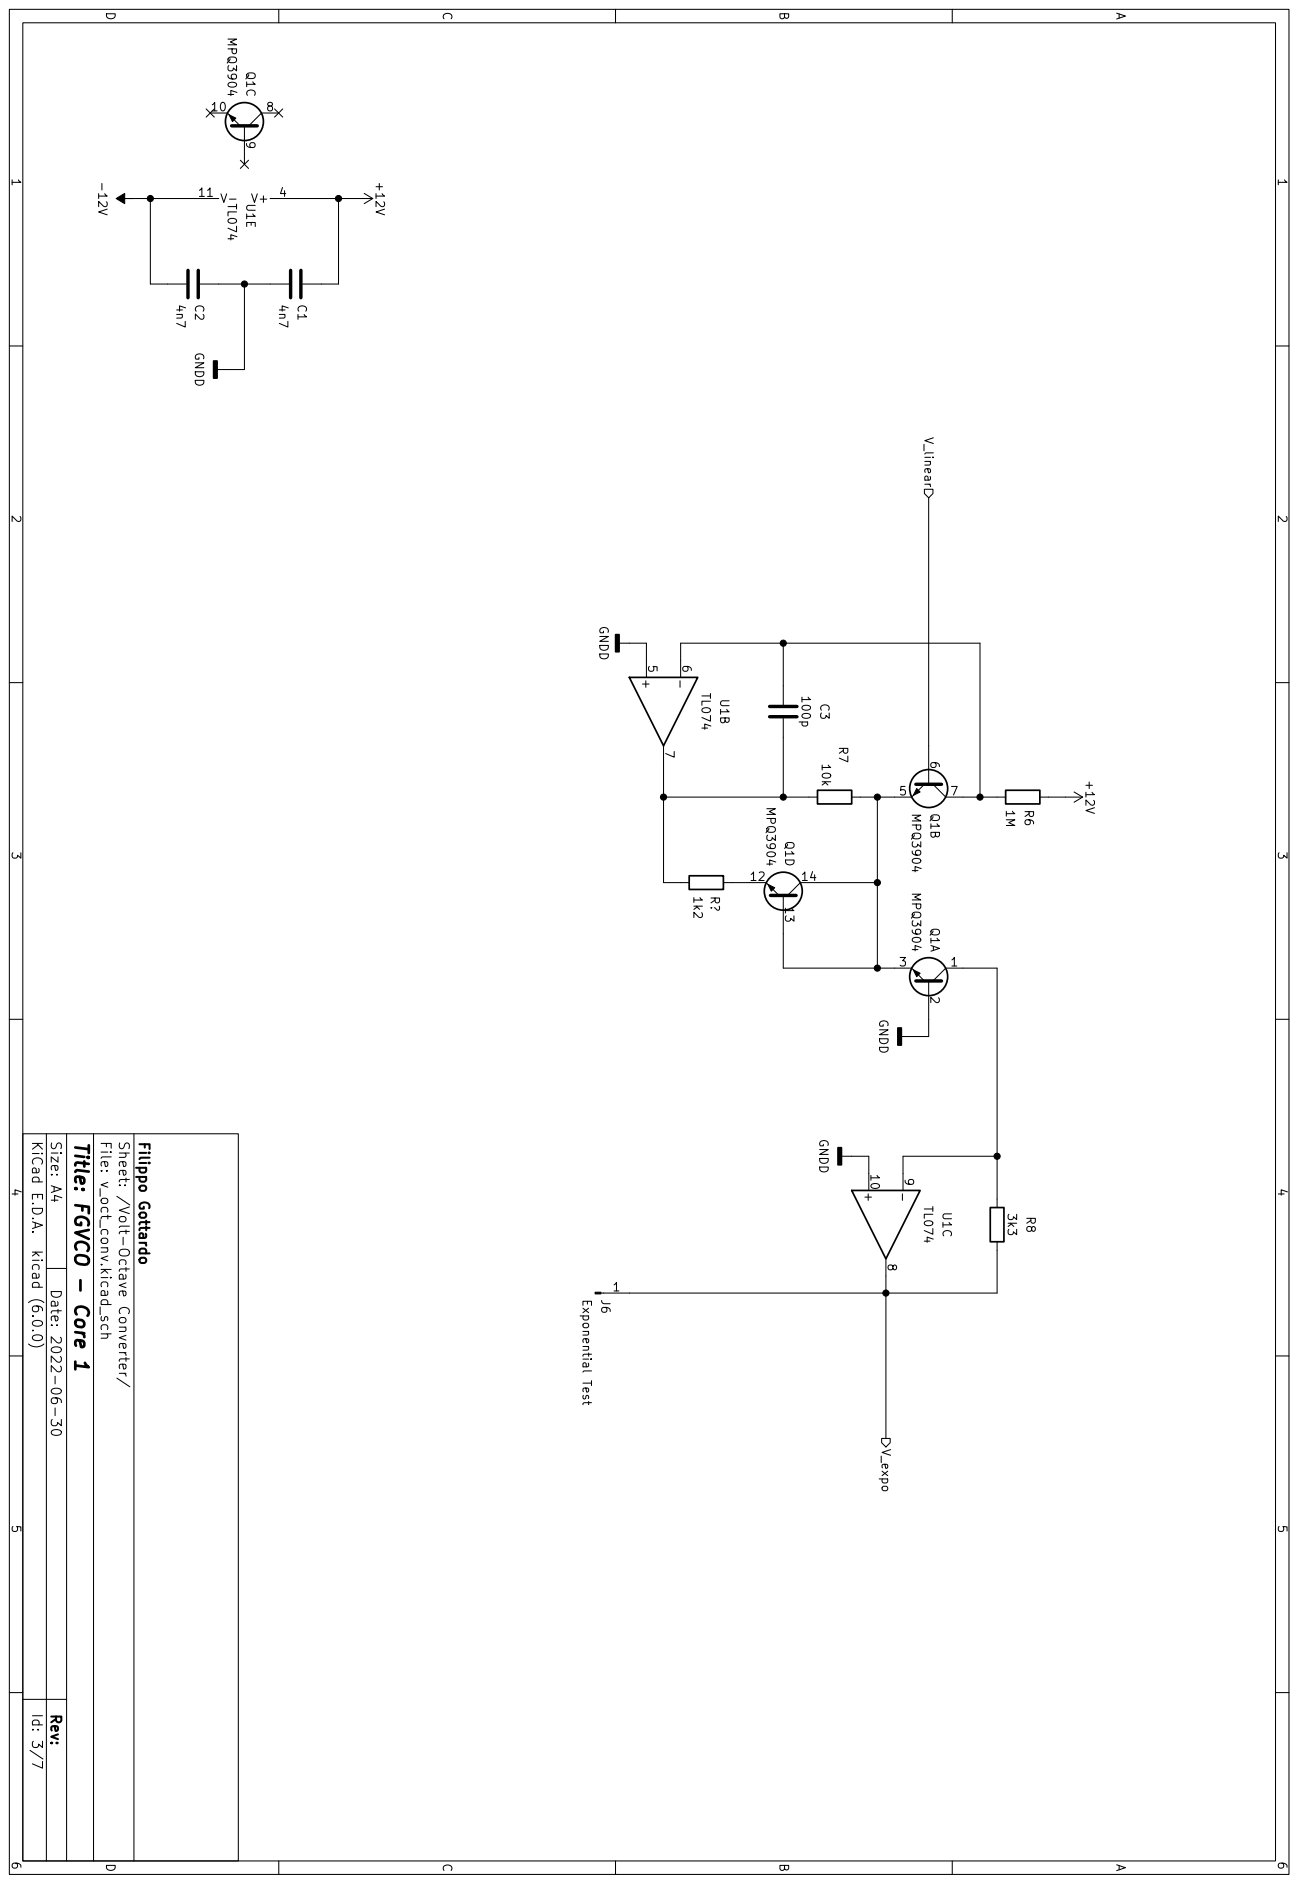
[picture p185: page 4]

Date: 2022-06-30 KiCad E.D.A. kicad (6.0.0) Rev: Size: A4

Id: 3/7 Title: FGVCO - Core 1

File: v_oct_conv.kicad_sch Sheet: /Volt-Octave Converter/ Filippo Gottardo

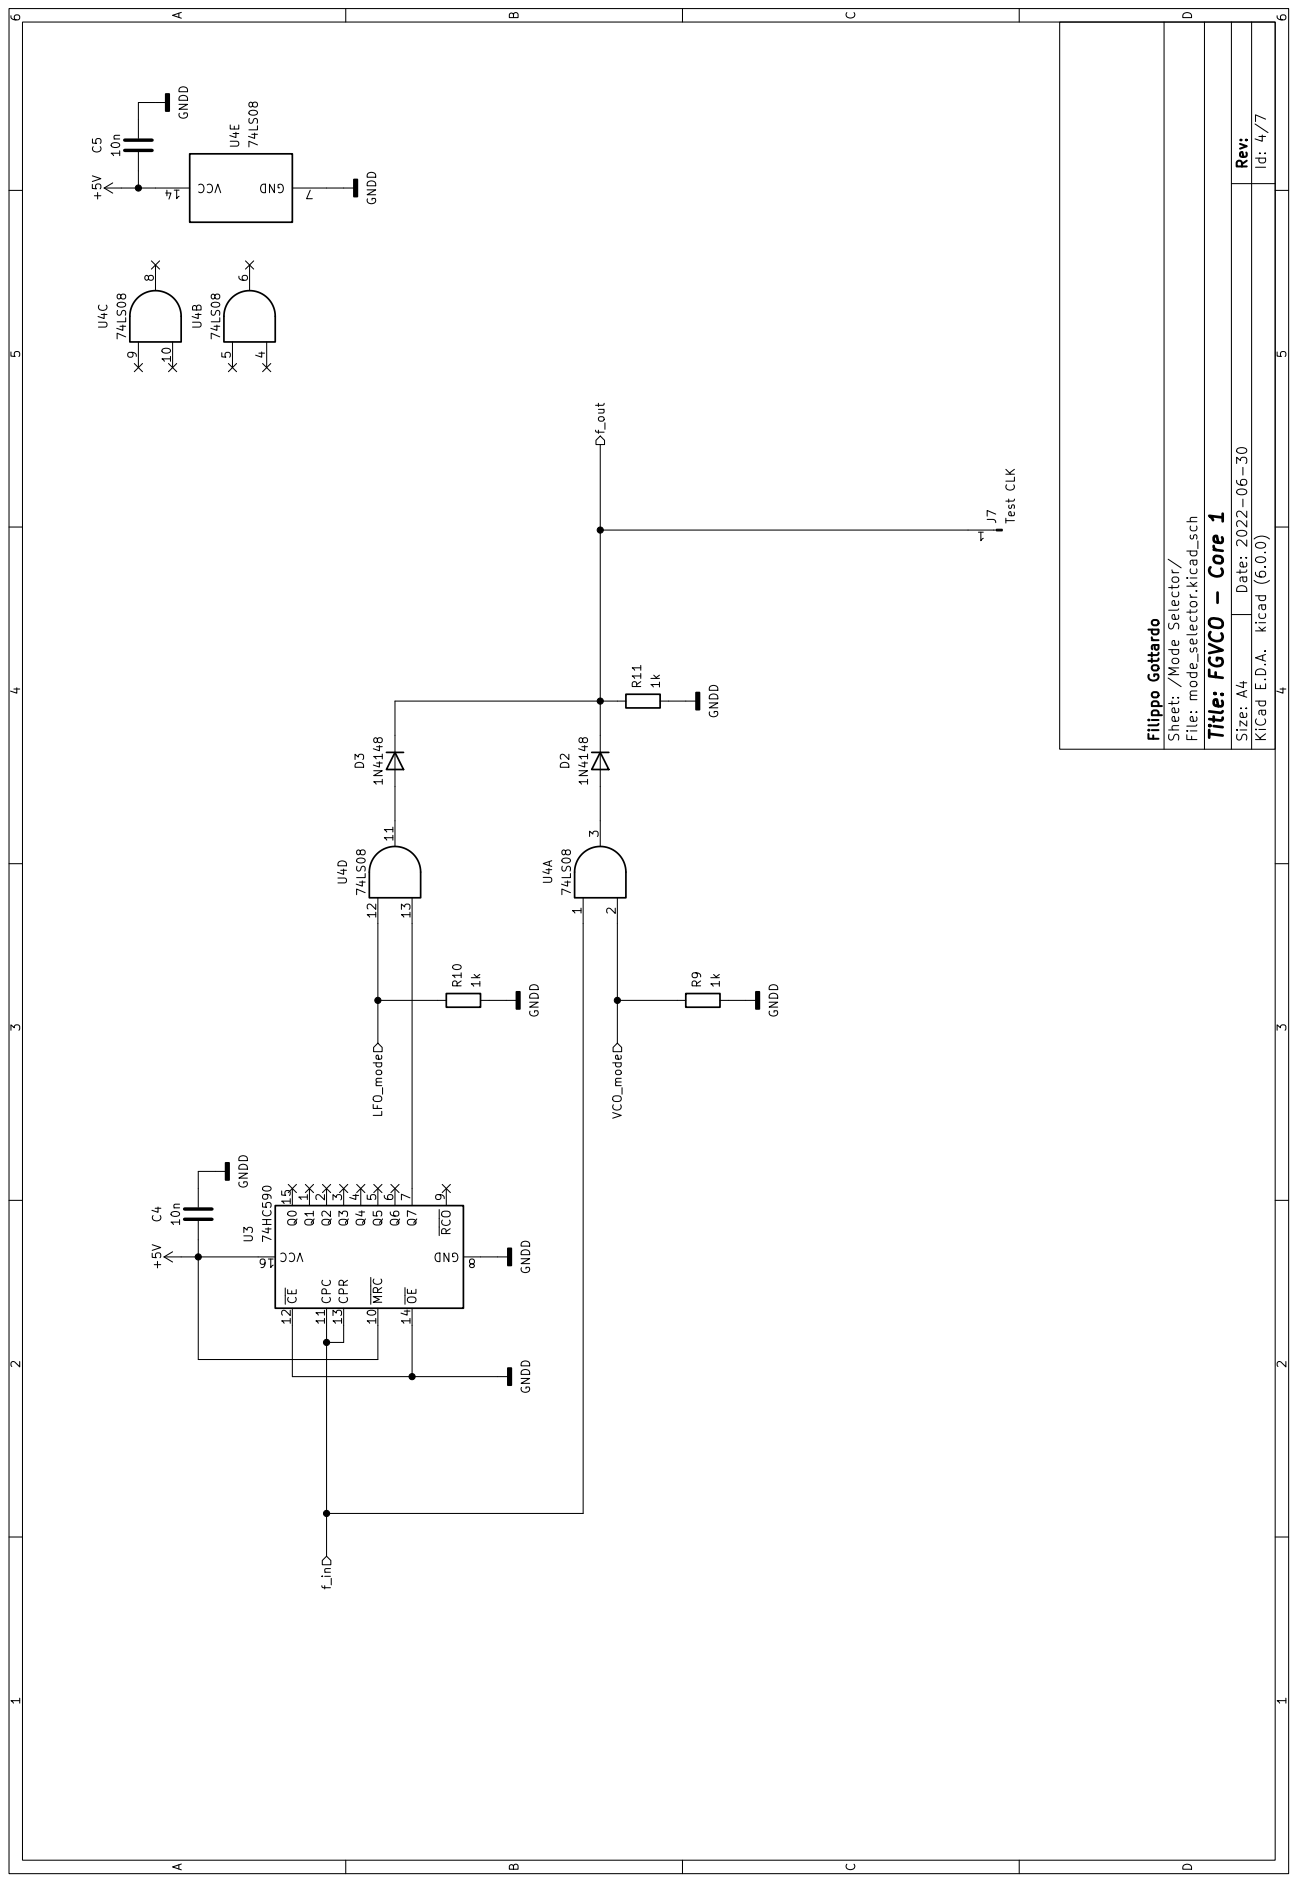
[picture p186: page 5]

D Date: 2022-06-30 KiCad E.D.A. kicad (6.0.0) Rev: Size: A4

Id: 4/7 Filippo Gottardo Sheet: /Mode Selector/ File: mode_selector.kicad_sch

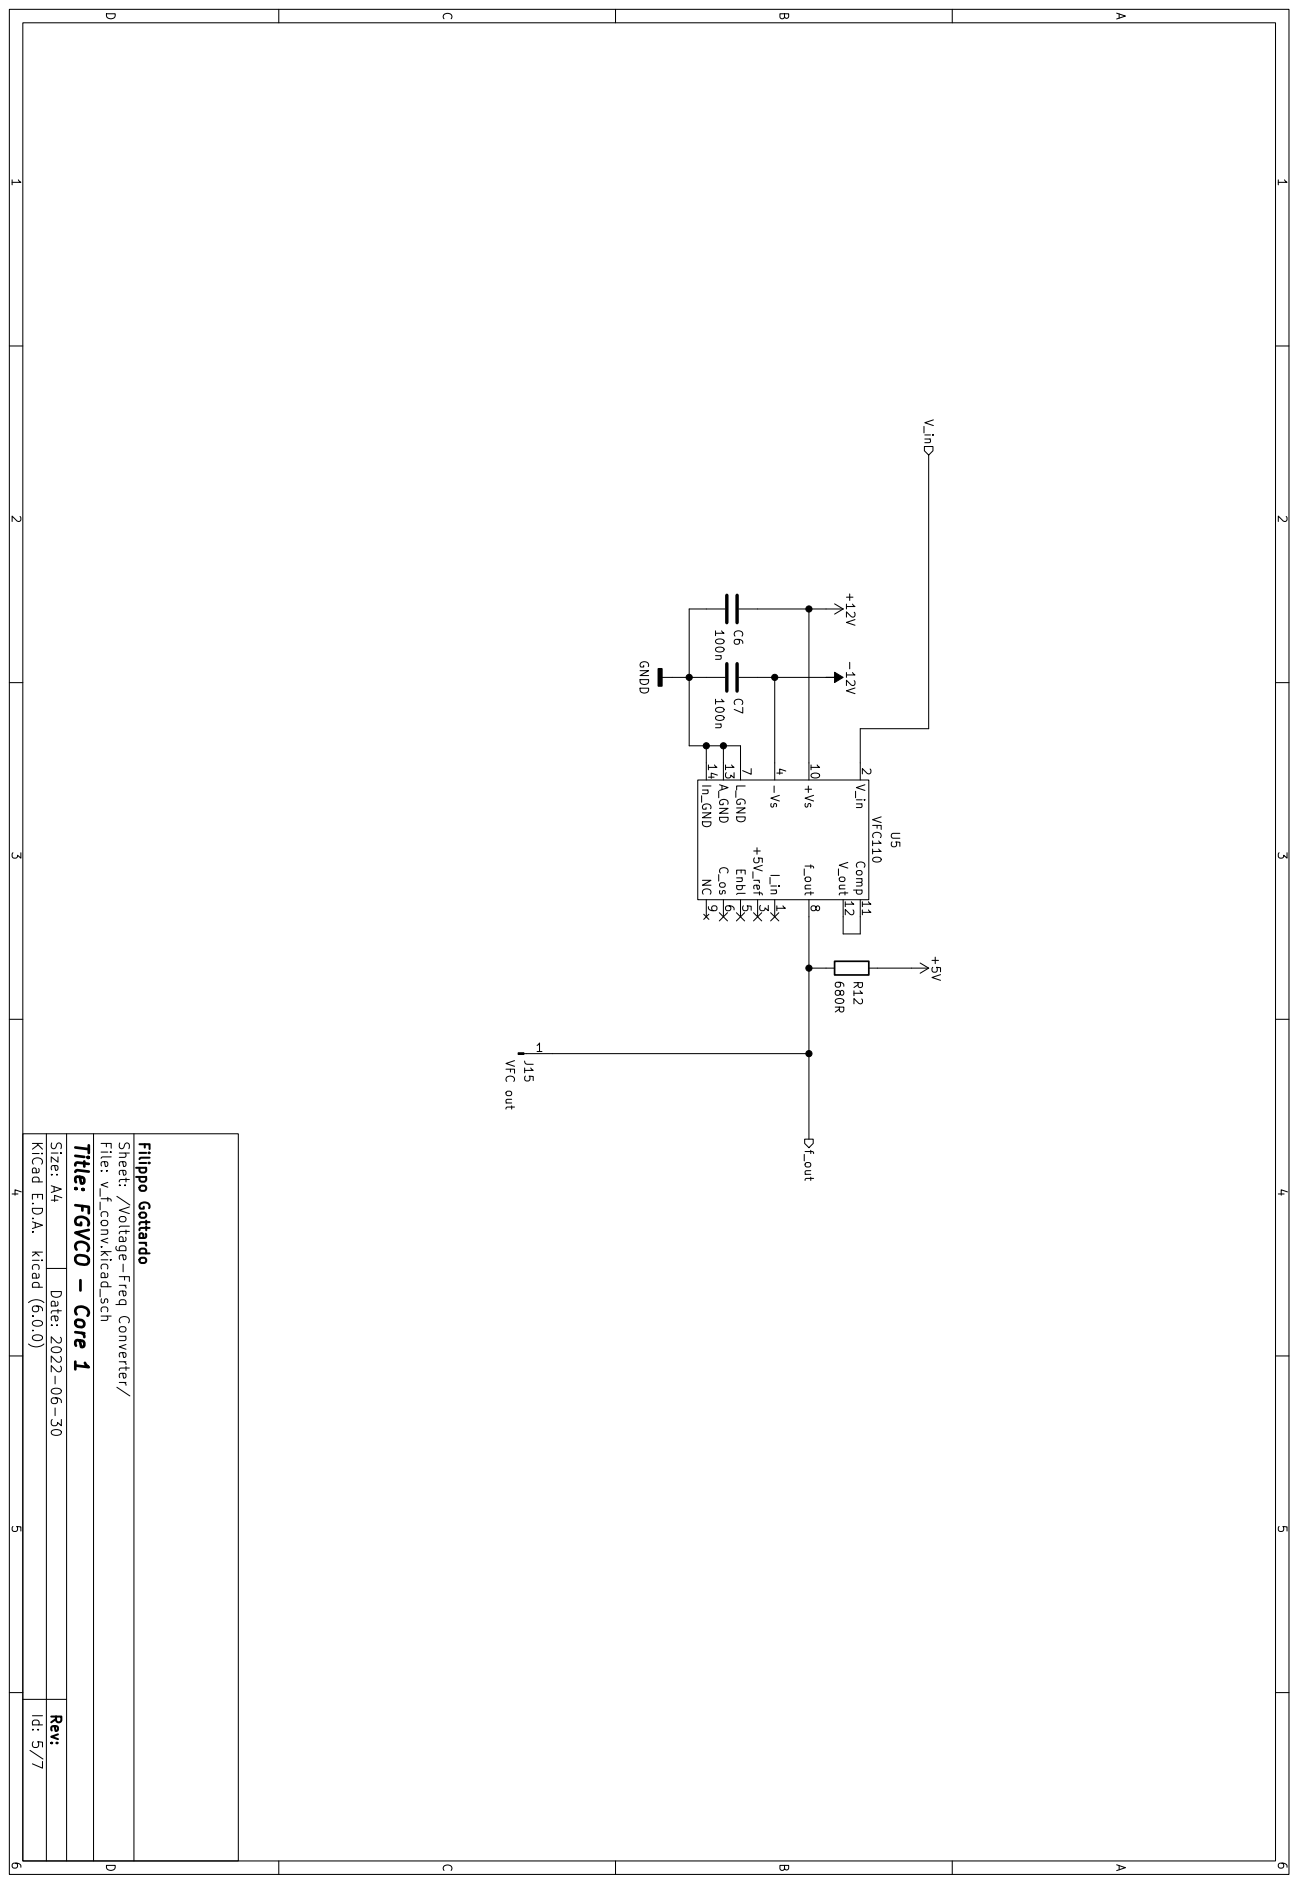
[picture p187: page 6]
File: v_f_conv.kicad_sch; 1 +Vs 10 Comp; 11 V_out 12 A_GND; In_GND; 14 V_in 2 +5V_ref 3; -Vs 4 Enbl 5 C_os 6 L_GND; f_out 8 NC; 9 U5 VFC110 +5V; 1 VFC out; f_out

Filippo Gottardo GNDD

Date: 2022-06-30 KiCad E.D.A. kicad (6.0.0) Rev: Size: A4

Id: 5/7 Title: FGVCO - Core 1

Sheet: /Voltage-Freq Converter/

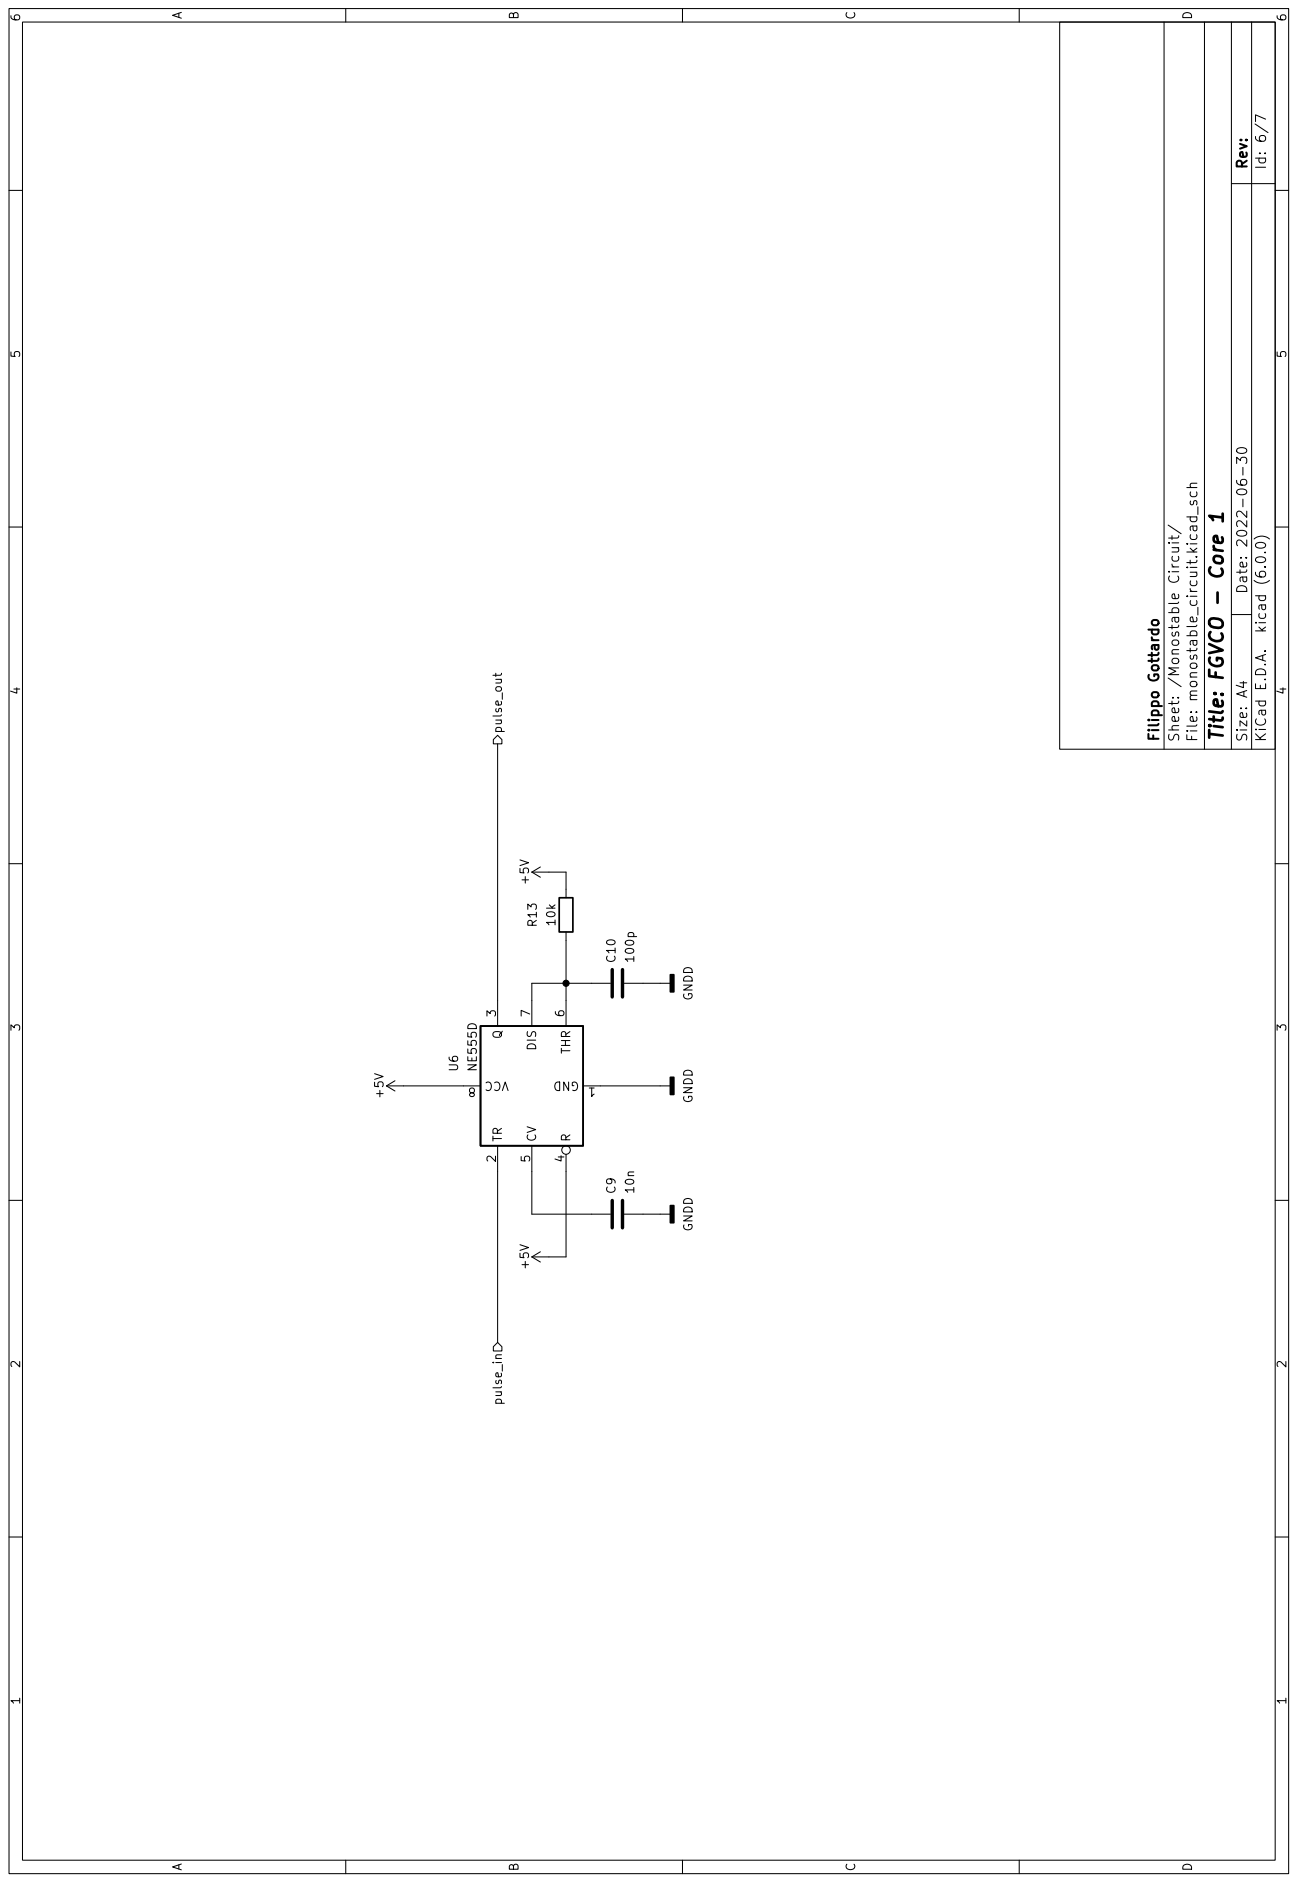
[picture p188: page 7]
100p GNDD; 10n GNDD GNDD; R13 10k +5V GND; 5 THR; 6 DIS; pulse_in pulse_out

D Date: 2022-06-30 KiCad E.D.A. kicad (6.0.0) Rev: Size: A4

Id: 6/7 Filippo Gottardo Sheet: /Monostable Circuit/ File: monostable_circuit.kicad_sch

Title: FGVCO - Core 1

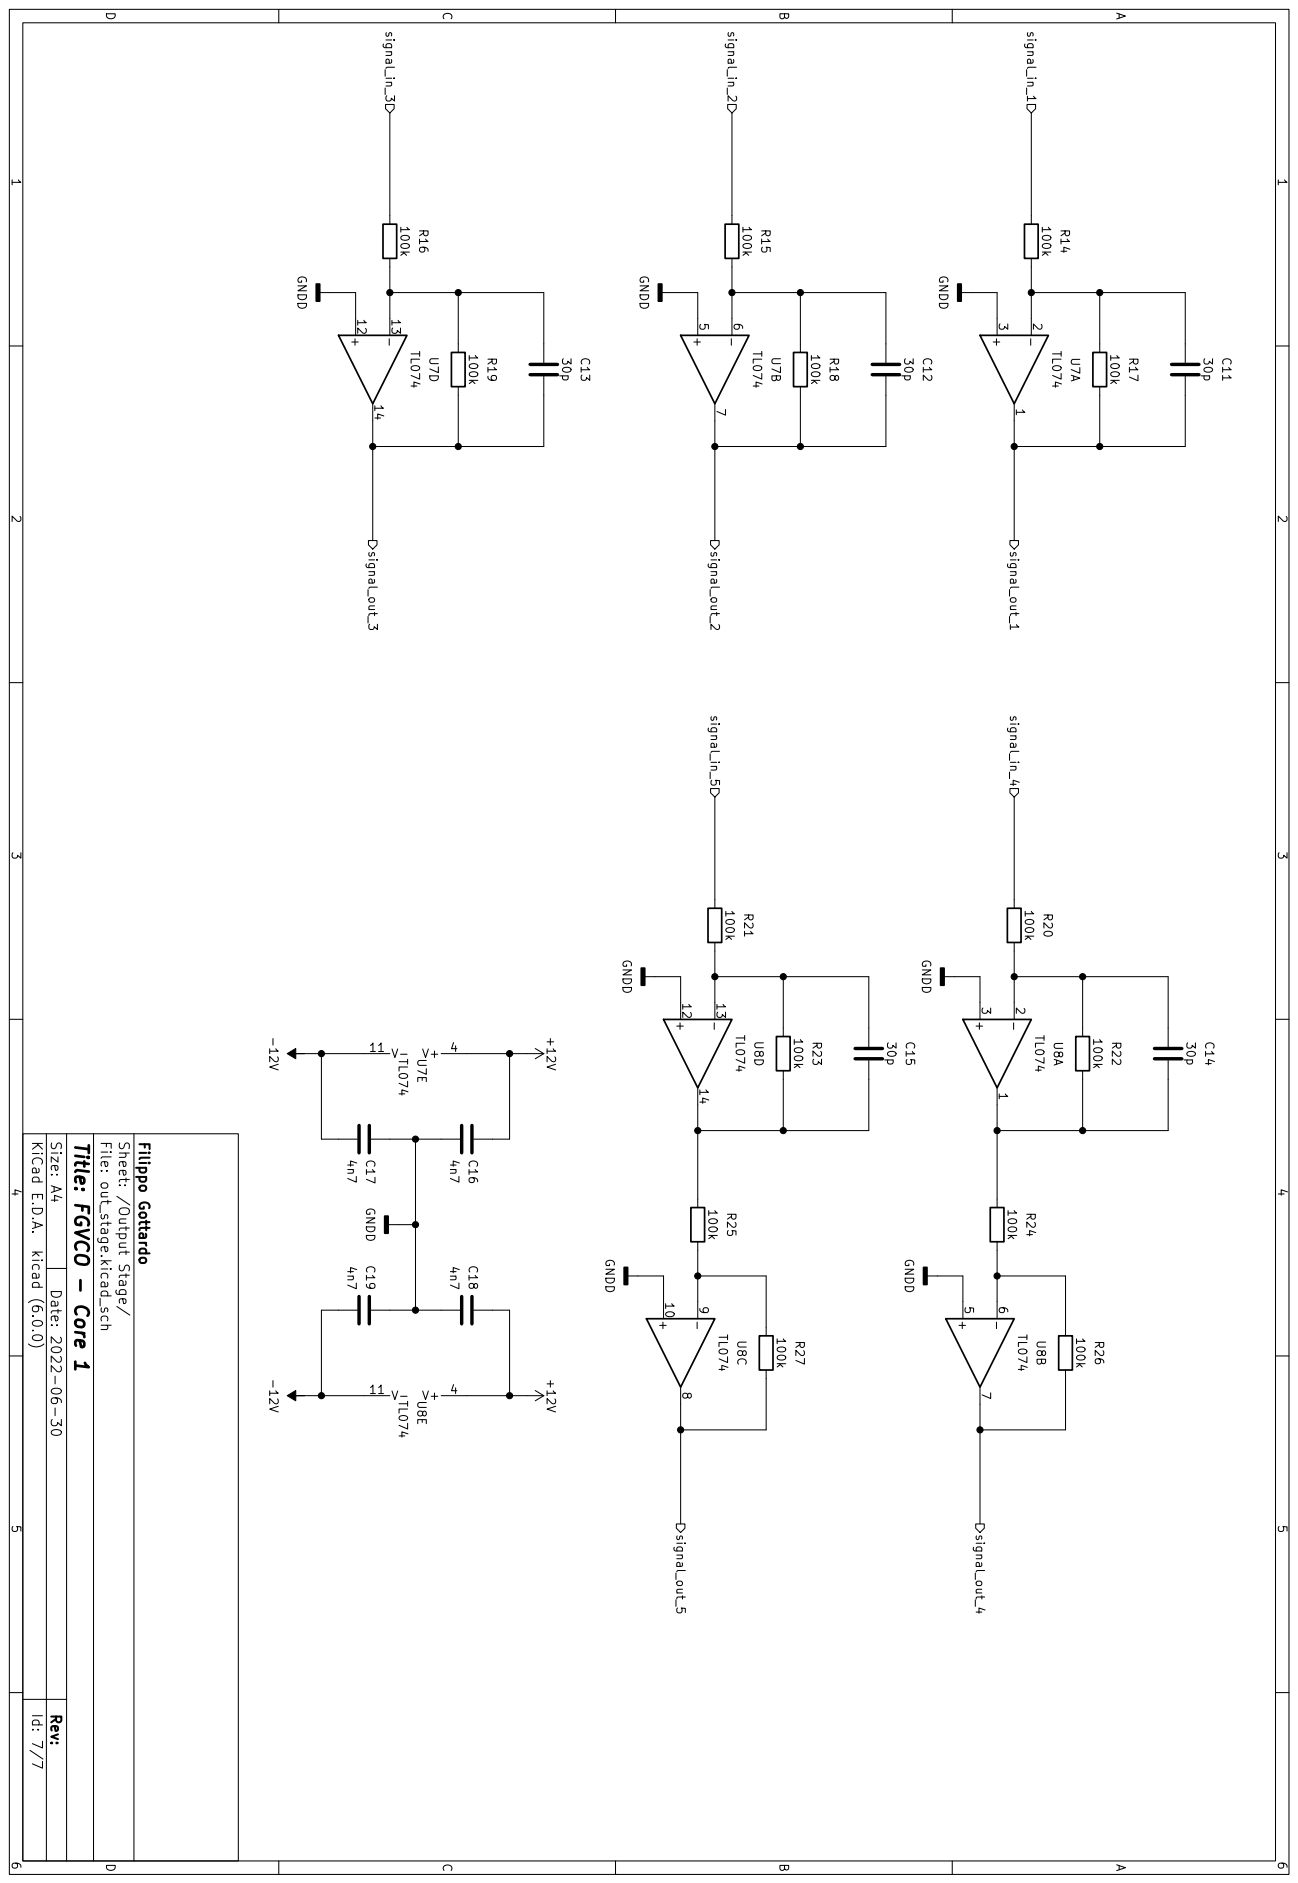
[picture p189: page 8]

Date: 2022-06-30 KiCad E.D.A. kicad (6.0.0) Rev: Size: A4

Id: 7/7 Title: FGVCO - Core 1

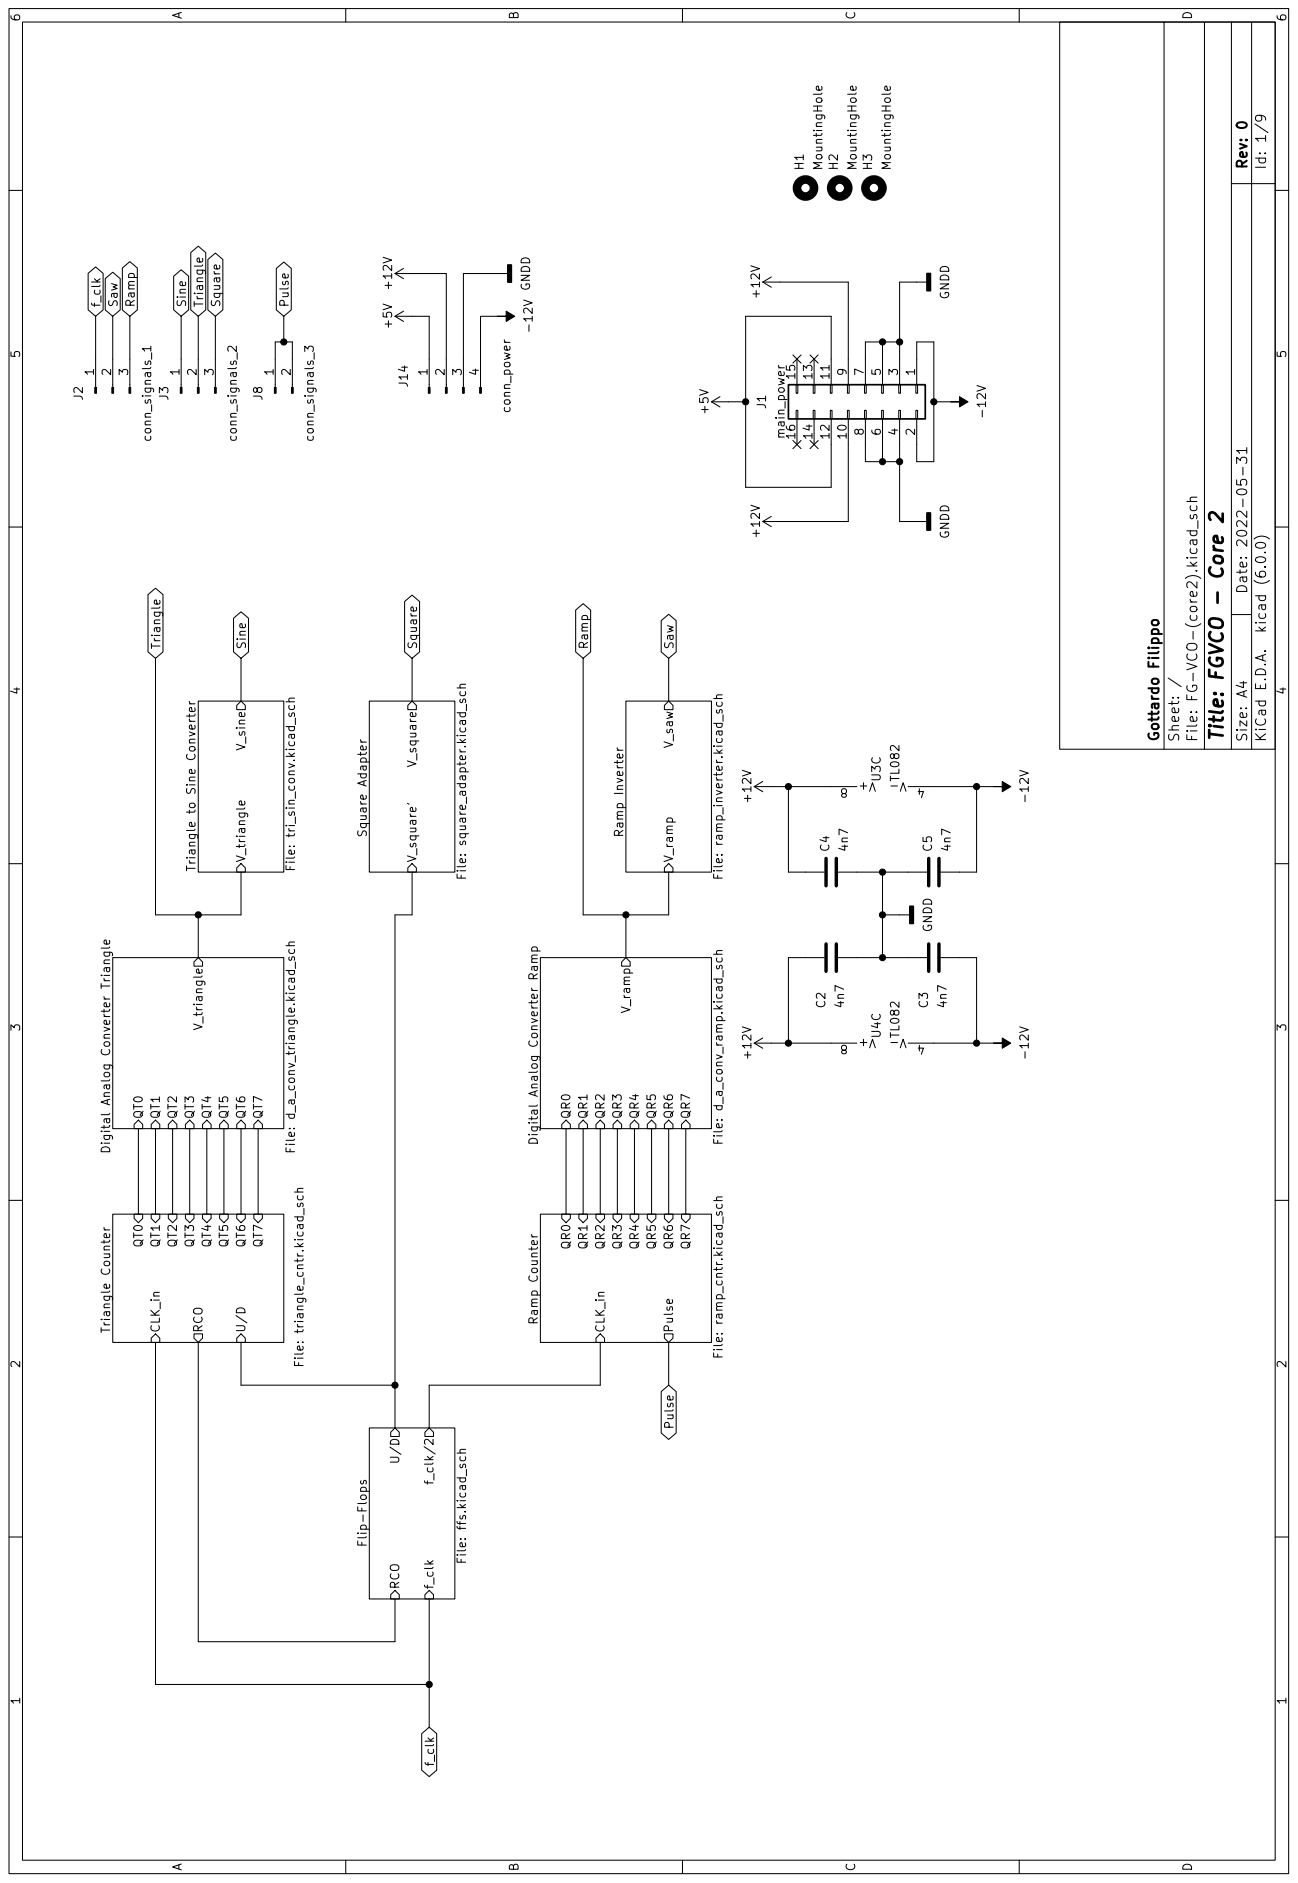
[picture p190: page 9]

D Date: 2022-05-31 KiCad E.D.A. kicad (6.0.0) Rev: 0 Size: A4

Id: 1/9 Gottardo Filippo Sheet: / File: FG-VCO-(core2).kicad_sch

Square Pulse Square Sine

V_triangle V_sine Triangle to Sine Converter File: tri_sin_conv.kicad_sch V_ramp QR0 QR1 QR2 QR3 QR4 QR5 QR6 QR7 Digital Analog Converter Ramp

V_triangle QT0 QT1 QT2 QT3 QT4 QT5 QT6 QT7 Digital Analog Converter Triangle

f_clk Flip-Flops File: ffs.kicad_sch CLK_in QR0 QR1 QR2 QR3 QR4 QR5 QR6 QR7 Pulse Ramp Counter

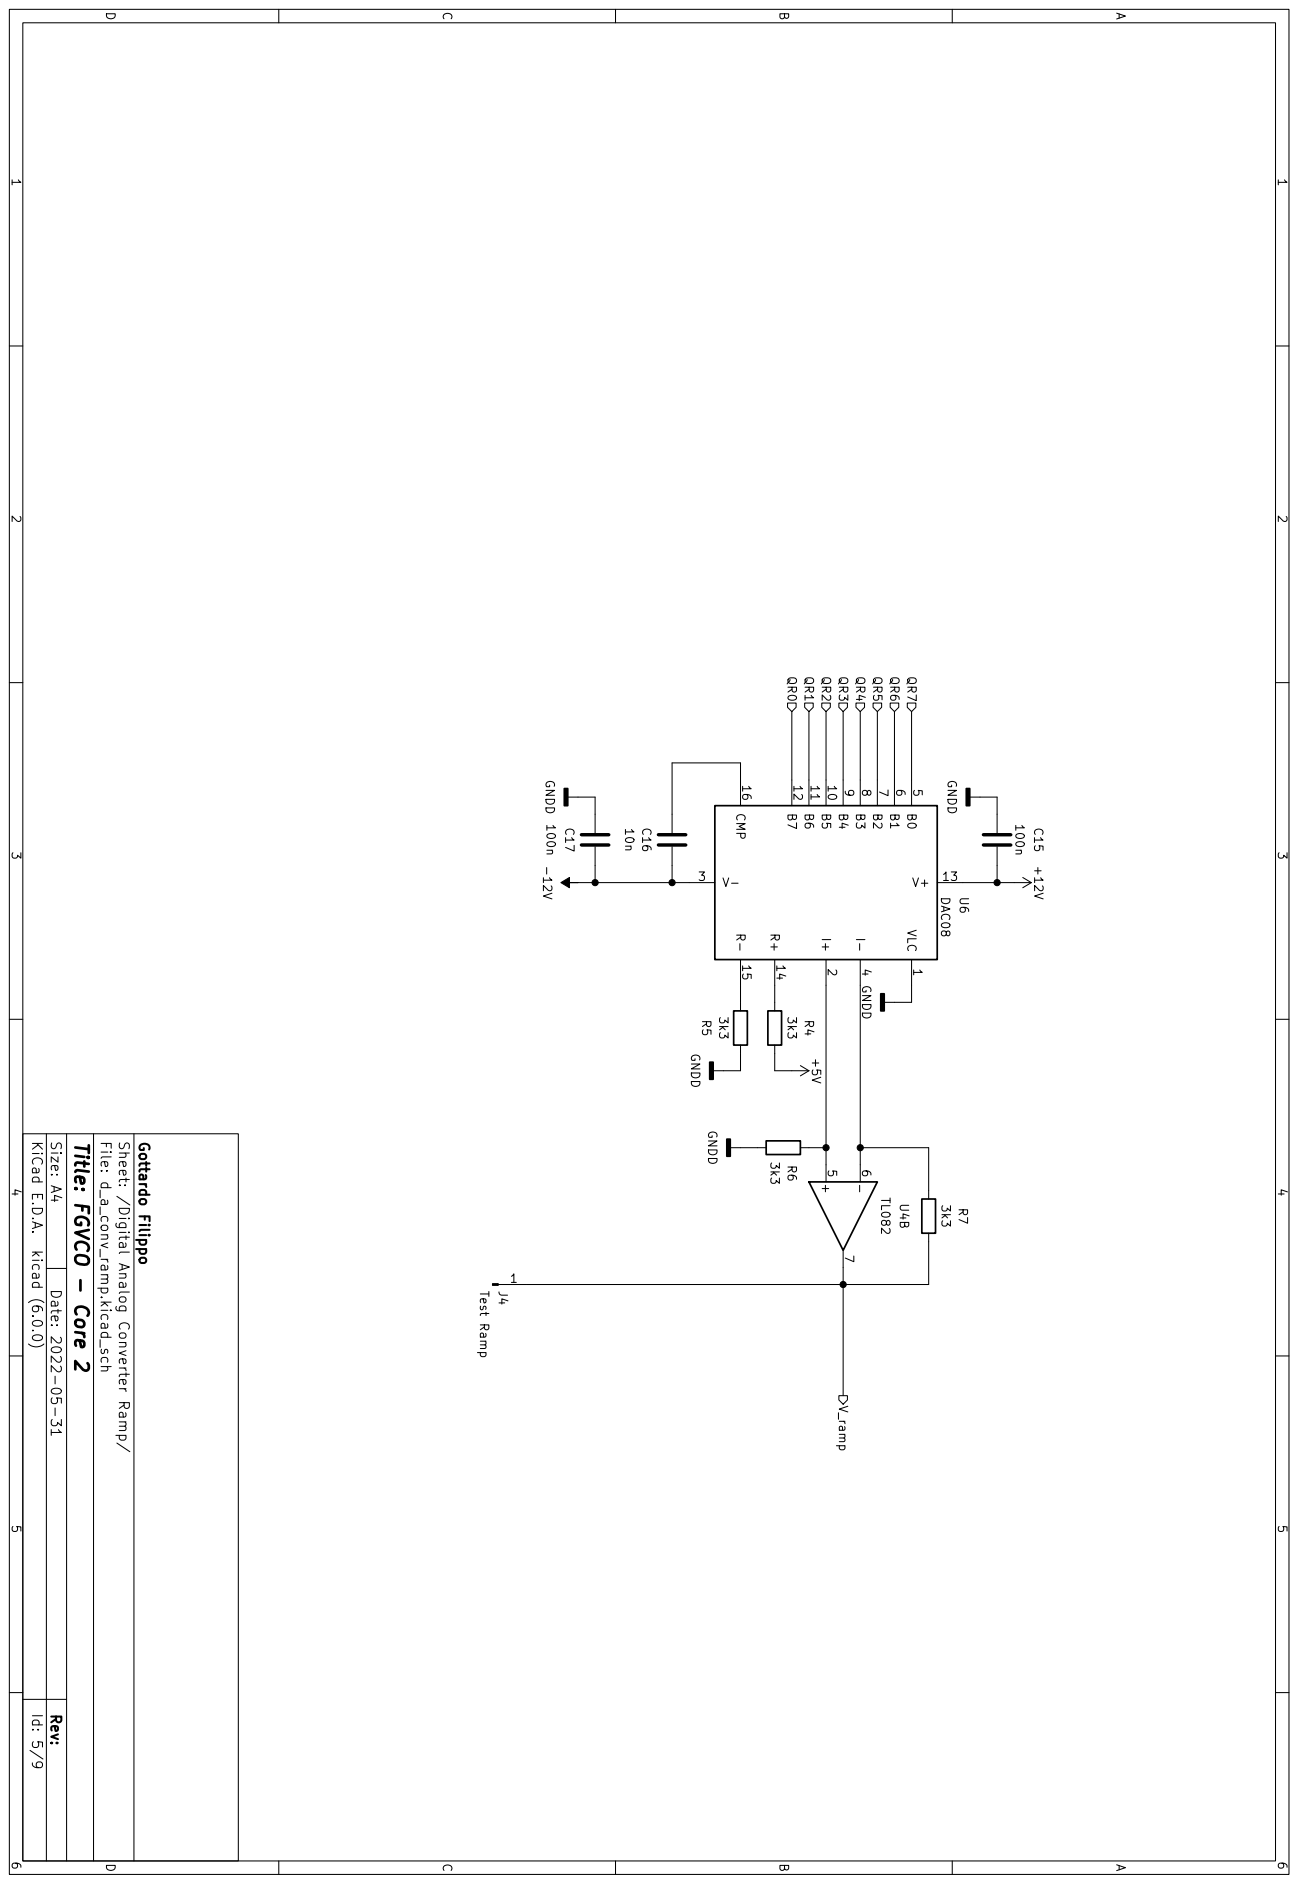
[picture p191: page 10]

Date: 2022-05-31 KiCad E.D.A. kicad (6.0.0) Rev: Size: A4

Id: 5/9 Title: FGVCO - Core 2

Sheet: /Digital Analog Converter Ramp/

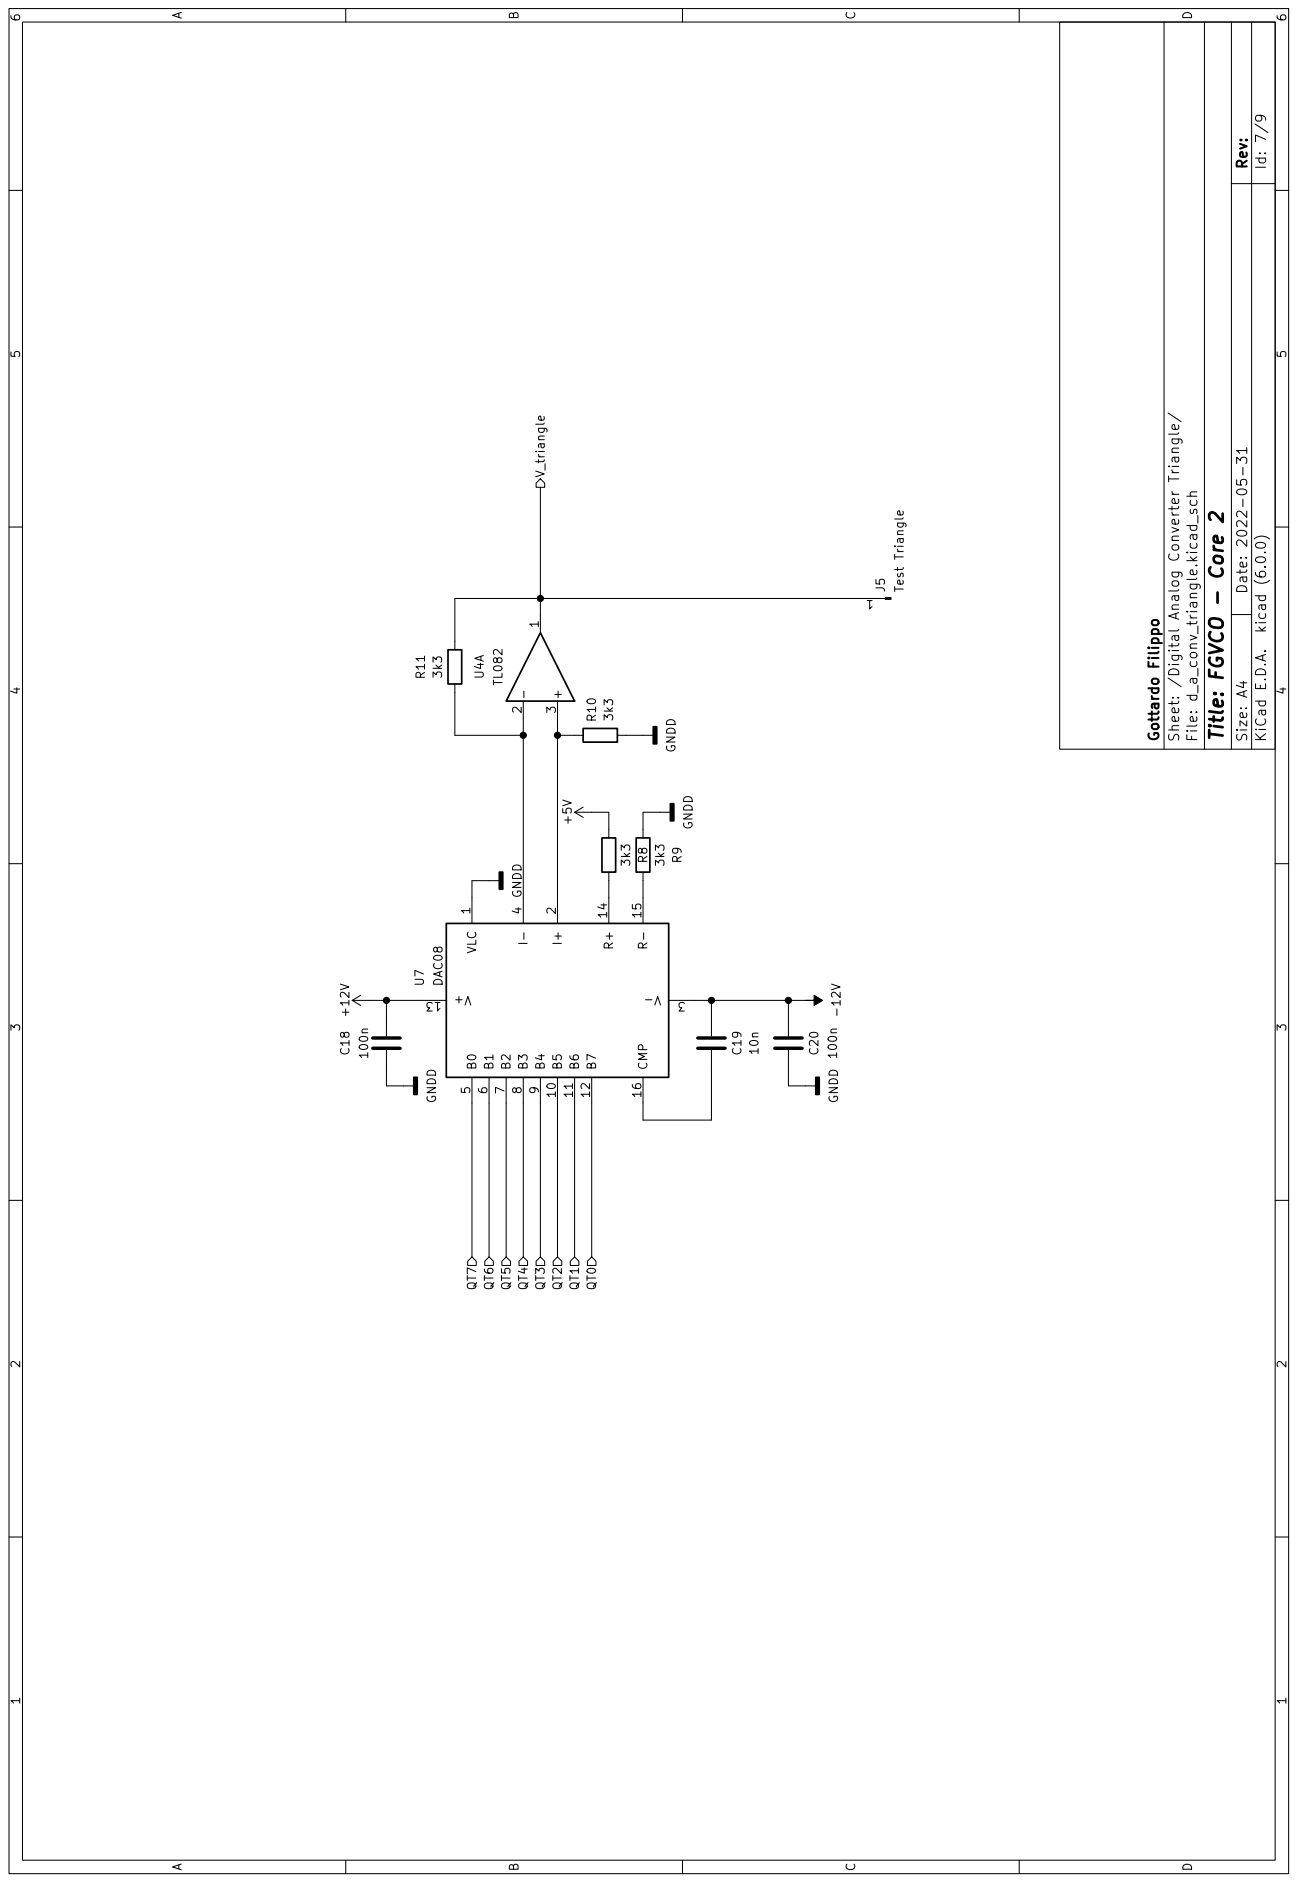
[picture p192: page 11]

D Date: 2022-05-31 KiCad E.D.A. kicad (6.0.0) Rev: Size: A4

Sheet: /Digital Analog Converter Triangle/

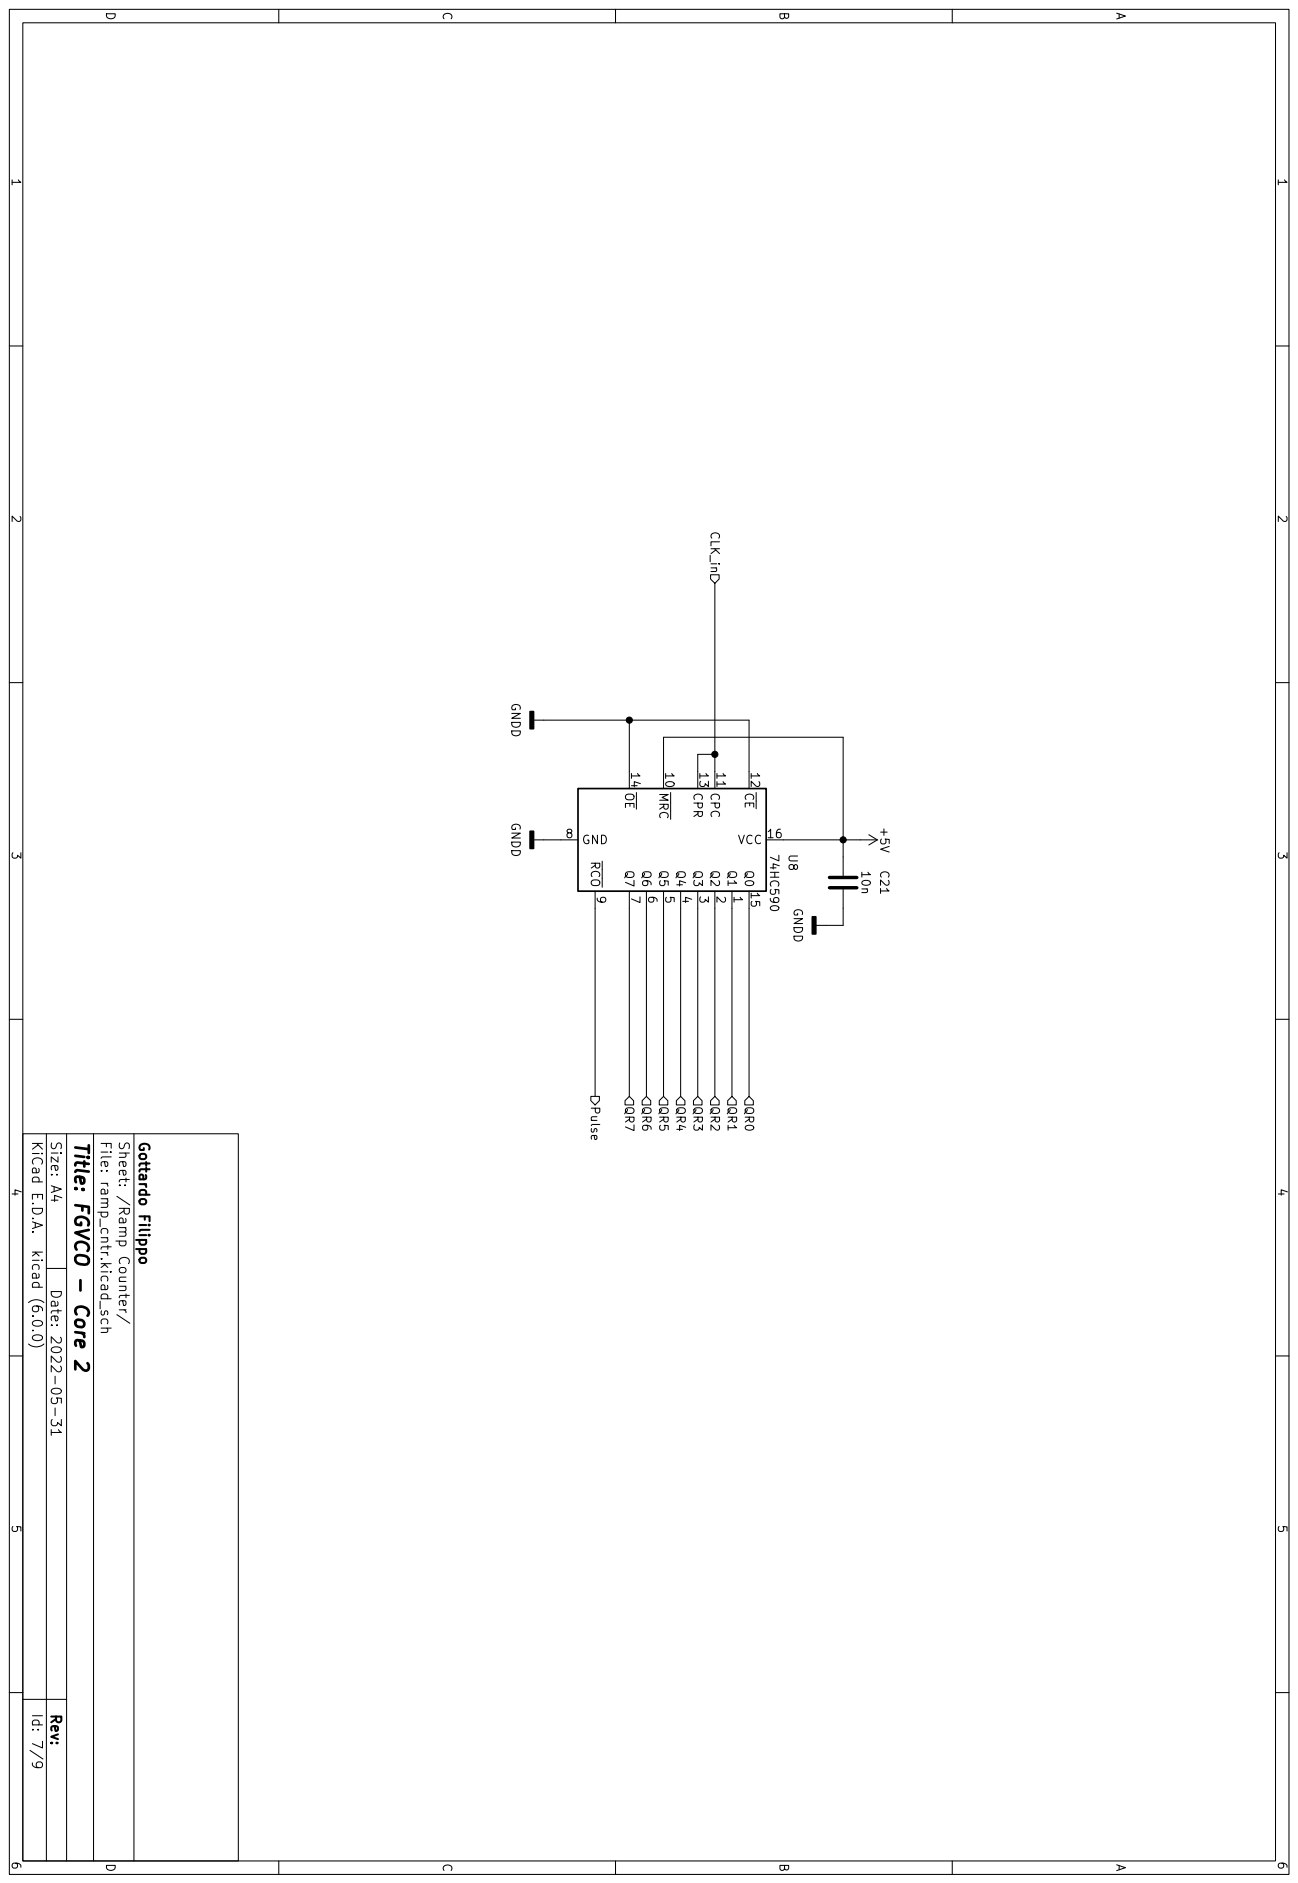
[picture p193: page 12]

Date: 2022-05-31 KiCad E.D.A. kicad (6.0.0) Rev: Size: A4

Id: 7/9 Title: FGVCO - Core 2

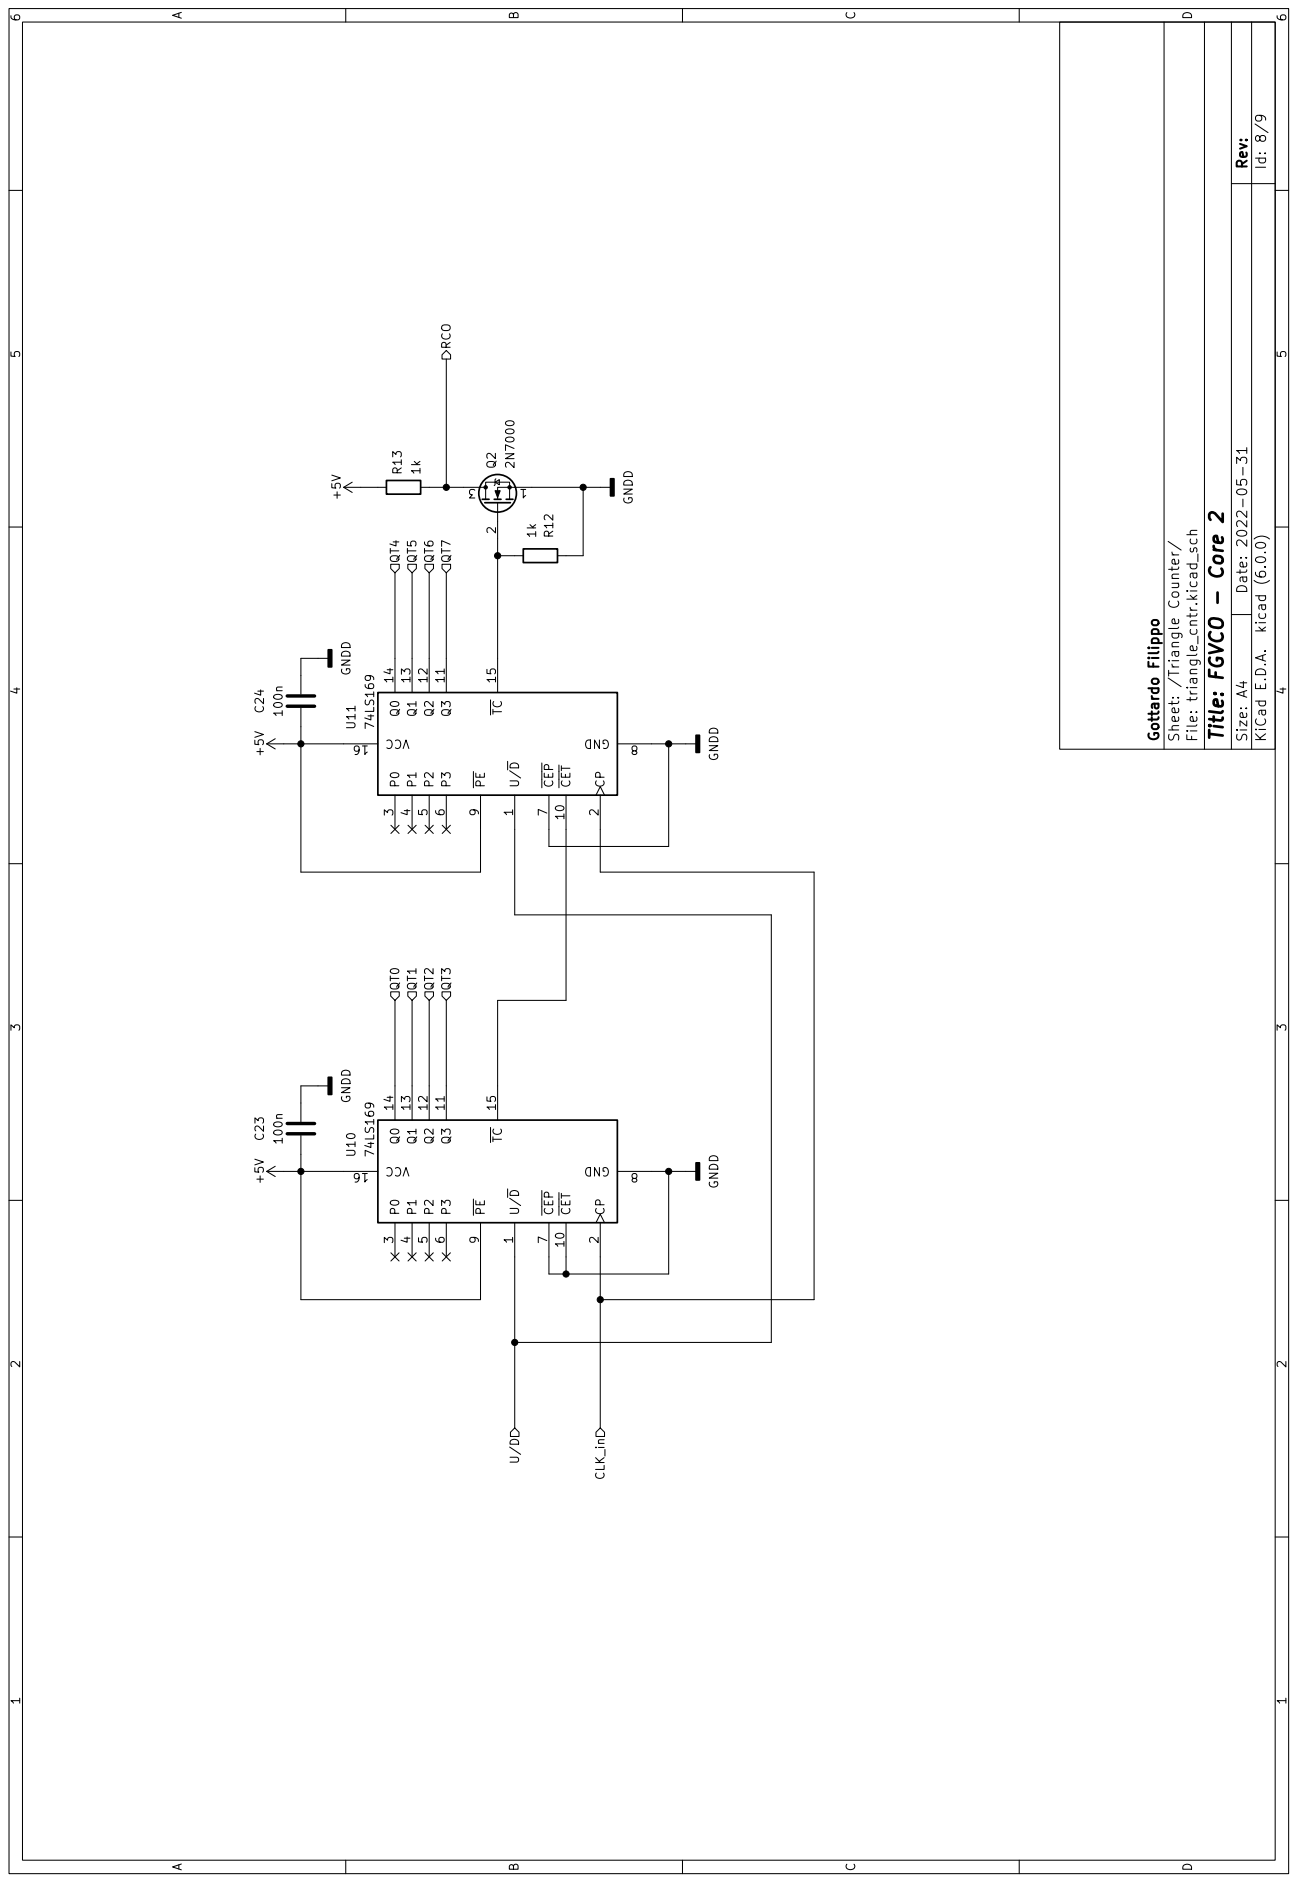
[picture p194: page 13]

D Date: 2022-05-31 KiCad E.D.A. kicad (6.0.0) Rev: Size: A4

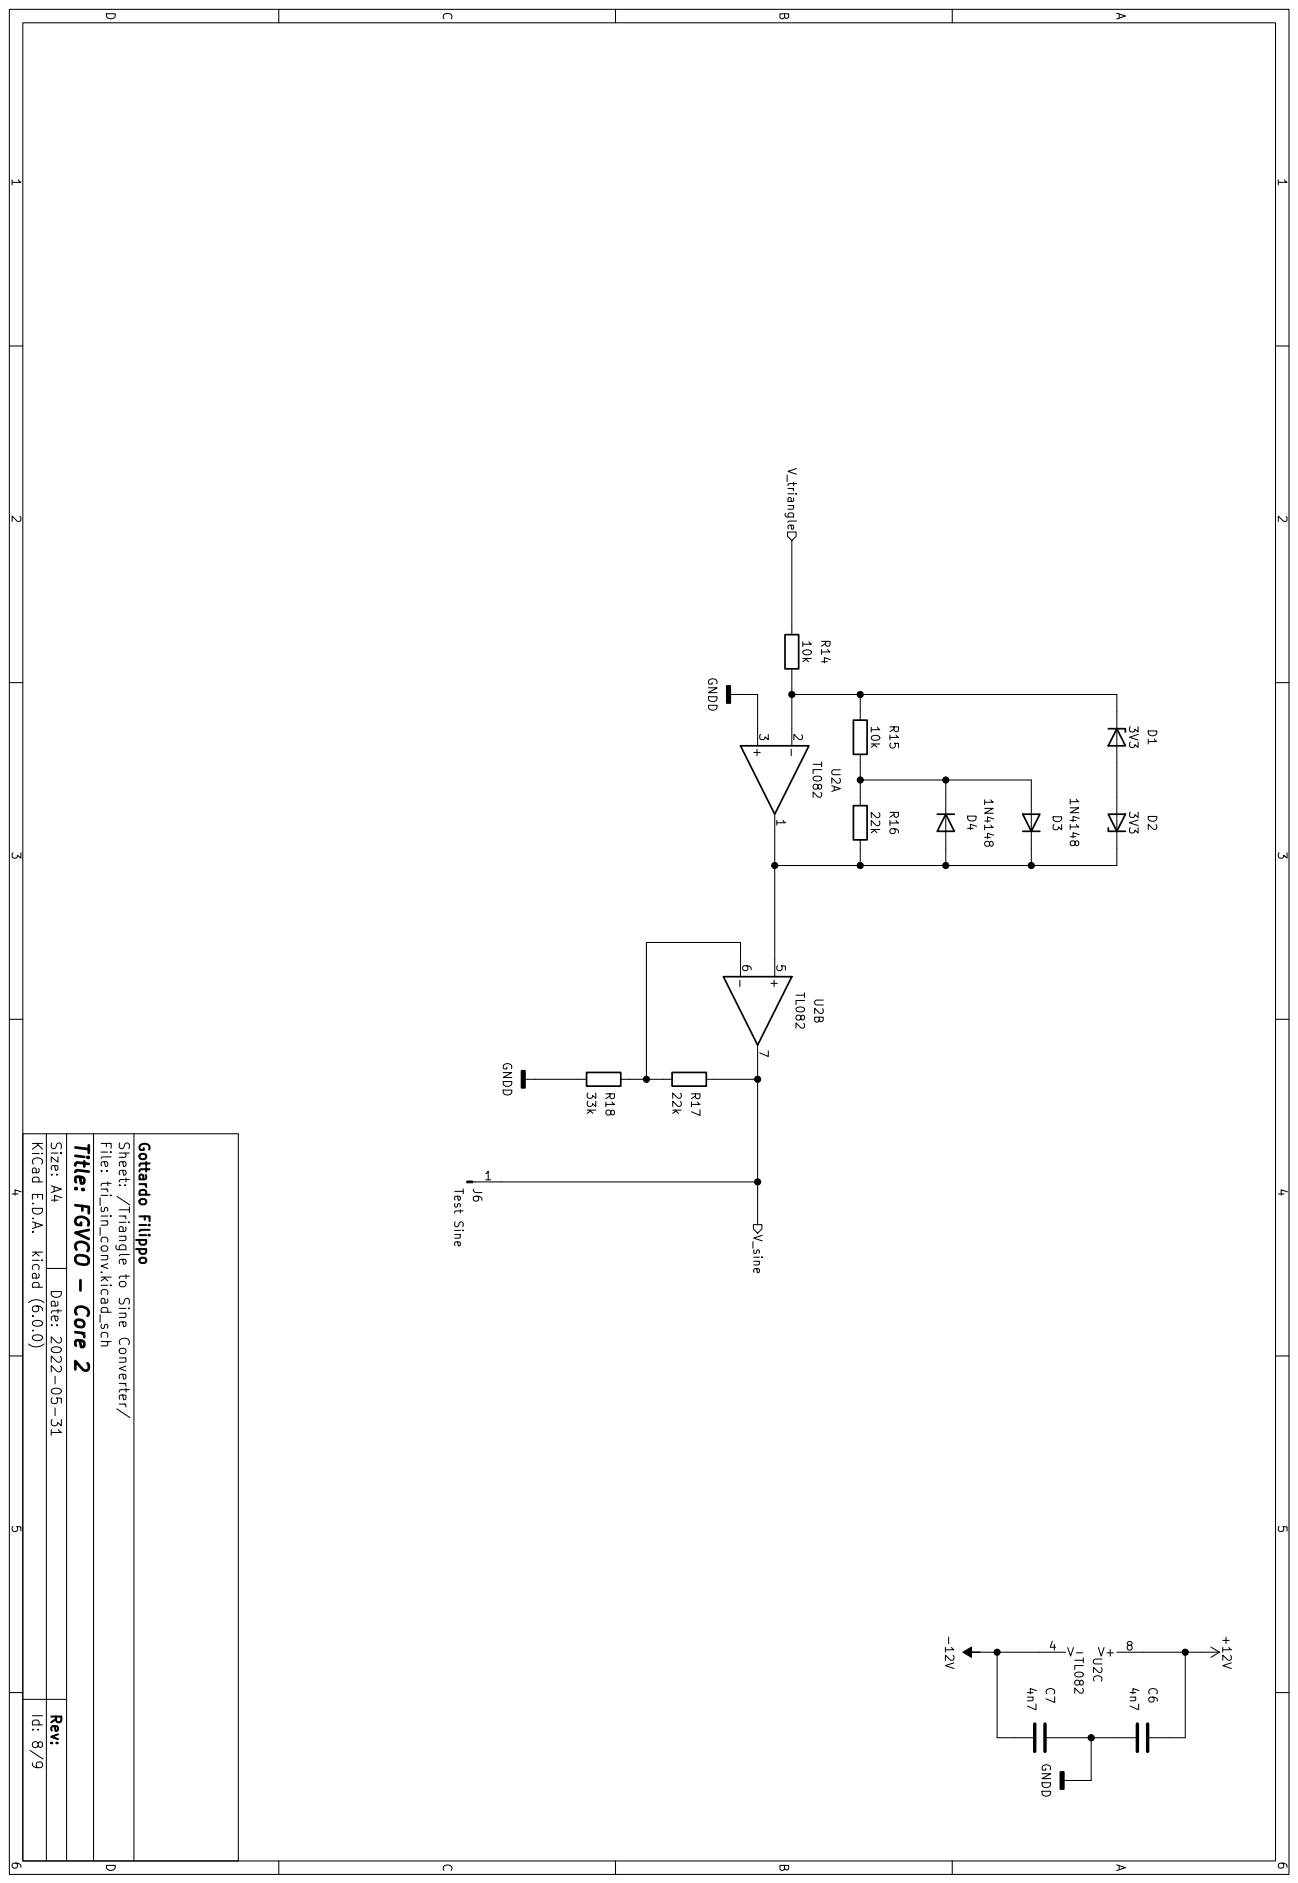
[picture p195: page 14]

Date: 2022-05-31 KiCad E.D.A. kicad (6.0.0) Rev: Size: A4

Id: 8/9 Title: FGVCO - Core 2

Sheet: /Triangle to Sine Converter/

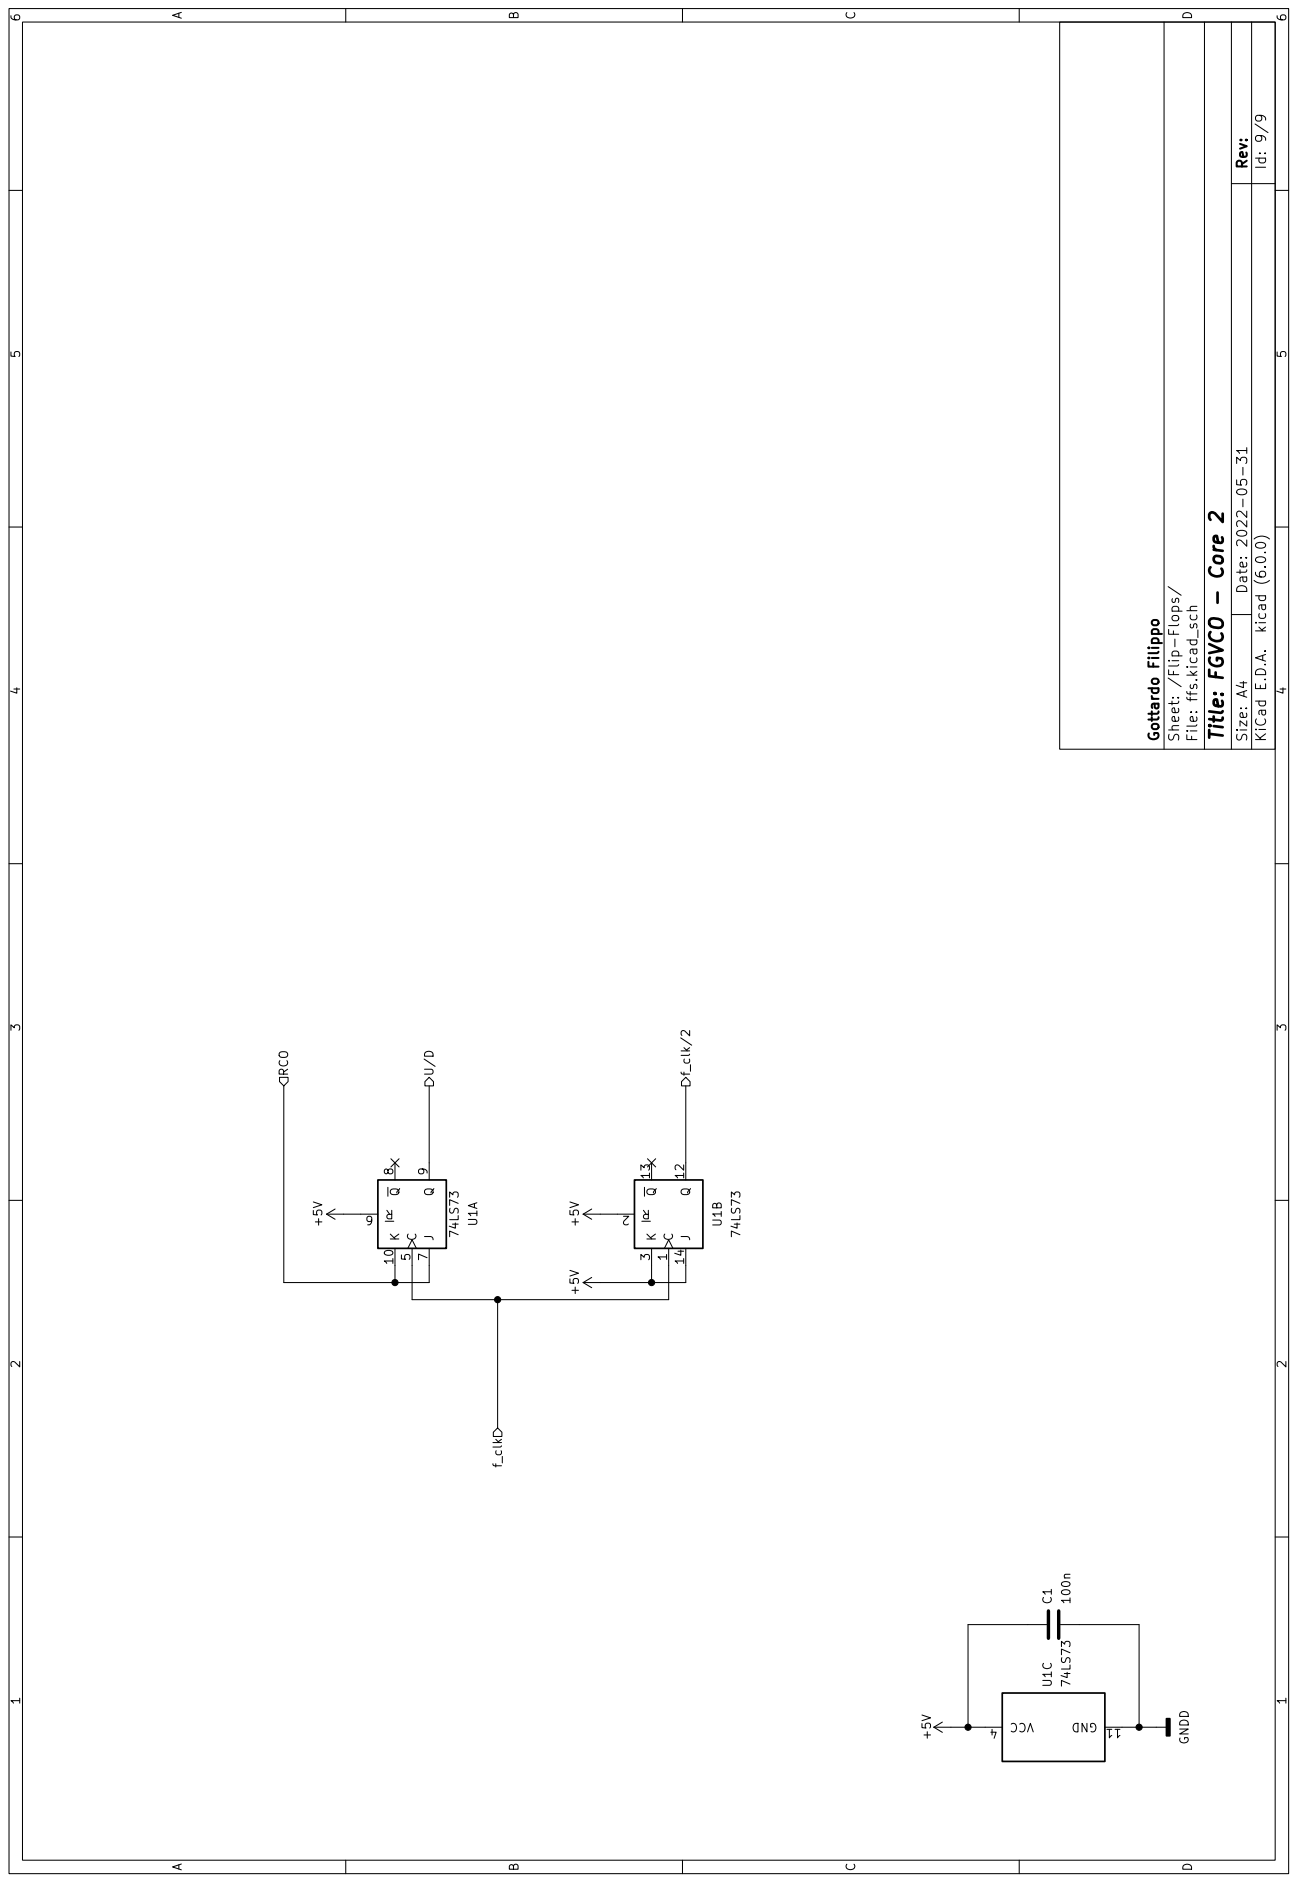
[picture p196: page 15]
File: ffs.kicad_sch; +5V GNDD; 74LS73 GND 11 VCC; f_clk/2; f_clk RCO

D Date: 2022-05-31 KiCad E.D.A. kicad (6.0.0) Rev: Size: A4

Id: 9/9 Gottardo Filippo

Title: FGVCO - Core 2

Sheet: /Flip-Flops/

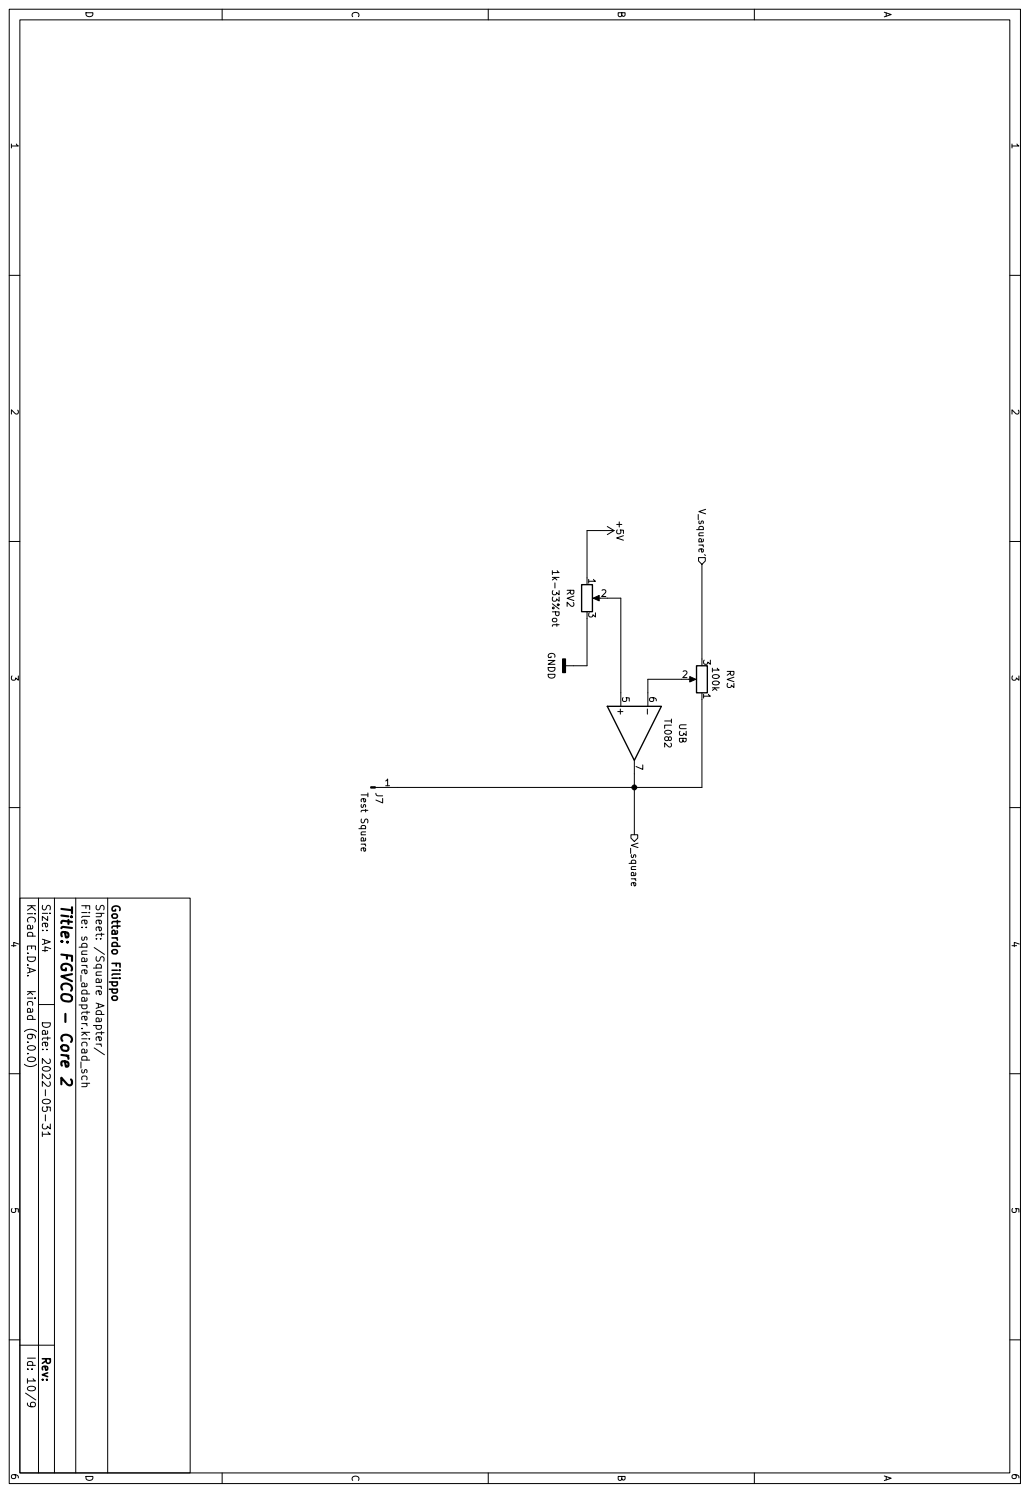
[picture p197: page 16]
File: square_adapter.kicad_sch; Gottardo Filippo; 1k-33%Pot GNDD; 1 Test Square; V_square; V_square'

Date: 2022-05-31 KiCad E.D.A. kicad (6.0.0) Rev: Size: A4

Id: 10/9 Title: FGVCO - Core 2

Sheet: /Square Adapter/

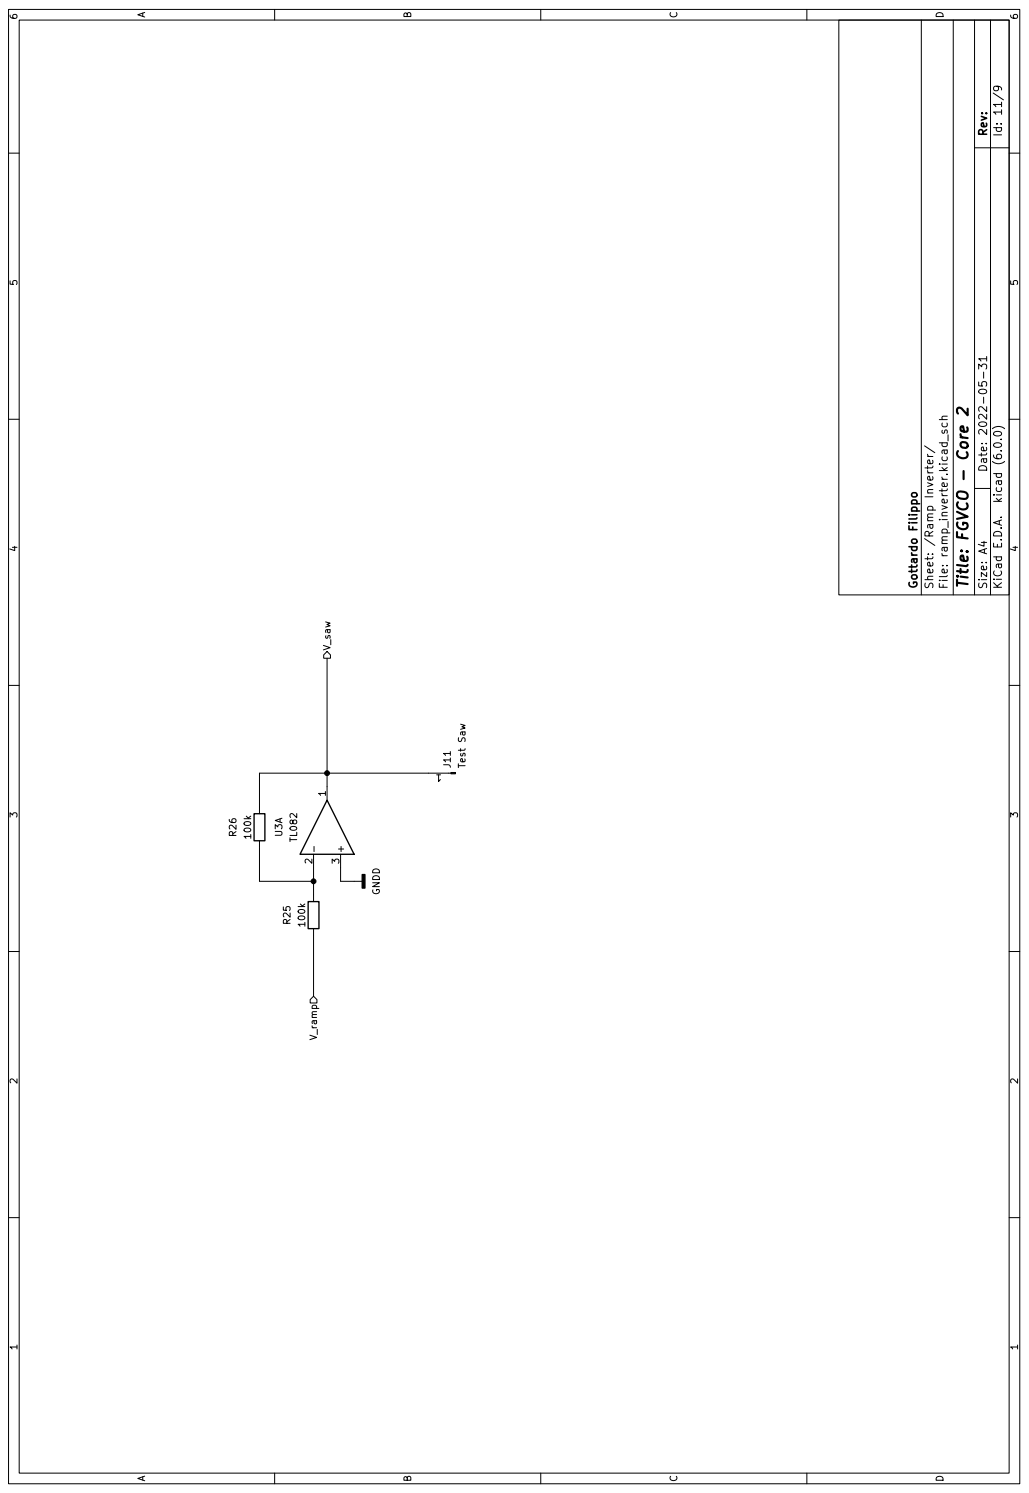
[picture p198: page 17]
File: ramp_inverter.kicad_sch; 100k V_saw; V_ramp

D Date: 2022-05-31 KiCad E.D.A. kicad (6.0.0) Rev: Size: A4

Id: 11/9 Gottardo Filippo

Title: FGVCO - Core 2

Sheet: /Ramp Inverter/

J11 Test Saw GNDD
