PippoGot/FGVCO/Elaborato Scritto/pdfs/schematics/FG-VCO-(interface).pdf

File: FG-VCO-(interface).kicad_sch Sheet: / Filippo Gottardo R7

Id: 1/1 Title: FGVCO - Interface
