PippoGot/FGVCO/Elaborato Scritto/pdfs/schematics/Eurorack eFuse.pdf

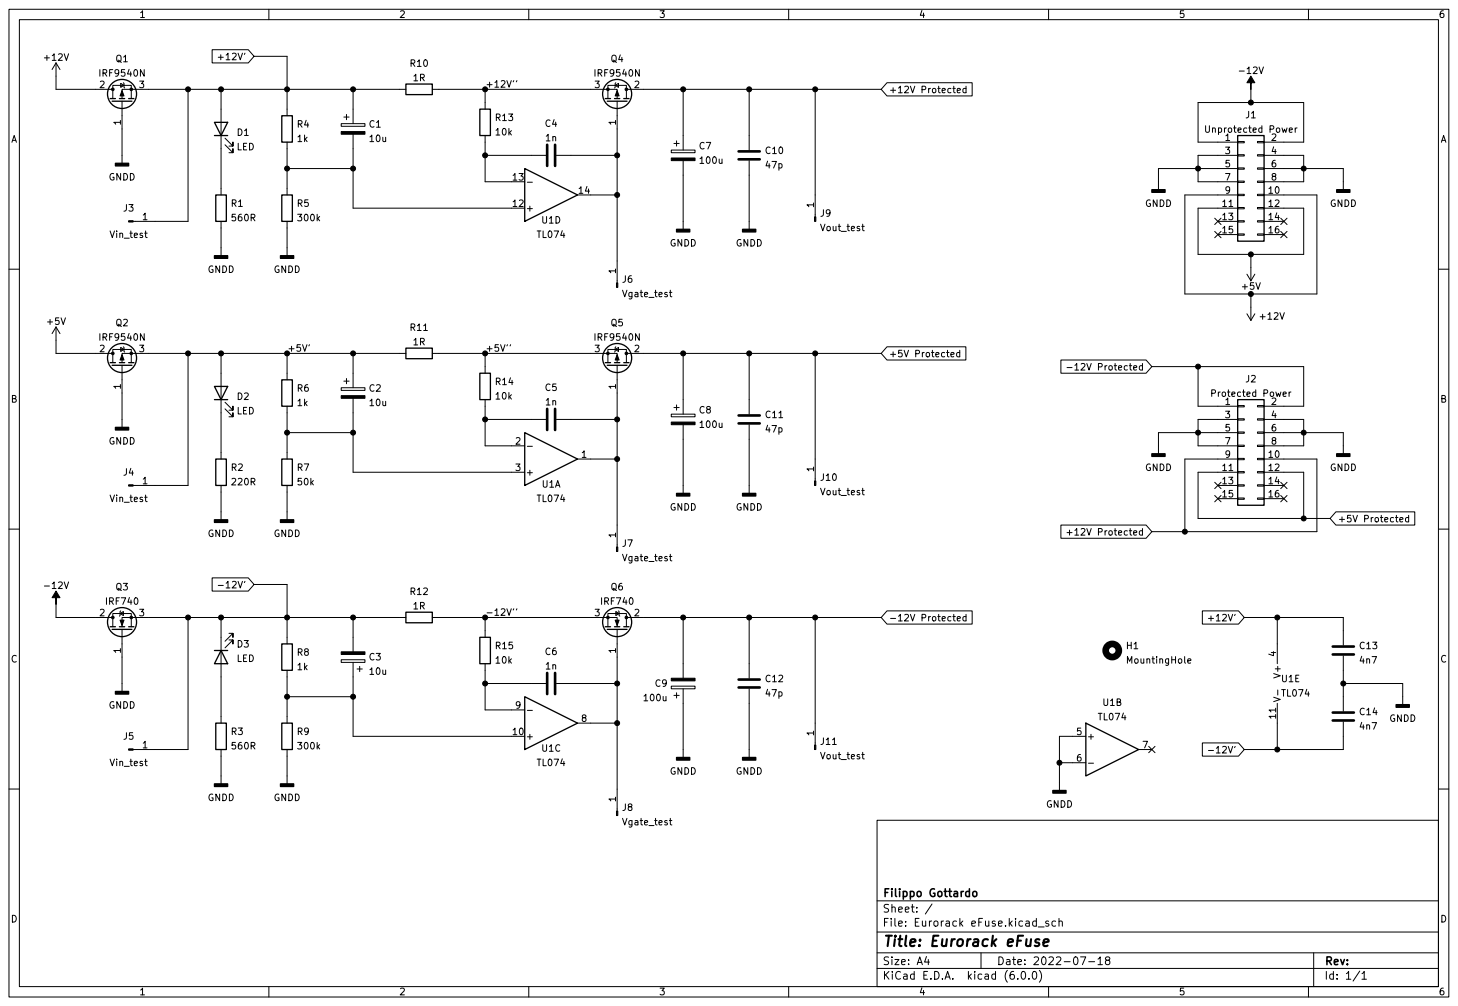
[picture p199: page 1]

J2 Protected Power GNDD GNDD

File: Eurorack eFuse.kicad_sch Sheet: / Filippo Gottardo GNDD

Id: 1/1 Title: Eurorack eFuse
