PippoGot/FGVCO/Elaborato Scritto/legacy/img/frequency-modulation-block-diagram.pdf

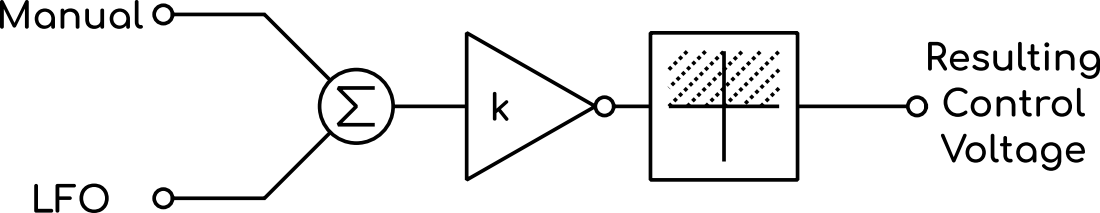
[picture p200: page 1]
