PippoGot/FGVCO/FG-VCO-(interface)/FG-VCO-(interface).kicad_pcb

## KiCad design FG-VCO-(interface)/FG-VCO-(interface).kicad_pcb (2022-08-09)

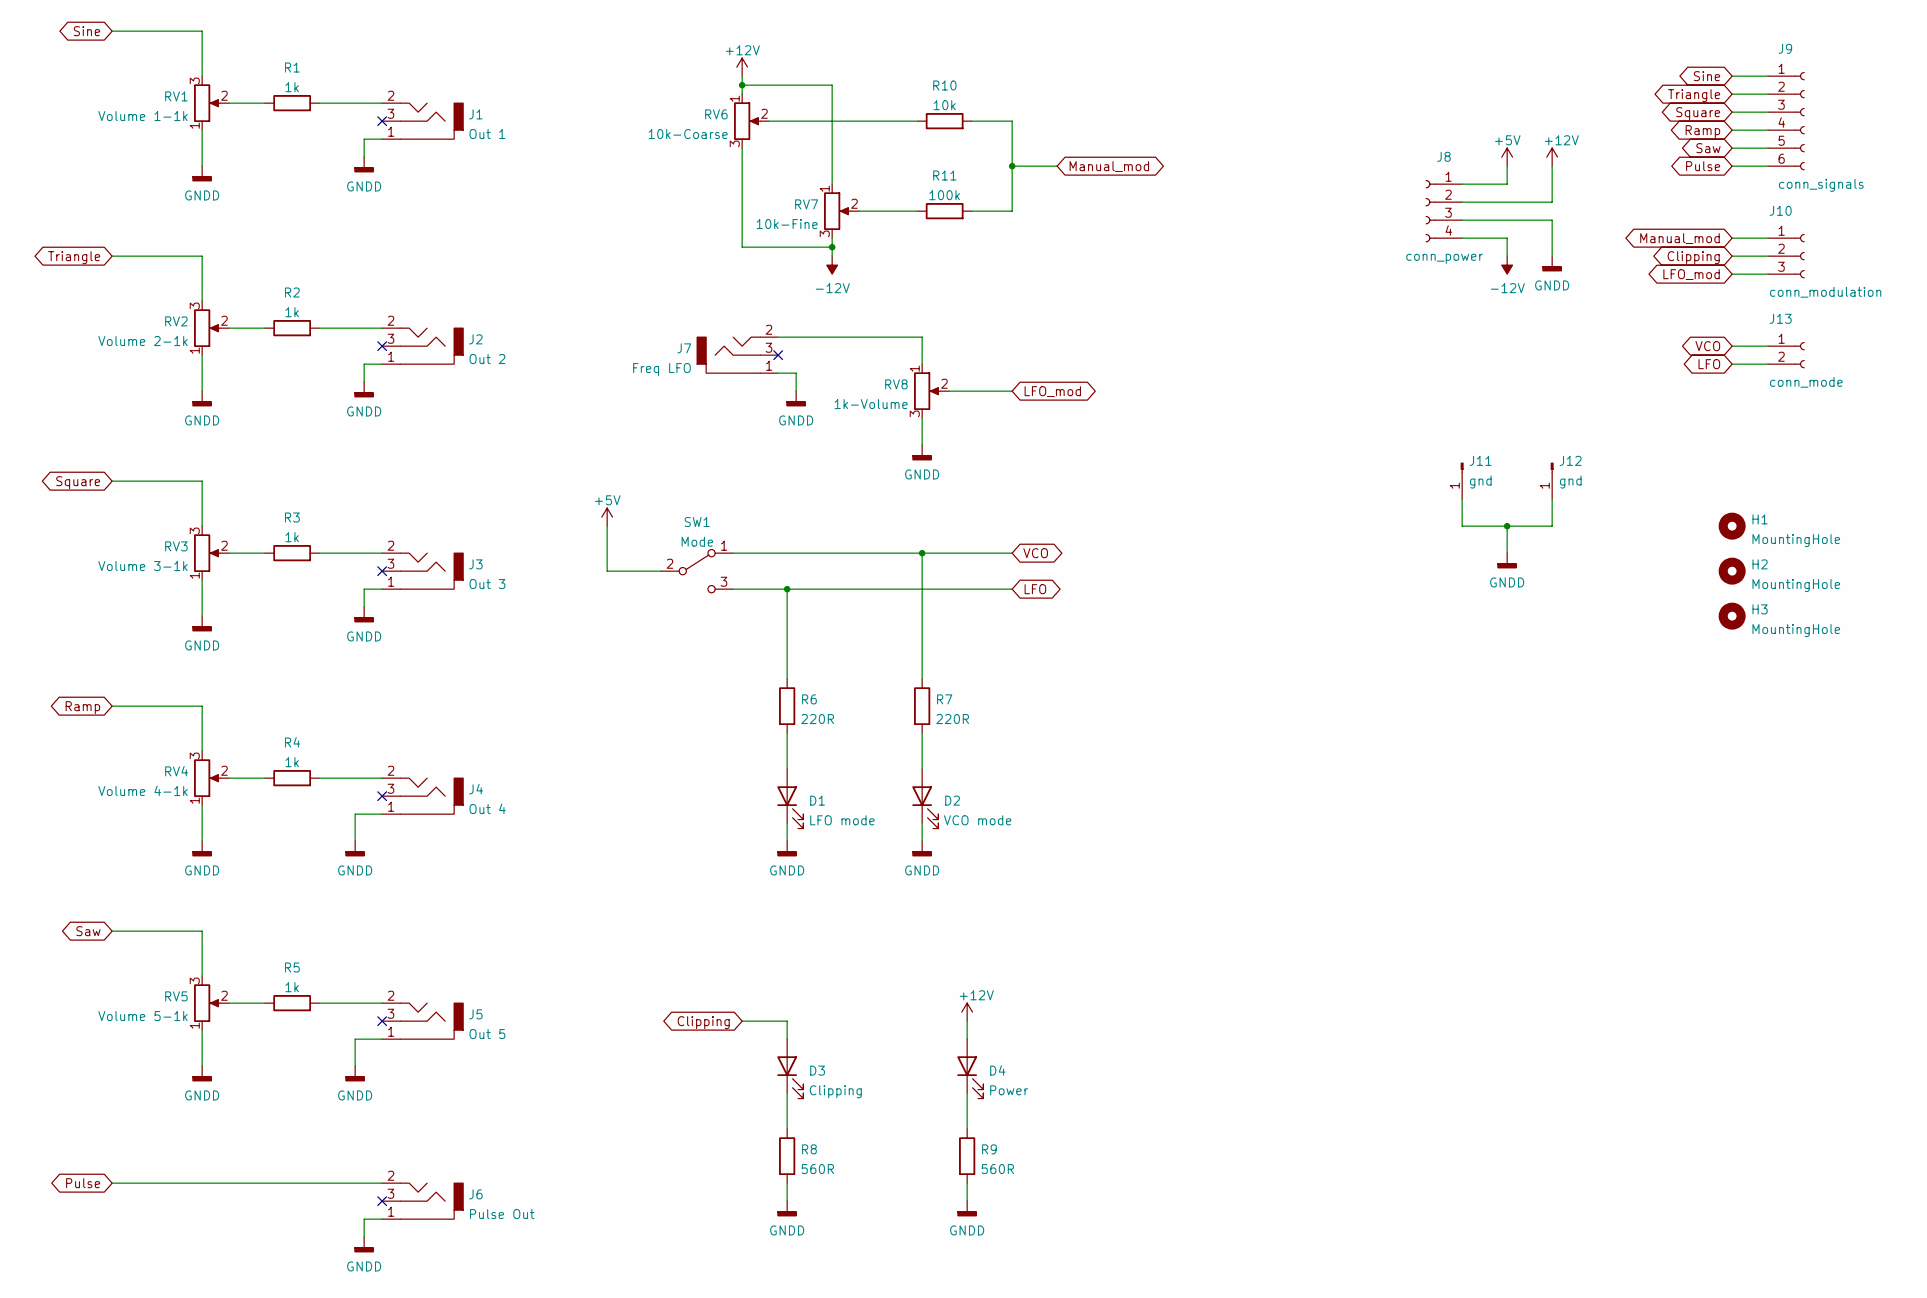
[picture p201: schematic FG-VCO-(interface).kicad_sch, FGVCO - Interface]

Parts:
D1: LFO mode; LED_D3.0mm_FlatTop
D2: VCO mode; LED_D3.0mm_FlatTop
D3: Clipping; LED_D3.0mm_FlatTop
D4: Power; LED_D3.0mm_FlatTop
H1, H2, H3: MountingHole; MountingHole_3.2mm_M3
J1: Out 1; PJ_301M_noGND
J2: Out 2; PJ_301M_noGND
J3: Out 3; PJ_301M_noGND
J4: Out 4; PJ_301M_noGND
J5: Out 5; PJ_301M_noGND
J6: Pulse Out; PJ_301M_noGND
J7: Freq LFO; PJ_301M_noGND
J8: conn_power; PinSocket_1x04_P2.54mm_Vertical
J9: conn_signals; PinSocket_1x06_P2.54mm_Vertical
J10: conn_modulation; PinSocket_1x03_P2.54mm_Vertical
J11, J12: gnd; PinSocket_1x01_P2.54mm_Vertical
J13: conn_mode; PinSocket_1x02_P2.54mm_Vertical
R1, R2, R3, R4, R5: 1k; R_Axial_DIN0207_L6.3mm_D2.5mm_P10.16mm_Horizontal
R6, R7: 220R; R_Axial_DIN0207_L6.3mm_D2.5mm_P10.16mm_Horizontal
R8, R9: 560R; R_Axial_DIN0207_L6.3mm_D2.5mm_P10.16mm_Horizontal
R10: 10k; R_Axial_DIN0207_L6.3mm_D2.5mm_P10.16mm_Horizontal
R11: 100k; R_Axial_DIN0207_L6.3mm_D2.5mm_P10.16mm_Horizontal
RV1: Volume 1-1k; RV-90 Potentiometer
RV2: Volume 2-1k; RV-90 Potentiometer
RV3: Volume 3-1k; RV-90 Potentiometer
RV4: Volume 4-1k; RV-90 Potentiometer
RV5: Volume 5-1k; RV-90 Potentiometer
RV6: 10k-Coarse; RV-90 Potentiometer
RV7: 10k-Fine; RV-90 Potentiometer
RV8: 1k-Volume; RV-90 Potentiometer
SW1: Mode; SPDT Switch

Connections:
+5V: J8.1, SW1.2 (B)
+12V: D4.2 (A), J8.2, RV6.1, RV7.1
-12V: J8.4, RV6.3, RV7.3
Clipping: D3.2 (A), J10.2
GNDD: D1.1 (K), D2.1 (K), J1.1, J2.1, J3.1, J4.1, J5.1, J6.1, J7.1, J8.3, J11.1, J12.1, R8.2, R9.2, RV1.1, RV2.1, RV3.1, RV4.1, RV5.1, RV8.3
LFO: J13.2, R6.1, SW1.3 (C)
LFO_mod: J10.3, RV8.2
Manual_mod: J10.1, R10.2, R11.2
unnamed: D1.2 (A), R6.2
unnamed: D2.2 (A), R7.2
unnamed: D3.1 (K), R8.1
unnamed: D4.1 (K), R9.1
unnamed: J1.2, R1.2
unnamed: J2.2, R2.2
unnamed: J3.2, R3.2
unnamed: J4.2, R4.2
unnamed: J5.2, R5.2
unnamed: J7.2, RV8.1
unnamed: R1.1, RV1.2
unnamed: R2.1, RV2.2
unnamed: R3.1, RV3.2
unnamed: R4.1, RV4.2
unnamed: R5.1, RV5.2
unnamed: R10.1, RV6.2
unnamed: R11.1, RV7.2
Pulse: J6.2, J9.6
Ramp: J9.4, RV4.3
Saw: J9.5, RV5.3
Sine: J9.1, RV1.3
Square: J9.3, RV3.3
Triangle: J9.2, RV2.3
VCO: J13.1, R7.1, SW1.1 (A)

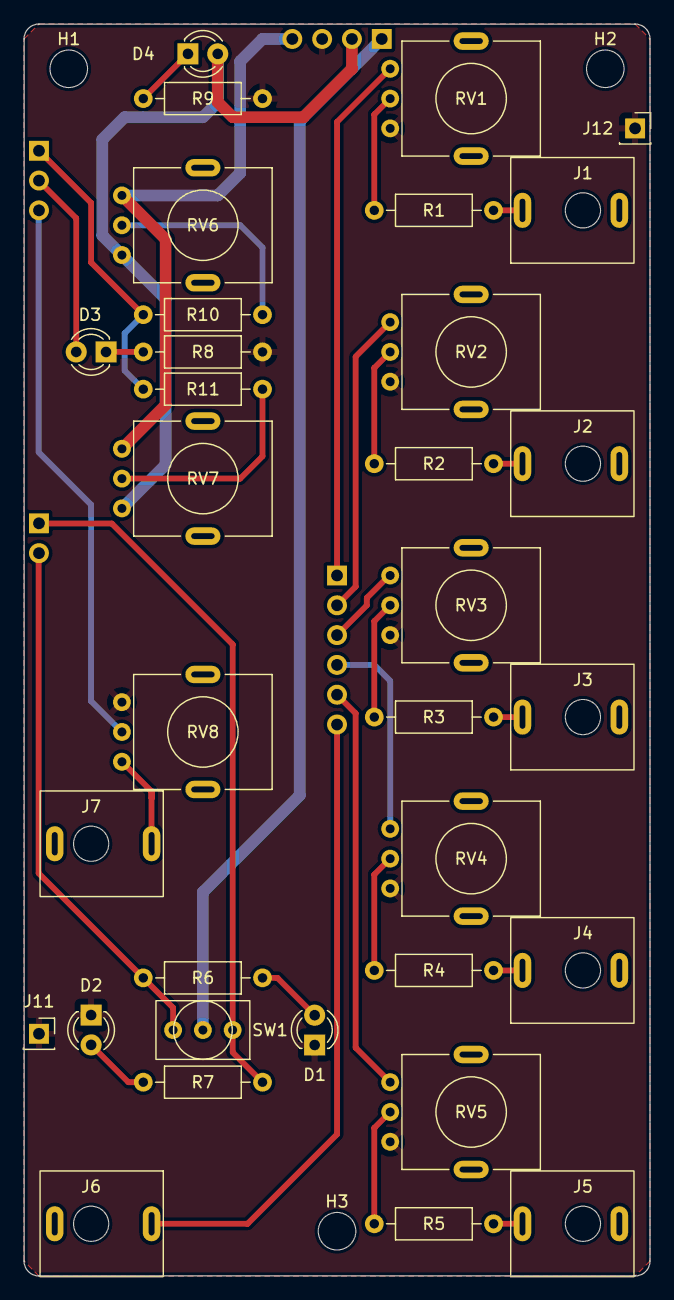
[picture p202: board FG-VCO-(interface).kicad_pcb from above]

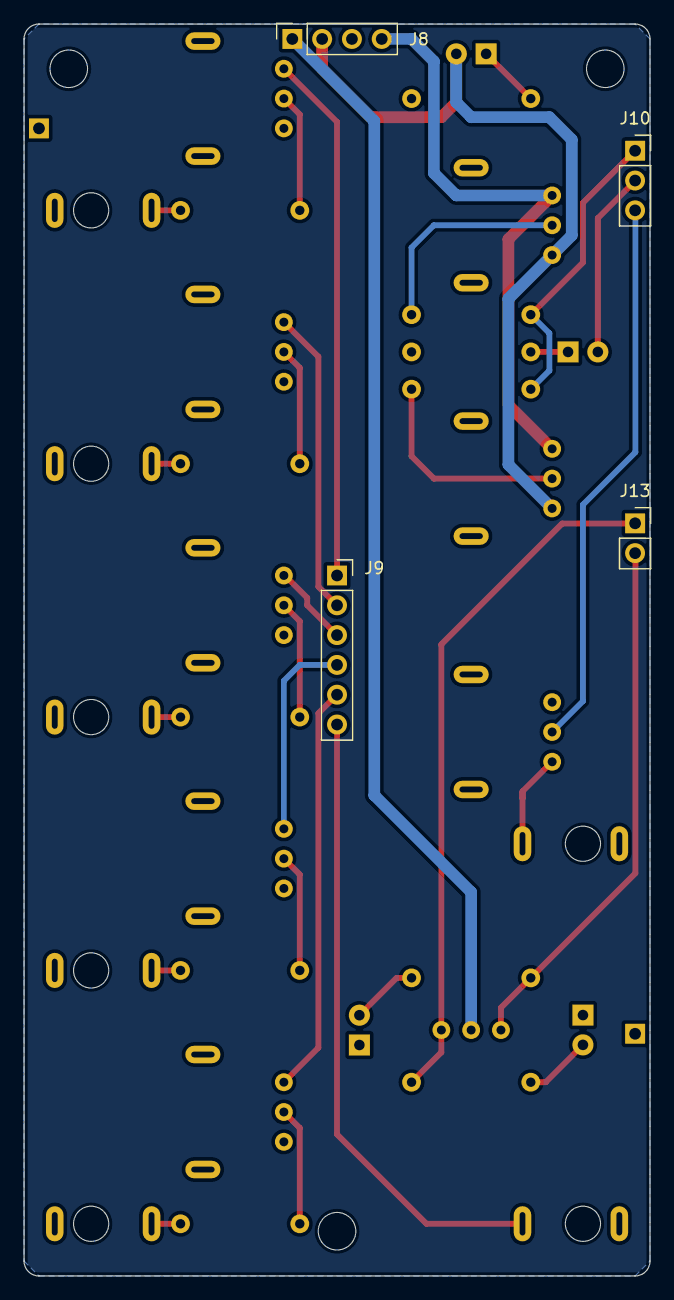
[picture p203: board FG-VCO-(interface).kicad_pcb from below]

Board: 2 copper layers, 53.3 x 106.7 mm, 40 parts (4 on the bottom side), 32 nets.
