PippoGot/FGVCO/FG-VCO-(core1)/FG-VCO-(core1).kicad_pcb

## KiCad design FG-VCO-(core1)/FG-VCO-(core1).kicad_pcb (2022-08-09)

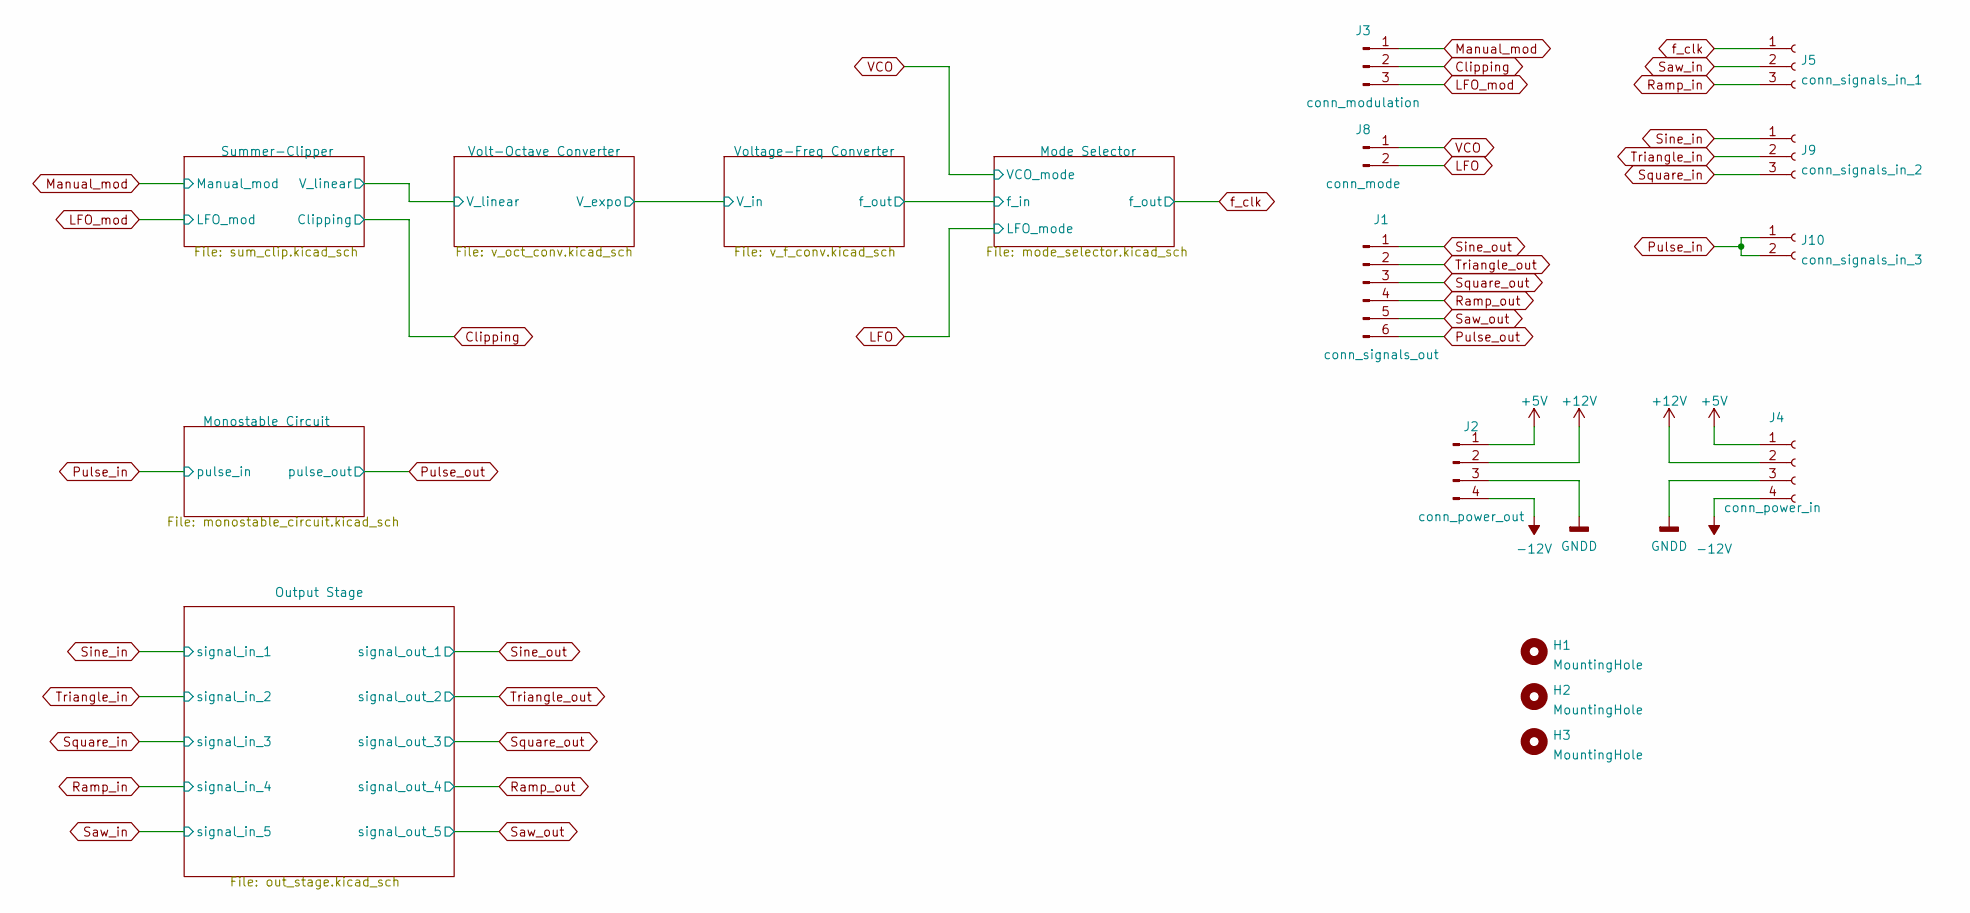
[picture p204: schematic FG-VCO-(core1).kicad_sch, FGVCO - Core 1]

Parts:
H1, H2, H3: MountingHole; MountingHole_3.2mm_M3
J1: conn_signals_out; PinHeader_1x06_P2.54mm_Vertical
J2: conn_power_out; PinHeader_1x04_P2.54mm_Vertical
J3: conn_modulation; PinHeader_1x03_P2.54mm_Vertical
J4: conn_power_in; PinSocket_1x04_P2.54mm_Vertical
J5: conn_signals_in_1; PinSocket_1x03_P2.54mm_Vertical
J8: conn_mode; PinHeader_1x02_P2.54mm_Vertical
J9: conn_signals_in_2; PinSocket_1x03_P2.54mm_Vertical
J10: conn_signals_in_3; PinSocket_1x02_P2.54mm_Vertical

Connections:
+5V: J2.1, J4.1; also elsewhere on the board
+12V: J2.2, J4.2; also elsewhere on the board
-12V: J2.4, J4.4; also elsewhere on the board
Clipping: J3.2; also elsewhere on the board
GNDD: J2.3, J4.3; also elsewhere on the board
LFO: J8.2; also elsewhere on the board
LFO_mod: J3.3; also elsewhere on the board
Manual_mod: J3.1; also elsewhere on the board
Pulse_in: J10.1, J10.2; also elsewhere on the board
Pulse_out: J1.6; also elsewhere on the board
Ramp_in: J5.3; also elsewhere on the board
Ramp_out: J1.4; also elsewhere on the board
Saw_in: J5.2; also elsewhere on the board
Saw_out: J1.5; also elsewhere on the board
Sine_in: J9.1; also elsewhere on the board
Sine_out: J1.1; also elsewhere on the board
Square_in: J9.3; also elsewhere on the board
Square_out: J1.3; also elsewhere on the board
Triangle_in: J9.2; also elsewhere on the board
Triangle_out: J1.2; also elsewhere on the board
VCO: J8.1; also elsewhere on the board
f_clk: J5.1; also elsewhere on the board

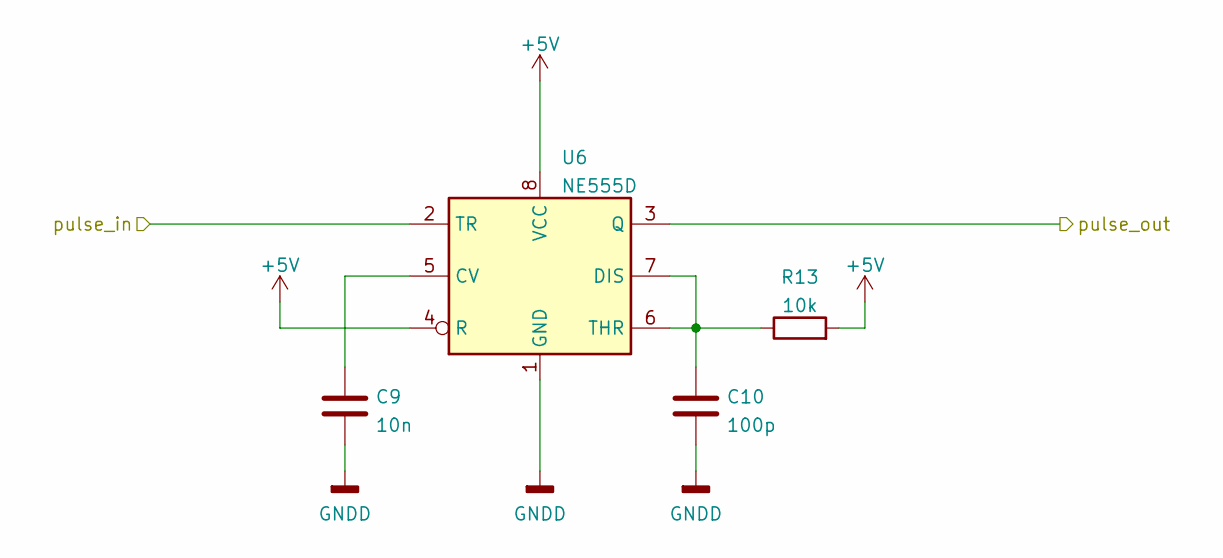
[picture p205: schematic monostable_circuit.kicad_sch, FGVCO - Core 1]

Parts:
C9: 10n; C_Disc_P2.54mm
C10: 100p; C_Disc_P2.54mm
R13: 10k; R_Axial_DIN0207_L6.3mm_D2.5mm_P10.16mm_Horizontal
U6: NE555D; DIP-8_central_caps

Connections:
+5V: R13.2, U6.4 (R), U6.8 (VCC); also elsewhere on the board
GNDD: C9.2, C10.2, U6.1 (GND); also elsewhere on the board
unnamed: C9.1, U6.5 (CV)
unnamed: C10.1, R13.1, U6.6 (THR), U6.7 (DIS)
Pulse_in: U6.2 (TR); also elsewhere on the board
Pulse_out: U6.3 (Q); also elsewhere on the board

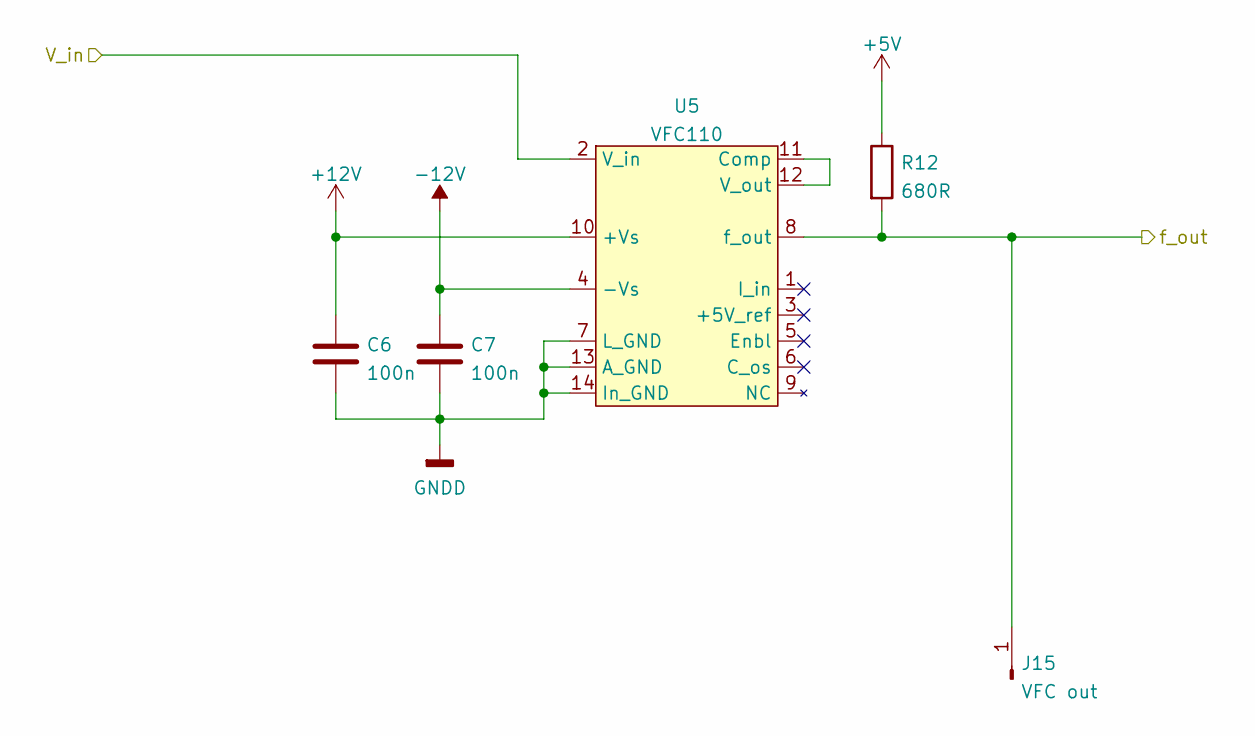
[picture p206: schematic v_f_conv.kicad_sch, FGVCO - Core 1]

Parts:
C6, C7: 100n; C_Disc_P2.54mm
J15: VFC out; PinHeader_1x01_P2.54mm_Vertical
R12: 680R; R_Axial_DIN0207_L6.3mm_D2.5mm_P10.16mm_Horizontal
U5: VFC110; DIP-14_central_caps

Connections:
+5V: R12.1; also elsewhere on the board
+12V: C6.2, U5.10 (+Vs); also elsewhere on the board
-12V: C7.2, U5.4 (-Vs); also elsewhere on the board
/Mode Selector/f_in: J15.1, R12.2, U5.8 (f_out); also elsewhere on the board
/Volt-Octave Converter/V_expo: U5.2 (V_in); also elsewhere on the board
GNDD: C6.1, C7.1, U5.7 (L_GND), U5.13 (A_GND), U5.14 (In_GND); also elsewhere on the board
unnamed: U5.11 (Comp), U5.12 (V_out)

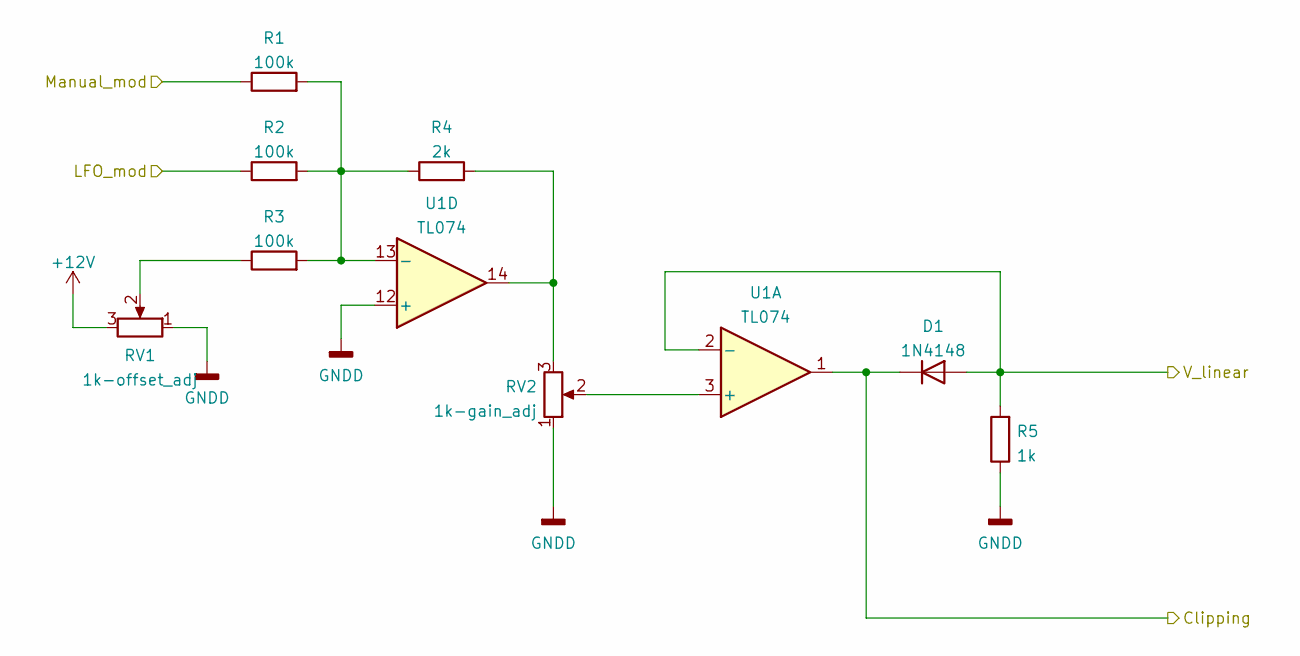
[picture p207: schematic sum_clip.kicad_sch, FGVCO - Core 1]

Parts:
D1: 1N4148; D_DO-35_SOD27_P7.62mm_Horizontal
R1, R2, R3: 100k; R_Axial_DIN0207_L6.3mm_D2.5mm_P10.16mm_Horizontal
R4: 2k; R_Axial_DIN0207_L6.3mm_D2.5mm_P10.16mm_Horizontal
R5: 1k; R_Axial_DIN0207_L6.3mm_D2.5mm_P10.16mm_Horizontal
RV1: 1k-offset_adj; Potentiometer_Vishay_T73YP_Vertical
RV2: 1k-gain_adj; Potentiometer_Bourns_3296W_Vertical
U1: TL074; DIP-14_central_caps

Connections:
+12V: RV1.3; also elsewhere on the board
/Summer-Clipper/V_linear: D1.2 (A), R5.2, U1.2 (-); also elsewhere on the board
Clipping: D1.1 (K), U1.1; also elsewhere on the board
GNDD: R5.1, RV1.1, RV2.1, U1.12 (+); also elsewhere on the board
LFO_mod: R2.1; also elsewhere on the board
Manual_mod: R1.1; also elsewhere on the board
unnamed: R1.2, R2.2, R3.2, R4.1, U1.13 (-)
unnamed: R3.1, RV1.2
unnamed: R4.2, RV2.3, U1.14
unnamed: RV2.2, U1.3 (+)

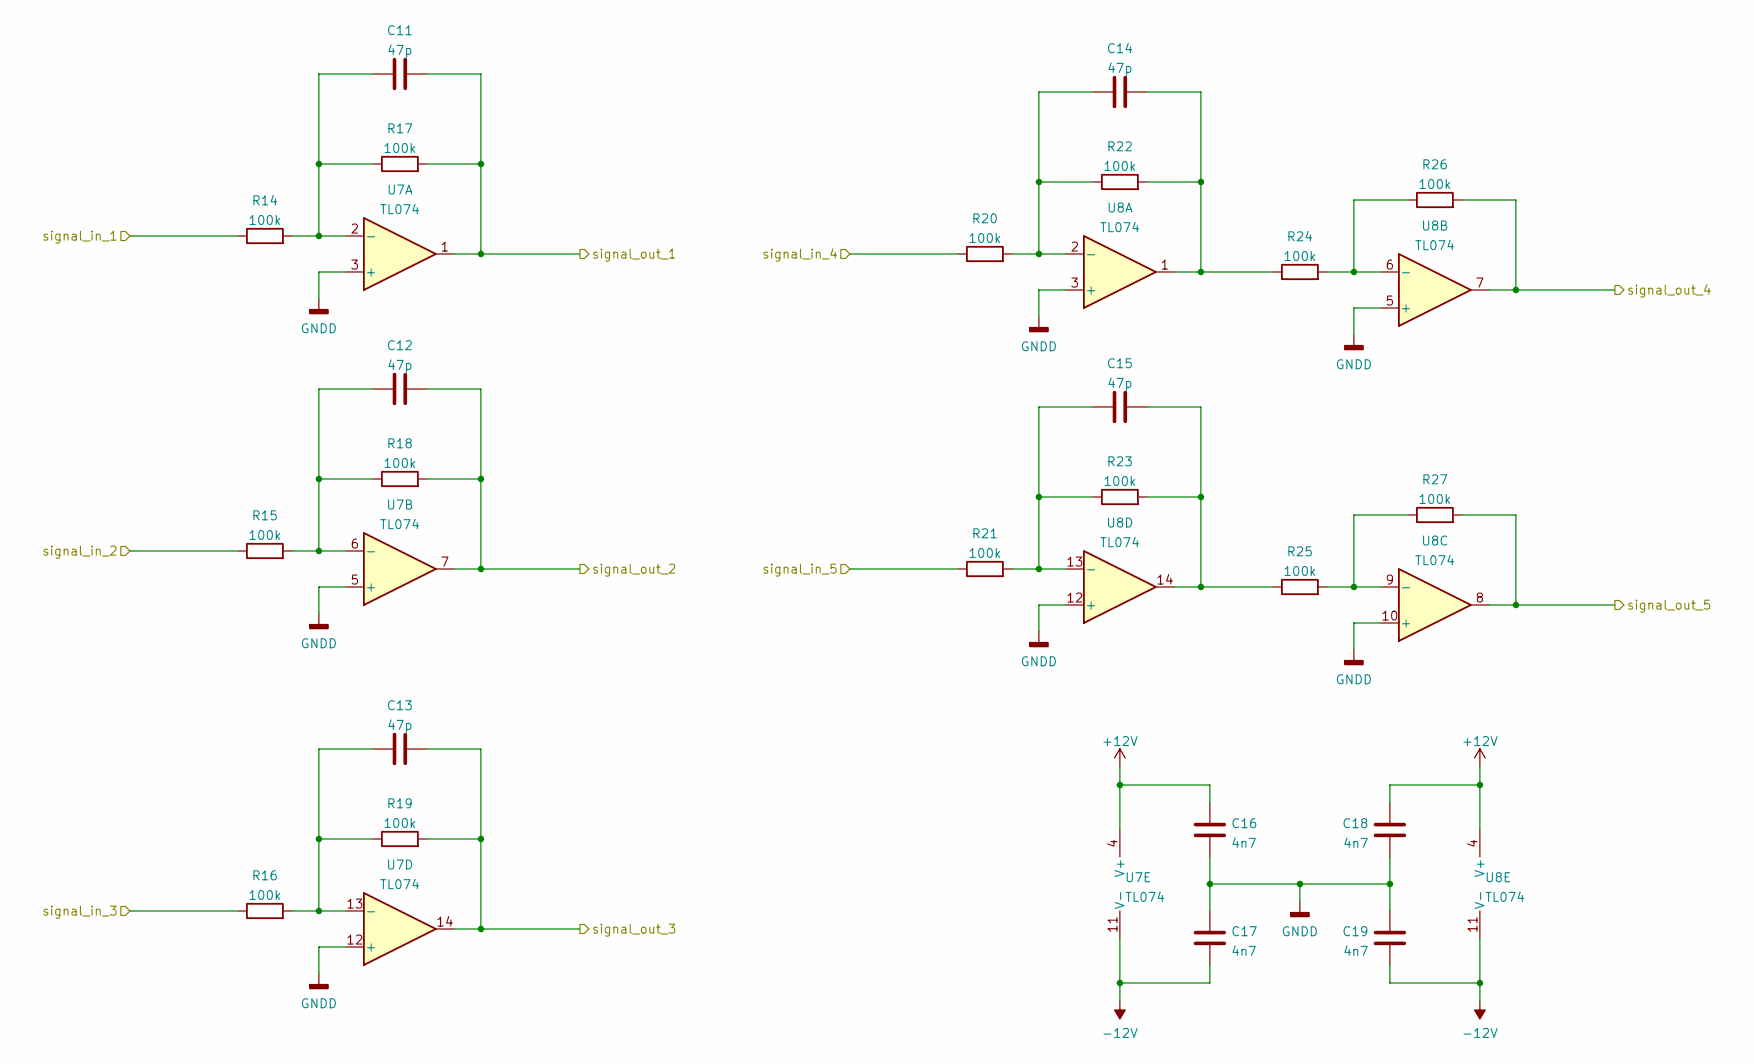
[picture p208: schematic out_stage.kicad_sch, FGVCO - Core 1]

Parts:
C11, C12, C13, C14, C15: 47p; C_Disc_P2.54mm
C16, C17, C18, C19: 4n7; C_Disc_P2.54mm
R14, R15, R16, R17, R18, R19, R20, R21, R22, R23, R24, R25, R26, R27: 100k; R_Axial_DIN0207_L6.3mm_D2.5mm_P10.16mm_Horizontal
U7, U8: TL074; DIP-14_central_caps

Connections:
+12V: C16.1, C18.1, U7.4 (V+), U8.4 (V+); also elsewhere on the board
-12V: C17.2, C19.2, U7.11 (V-), U8.11 (V-); also elsewhere on the board
GNDD: C16.2, C17.1, C18.2, C19.1, U7.3 (+), U7.5 (+), U7.12 (+), U8.3 (+), U8.5 (+), U8.10 (+), U8.12 (+); also elsewhere on the board
unnamed: C11.1, R14.2, R17.1, U7.2 (-)
unnamed: C12.1, R15.2, R18.1, U7.6 (-)
unnamed: C13.1, R16.2, R19.1, U7.13 (-)
unnamed: C14.1, R20.2, R22.1, U8.2 (-)
unnamed: C14.2, R22.2, R24.1, U8.1
unnamed: C15.1, R21.2, R23.1, U8.13 (-)
unnamed: C15.2, R23.2, R25.1, U8.14
unnamed: R24.2, R26.1, U8.6 (-)
unnamed: R25.2, R27.1, U8.9 (-)
Ramp_in: R20.1; also elsewhere on the board
Ramp_out: R26.2, U8.7; also elsewhere on the board
Saw_in: R21.1; also elsewhere on the board
Saw_out: R27.2, U8.8; also elsewhere on the board
Sine_in: R14.1; also elsewhere on the board
Sine_out: C11.2, R17.2, U7.1; also elsewhere on the board
Square_in: R16.1; also elsewhere on the board
Square_out: C13.2, R19.2, U7.14; also elsewhere on the board
Triangle_in: R15.1; also elsewhere on the board
Triangle_out: C12.2, R18.2, U7.7; also elsewhere on the board

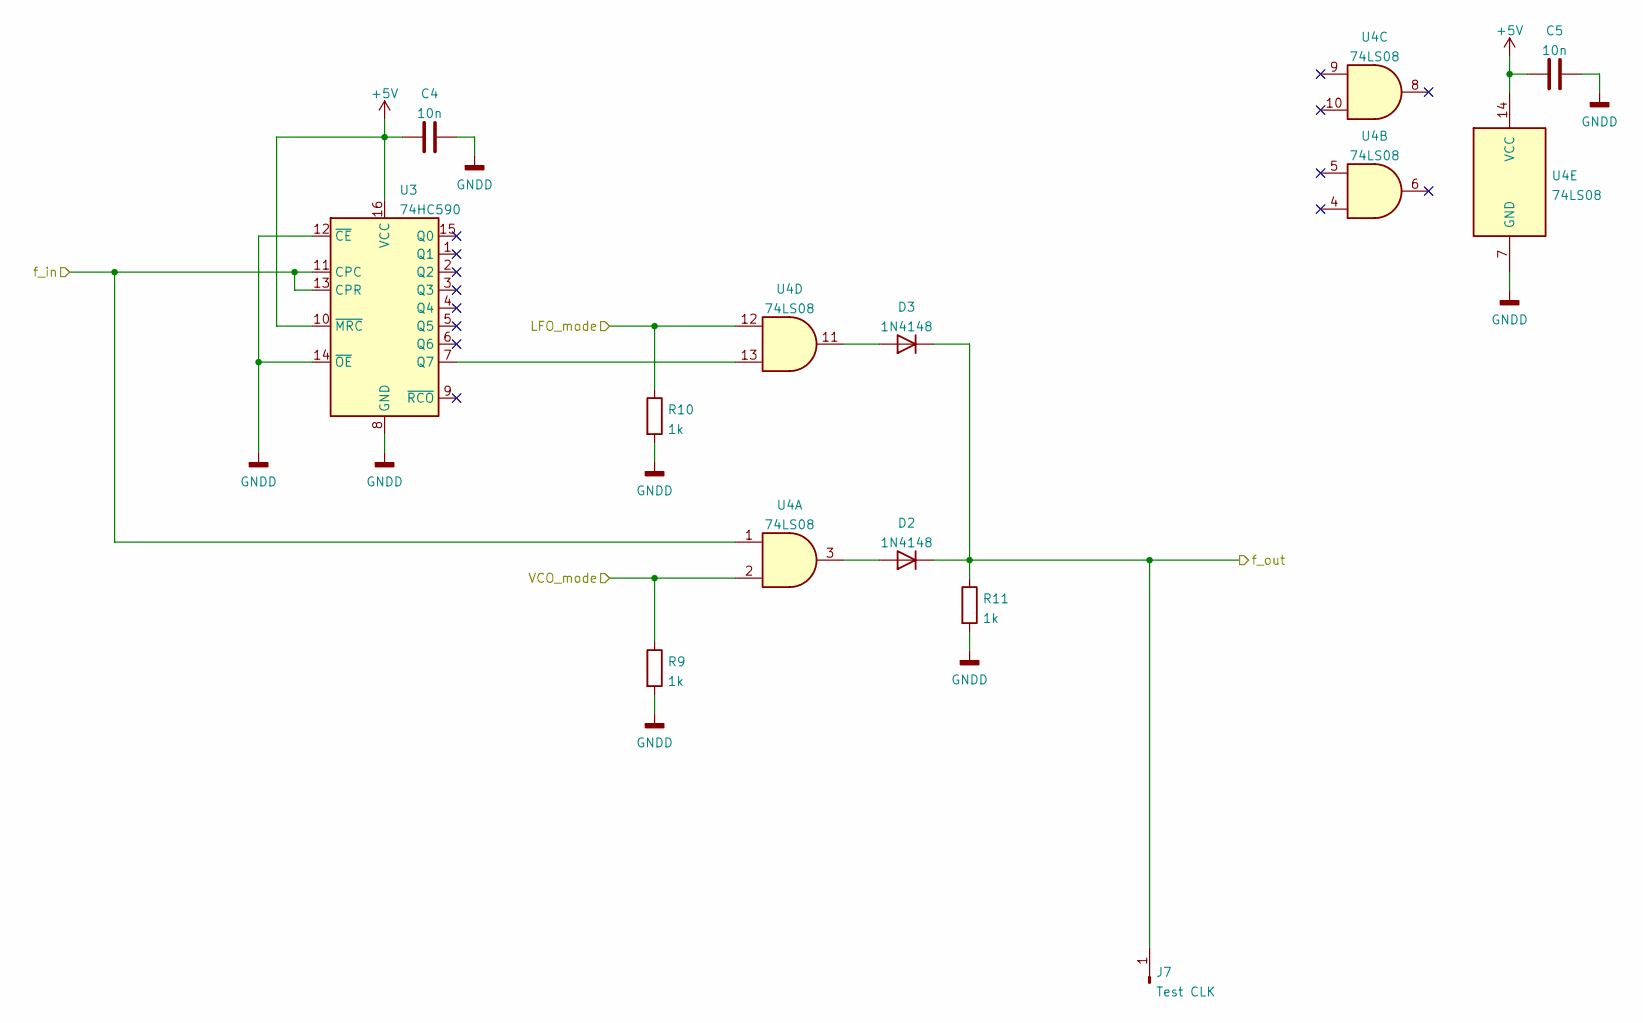
[picture p209: schematic mode_selector.kicad_sch, FGVCO - Core 1]

Parts:
C4, C5: 10n; C_Disc_P2.54mm
D2, D3: 1N4148; D_DO-35_SOD27_P7.62mm_Horizontal
J7: Test CLK; PinHeader_1x01_P2.54mm_Vertical
R9, R10, R11: 1k; R_Axial_DIN0207_L6.3mm_D2.5mm_P10.16mm_Horizontal
U3: 74HC590; DIP-16_central_caps
U4: 74LS08; DIP-14_central_caps

Connections:
+5V: C4.2, C5.2, U3.10 (~MRC), U3.16 (VCC), U4.14 (VCC); also elsewhere on the board
/Mode Selector/f_in: U3.11 (CPC), U3.13 (CPR), U4.1; also elsewhere on the board
GNDD: C4.1, C5.1, R9.2, R10.2, R11.2, U3.8 (GND), U3.12 (~CE), U3.14 (~OE), U4.7 (GND); also elsewhere on the board
LFO: R10.1, U4.12; also elsewhere on the board
unnamed: D2.2 (A), U4.3
unnamed: D3.2 (A), U4.11
unnamed: U3.7 (Q7), U4.13
VCO: R9.1, U4.2; also elsewhere on the board
f_clk: D2.1 (K), D3.1 (K), J7.1, R11.1; also elsewhere on the board

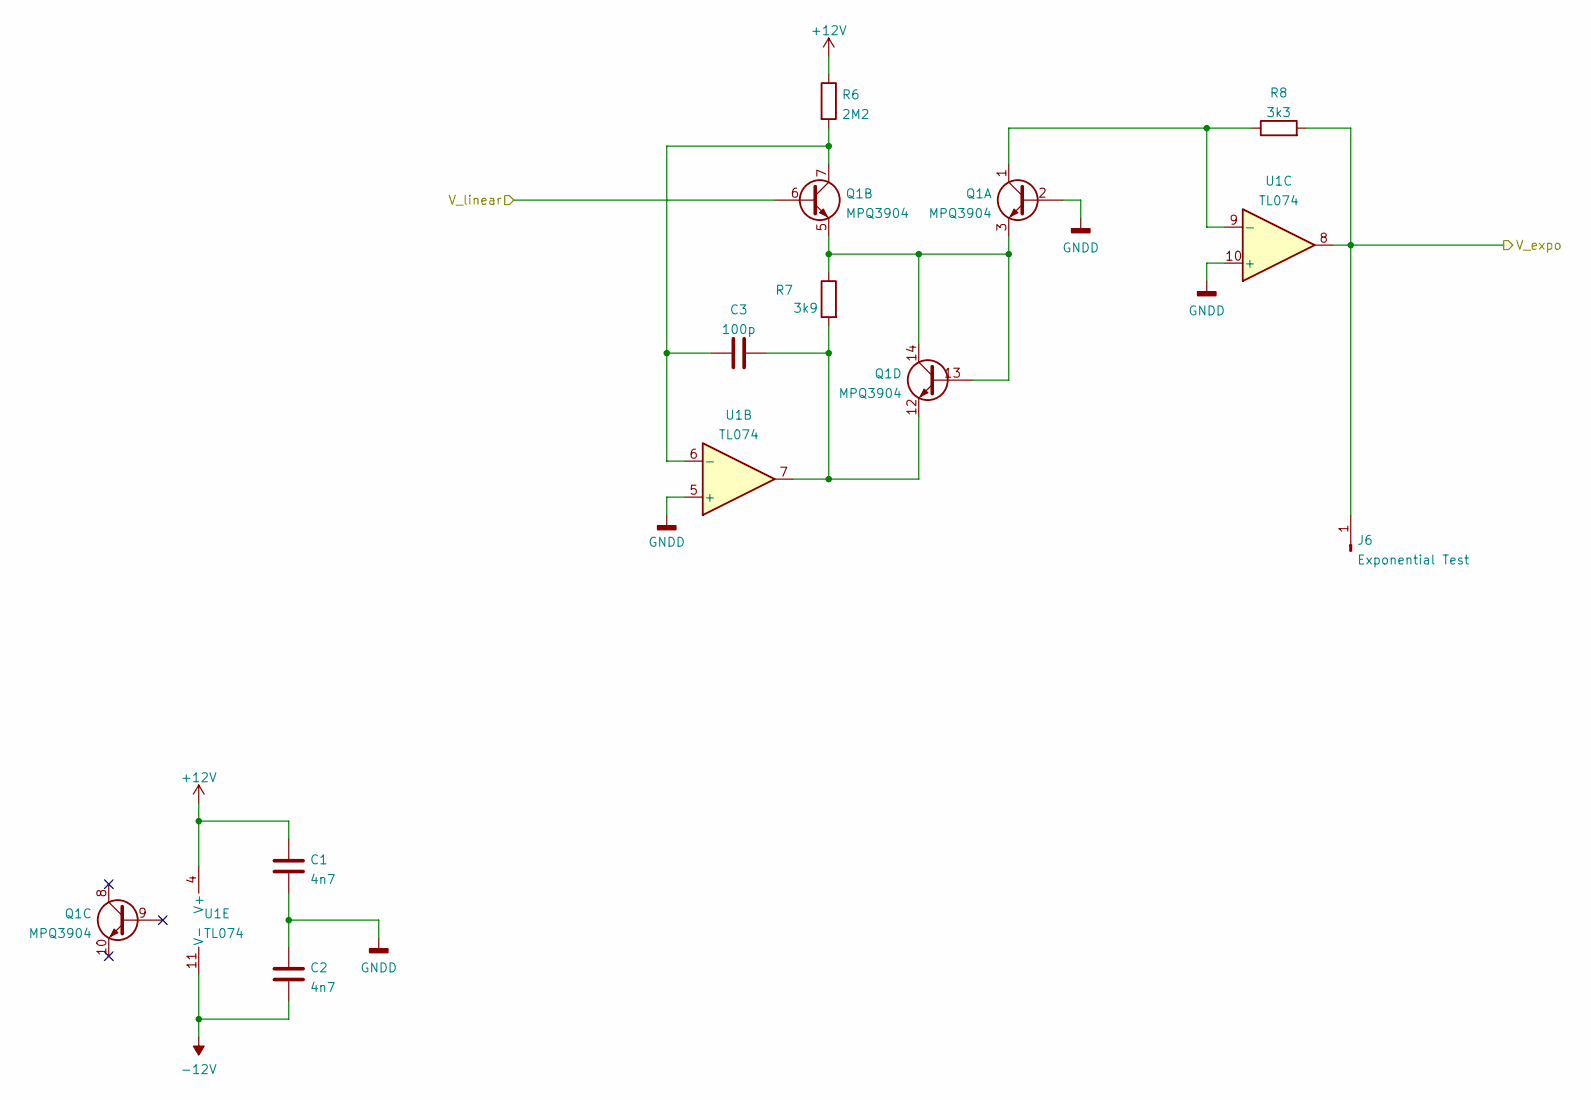
[picture p210: schematic v_oct_conv.kicad_sch, FGVCO - Core 1]

Parts:
C1, C2: 4n7; C_Disc_P2.54mm
C3: 100p; C_Disc_P2.54mm
J6: Exponential Test; PinHeader_1x01_P2.54mm_Vertical
Q1: MPQ3904; DIP-14_central_caps
R6: 2M2; R_Axial_DIN0207_L6.3mm_D2.5mm_P10.16mm_Horizontal
R7: 3k9; R_Axial_DIN0207_L6.3mm_D2.5mm_P10.16mm_Horizontal
R8: 3k3; R_Axial_DIN0207_L6.3mm_D2.5mm_P10.16mm_Horizontal
U1: TL074; DIP-14_central_caps

Connections:
+12V: C1.1, R6.1, U1.4 (V+); also elsewhere on the board
-12V: C2.2, U1.11 (V-); also elsewhere on the board
/Summer-Clipper/V_linear: Q1.6; also elsewhere on the board
/Volt-Octave Converter/V_expo: J6.1, R8.2, U1.8; also elsewhere on the board
GNDD: C1.2, C2.1, Q1.2, U1.5 (+), U1.10 (+); also elsewhere on the board
unnamed: C3.1, Q1.7, R6.2, U1.6 (-)
unnamed: C3.2, Q1.12, R7.2, U1.7
unnamed: Q1.1, R8.1, U1.9 (-)
unnamed: Q1.3, Q1.5, Q1.13, Q1.14, R7.1

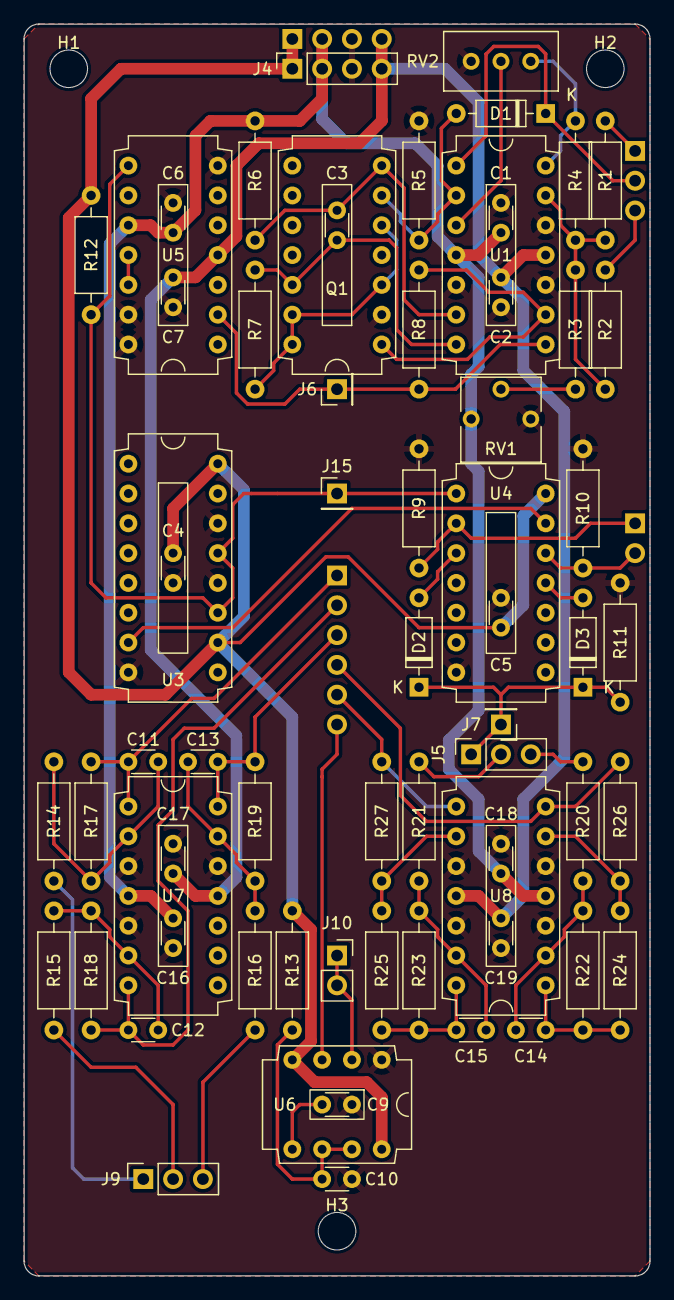
[picture p211: board FG-VCO-(core1).kicad_pcb from above]

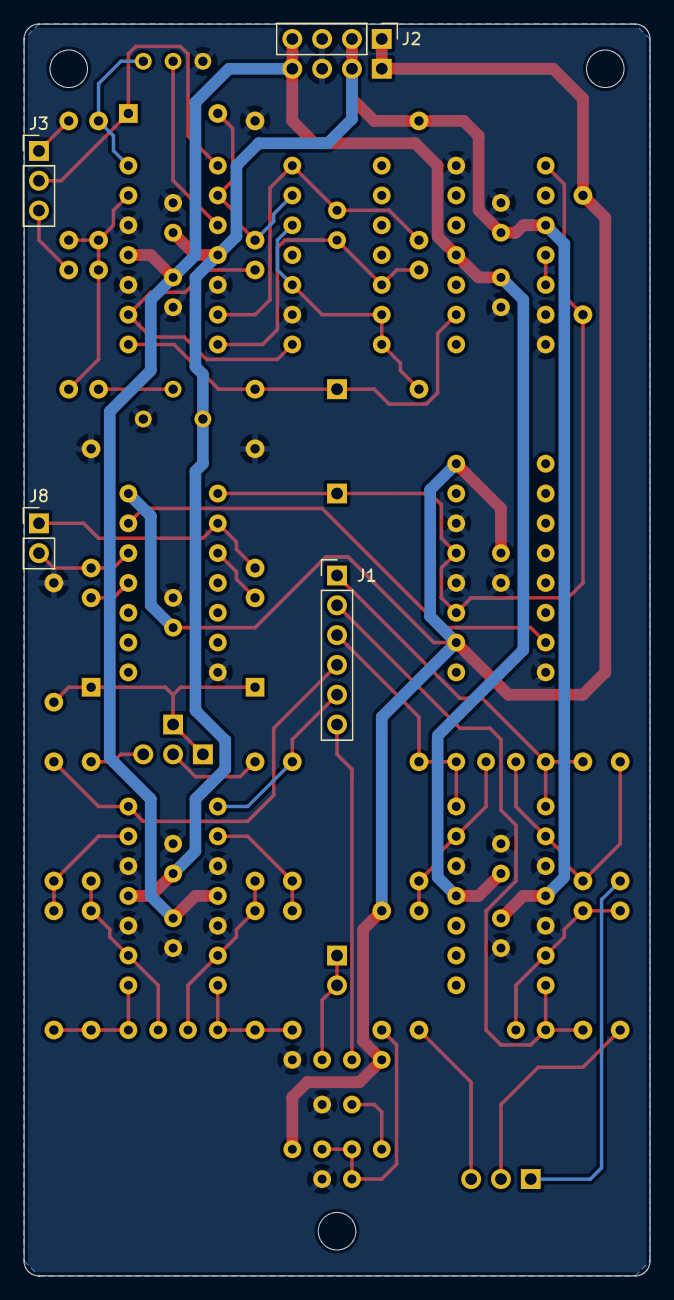
[picture p212: board FG-VCO-(core1).kicad_pcb from below]

Board: 2 copper layers, 53.3 x 106.7 mm, 72 parts (4 on the bottom side), 48 nets.
