PippoGot/FGVCO/FG-VCO-(core2)/FG-VCO-(core2).kicad_pcb

## KiCad design FG-VCO-(core2)/FG-VCO-(core2).kicad_pcb (2022-08-09)

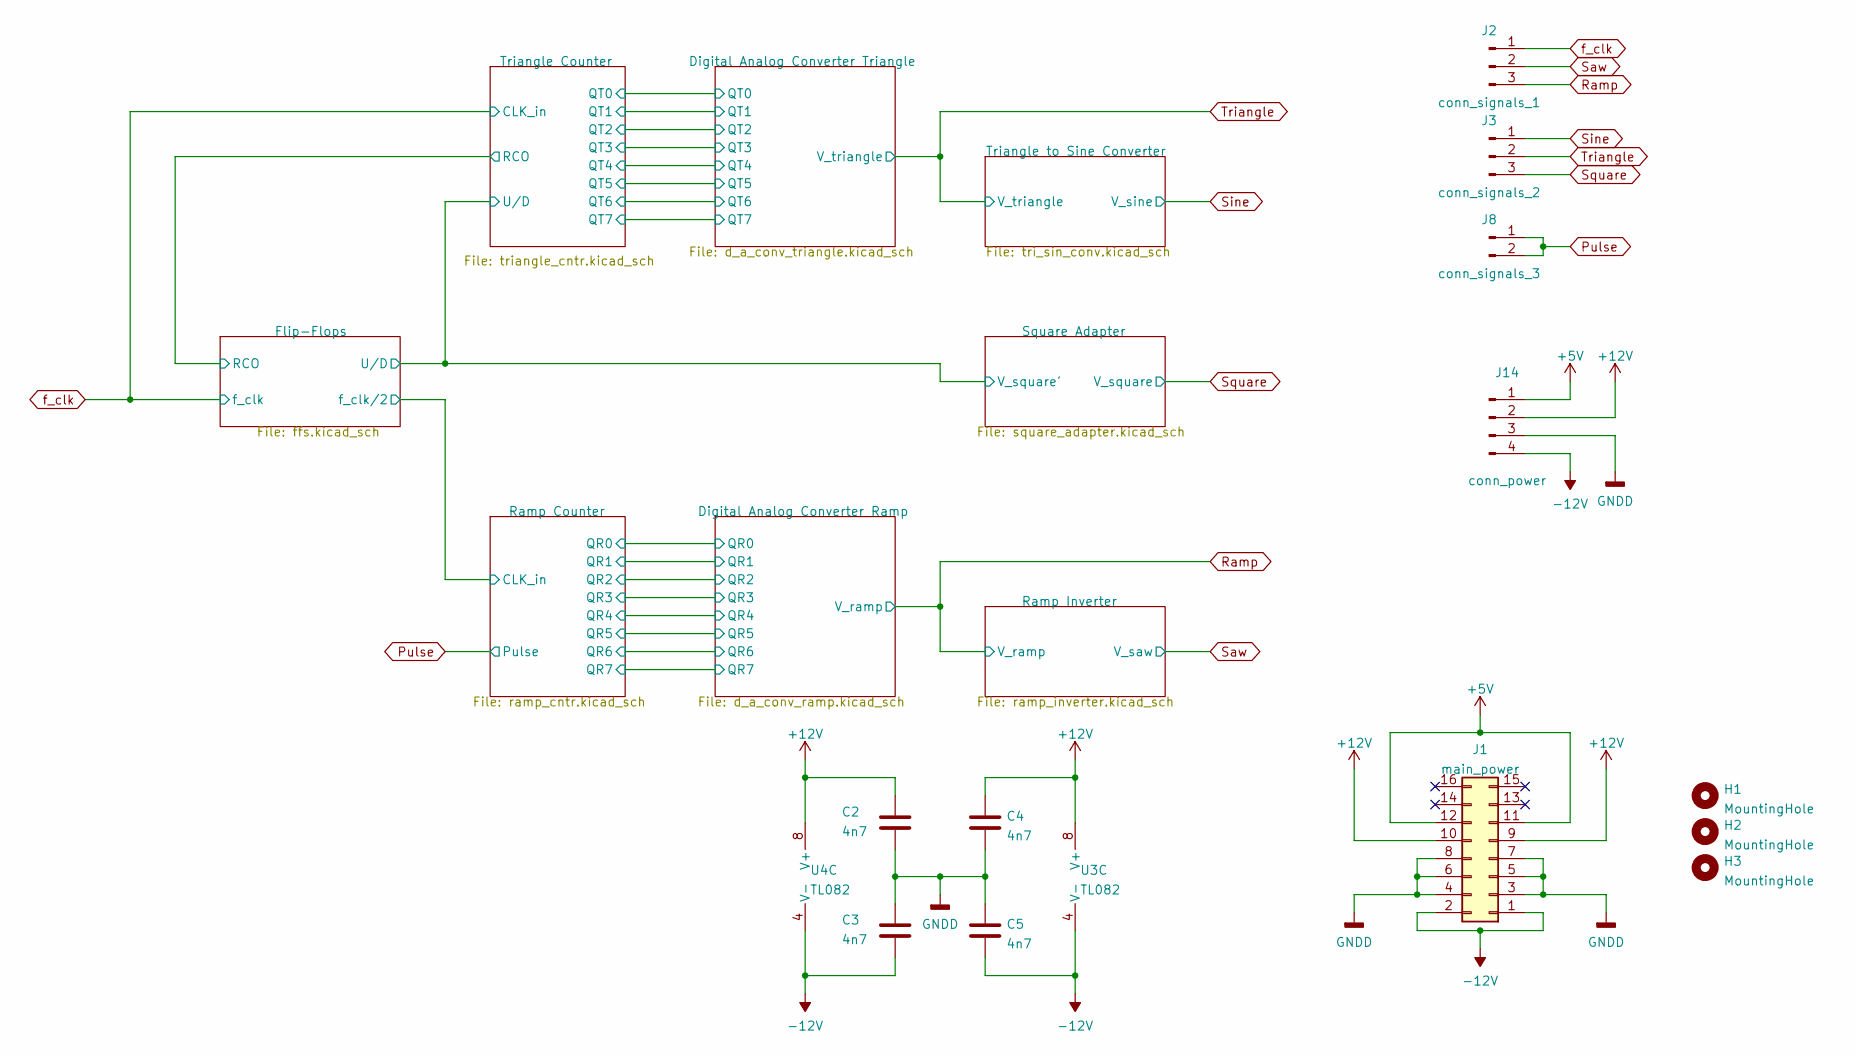
[picture p213: schematic FG-VCO-(core2).kicad_sch, FGVCO]

Parts:
C2, C3, C4, C5: 4n7; C_Disc_P2.54mm
H1, H2, H3: MountingHole; MountingHole_3.2mm_M3
J1: main_power; Eurorack custom eFuse board 2x08_P2.54mm
J2: conn_signals_1; PinHeader_1x03_P2.54mm_Vertical
J3: conn_signals_2; PinHeader_1x03_P2.54mm_Vertical
J8: conn_signals_3; PinHeader_1x02_P2.54mm_Vertical
J14: conn_power; PinHeader_1x04_P2.54mm_Vertical
U3, U4: TL082; DIP-8_central_caps

Connections:
+5V: J1.11, J1.12, J14.1; also elsewhere on the board
+12V: C2.1, C4.1, J1.9, J1.10, J14.2, U3.8 (V+), U4.8 (V+); also elsewhere on the board
-12V: C3.2, C5.2, J1.1, J1.2, J14.4, U3.4 (V-), U4.4 (V-); also elsewhere on the board
GNDD: C2.2, C3.1, C4.2, C5.1, J1.3, J1.4, J1.5, J1.6, J1.7, J1.8, J14.3; also elsewhere on the board
Pulse: J8.1, J8.2; also elsewhere on the board
Ramp: J2.3; also elsewhere on the board
Saw: J2.2; also elsewhere on the board
Sine: J3.1; also elsewhere on the board
Square: J3.3; also elsewhere on the board
Triangle: J3.2; also elsewhere on the board
f_clk: J2.1; also elsewhere on the board

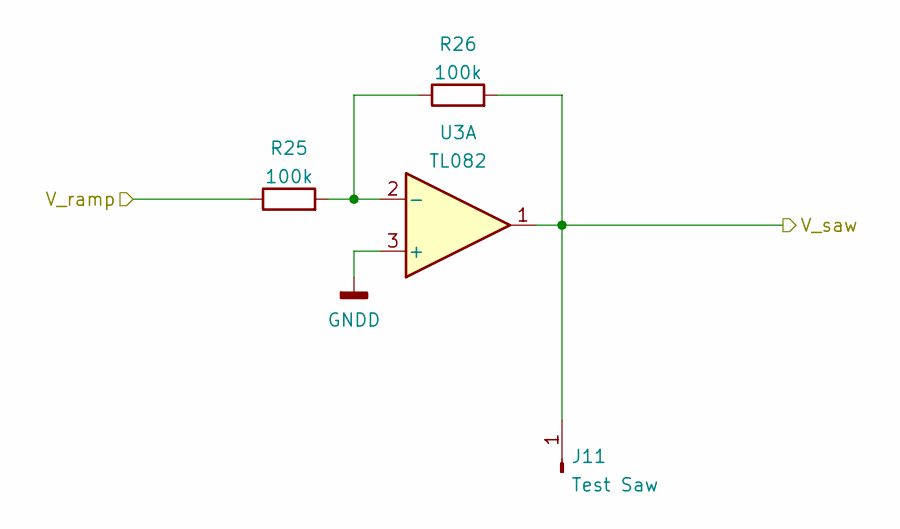
[picture p214: schematic ramp_inverter.kicad_sch]

Parts:
J11: Test Saw; PinHeader_1x01_P2.54mm_Vertical
R25, R26: 100k; R_Axial_DIN0207_L6.3mm_D2.5mm_P10.16mm_Horizontal
U3: TL082; DIP-8_central_caps

Connections:
GNDD: U3.3 (+); also elsewhere on the board
unnamed: R25.2, R26.1, U3.2 (-)
Ramp: R25.1; also elsewhere on the board
Saw: J11.1, R26.2, U3.1; also elsewhere on the board

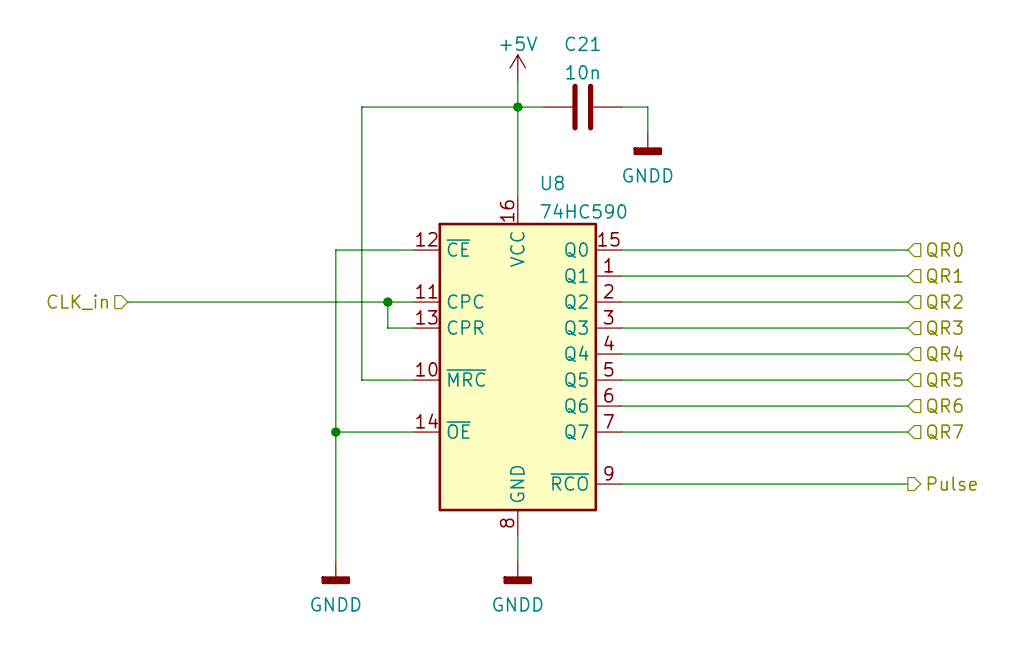
[picture p215: schematic ramp_cntr.kicad_sch]

Parts:
C21: 10n; C_Disc_P2.54mm
U8: 74HC590; DIP-16_central_caps

Connections:
+5V: C21.2, U8.10 (~MRC), U8.16 (VCC); also elsewhere on the board
/Digital Analog Converter Ramp/QR0: U8.15 (Q0); also elsewhere on the board
/Digital Analog Converter Ramp/QR1: U8.1 (Q1); also elsewhere on the board
/Digital Analog Converter Ramp/QR2: U8.2 (Q2); also elsewhere on the board
/Digital Analog Converter Ramp/QR3: U8.3 (Q3); also elsewhere on the board
/Digital Analog Converter Ramp/QR4: U8.4 (Q4); also elsewhere on the board
/Digital Analog Converter Ramp/QR5: U8.5 (Q5); also elsewhere on the board
/Digital Analog Converter Ramp/QR6: U8.6 (Q6); also elsewhere on the board
/Digital Analog Converter Ramp/QR7: U8.7 (Q7); also elsewhere on the board
/Flip-Flops/f_clk/2: U8.11 (CPC), U8.13 (CPR); also elsewhere on the board
GNDD: C21.1, U8.8 (GND), U8.12 (~CE), U8.14 (~OE); also elsewhere on the board
Pulse: U8.9 (~RCO); also elsewhere on the board

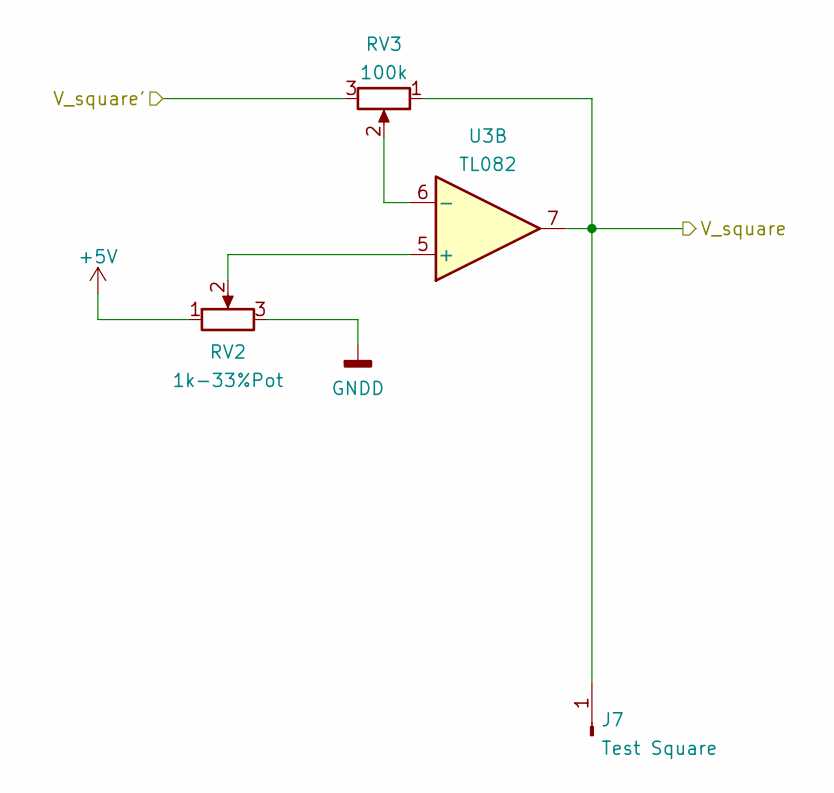
[picture p216: schematic square_adapter.kicad_sch]

Parts:
J7: Test Square; PinHeader_1x01_P2.54mm_Vertical
RV2: 1k-33%Pot; Potentiometer_Vishay_T73YP_Vertical
RV3: 100k; Potentiometer_Vishay_T73YP_Vertical
U3: TL082; DIP-8_central_caps

Connections:
+5V: RV2.1; also elsewhere on the board
/Flip-Flops/U/D: RV3.3; also elsewhere on the board
GNDD: RV2.3; also elsewhere on the board
unnamed: RV2.2, U3.5 (+)
unnamed: RV3.2, U3.6 (-)
Square: J7.1, RV3.1, U3.7; also elsewhere on the board

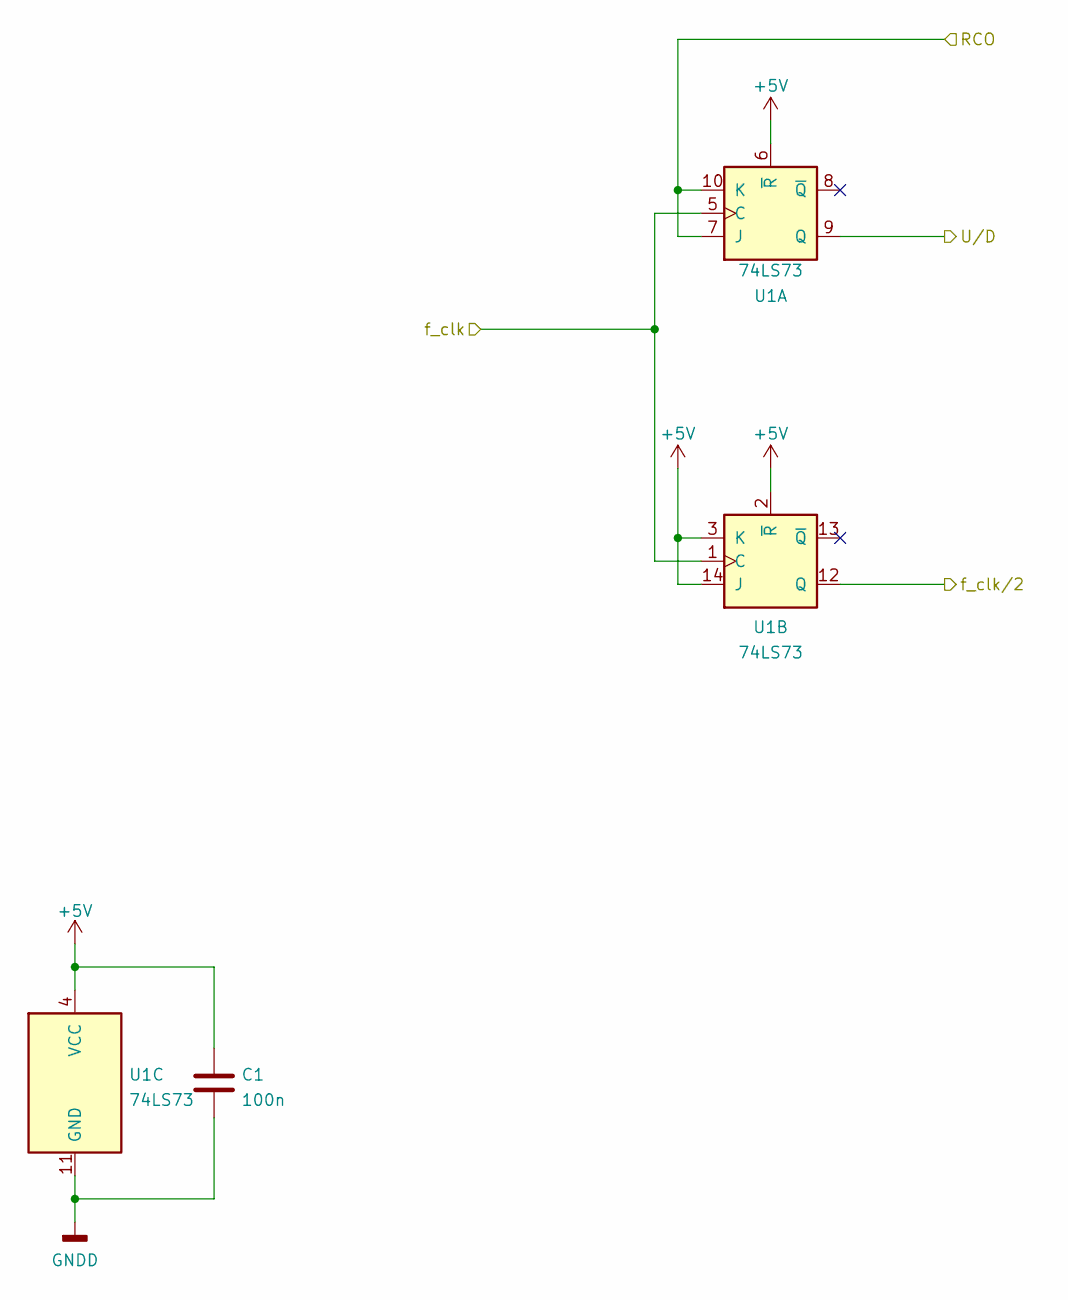
[picture p217: schematic ffs.kicad_sch]

Parts:
C1: 100n; C_Disc_P2.54mm
U1: 74LS73; DIP-14_central_caps

Connections:
+5V: C1.1, U1.2 (~R), U1.3 (K), U1.4 (VCC), U1.6 (~R), U1.14 (J); also elsewhere on the board
/Flip-Flops/RCO: U1.7 (J), U1.10 (K); also elsewhere on the board
/Flip-Flops/U/D: U1.9 (Q); also elsewhere on the board
/Flip-Flops/f_clk/2: U1.12 (Q); also elsewhere on the board
GNDD: C1.2, U1.11 (GND); also elsewhere on the board
f_clk: U1.1 (C), U1.5 (C); also elsewhere on the board

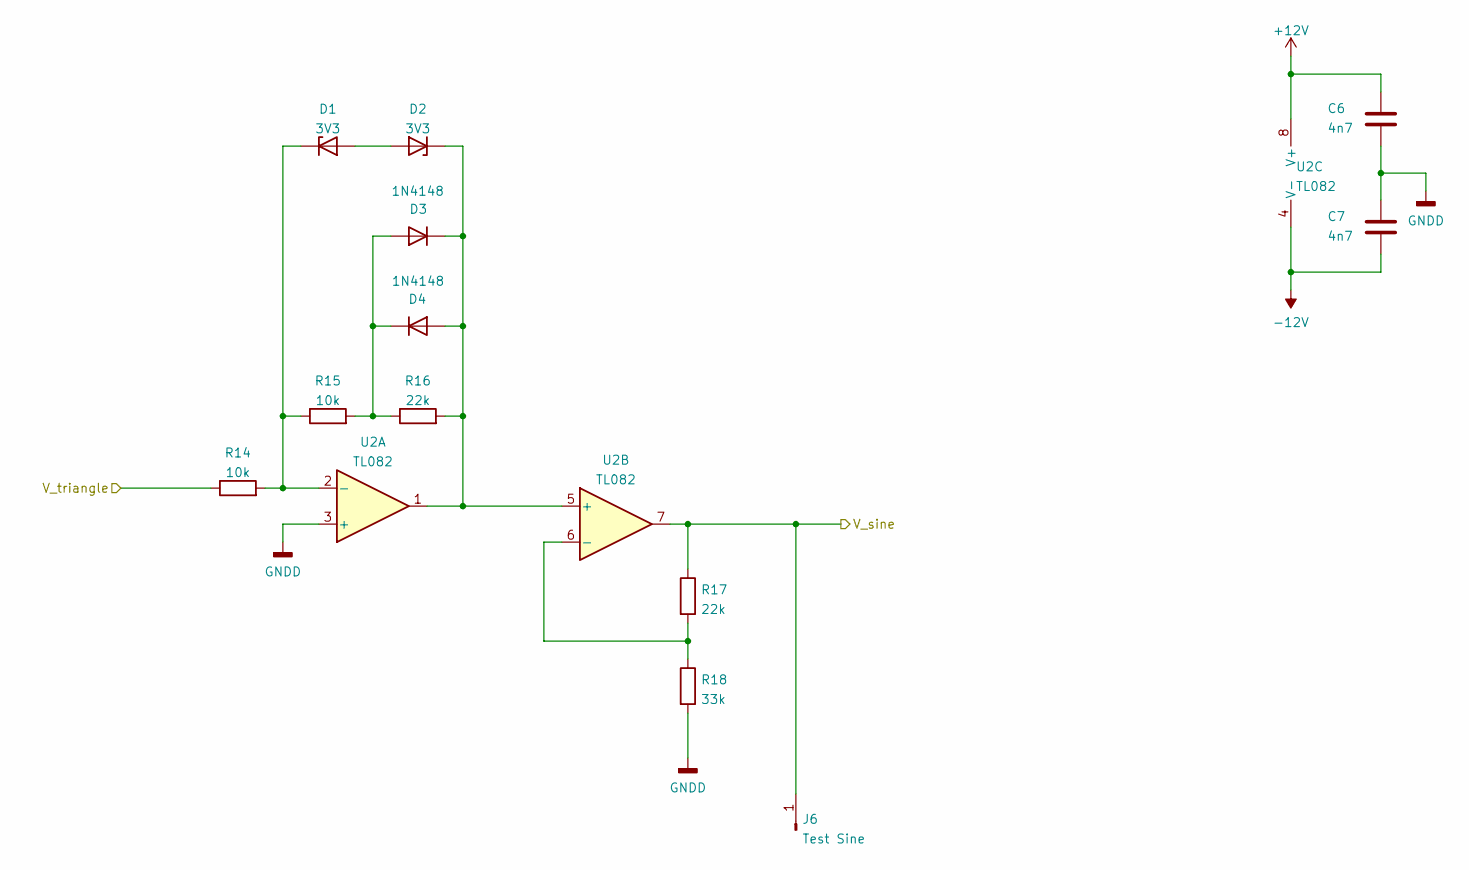
[picture p218: schematic tri_sin_conv.kicad_sch]

Parts:
C6, C7: 4n7; C_Disc_P2.54mm
D1, D2: 3V3; D_DO-35_SOD27_P7.62mm_Horizontal
D3, D4: 1N4148; D_DO-35_SOD27_P7.62mm_Horizontal
J6: Test Sine; PinHeader_1x01_P2.54mm_Vertical
R14, R15: 10k; R_Axial_DIN0207_L6.3mm_D2.5mm_P10.16mm_Horizontal
R16, R17: 22k; R_Axial_DIN0207_L6.3mm_D2.5mm_P10.16mm_Horizontal
R18: 33k; R_Axial_DIN0207_L6.3mm_D2.5mm_P10.16mm_Horizontal
U2: TL082; DIP-8_central_caps

Connections:
+12V: C6.1, U2.8 (V+); also elsewhere on the board
-12V: C7.2, U2.4 (V-); also elsewhere on the board
GNDD: C6.2, C7.1, R18.2, U2.3 (+); also elsewhere on the board
unnamed: D1.1 (K), R14.2, R15.1, U2.2 (-)
unnamed: D1.2 (A), D2.2 (A)
unnamed: D2.1 (K), D3.1 (K), D4.2 (A), R16.2, U2.1, U2.5 (+)
unnamed: D3.2 (A), D4.1 (K), R15.2, R16.1
unnamed: R17.2, R18.1, U2.6 (-)
Sine: J6.1, R17.1, U2.7; also elsewhere on the board
Triangle: R14.1; also elsewhere on the board

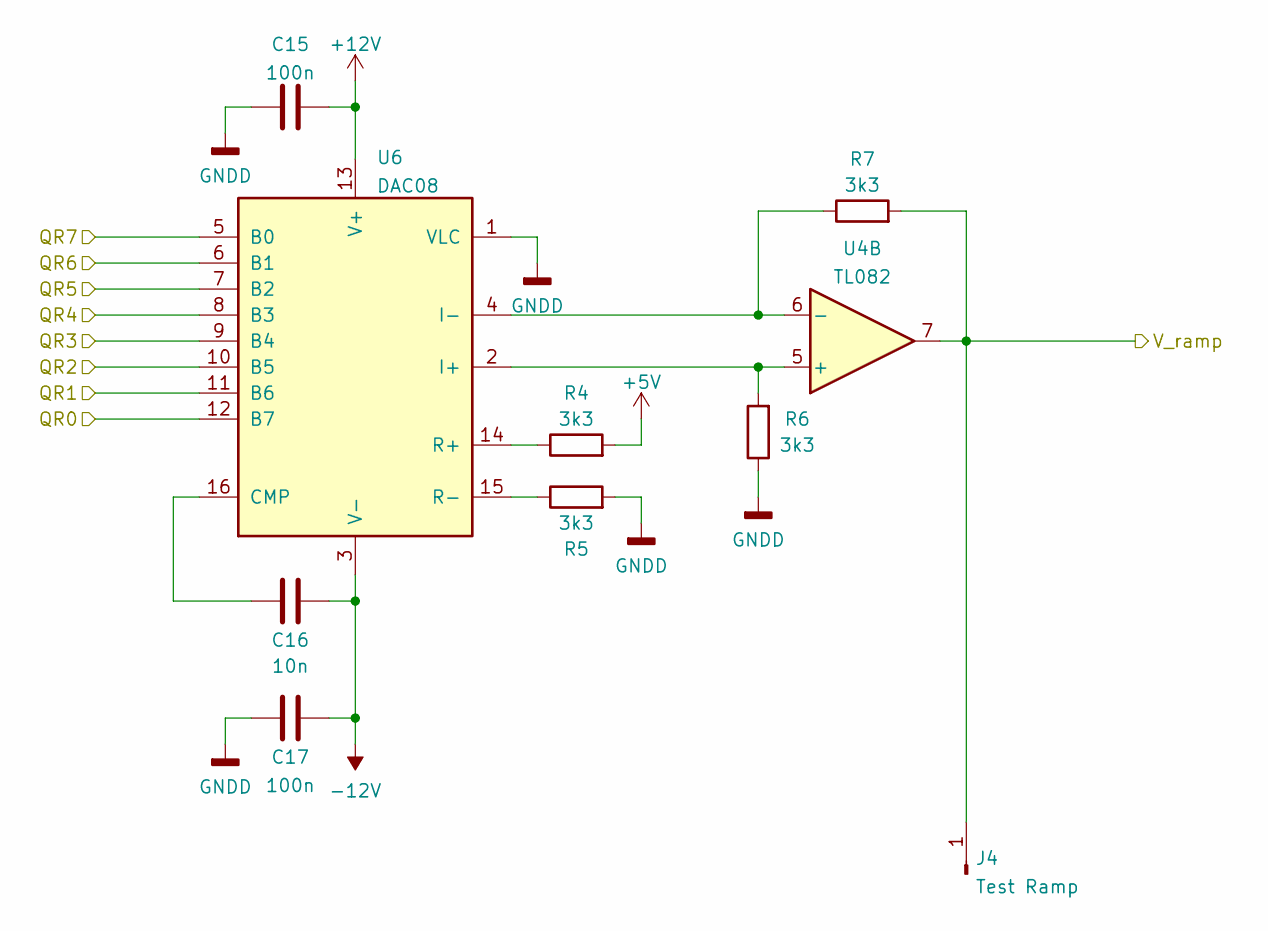
[picture p219: schematic d_a_conv_ramp.kicad_sch]

Parts:
C15, C17: 100n; C_Disc_P2.54mm
C16: 10n; C_Disc_P2.54mm
J4: Test Ramp; PinHeader_1x01_P2.54mm_Vertical
R4, R5, R6, R7: 3k3; R_Axial_DIN0207_L6.3mm_D2.5mm_P10.16mm_Horizontal
U4: TL082; DIP-8_central_caps
U6: DAC08; DIP-16_central_caps

Connections:
+5V: R4.2; also elsewhere on the board
+12V: C15.2, U6.13 (V+); also elsewhere on the board
-12V: C16.1, C17.1, U6.3 (V-); also elsewhere on the board
/Digital Analog Converter Ramp/QR0: U6.12 (B7); also elsewhere on the board
/Digital Analog Converter Ramp/QR1: U6.11 (B6); also elsewhere on the board
/Digital Analog Converter Ramp/QR2: U6.10 (B5); also elsewhere on the board
/Digital Analog Converter Ramp/QR3: U6.9 (B4); also elsewhere on the board
/Digital Analog Converter Ramp/QR4: U6.8 (B3); also elsewhere on the board
/Digital Analog Converter Ramp/QR5: U6.7 (B2); also elsewhere on the board
/Digital Analog Converter Ramp/QR6: U6.6 (B1); also elsewhere on the board
/Digital Analog Converter Ramp/QR7: U6.5 (B0); also elsewhere on the board
GNDD: C15.1, C17.2, R5.2, R6.1, U6.1 (VLC); also elsewhere on the board
unnamed: C16.2, U6.16 (CMP)
unnamed: R4.1, U6.14 (R+)
unnamed: R5.1, U6.15 (R-)
unnamed: R6.2, U4.5 (+), U6.2 (I+)
unnamed: R7.1, U4.6 (-), U6.4 (I-)
Ramp: J4.1, R7.2, U4.7; also elsewhere on the board

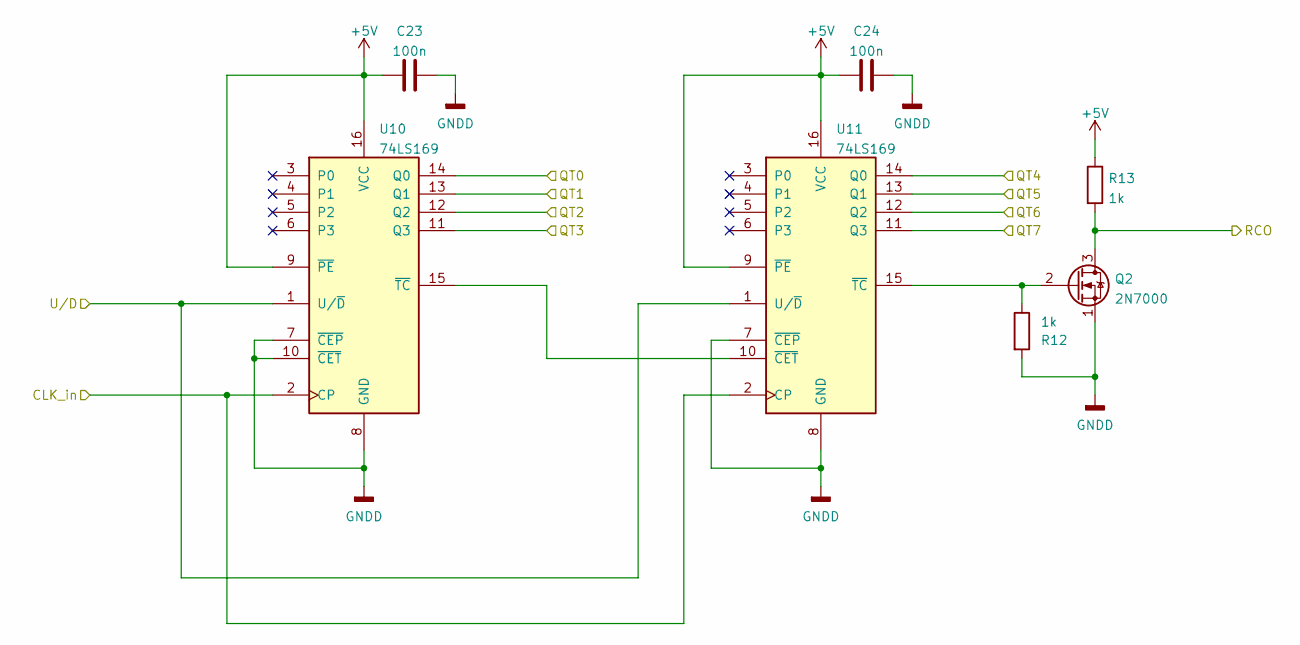
[picture p220: schematic triangle_cntr.kicad_sch]

Parts:
C23, C24: 100n; C_Disc_P2.54mm
Q2: 2N7000; TO-92
R12, R13: 1k; R_Axial_DIN0207_L6.3mm_D2.5mm_P10.16mm_Horizontal
U10, U11: 74LS169; DIP-16_central_caps

Connections:
+5V: C23.1, C24.1, R13.1, U10.9 (~PE), U10.16 (VCC), U11.9 (~PE), U11.16 (VCC); also elsewhere on the board
/Digital Analog Converter Triangle/QT0: U10.14 (Q0); also elsewhere on the board
/Digital Analog Converter Triangle/QT1: U10.13 (Q1); also elsewhere on the board
/Digital Analog Converter Triangle/QT2: U10.12 (Q2); also elsewhere on the board
/Digital Analog Converter Triangle/QT3: U10.11 (Q3); also elsewhere on the board
/Digital Analog Converter Triangle/QT4: U11.14 (Q0); also elsewhere on the board
/Digital Analog Converter Triangle/QT5: U11.13 (Q1); also elsewhere on the board
/Digital Analog Converter Triangle/QT6: U11.12 (Q2); also elsewhere on the board
/Digital Analog Converter Triangle/QT7: U11.11 (Q3); also elsewhere on the board
/Flip-Flops/RCO: Q2.3 (D), R13.2; also elsewhere on the board
/Flip-Flops/U/D: U10.1 (U/~D), U11.1 (U/~D); also elsewhere on the board
GNDD: C23.2, C24.2, Q2.1 (S), R12.2, U10.7 (~CEP), U10.8 (GND), U10.10 (~CET), U11.7 (~CEP), U11.8 (GND); also elsewhere on the board
unnamed: Q2.2 (G), R12.1, U11.15 (~TC)
unnamed: U10.15 (~TC), U11.10 (~CET)
f_clk: U10.2 (CP), U11.2 (CP); also elsewhere on the board

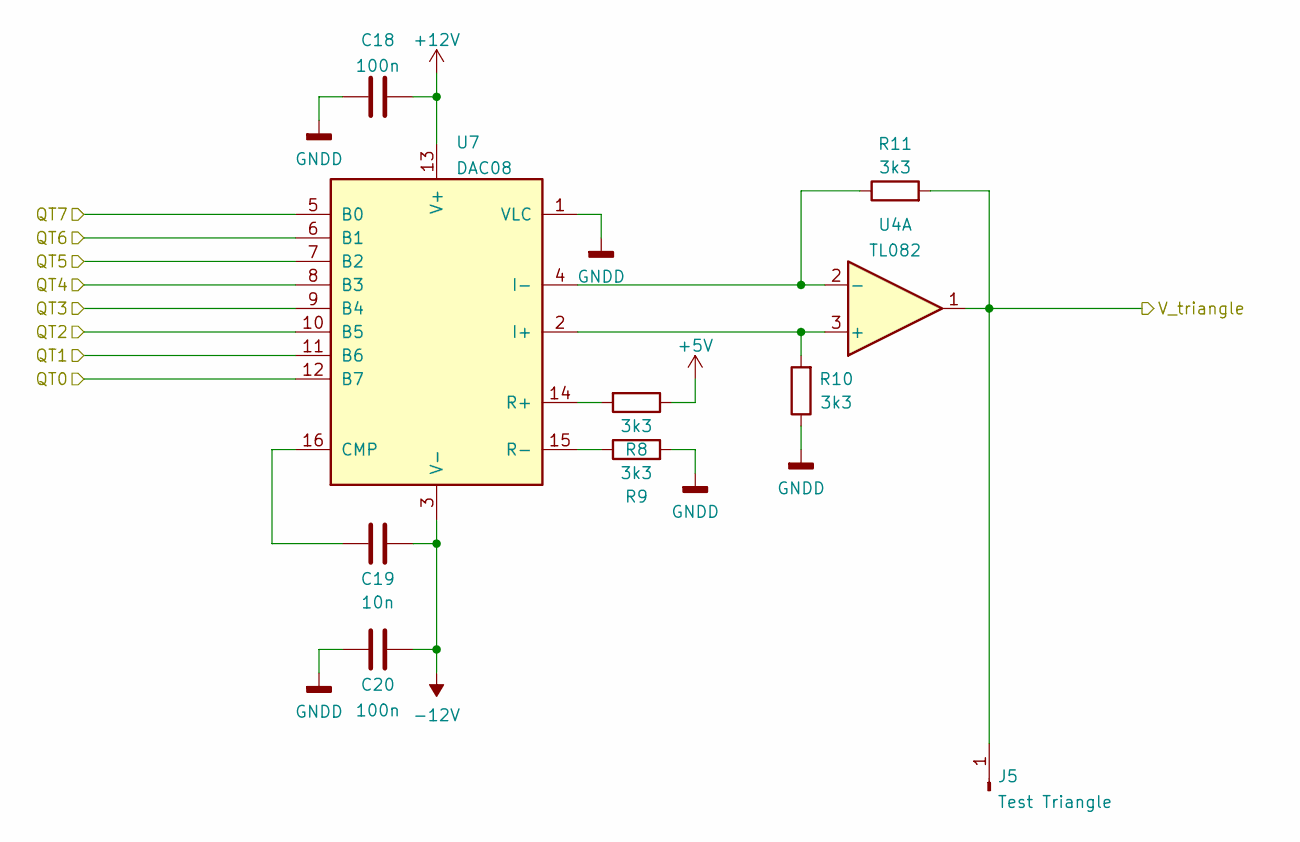
[picture p221: schematic d_a_conv_triangle.kicad_sch]

Parts:
C18, C20: 100n; C_Disc_P2.54mm
C19: 10n; C_Disc_P2.54mm
J5: Test Triangle; PinHeader_1x01_P2.54mm_Vertical
R8, R9, R10, R11: 3k3; R_Axial_DIN0207_L6.3mm_D2.5mm_P10.16mm_Horizontal
U4: TL082; DIP-8_central_caps
U7: DAC08; DIP-16_central_caps

Connections:
+5V: R8.1; also elsewhere on the board
+12V: C18.2, U7.13 (V+); also elsewhere on the board
-12V: C19.1, C20.1, U7.3 (V-); also elsewhere on the board
/Digital Analog Converter Triangle/QT0: U7.12 (B7); also elsewhere on the board
/Digital Analog Converter Triangle/QT1: U7.11 (B6); also elsewhere on the board
/Digital Analog Converter Triangle/QT2: U7.10 (B5); also elsewhere on the board
/Digital Analog Converter Triangle/QT3: U7.9 (B4); also elsewhere on the board
/Digital Analog Converter Triangle/QT4: U7.8 (B3); also elsewhere on the board
/Digital Analog Converter Triangle/QT5: U7.7 (B2); also elsewhere on the board
/Digital Analog Converter Triangle/QT6: U7.6 (B1); also elsewhere on the board
/Digital Analog Converter Triangle/QT7: U7.5 (B0); also elsewhere on the board
GNDD: C18.1, C20.2, R9.2, R10.1, U7.1 (VLC); also elsewhere on the board
unnamed: C19.2, U7.16 (CMP)
unnamed: R8.2, U7.14 (R+)
unnamed: R9.1, U7.15 (R-)
unnamed: R10.2, U4.3 (+), U7.2 (I+)
unnamed: R11.1, U4.2 (-), U7.4 (I-)
Triangle: J5.1, R11.2, U4.1; also elsewhere on the board

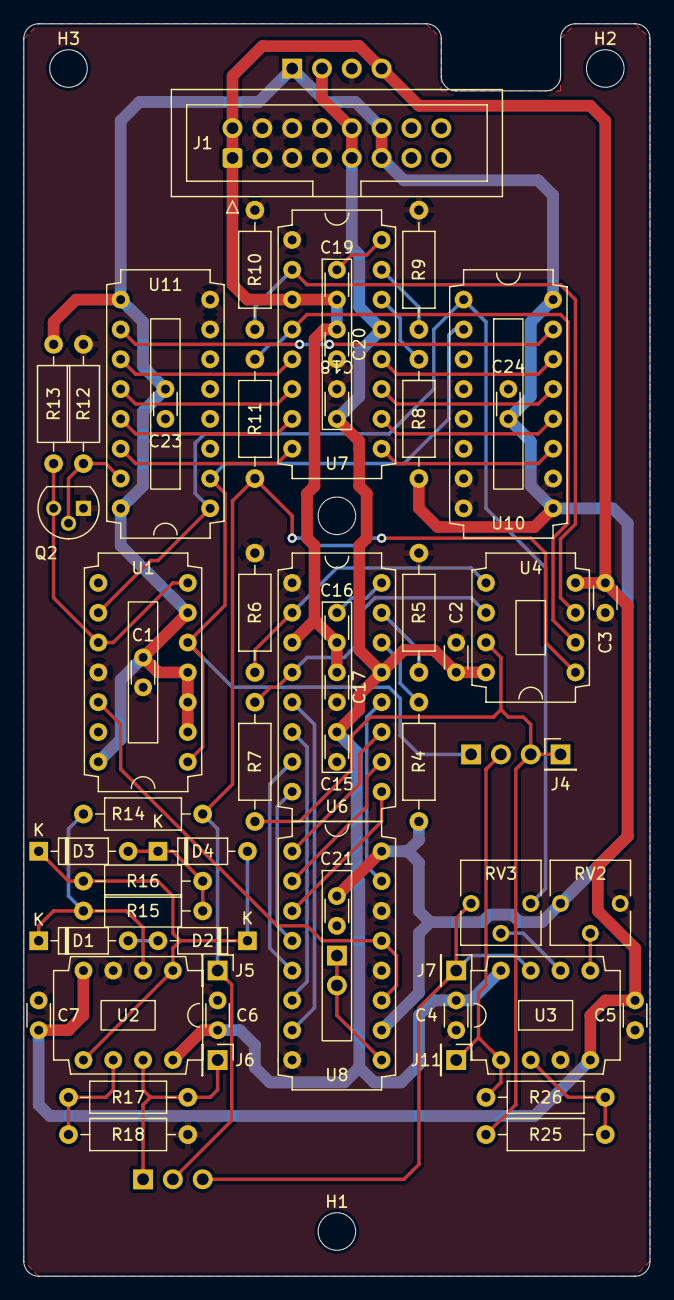
[picture p222: board FG-VCO-(core2).kicad_pcb from above]

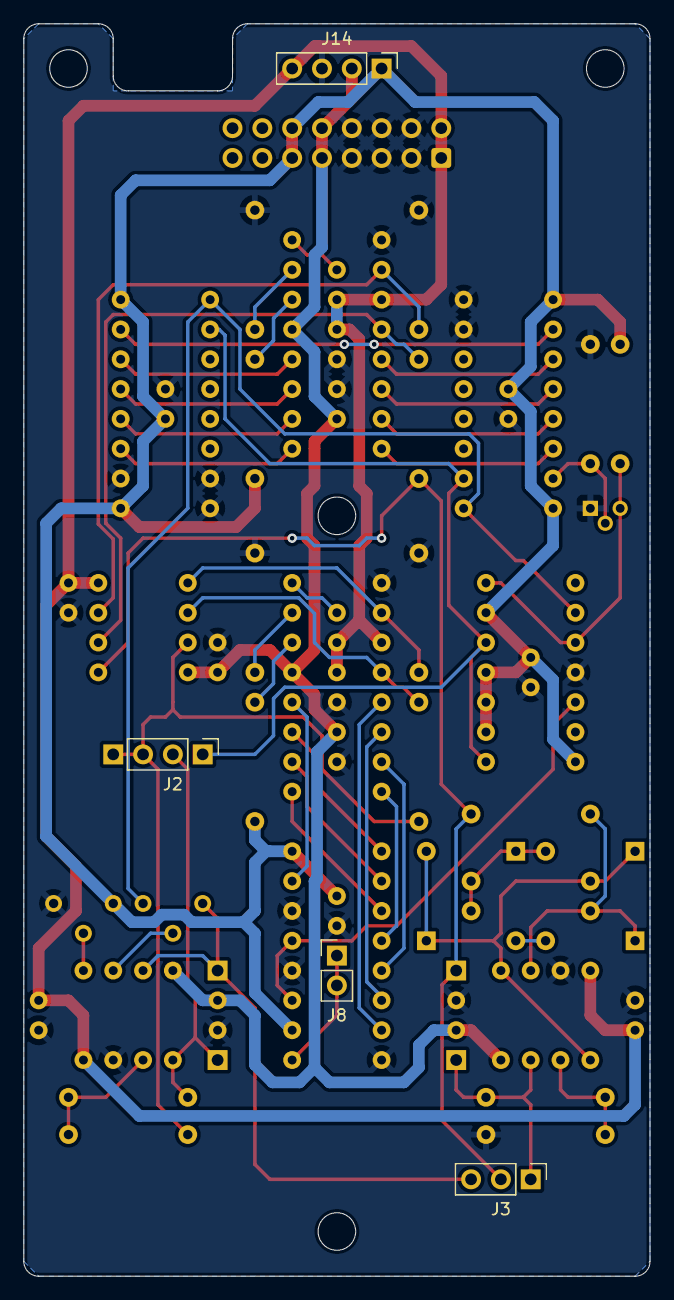
[picture p223: board FG-VCO-(core2).kicad_pcb from below]

Board: 2 copper layers, 53.3 x 106.7 mm, 62 parts (4 on the bottom side), 50 nets.
