PippoGot/FGVCO/(commit log)

2022-08-05 revisione capitoli, aggiornamento immagini e acquisizioni
    [Misure VCO Tesi.xlsx]
2022-08-09 generated gerbers, added plots and table in ch2
    [Misure VCO Tesi.xlsx, misure_vfc.csv]
2022-08-09 same as previous, for the whole folder
    [FG-VCO-(core1)-B_Cu.gbl, FG-VCO-(core1)-B_Mask.gbs, FG-VCO-(core1)-B_Paste.gbp, FG-VCO-(core1)-B_Silkscreen.gbo, FG-VCO-(core1)-Edge_Cuts.gm1, FG-VCO-(core1)-F_Cu.gtl, FG-VCO-(core1)-F_Mask.gts, FG-VCO-(core1)-F_Paste.gtp]
2022-08-12 first revision
    [Misure VCO Tesi.xlsx]
2022-08-12 bibliography fail
    [Misure VCO Tesi.xlsx, misure_Re_high_transistor_gain.csv, misure_Re_low_gain.csv, misure_Re_low_transistor_gain.csv, misure_Re_tot_gain.csv]
2022-08-19 table snippets and started ch4
    [FG-VCO-(panel)-B_Cu.gbl, FG-VCO-(panel)-B_Mask.gbs, FG-VCO-(panel)-B_Paste.gbp, FG-VCO-(panel)-B_Silkscreen.gbo, FG-VCO-(panel)-Edge_Cuts.gm1, FG-VCO-(panel)-F_Cu.gtl, FG-VCO-(panel)-F_Mask.gts, FG-VCO-(panel)-F_Paste.gtp]
2022-08-26 refined to chapter 4
    [FG-VCO-(panel)-B_Cu.gbl, FG-VCO-(panel)-B_Mask.gbs, FG-VCO-(panel)-B_Paste.gbp, FG-VCO-(panel)-B_Silkscreen.gbo, FG-VCO-(panel)-Edge_Cuts.gm1, FG-VCO-(panel)-F_Cu.gtl, FG-VCO-(panel)-F_Mask.gts, FG-VCO-(panel)-F_Paste.gtp]
2022-08-28 finished ch06 and added appendix
    [FG-VCO-(core1).kicad_sch, FG-VCO-(core2).kicad_sch, FG-VCO-(interface).kicad_sch, Misure VCO Tesi.xlsx, d_a_conv_ramp.kicad_sch, d_a_conv_triangle.kicad_sch, ffs.kicad_sch, misure_bode.csv]
2022-09-07 finished ch5 and 6, added figures
    [Misure VCO Tesi.xlsx]
